mfkiwl/SDR_SOC_doc/sdr_svr/dps.tex

\section{Plošný spoj}
	% blokáč AD9850
	\begin{figure}[H]
    	\centering
    	
    	\caption{DPS LNA}    		
  	\end{figure}
  	
  	\begin{figure}[H]
    	\centering
    	
    	\caption{DPS DDS}    		
  	\end{figure}
  	
  	\begin{figure}[H]
    	\centering
    	
    	\caption{DPS řídící deska}    		
  	\end{figure}
  	
  	\begin{figure}[H]
    	\centering
    	
    	\caption{DPS mixer}    		
  	\end{figure}
  	
  	\begin{figure}[H]
    	\centering
    	
    	\caption{DPS zdroj}    		
  	\end{figure}
  	
  	% blokáč AD9850
	\begin{figure}[H]
    	\centering
    	
    	\caption{Osazovák vrstva mědi}    		
  	\end{figure}
  	
  	% blokáč AD9850
	\begin{figure}[H]
    	\centering
    	
    	\caption{Osazovák horní vrstva}    		
  	\end{figure}
