mfkiwl/SDR_SOC_doc/soc_sdr/prohlaseni.tex

\setcounter{page}{3}

\clearpage
\thispagestyle{empty}

Prohlašuji, že jsem praktickou zkoušku vypracoval samostatně a všechny prameny jsem uvedl v seznamu použité literatury.
\newline\newline
\begin{flushright}
	\begin{minipage}[H]{6cm}
		\begin{center}
			\dotfill\newline
			jméno a příjmení studenta
		\end{center}		
	\end{minipage}
\end{flushright}	

\vspace*{5cm}

Chtěl bych vyslovit poděkování panu Ing. Pavlu Lorenzovi, Ing. Jiřímu Burdovi a Ing. Petru Ďurišovi, za odborné konzultace a poskytnuté informace. Dále bych chtěl poděkovat Ing. Petru Ďurišovi za pomoc s výrobou desek plošných spojů. V neposlední řadě patří velký dík mému tátovi, který mi pomohl s ukotvením antény a výrobou krabičky.
\newline\newline
\begin{flushright}
	\begin{minipage}[H]{6cm}
		\begin{center}
			\dotfill\newline
			jméno a příjmení studenta
		\end{center}		
	\end{minipage}
\end{flushright}

\vspace*{5cm}
	
Prohlašuji, že nemám námitek proti půjčování nebo zveřejňování mé práce nebo její části se souhlasem školy.
\newline\newline
\begin{flushright}
	\begin{minipage}[H]{6cm}
		\begin{center}
			\dotfill\newline
			jméno a příjmení studenta
		\end{center}		
	\end{minipage}
\end{flushright}	

\clearpage
