mfkiwl/SDR_SOC_doc/soc_sdr/title_.tex

\begin{titlepage}
	\setcounter{page}{1}
	\begin{center}

	{\LARGE \bfseries Vyšší odborná škola a Střední průmyslová škola}\\[2mm] 

	{\LARGE \bfseries elektrotechnická Olomouc}\\[2mm]  

	{\LARGE \bfseries Božetěchova 3}\\[65mm]

	% Title 
	\fontsize{20pt}{30pt}{\bfseries PRAKTICKÁ ZKOUŠKA Z ODBORNÝCH PŘEDMĚTŮ\\}
	
	\fontsize{20pt}{30pt}{\bfseries SDR přijímač pro pásmo KV\\}

	\vfill

	% Bottom of the page
	{\LARGE \bfseries 2015 \hfill Jan Vykydal}

	\end{center}
\end{titlepage}
