mfkiwl/SDR_SOC_doc/sdr_svr/seznam.tex

\section{Seznam součástek}

	\begin{table}[H]
		\begin{center}
			\begin{tabular}[H]{!{\vrule width 1pt}c|c|c|c!{\vrule width 1pt}}
			    \specialrule{1pt}{0pt}{0pt} 
			    \textbf{Určovatel}	&	\textbf{Pouzdro}	&	\textbf{Množství}	&	\textbf{Určení}	\\\specialrule{1pt}{0pt}{0pt} 
				C1,C5,C6,C7,C10,C11,C12,C13,C14	&	SMD-0805	&	9	&	100n	\\\hline
				C2,C3,C4	&	11.2x6.3mm\_RM2.5	&	3	&	10u/50v	\\\hline
				C8,C9	&	SMD-0805	&	2	&	150p	\\\hline
				IC1	&	SO-20-L	&	1	&	74F245	\\\hline
				IC2	&	SOT-23-5	&	1	&	74VHC1G132DTT1G	\\\hline
				L1	&	R3-LARGE\_PADS	&	1	&	1u	\\\hline
				Q1	&	OldSowjetaera	&	1	&	KF630D	\\\hline
				R1,R2,R3,R4	&	R\_1206	&	4	&	10k	\\\hline
				R5	&	R\_1206	&	1	&	3k9	\\\hline
				R6,R7,R13	&	R\_1206	&	3	&	50R (2*100R)	\\\hline
				R8	&	R\_1206	&	1	&	560R	\\\hline
				R9	&	R\_1206	&	1	&	1k	\\\hline
				R10	&	R\_1206	&	1	&	4R7	\\\hline
				R11	&	R\_1206	&	1	&	12R	\\\hline
				R12	&	R\_1206	&	1	&	3k3	\\\hline
				TR1	&	Amidon-T44	&	1	&	TRF11	\\\hline
				U1	&	SOT-223	&	1	&	LD1117S33CTR	\\\hline
				P3	&	sma\_90\_r300.124.403	&	1	&	DDS\_OUT	\\\hline
				P1	&	vasch\_strip\_5x2\_90	&	1	&	MLW10	\\\hline
				P2	&	vasch\_strip\_3x2\_90	&	1	&	MLW6	\\\hline
				$-$	&	M3	&	4	&	M3	\\\hline
				IC3	&	SSOP-28 &	1	&	AD9850BRS	\\\hline
				XTAL1	&	SMD7x5	&	1	&	CFPS
				\\\specialrule{1pt}{0pt}{0pt} 

			\end{tabular}

			\caption{Tabulka použitých součástek pro desku DDS, ostatní zde nebyli uvedeny z důvodu nedostatku papíru}
			\label{tab:s1}      
		\end{center}
	\end{table}
