mfkiwl/SDR_SOC_doc/svr_sdr/navod.tex

\clearpage

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

% os b
\begin{figure}[H]
	\centering
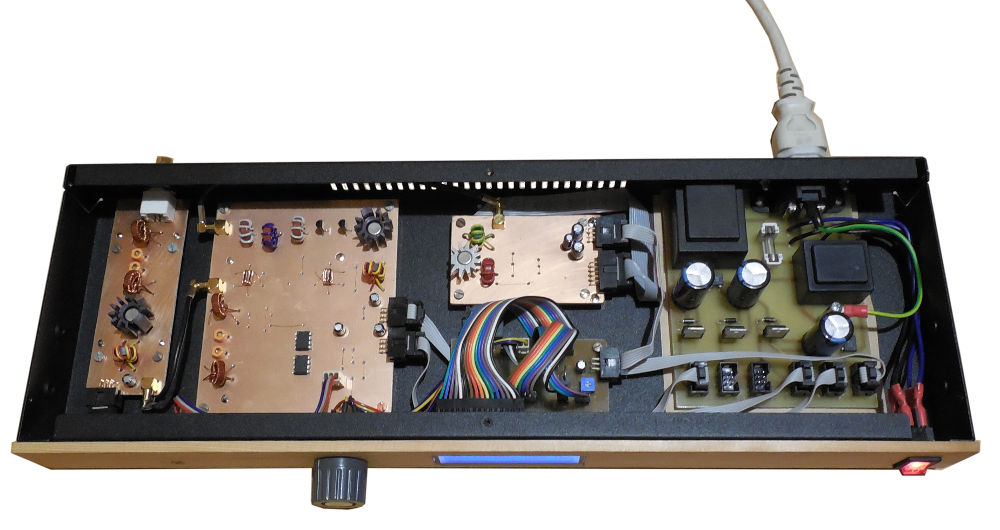
[picture p4: svr_sdr/img/bez_kritu_sm.png]
	
	\caption{Hotové zařízení bez horní části krabice}    		
\end{figure}

% os b
\begin{figure}[H]
	\centering
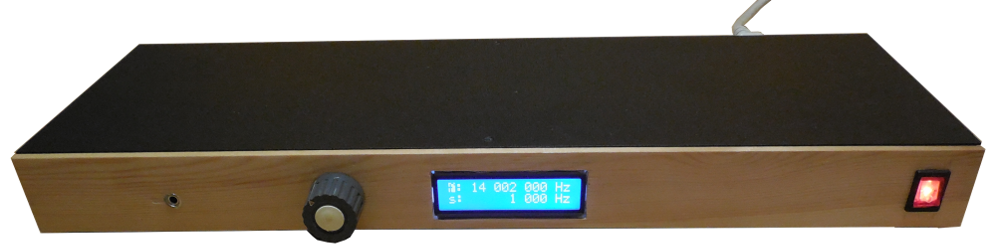
[picture p5: svr_sdr/img/s_kritem_sm.png]
	
	\caption{Hotové zařízení v kompletní krabici rackových rozměrů}    		
\end{figure}

\clearpage
