mfkiwl/SDR_SOC_doc/pres_SDR/bs_sdr_prez.png

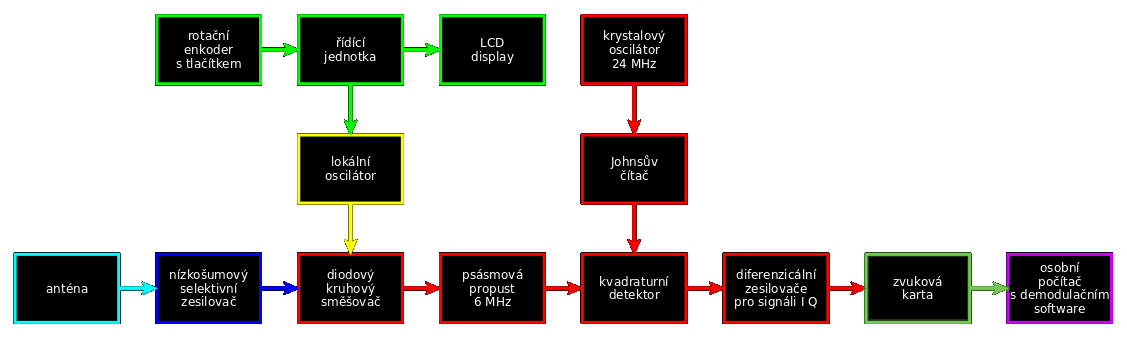
pres_SDR/bs_sdr_prez.png
