mfkiwl/SDR_SOC_doc/pres_SDR/DSCN0772.JPG

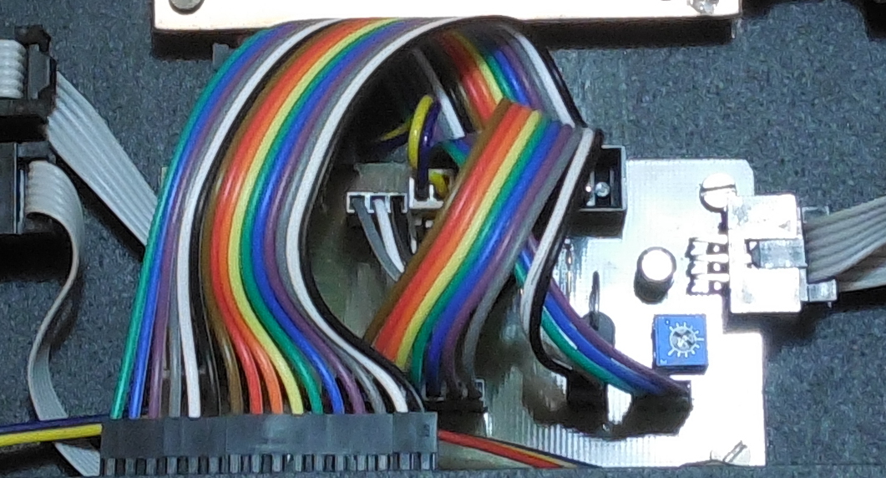
pres_SDR/DSCN0772.JPG
