mfkiwl/SDR_SOC_doc/pres_SDR/sdr_prijem_1.png

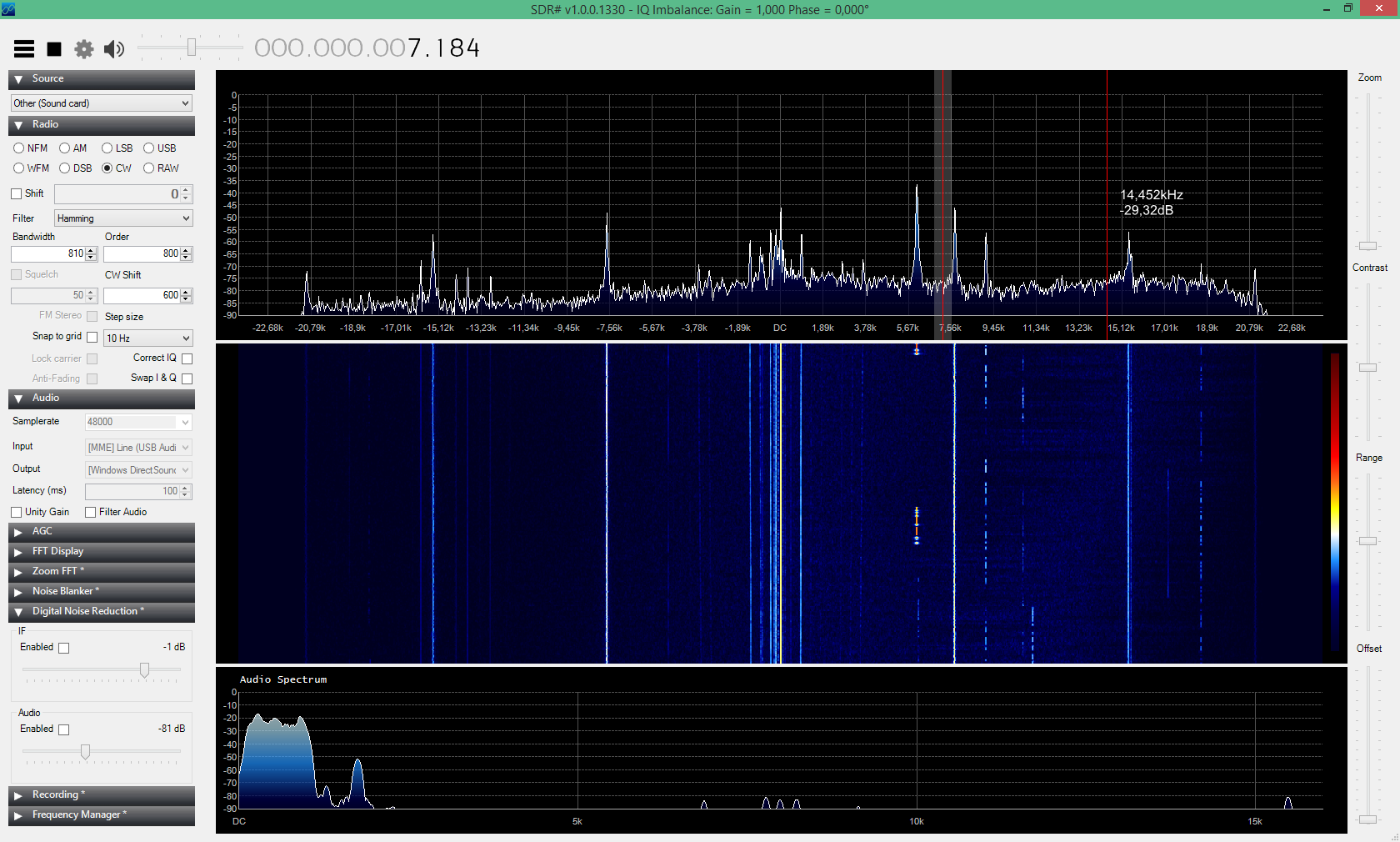
pres_SDR/sdr_prijem_1.png
