mfkiwl/SDR_SOC_doc/sdr/control_board/out/control_board-brd.png

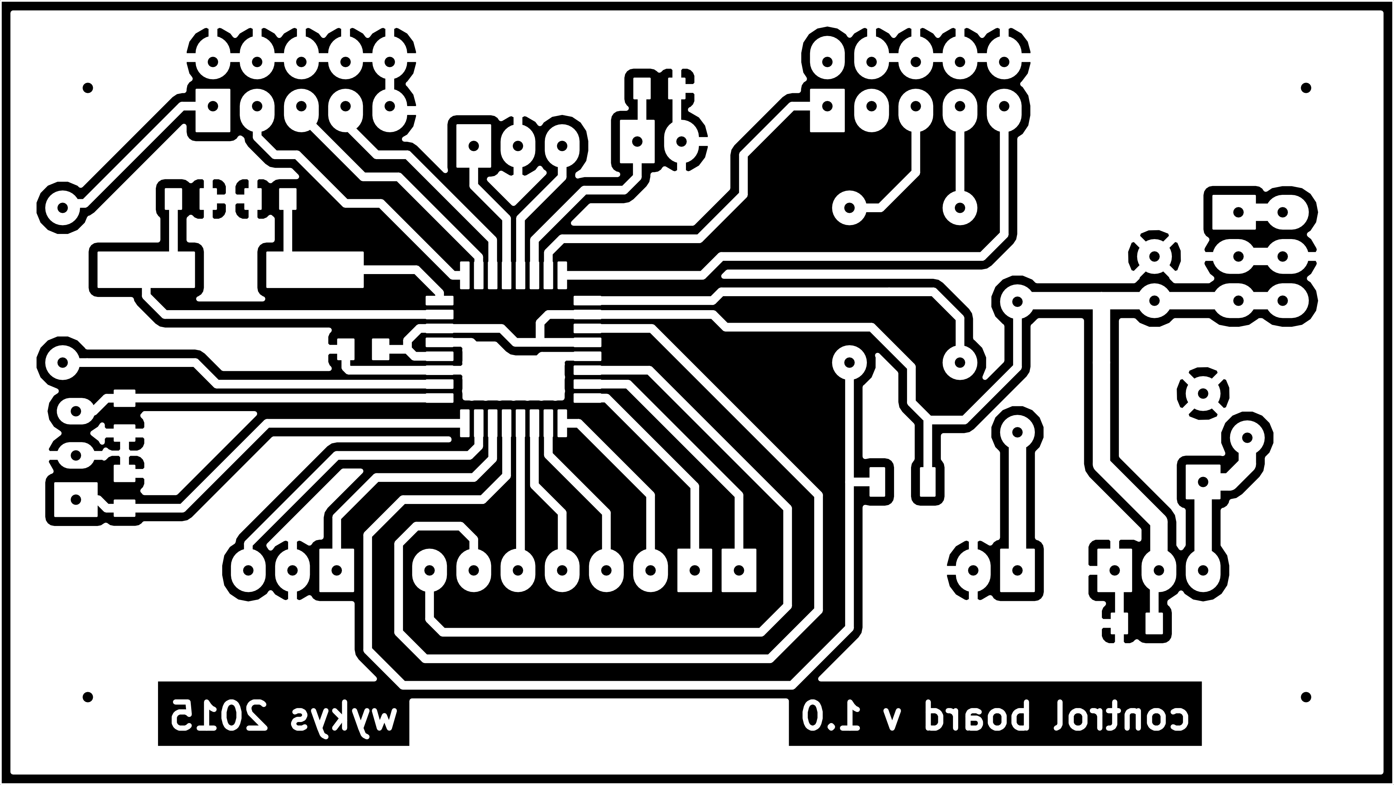
sdr/control_board/out/control_board-brd.png
