mfkiwl/SDR_SOC_doc/sdr/dds/design_v2/out/DDS-brd.png

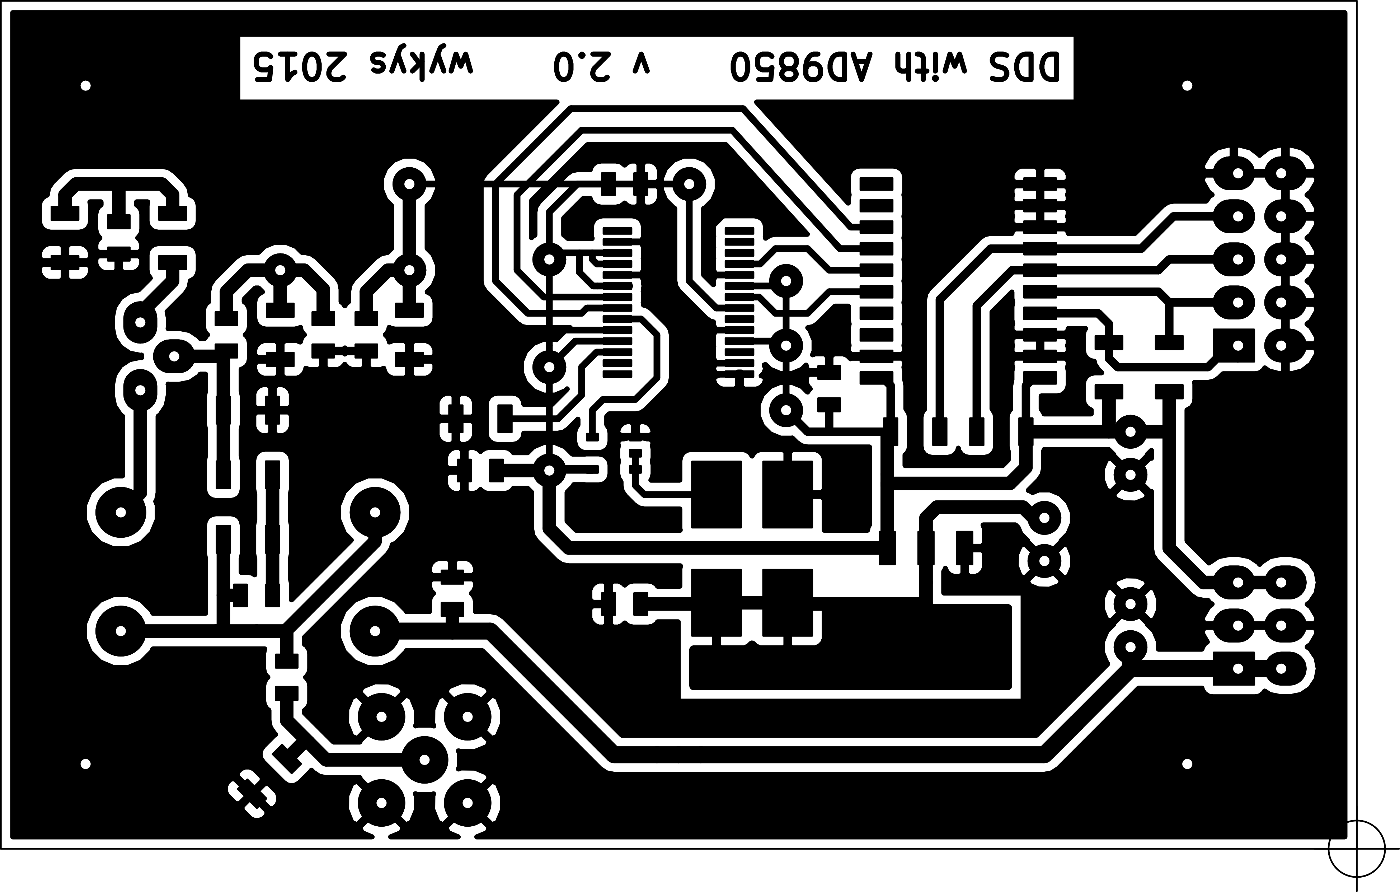
sdr/dds/design_v2/out/DDS-brd.png
