mfkiwl/SDR_SOC_doc/sdr/dds/sim/CLC.png

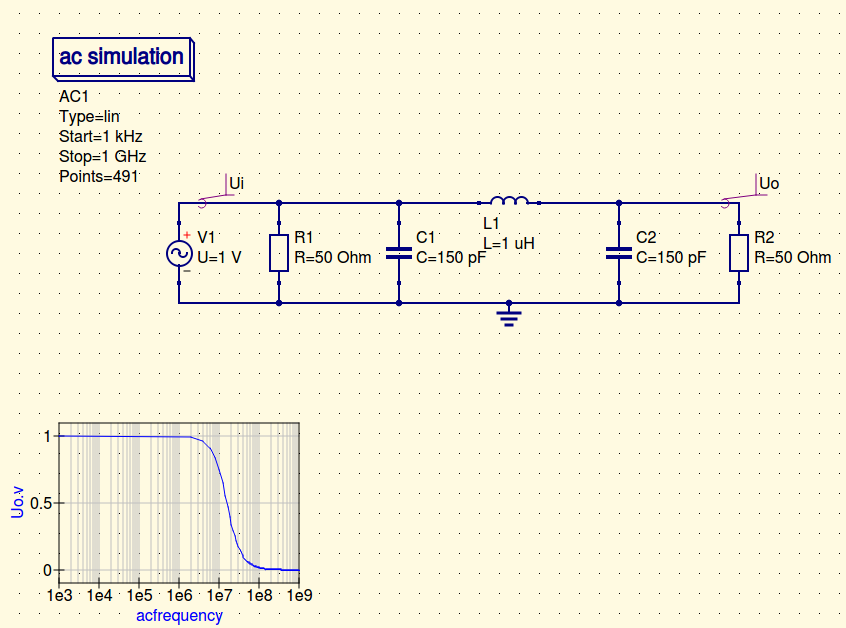
sdr/dds/sim/CLC.png
