mfkiwl/SDR_SOC_doc/sdr/LNA/design_v1/out/LNA-brd.png

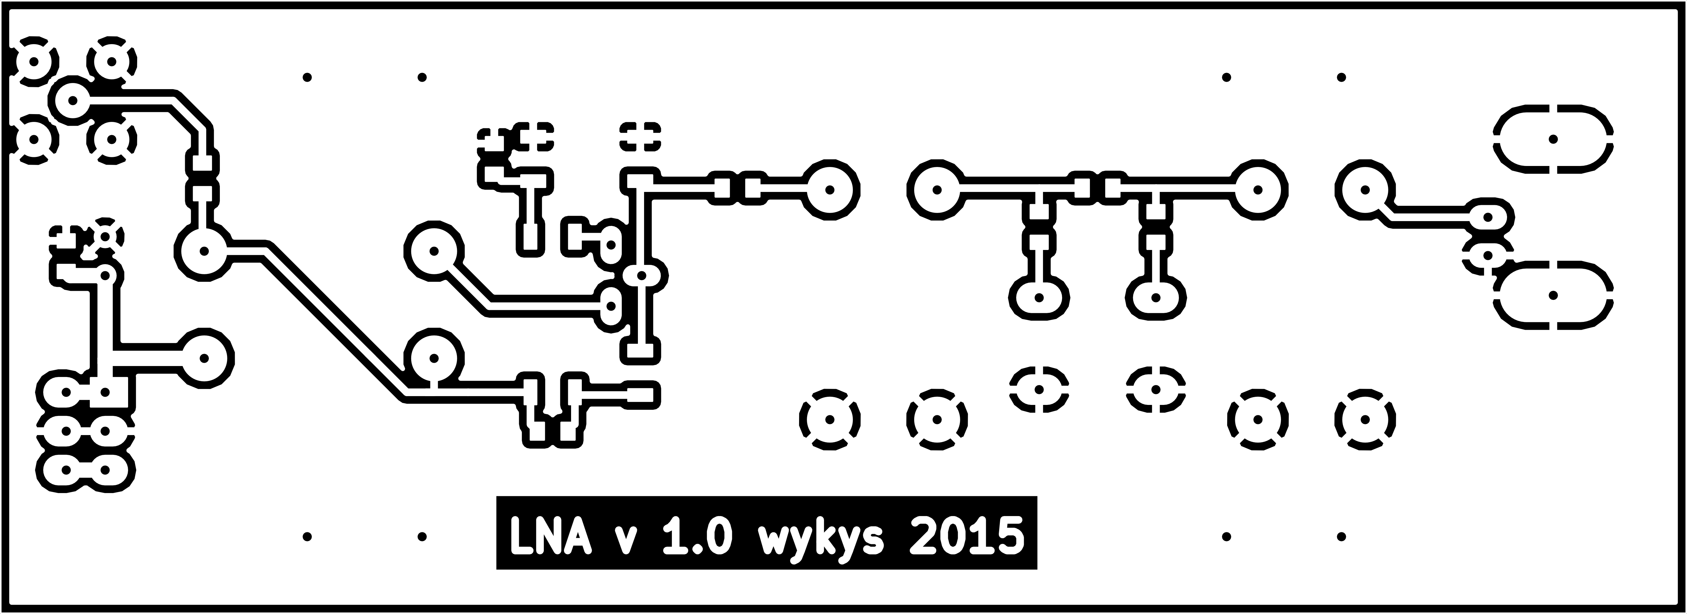
sdr/LNA/design_v1/out/LNA-brd.png
