mfkiwl/SDR_SOC_doc/sdr/MIXER/out/mixer-brd.png

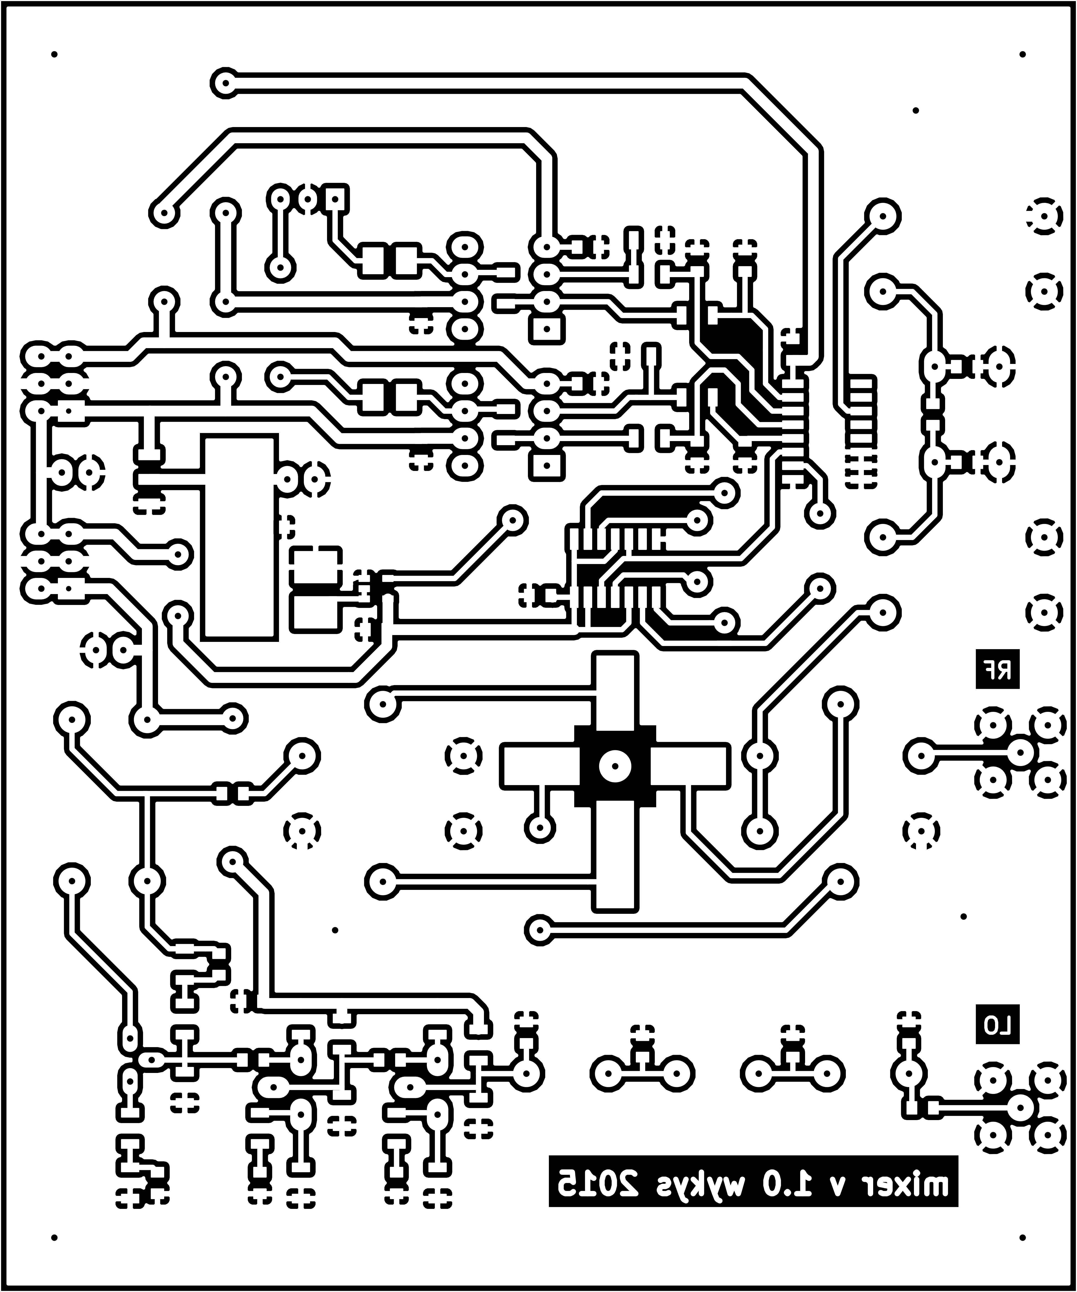
sdr/MIXER/out/mixer-brd.png
