mfkiwl/SDR_SOC_doc/sdr/zdroj/zdroj_v1/out/zdroj-brd.png

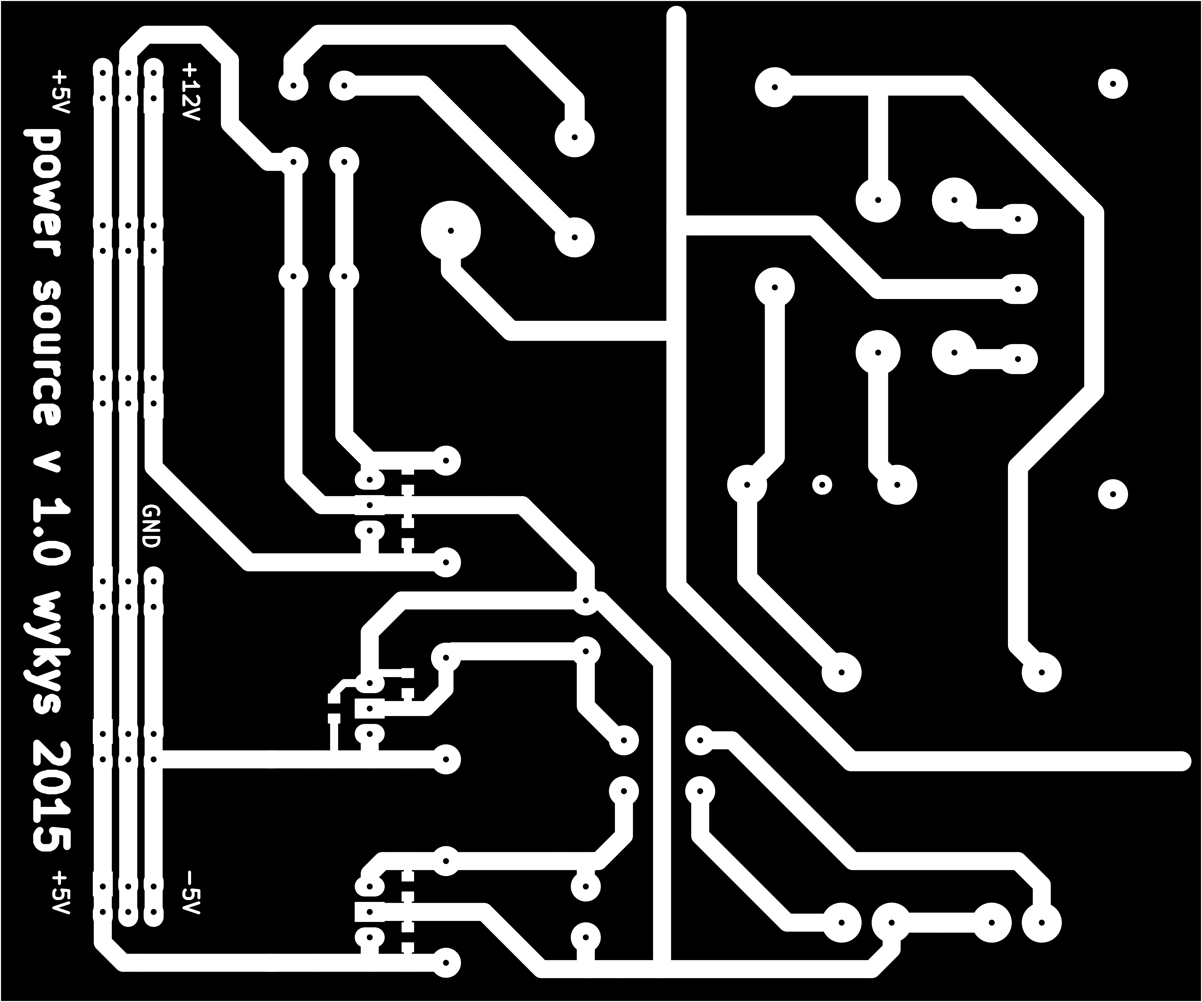
sdr/zdroj/zdroj_v1/out/zdroj-brd.png
