mfkiwl/SDR_SOC_doc/soc_sdr/img/LNA/sel.png

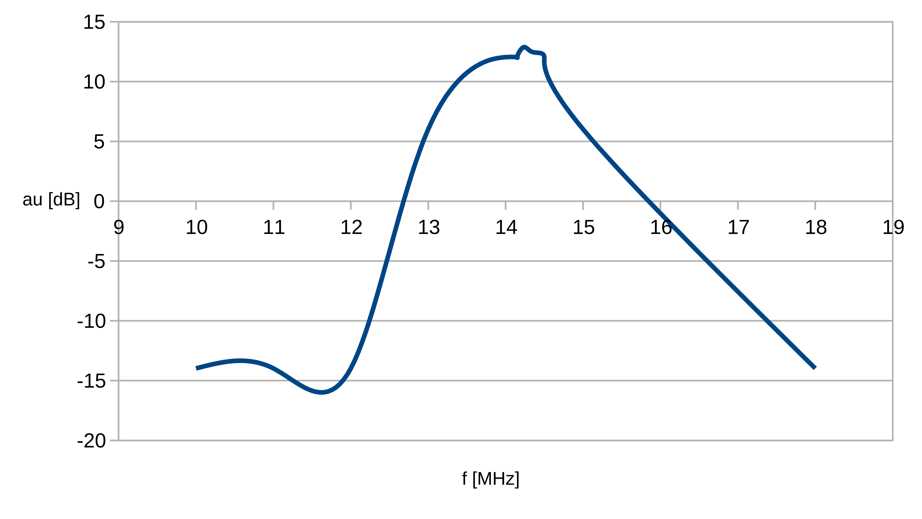
soc_sdr/img/LNA/sel.png
