mfkiwl/SDR_SOC_doc/svr_sdr/img/bs_sdr_prez.png

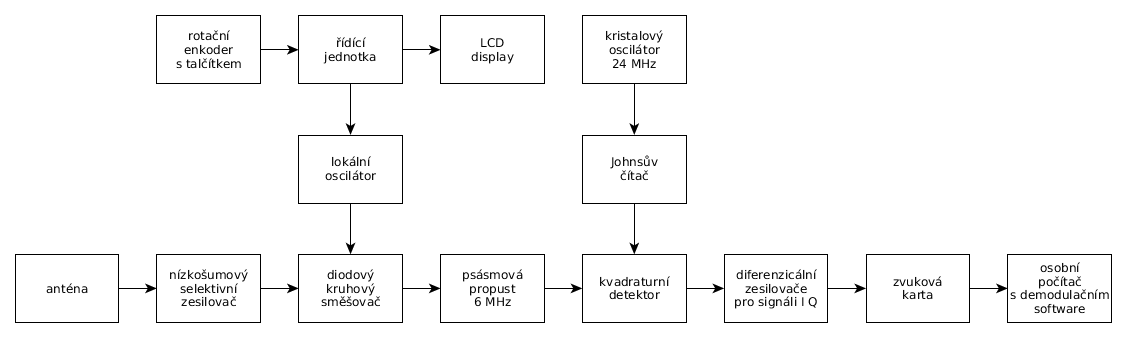
svr_sdr/img/bs_sdr_prez.png
