mfkiwl/SDR_SOC_doc/sdr_svr/SDR.pdf

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

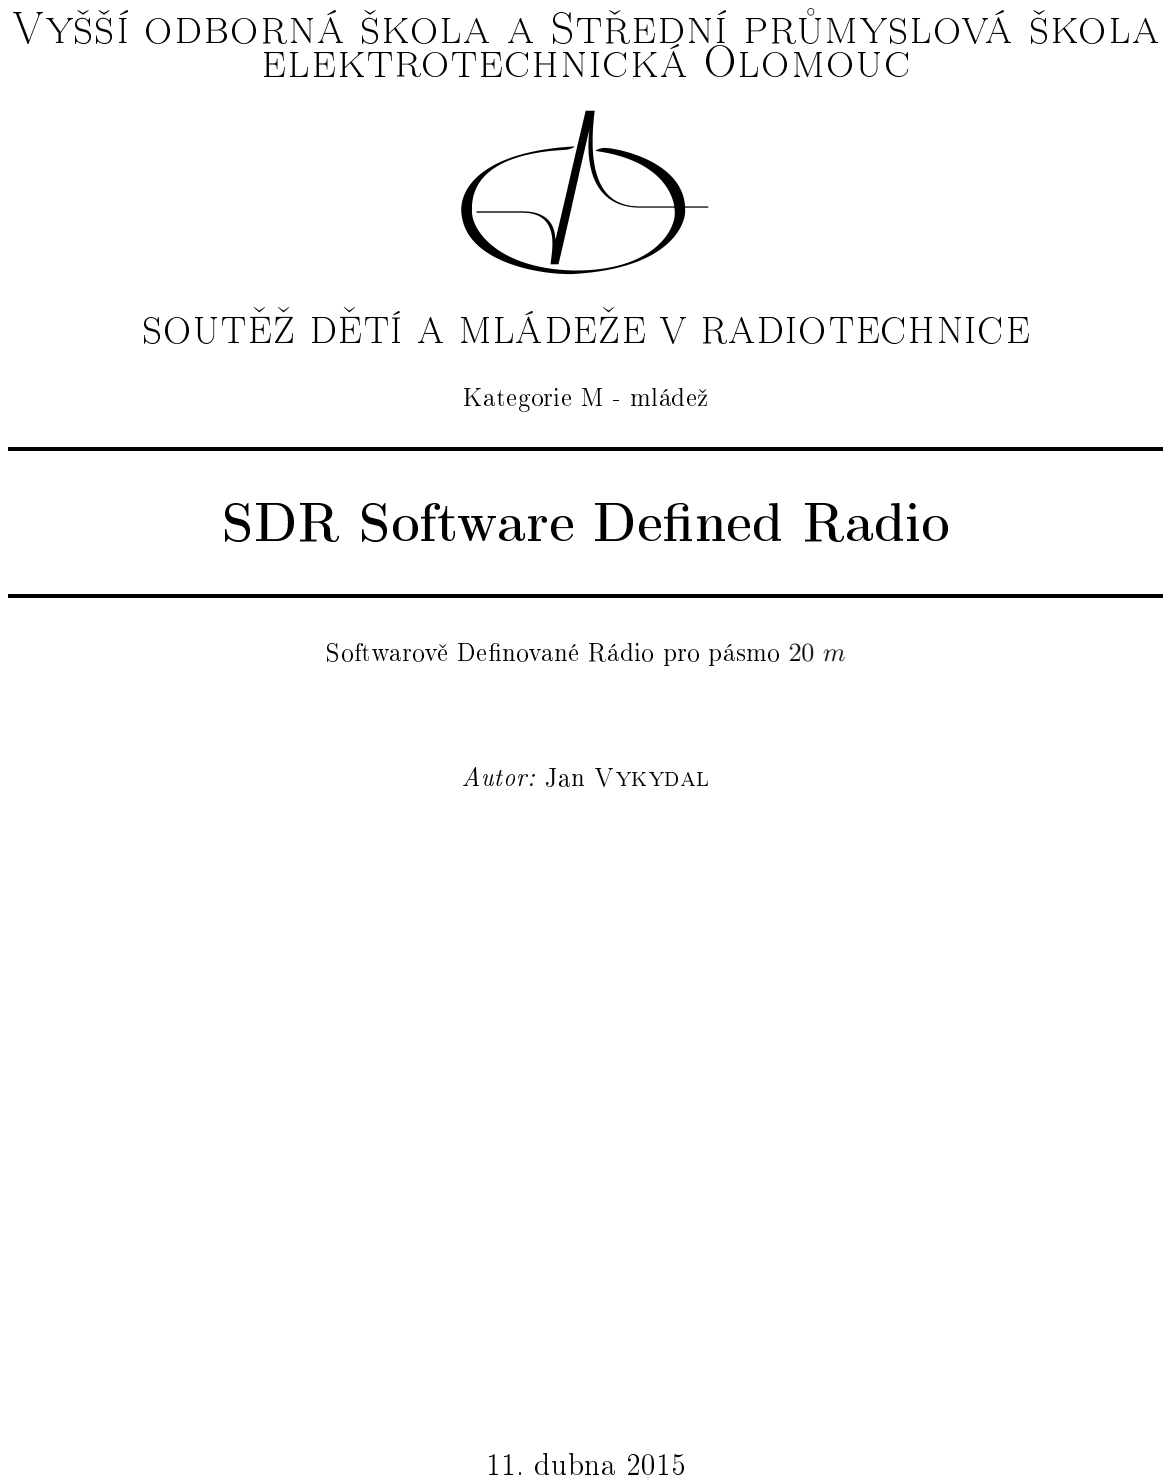
[picture p17: page 1]

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

100n | C10 | GND

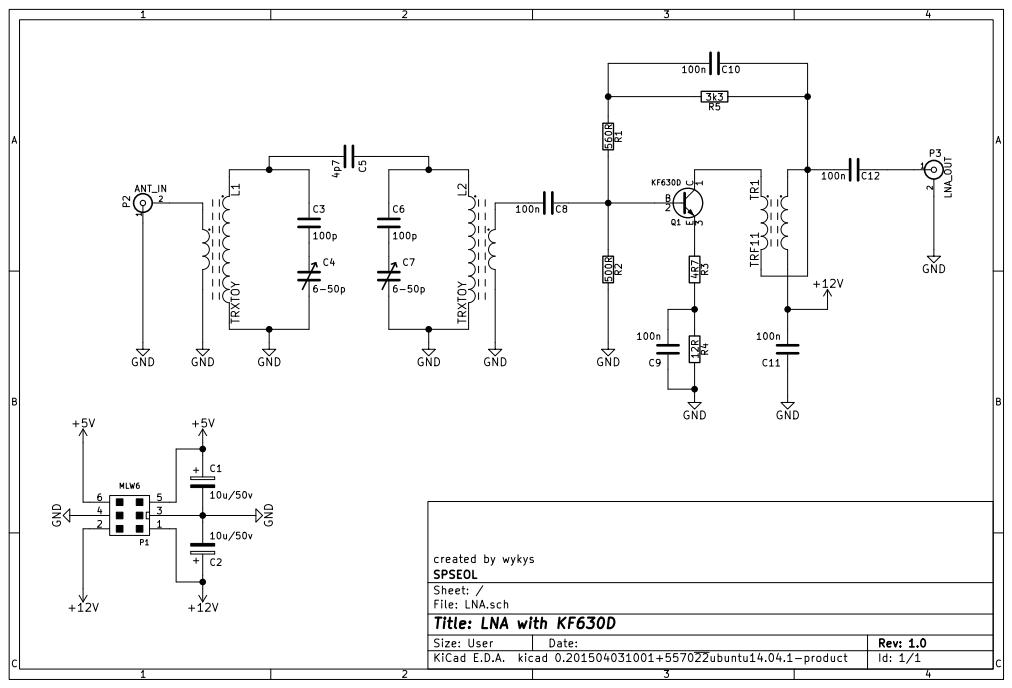
[picture p18: page 4]

created by wykys
File: LNA.sch Sheet: / SPSEOL

Id: 1/1 Title: LNA with KF630D

SDR Software Dened Radio | Jan Vykydal 4A
3 | Schéma zapojení DDS

Schéma je rozd¥leno do t°í blok· v levé horní £ásti se nachází stabilizátor 3V3 pro k°emíkový oscilátor a Kondenzátory pro vyrovnání nárazových odb¥r·. V levé dolní £ásti je digitální £ást DDS, popisováno z leva do prava: konektor pro kongurování DDSky, odd¥lovací buer 74F245, jehoº výstupy jdou do DDSky. Naho°e je jiº zmín¥ný k°emíkový oscilátor a tvarova£ impuls·. V pravé horní £ásti se nachází VF £ást tvo°ená dolní propustí ur£ené k potla£ení vy²²ích harmonických z DAC. a Výkonový zesilova£ tvo°ený tranzistorem KF630D s Ic nastaveným na 20 mA. Ke kolektoru tranzistoru je p°ipojeno trafo, které je vinuto bilárn¥ a slouºí k transformaci impedance na cca 50 Ω.

4/18

# 10u/50v C3

# 10u/50v +5V

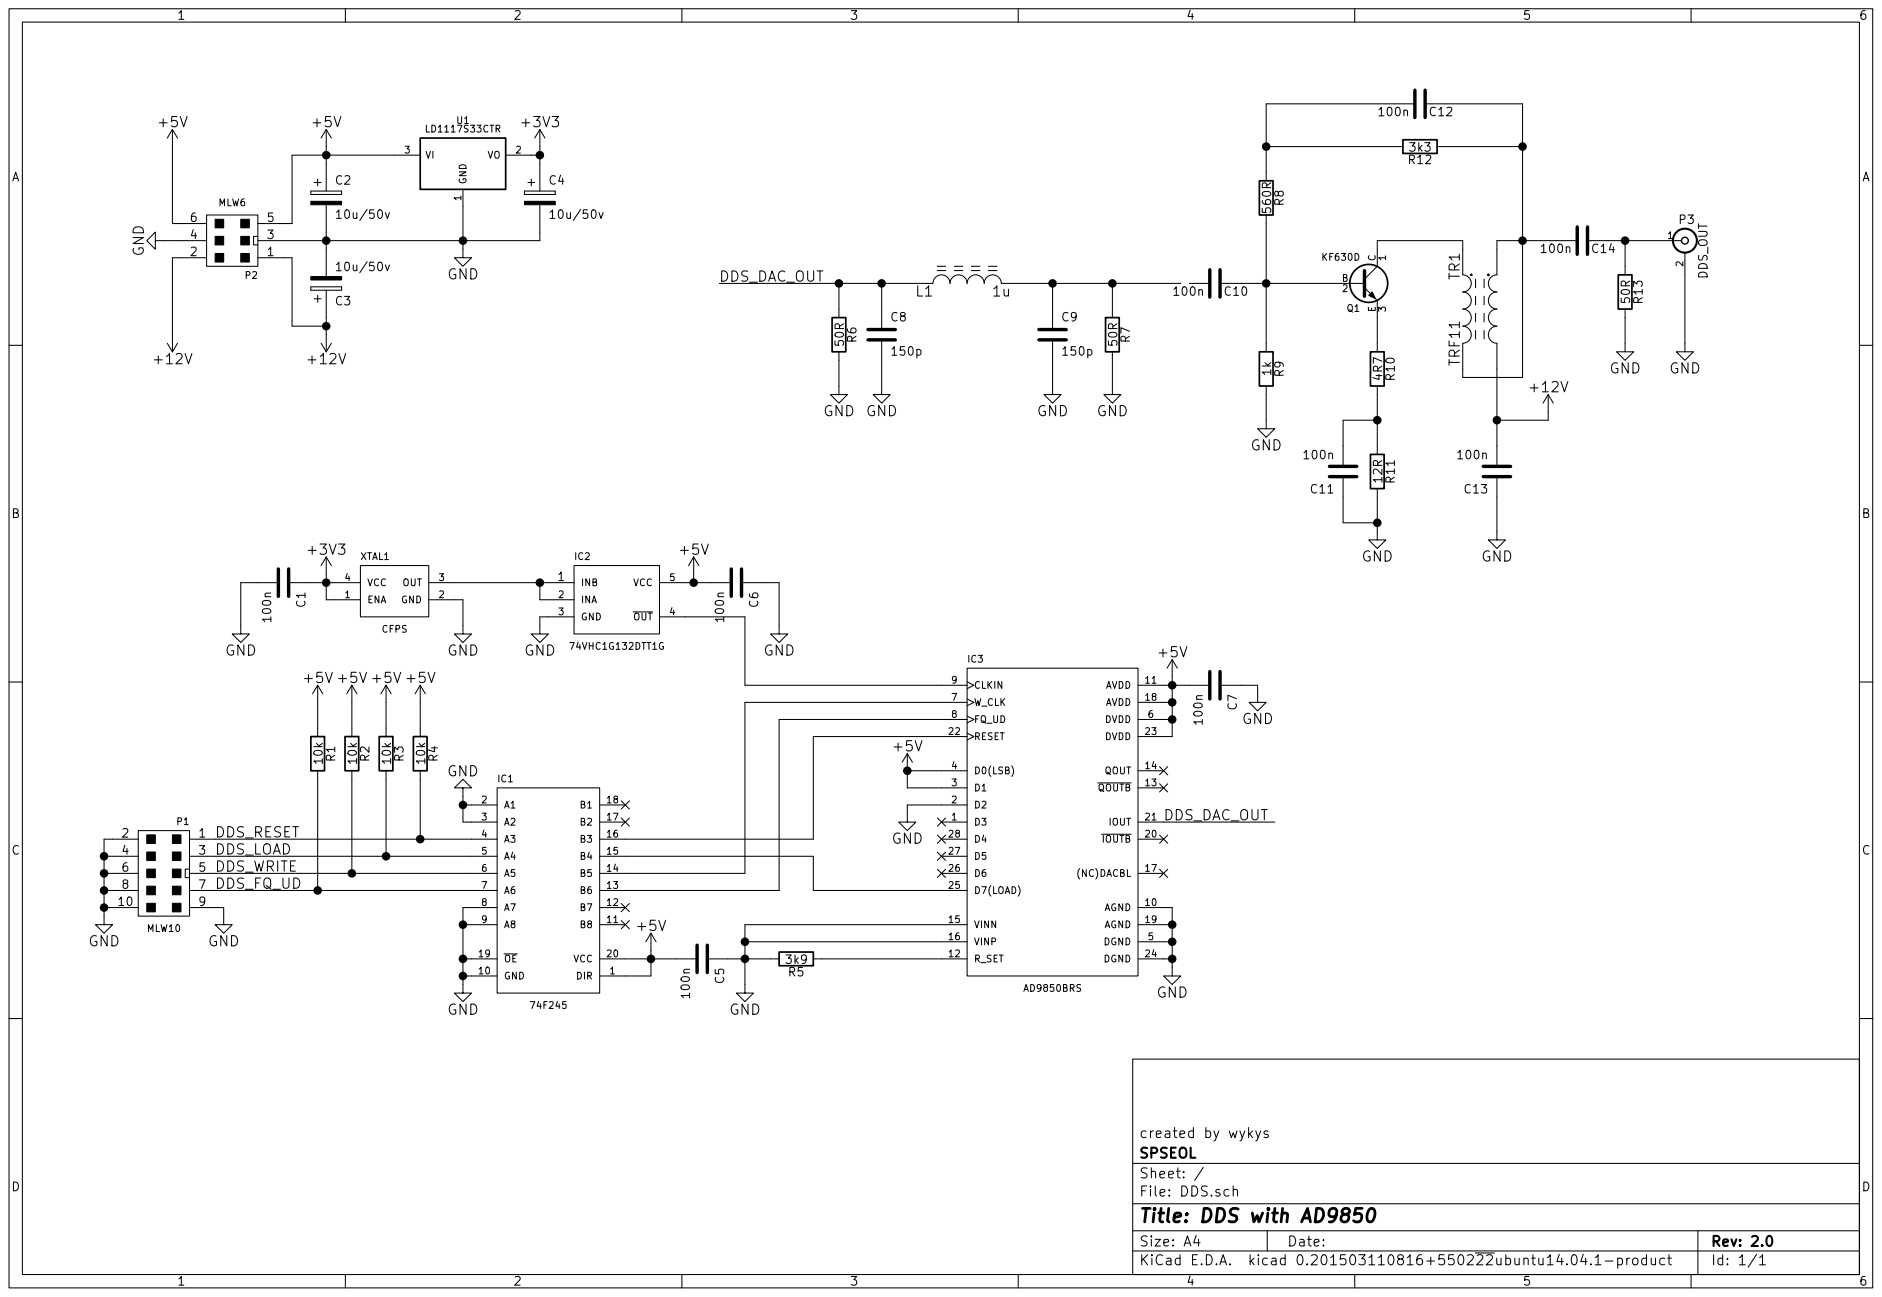
[picture p19: page 6]

+5V ¹⁰k R¹ 10k R² 10k R³ 10k R⁴ +5V +5V +5V +5V

created by wykys
File: DDS.sch Sheet: / SPSEOL

Id: 1/1 Title: DDS with AD9850

SDR Software Dened Radio | Jan Vykydal 4A
4 | Schéma zapojení °ídící deska

ídící deska slouºí k °ízení výstupní frekvence lokálního oscilátoru zaloºeného na DDS. A nastavování po°adované výstuúní frekvence slouºí enkoder. Dále je na desce p°ipraven konektor pro USART, aby bylo moºné °ídit i °ídíví desku s nad°azeného po£íta£e. Dále desky zobraduje p°íjmanou stanici na znakový LCD disply. Zobrazovaná frekvence je absolutní hodnota zordílu frekvence lokálního oscilátoru a mezifrekvence.

6/18

# 10k +5V C6

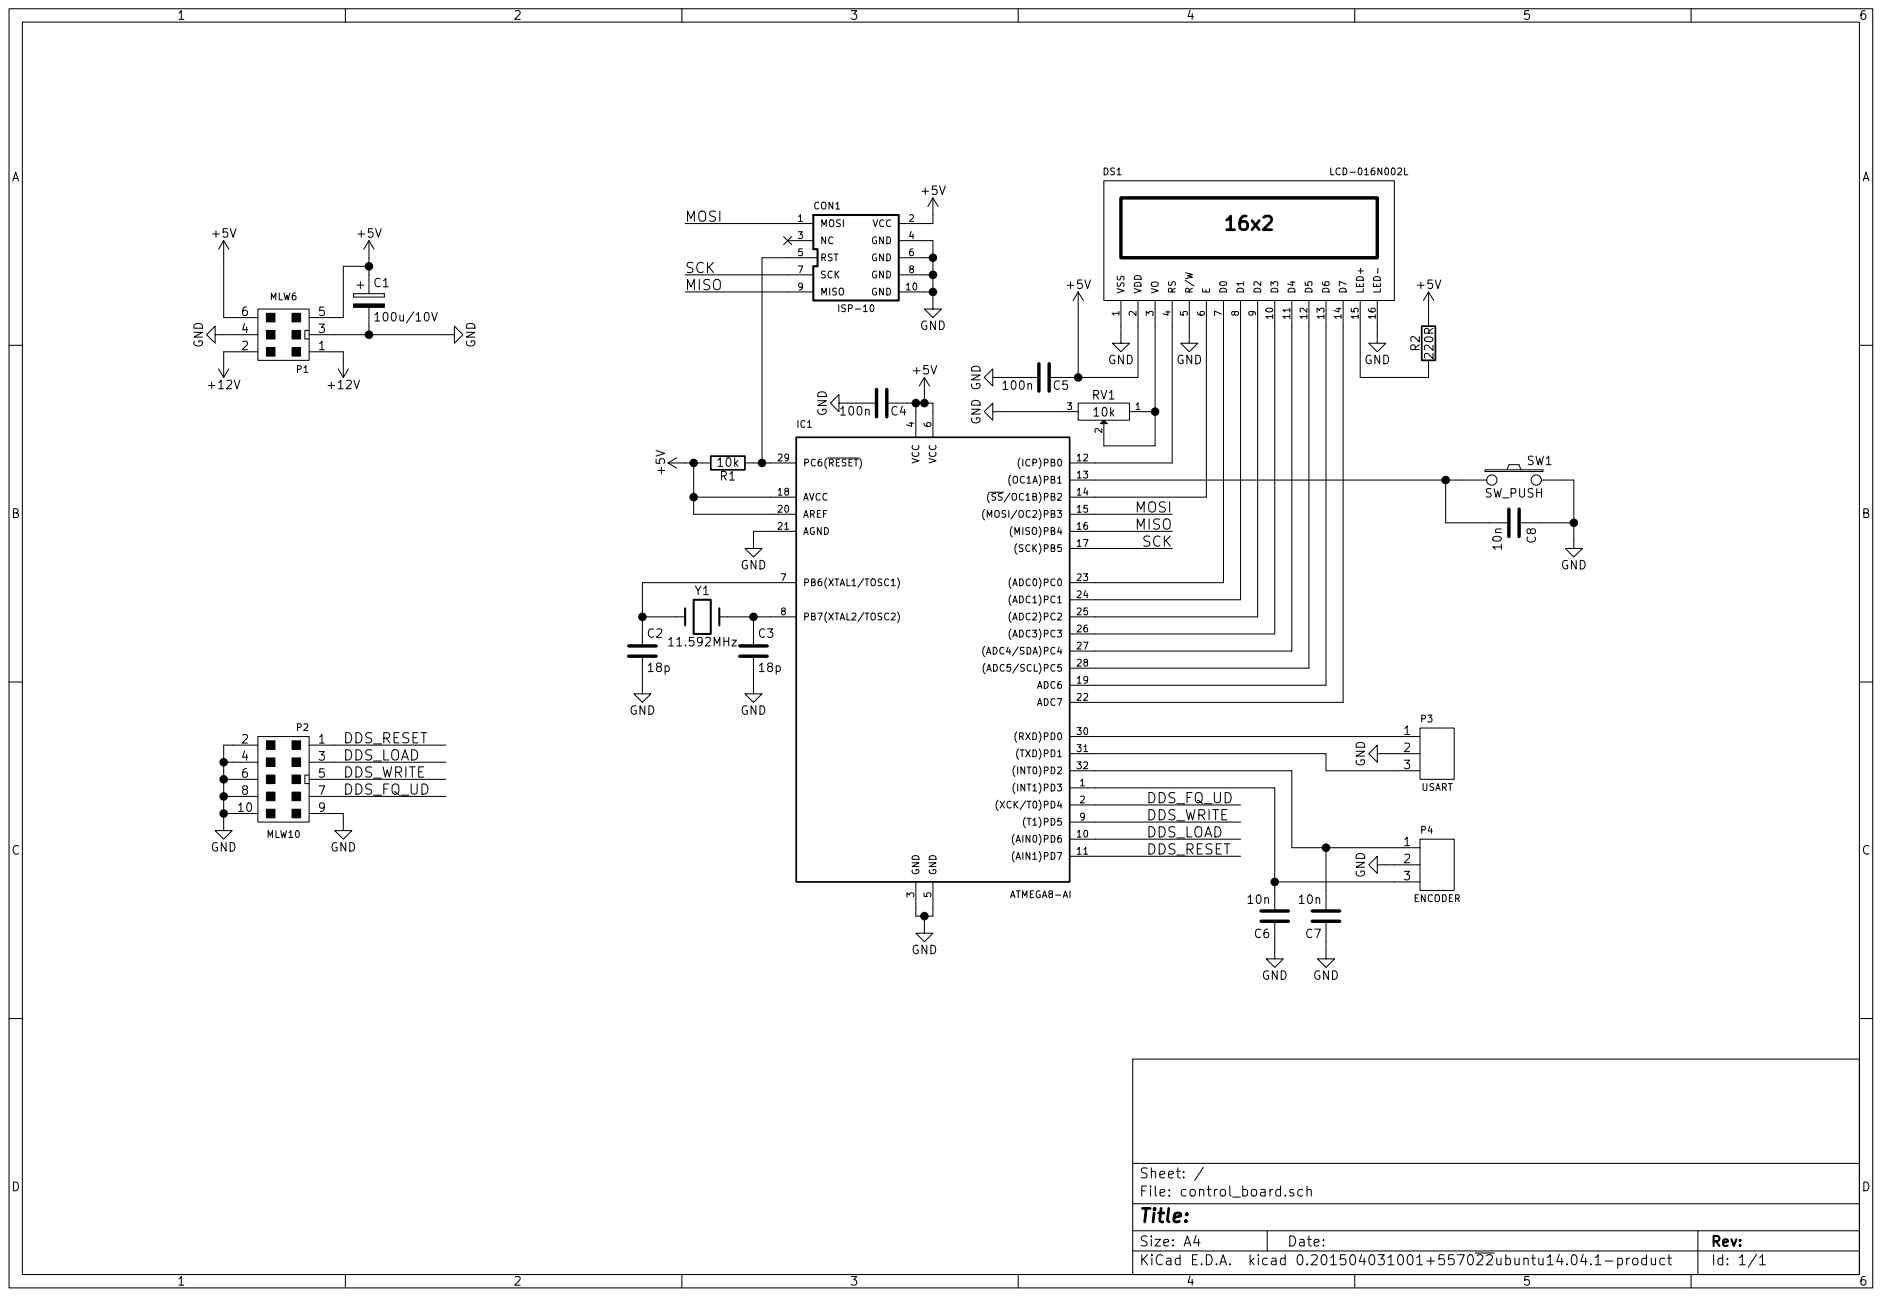
[picture p20: page 8]

SDR Software Dened Radio | Jan Vykydal 4A
5 | Schéma zapojení mixer

Tento obvod slouºí k p°evedení signálu do základního pásma. K tomu pouºívá dvou sm¥²ovac·. Klasic-kého kruhového diodového sm¥£ova°e pro p°evod na mezifrekvenci 6 MHz a tzv. Tayloe kvadraturní detektor, který generuje signály I a Q navzájem posunuté o π
2

8/18

100n C¹⁵ 100n +12V | +12V GND | GND | GND
3k3 4R⁷ R¹³ 12R R¹⁴ | C24

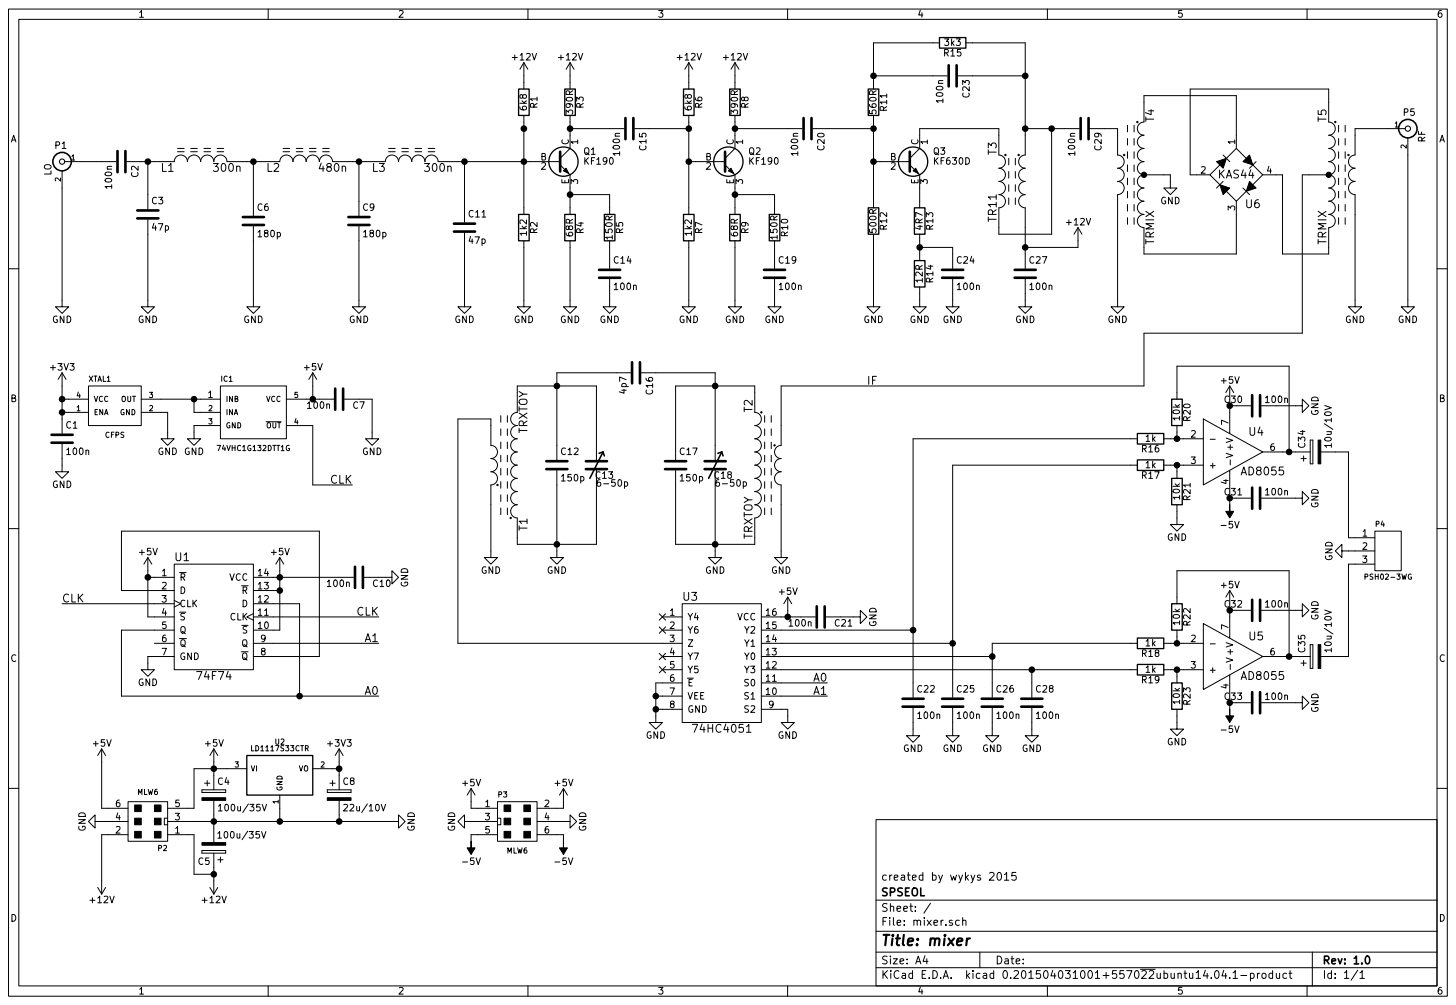
[picture p21: page 10]

created by wykys 2015
Id: 1/1 Title: mixer File: mixer.sch Sheet: / SPSEOL

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

# T1 TRANSFO2 1

# 100n +5V -5V +12V

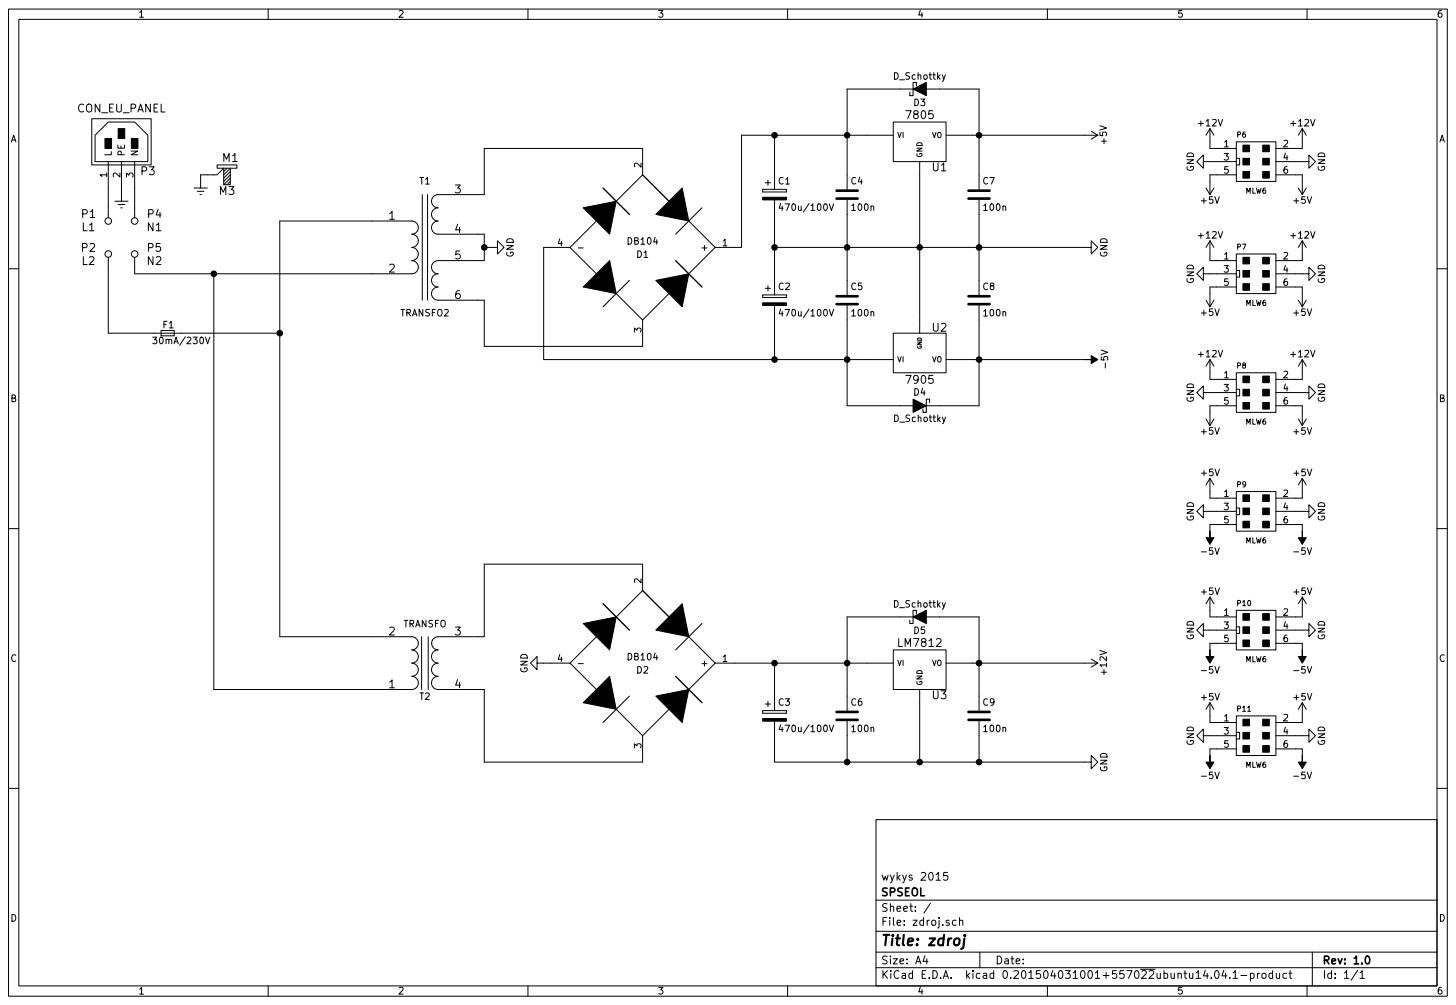
[picture p22: page 12]

File: zdroj.sch Sheet: / SPSEOL wykys 2015

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

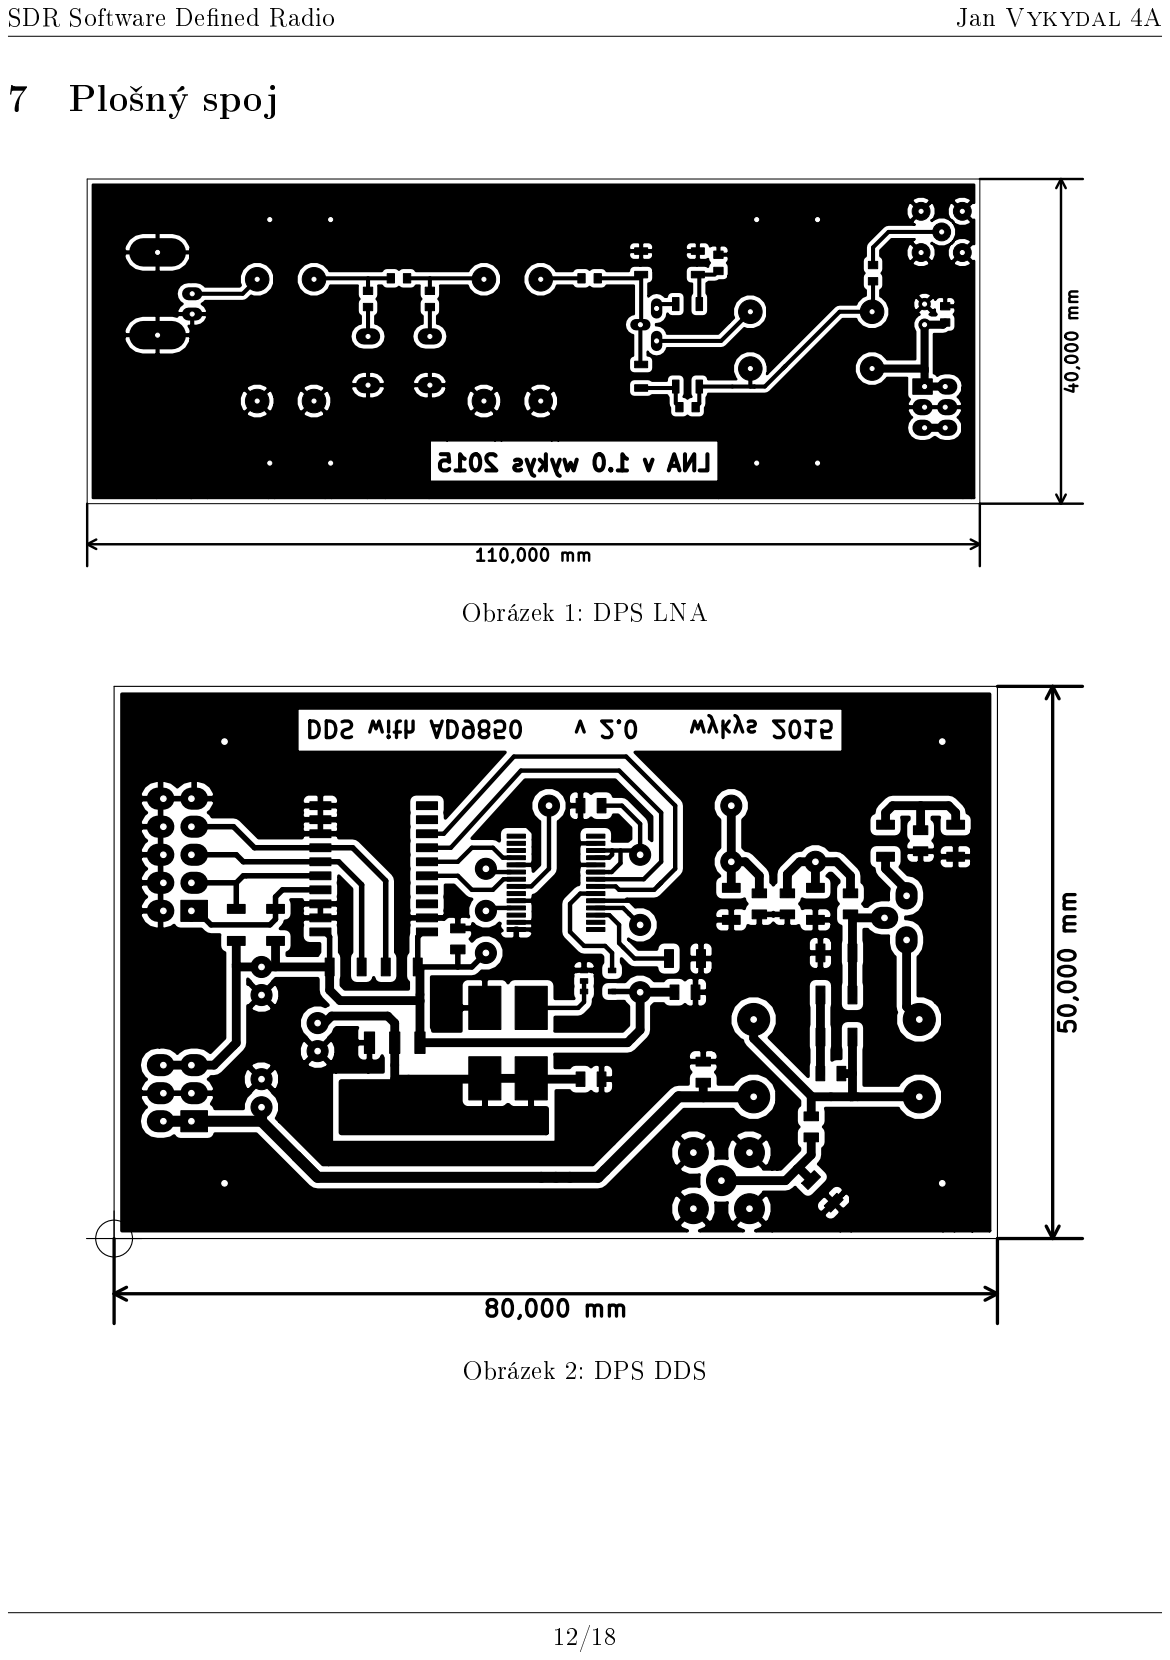
[picture p23: page 13]

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

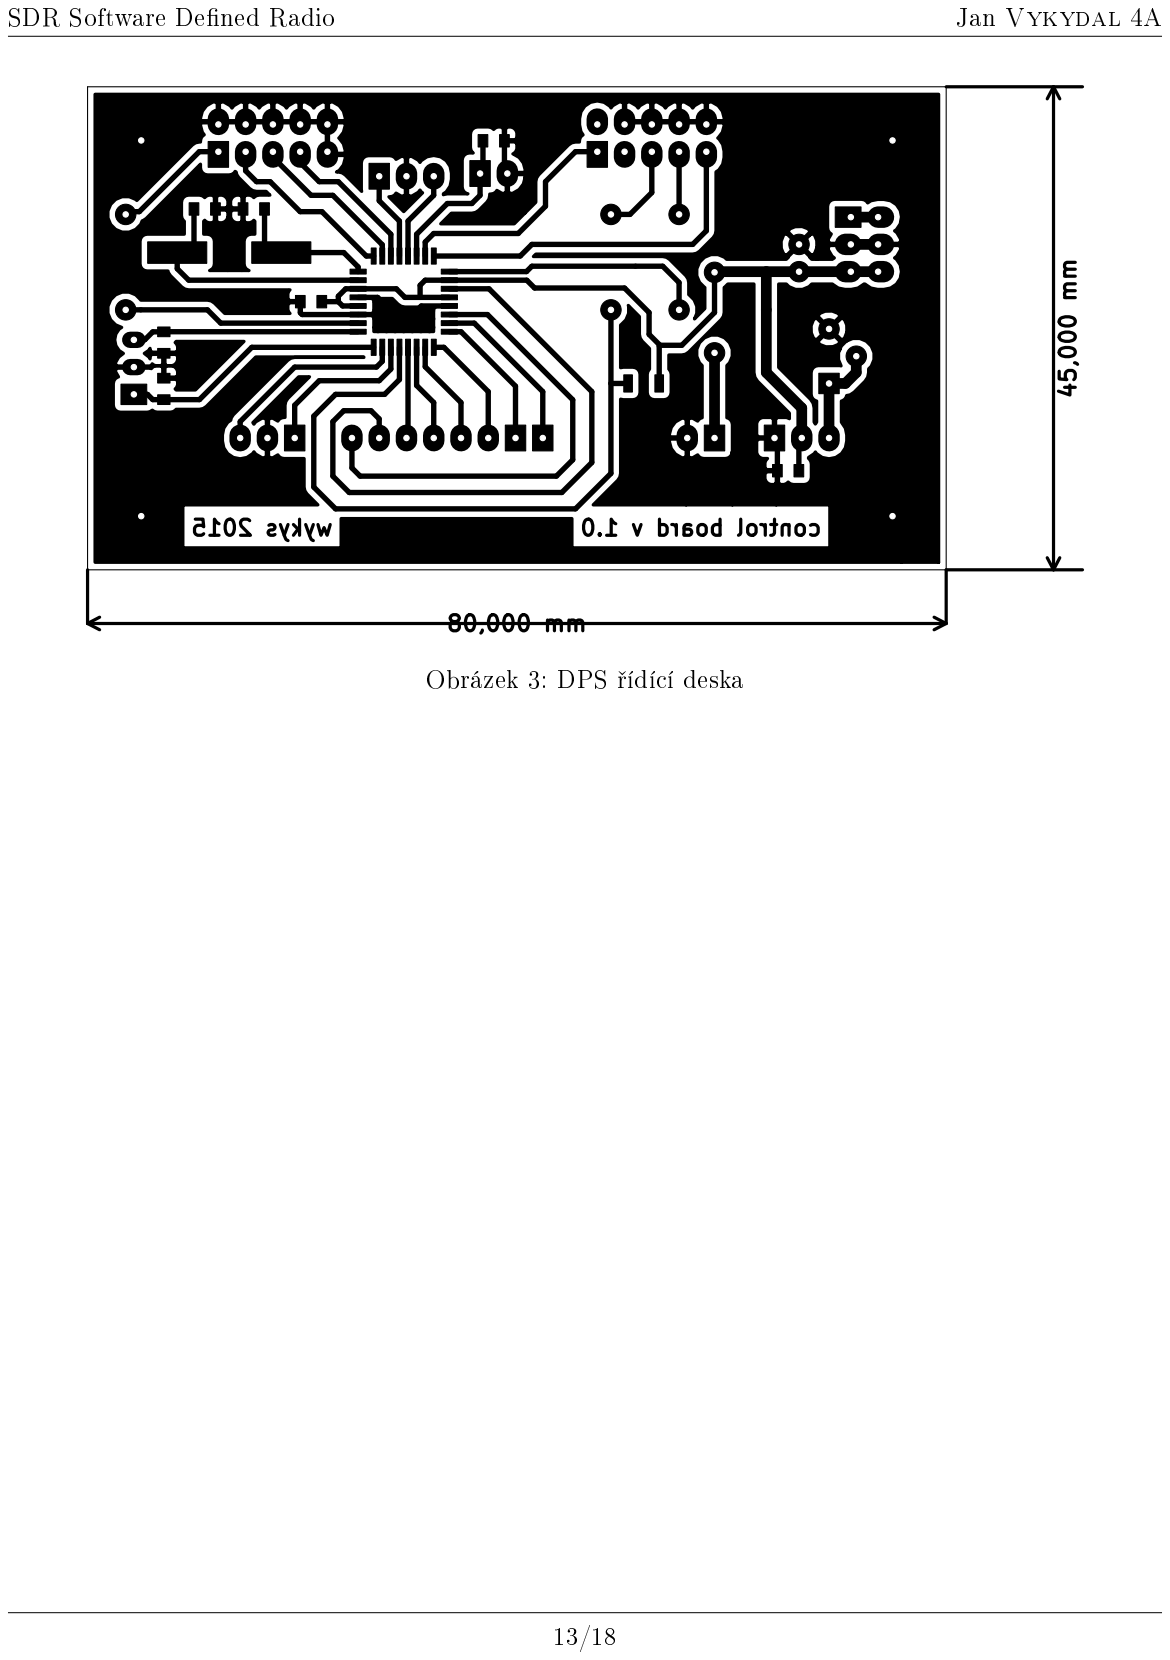
[picture p24: page 14]

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

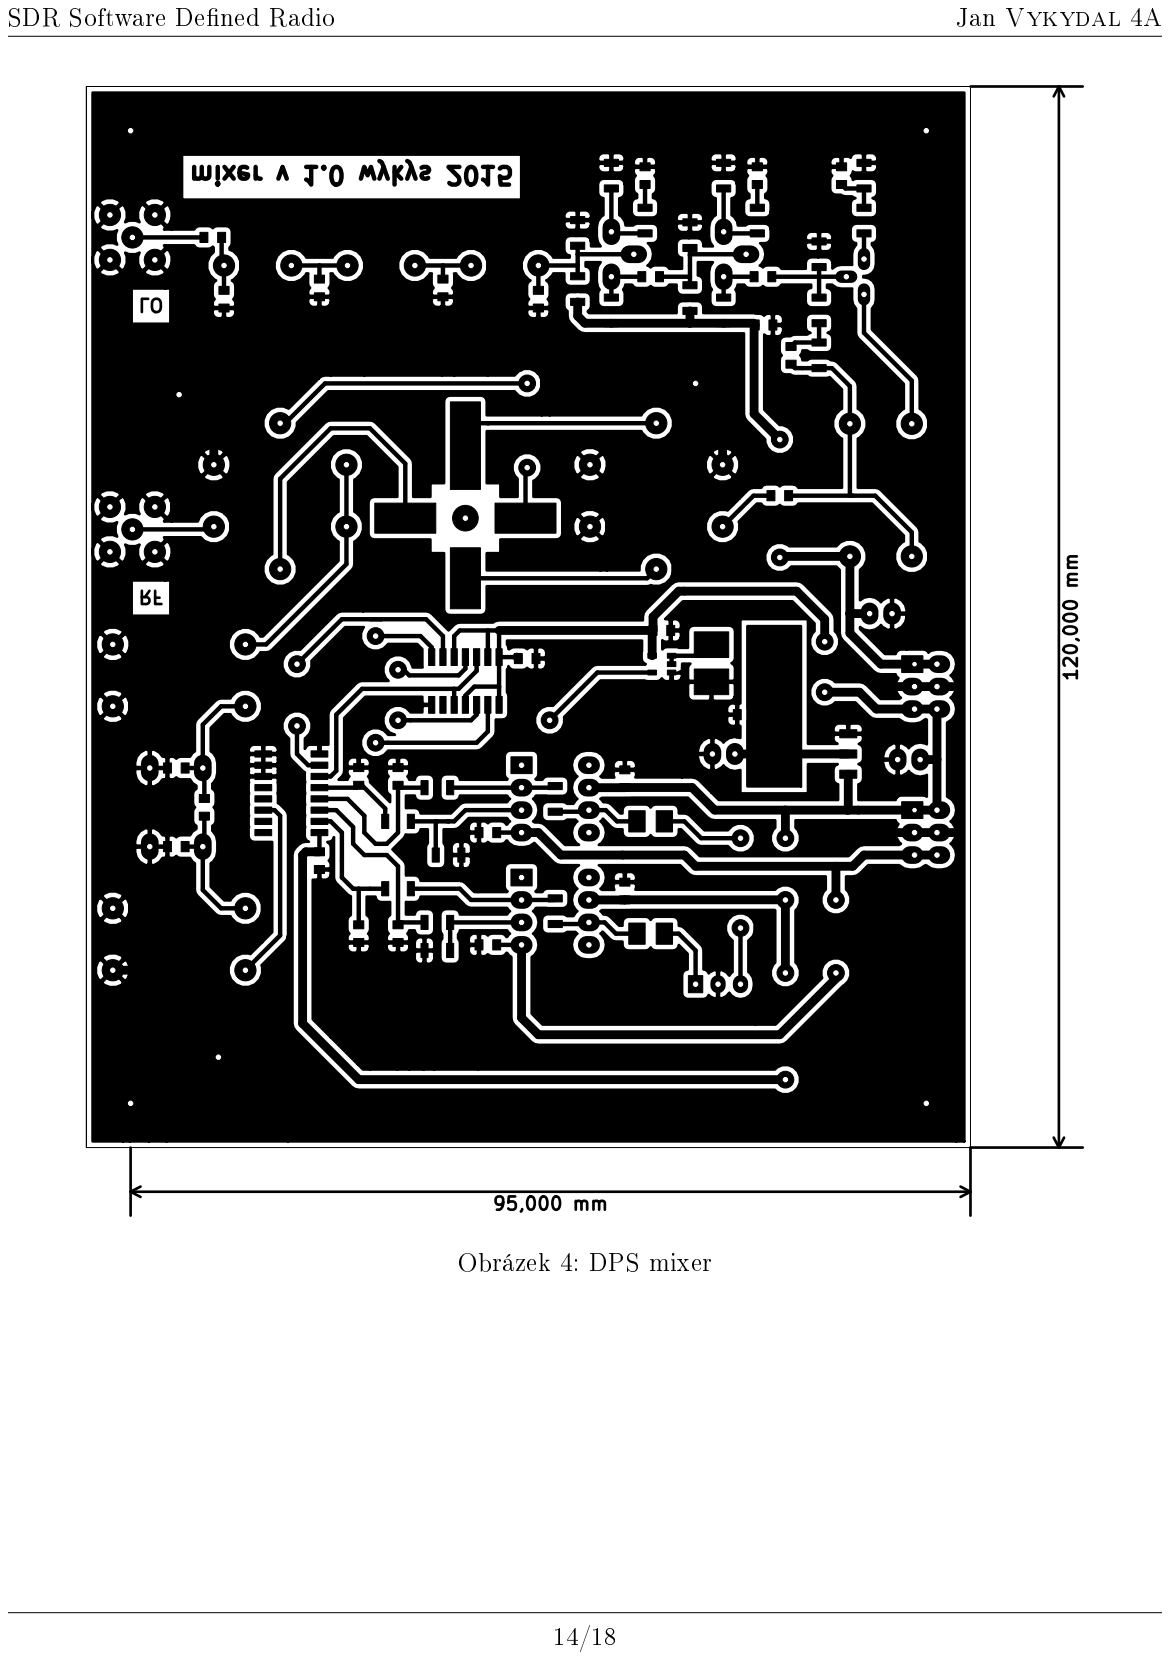
[picture p25: page 15]

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

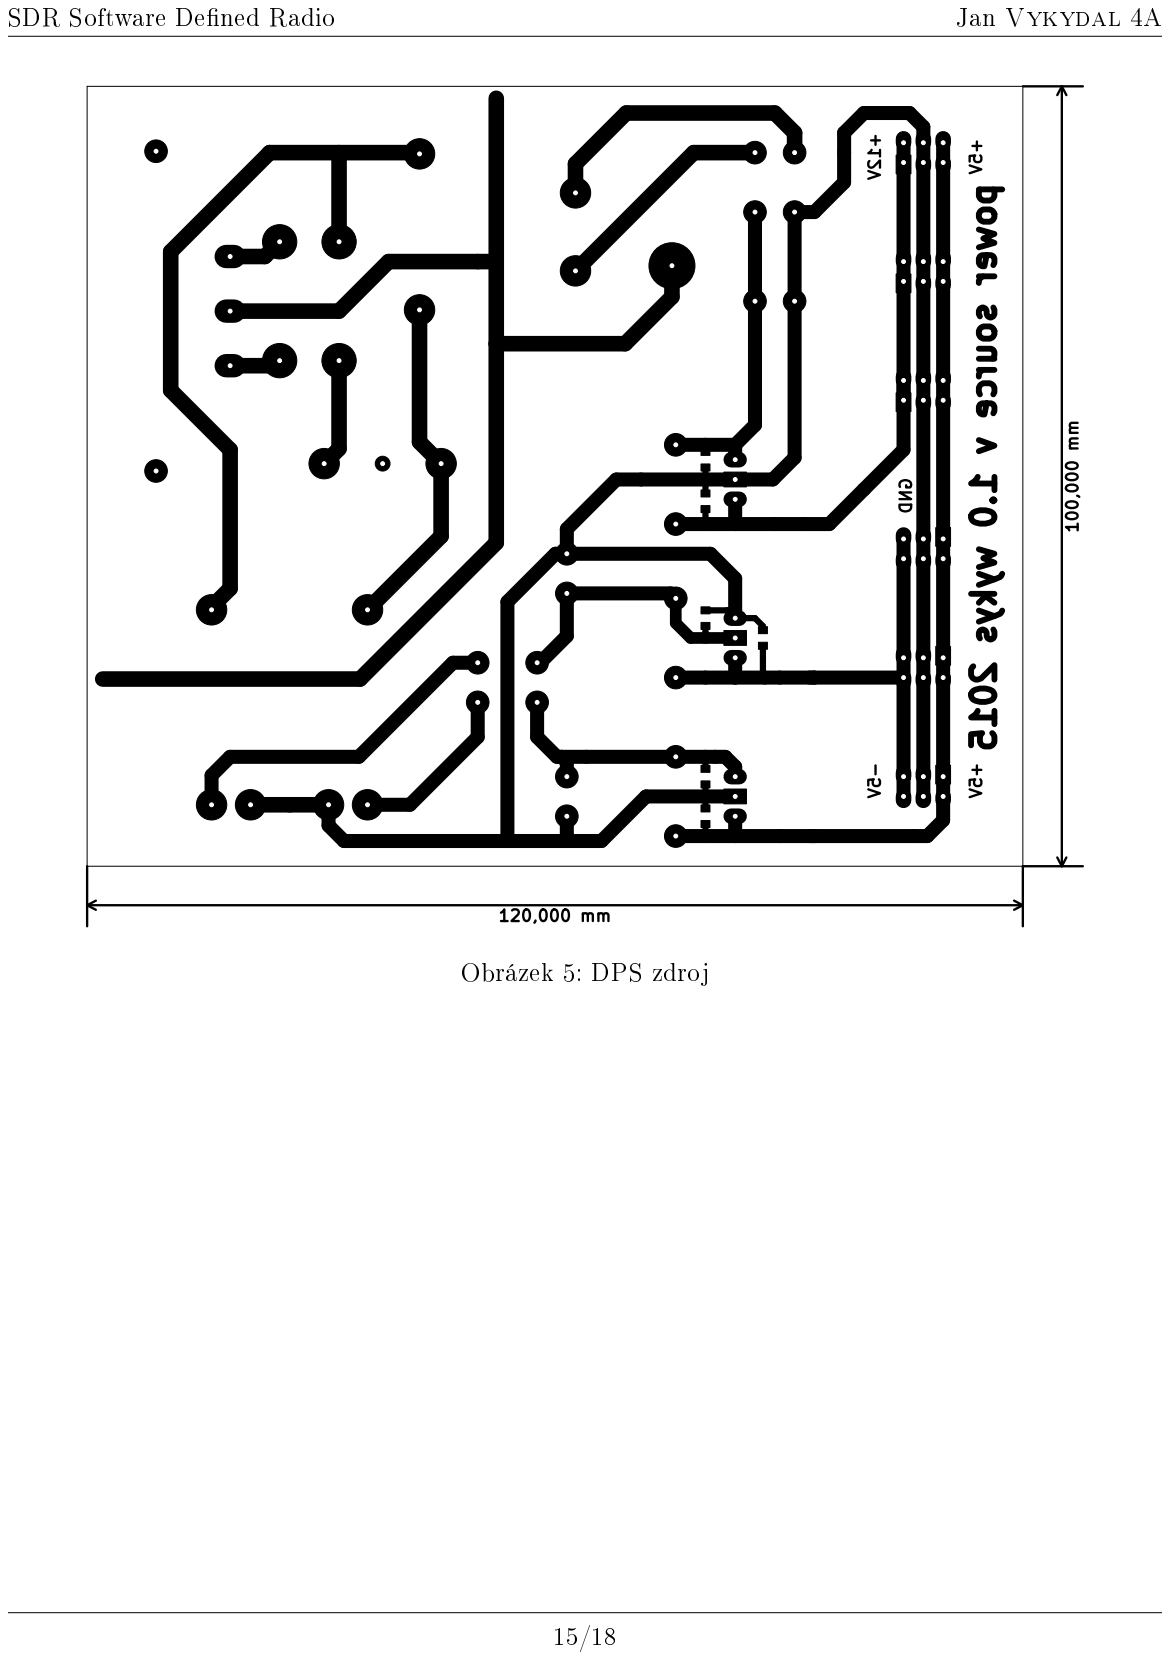
[picture p26: page 16]

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

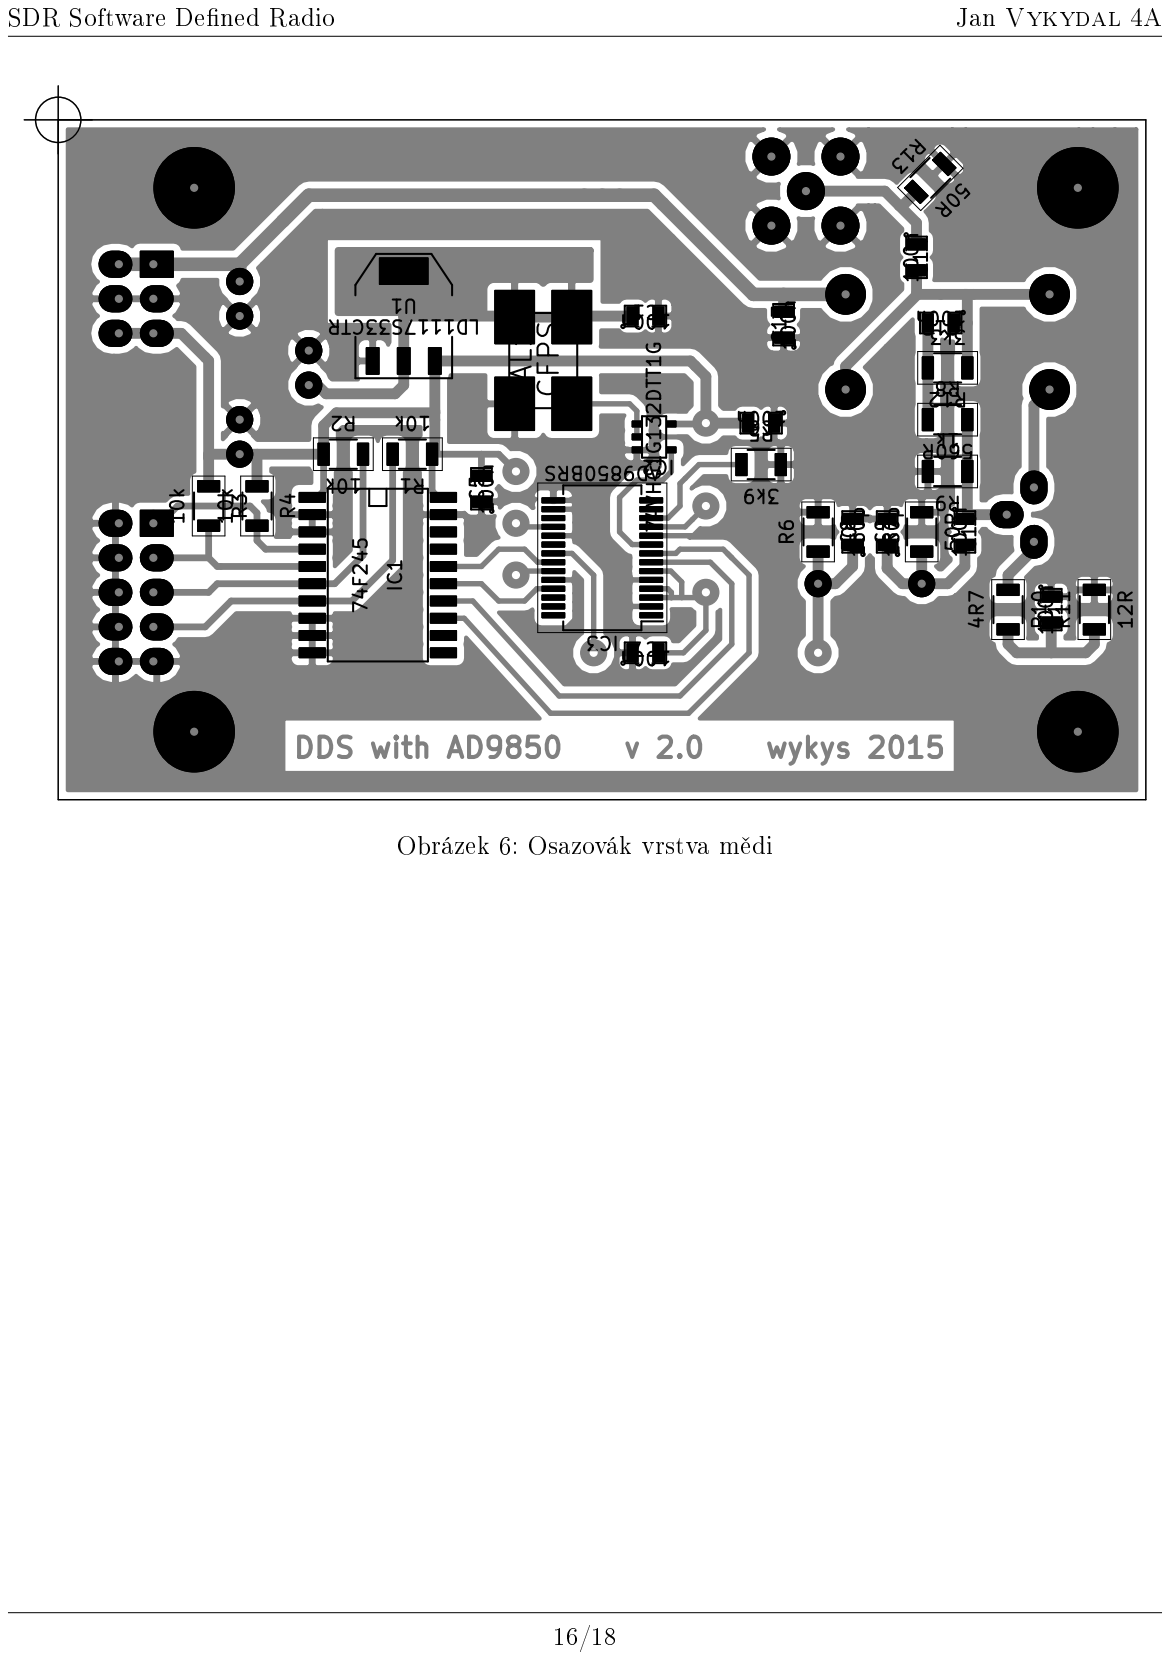
[picture p27: page 17]

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

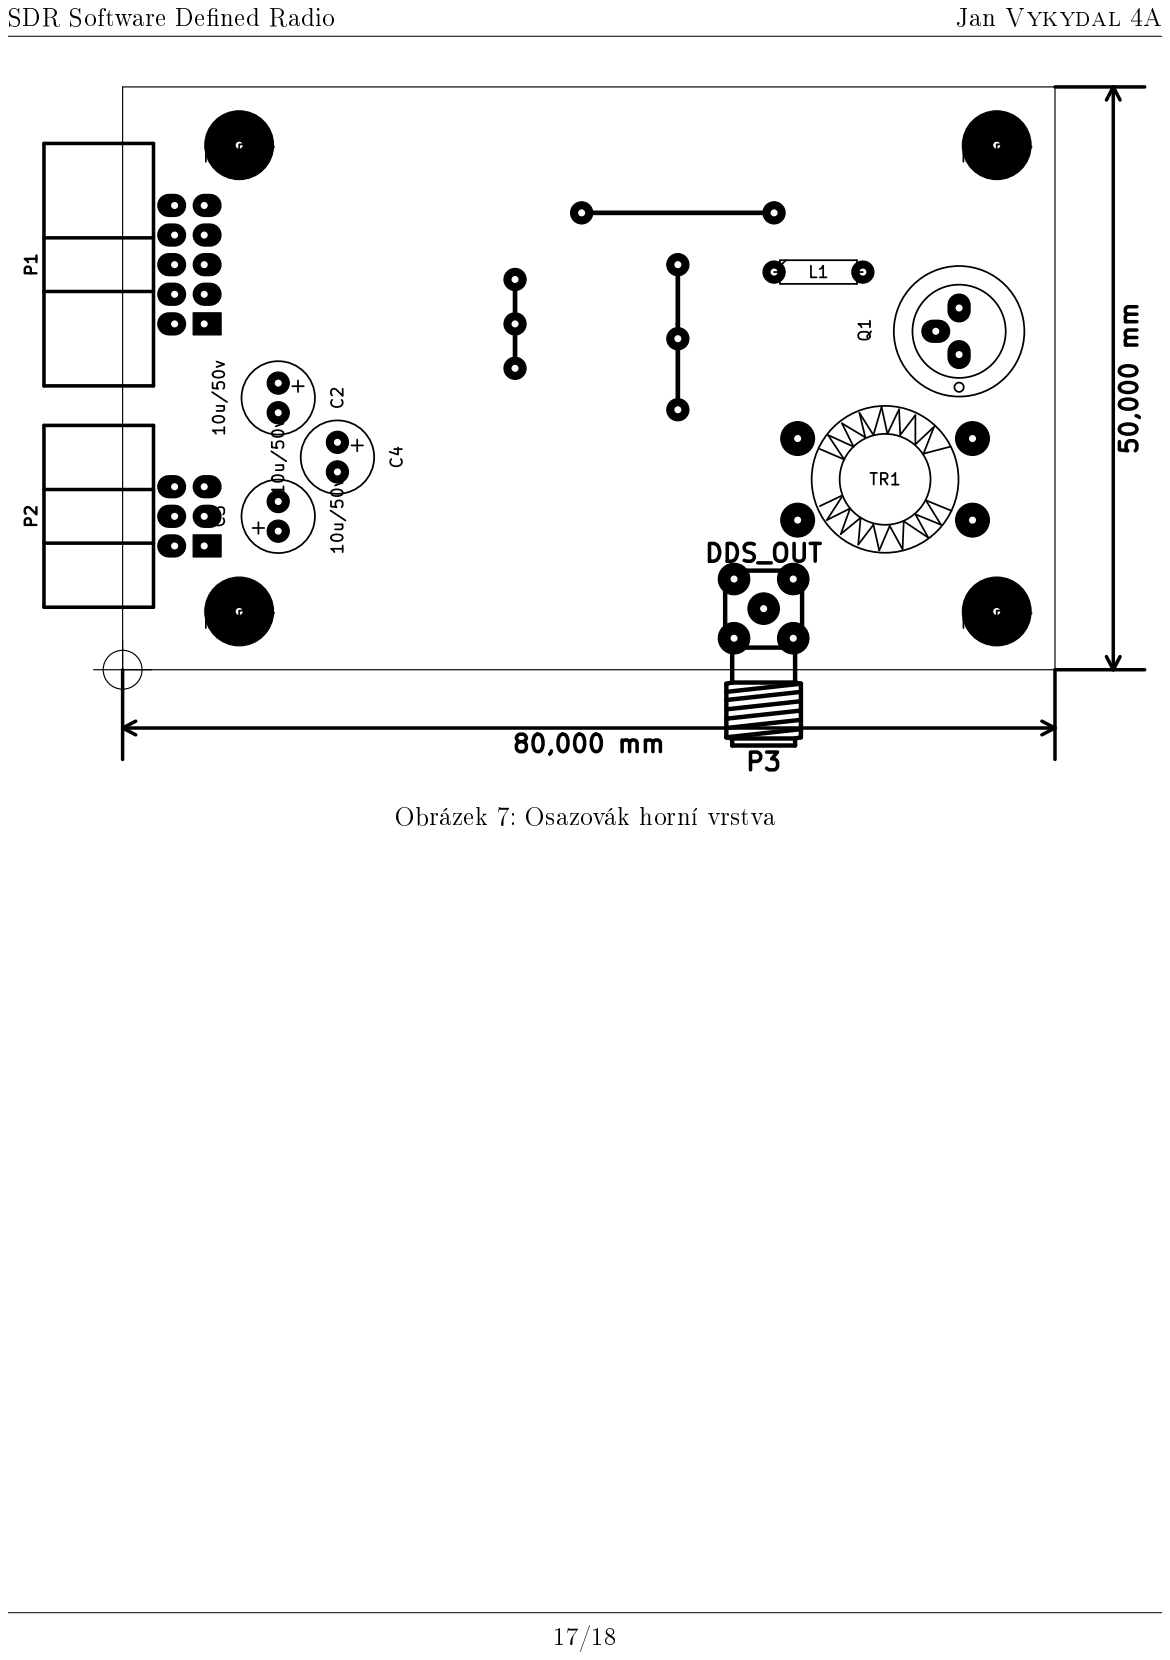
[picture p28: page 18]

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
