mfkiwl/SDR_SOC_doc/sdr/control_board/control_board.pdf

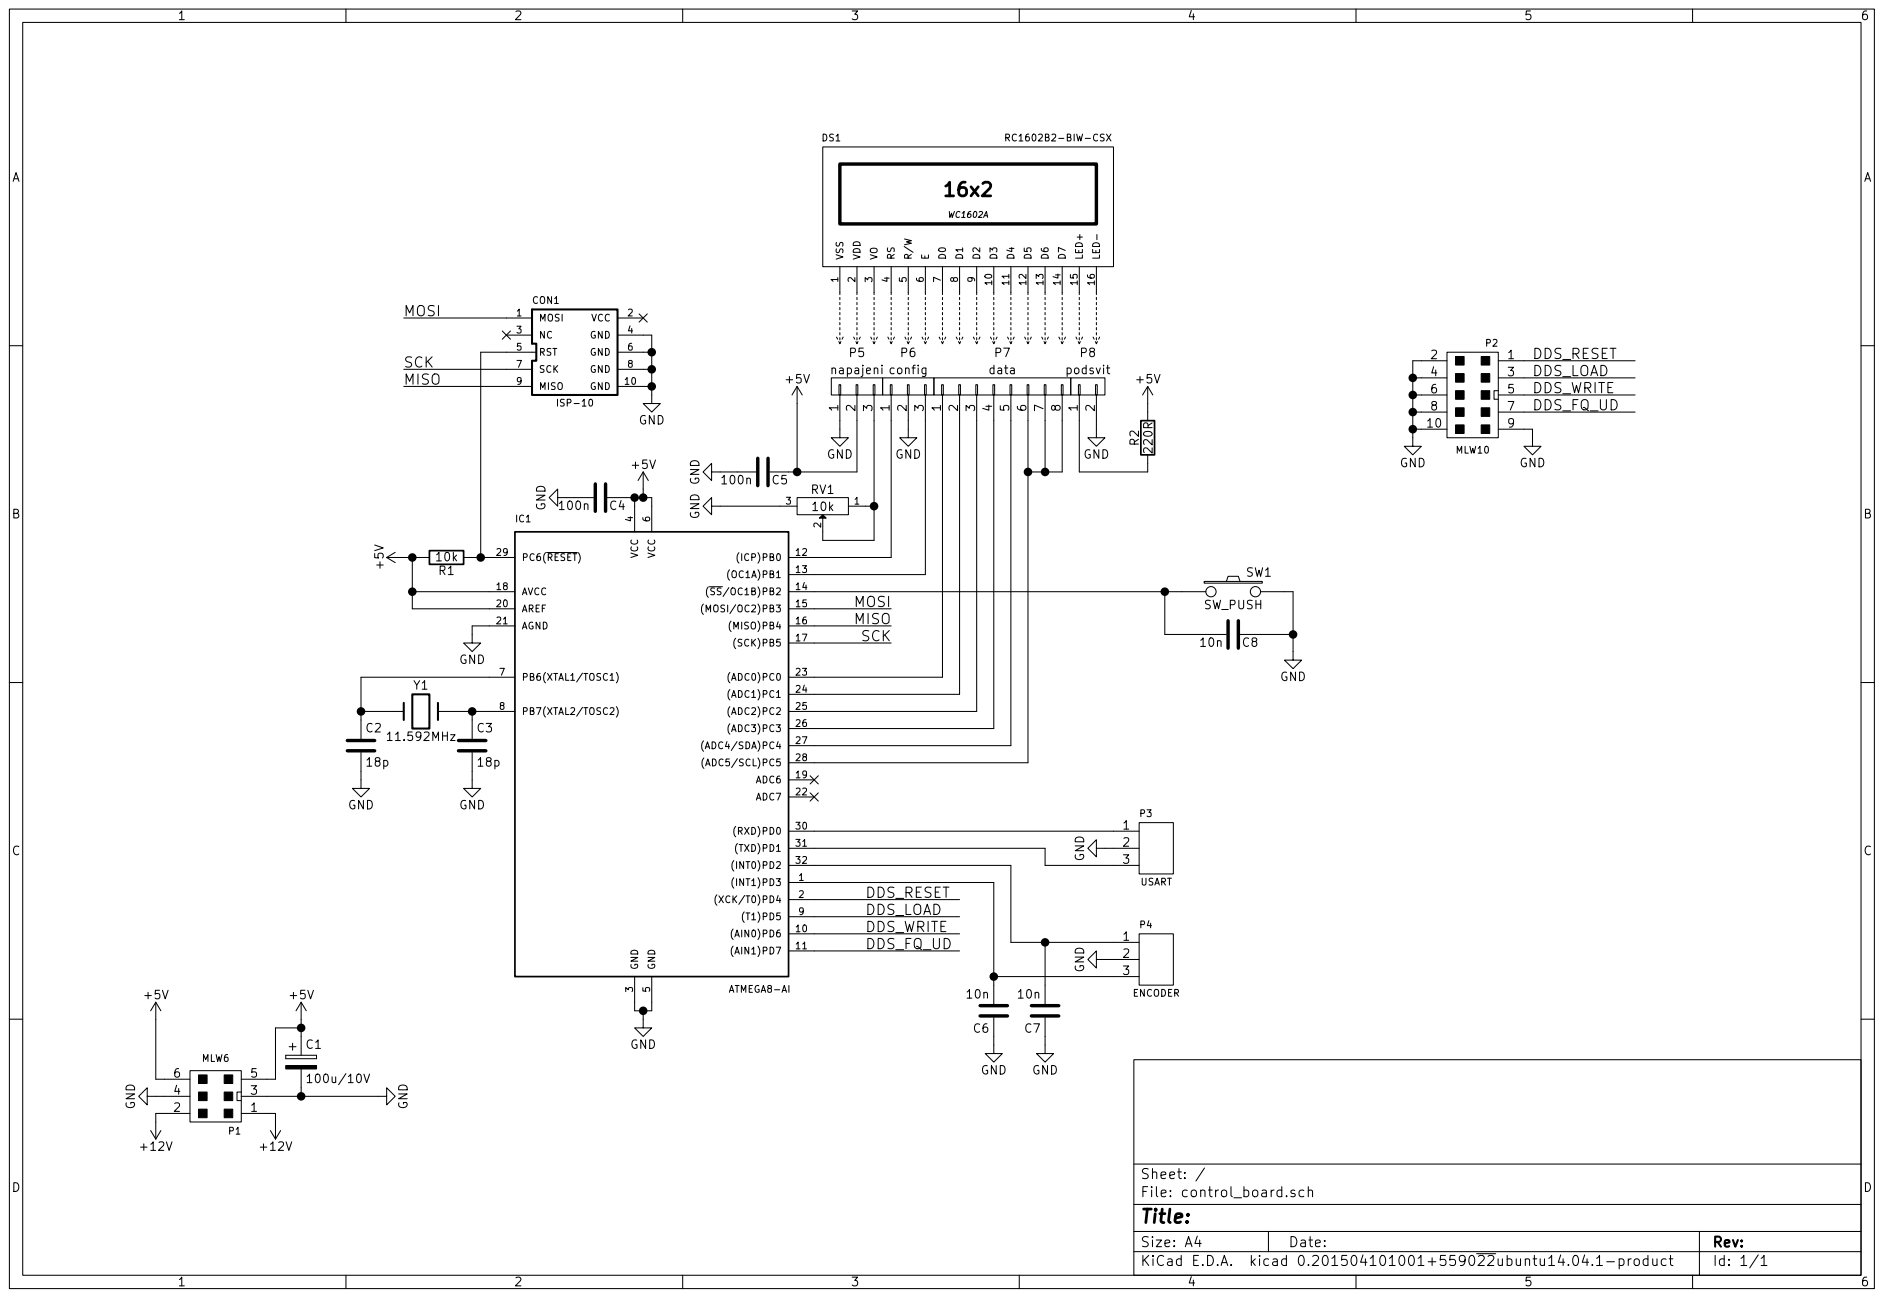
[picture p29: page 1]

9 D3 10 D4 11 D5 12 D6 13 D7 14 LED+ 15 LED- 16 DS1 RC1602B2-BIW-CSX WC1602A
