mfkiwl/SDR_SOC_doc/sdr_svr/img/AD9850_bd.pdf

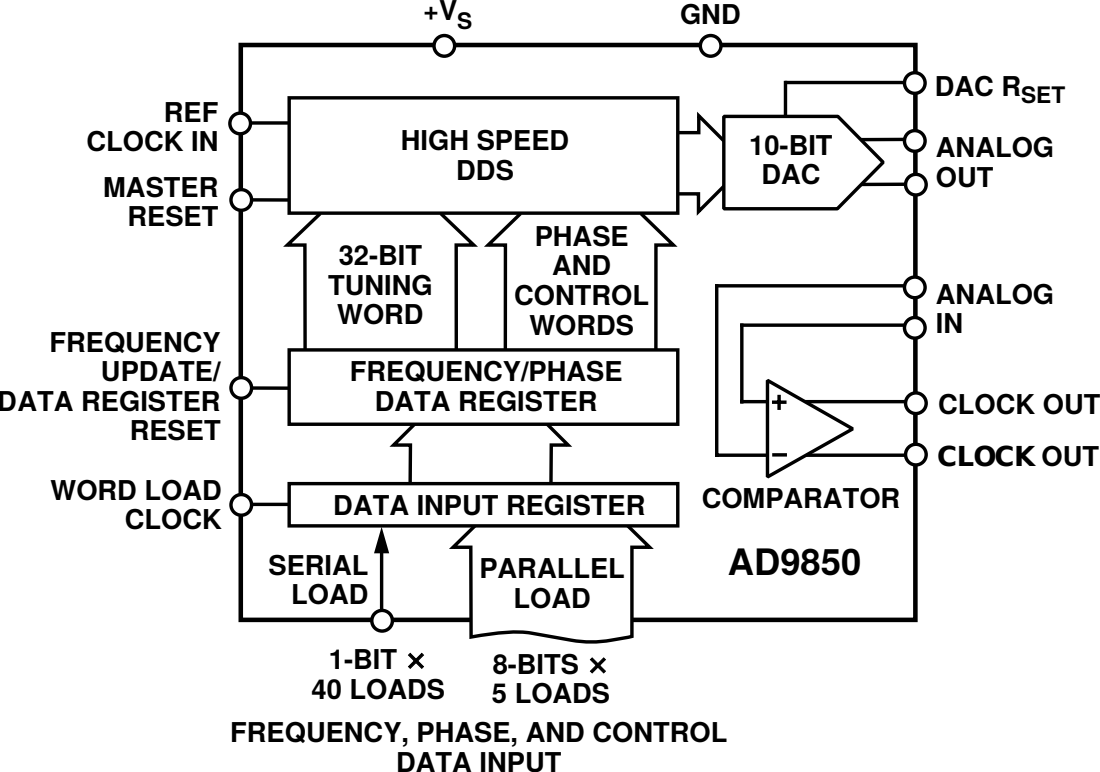
[picture p30: page 1]
CLOCK OUT; ANALOG IN; ANALOG OUT; DAC RSET; GND; COMPARATOR; PHASE AND CONTROL WORDS; 32-BIT TUNING WORD; HIGH SPEED DDS; FREQUENCY/PHASE DATA REGISTER; PARALLEL LOAD; 10-BIT DAC; REF CLOCK IN MASTER RESET; WORD LOAD CLOCK; FREQUENCY UPDATE/ DATA REGISTER RESET; 8-BITS 5 LOADS; DATA INPUT

DATA INPUT REGISTER
SERIAL
LOAD
1-BIT
40 LOADS
FREQUENCY, PHASE, AND CONTROL
