mfkiwl/SDR_SOC_doc/sdr/dds/design_v2/DDS.pdf

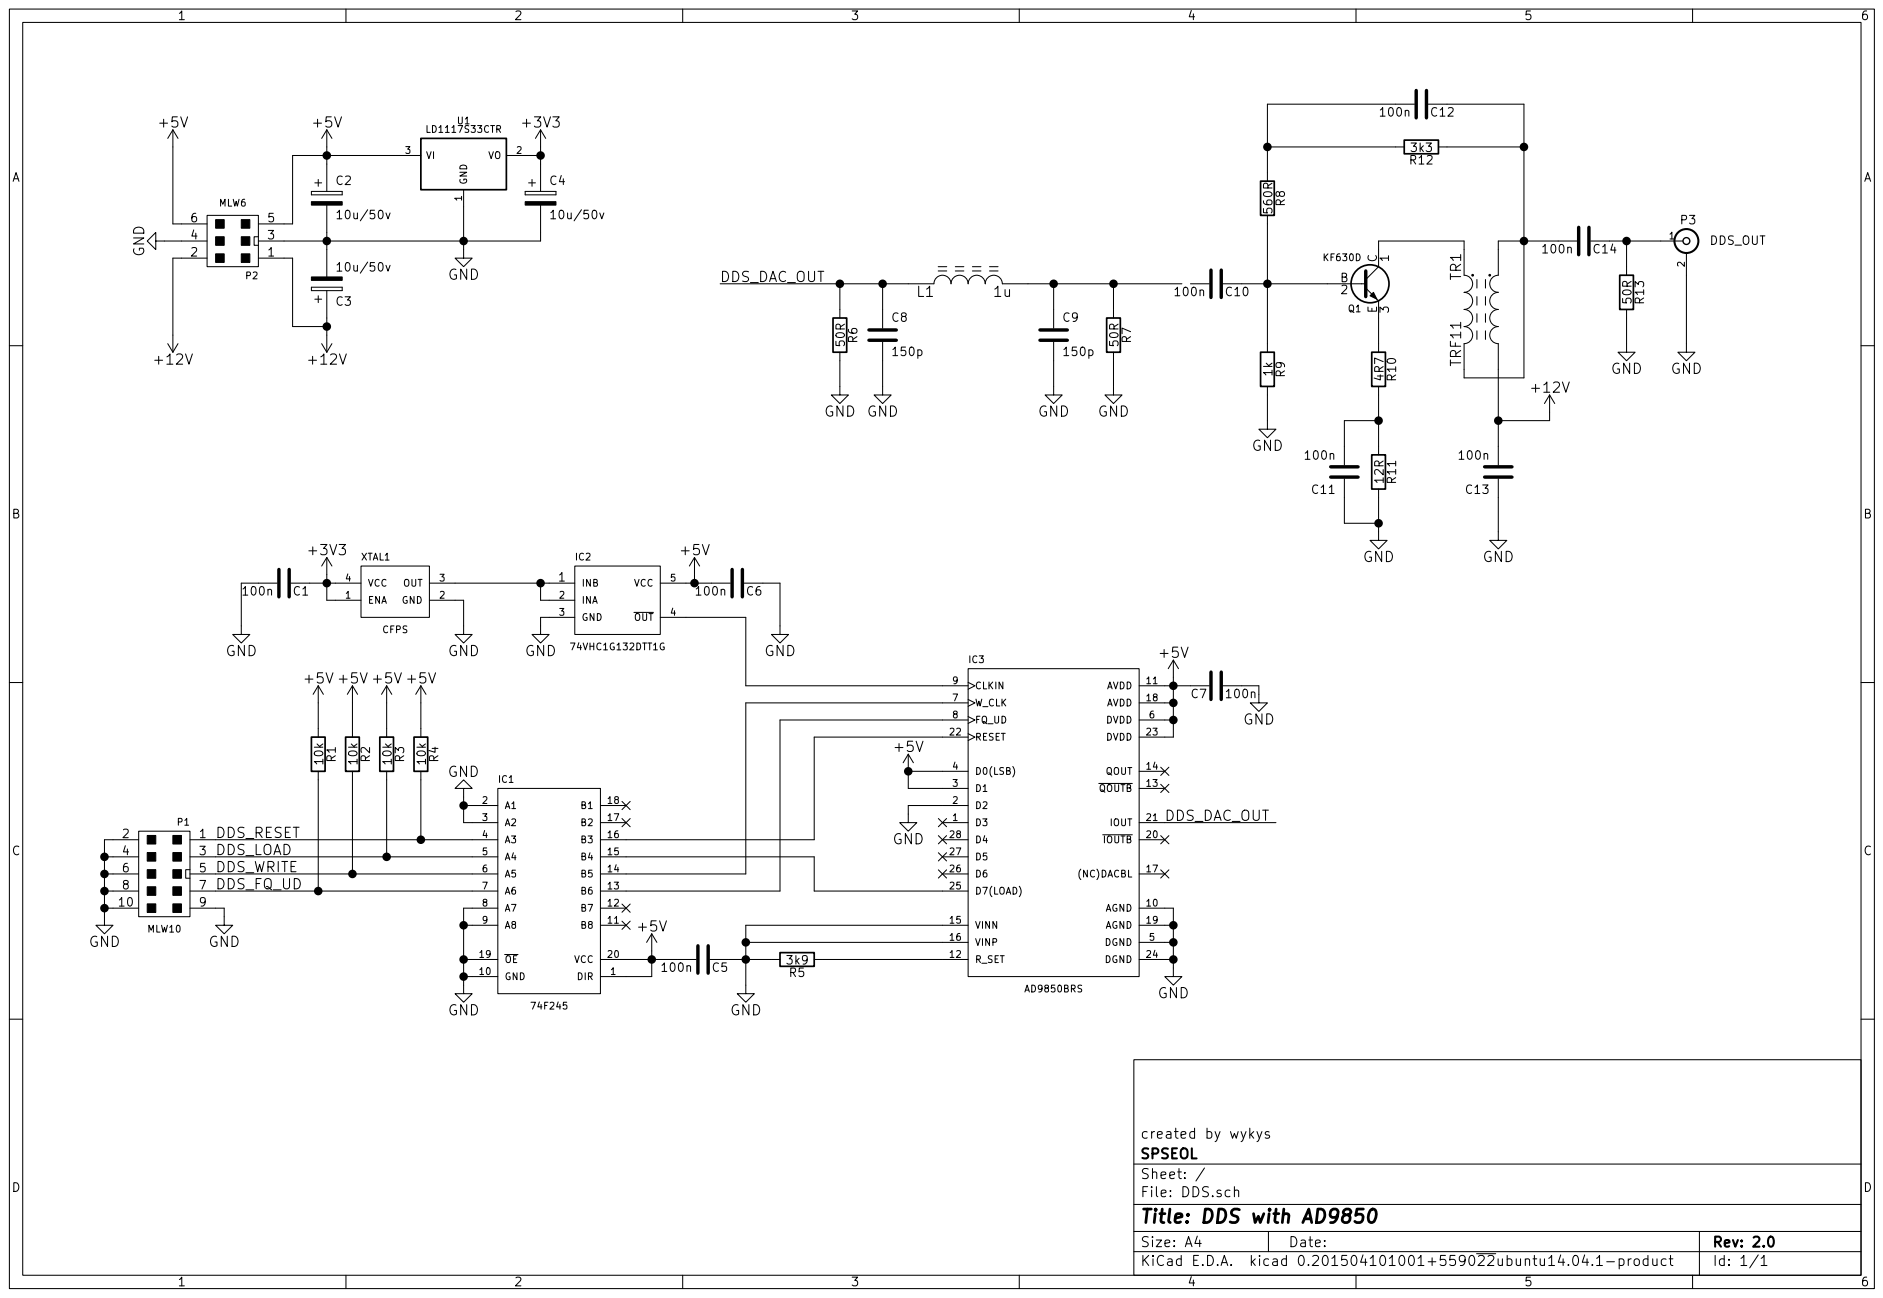
[picture p31: page 1]

created by wykys
File: DDS.sch Sheet: / SPSEOL

Id: 1/1 Title: DDS with AD9850
