mfkiwl/SDR_SOC_doc/sdr/LNA/design_v1/LNA.pdf

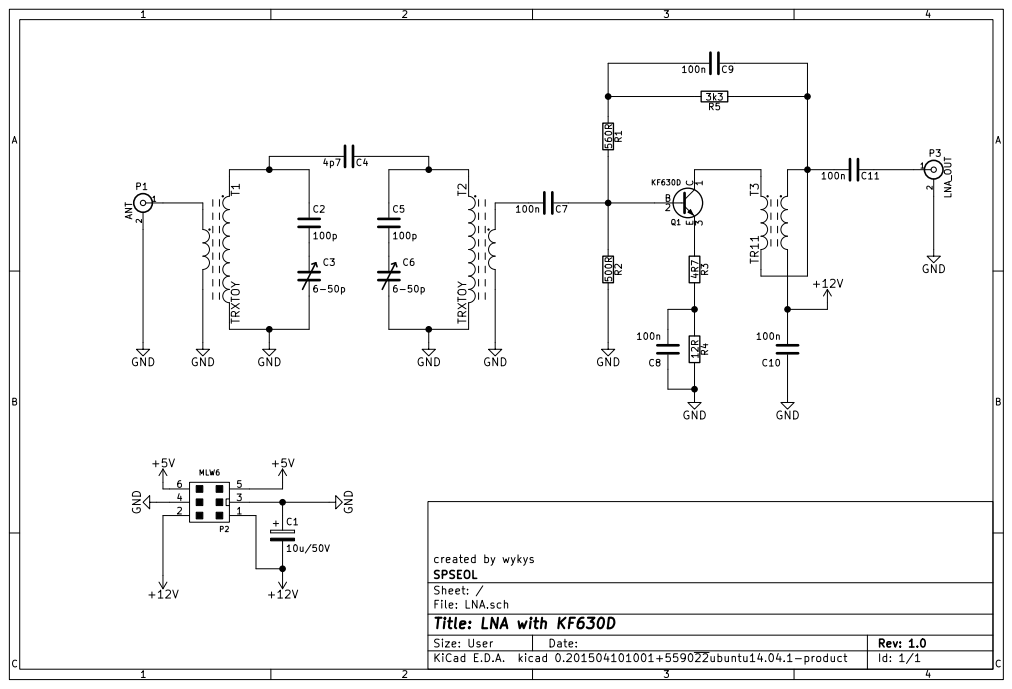
[picture p32: page 1]

created by wykys
File: LNA.sch Sheet: / SPSEOL

Id: 1/1 Title: LNA with KF630D
