mfkiwl/SDR_SOC_doc/sdr/dds/design_v2/out/cu_b.pdf

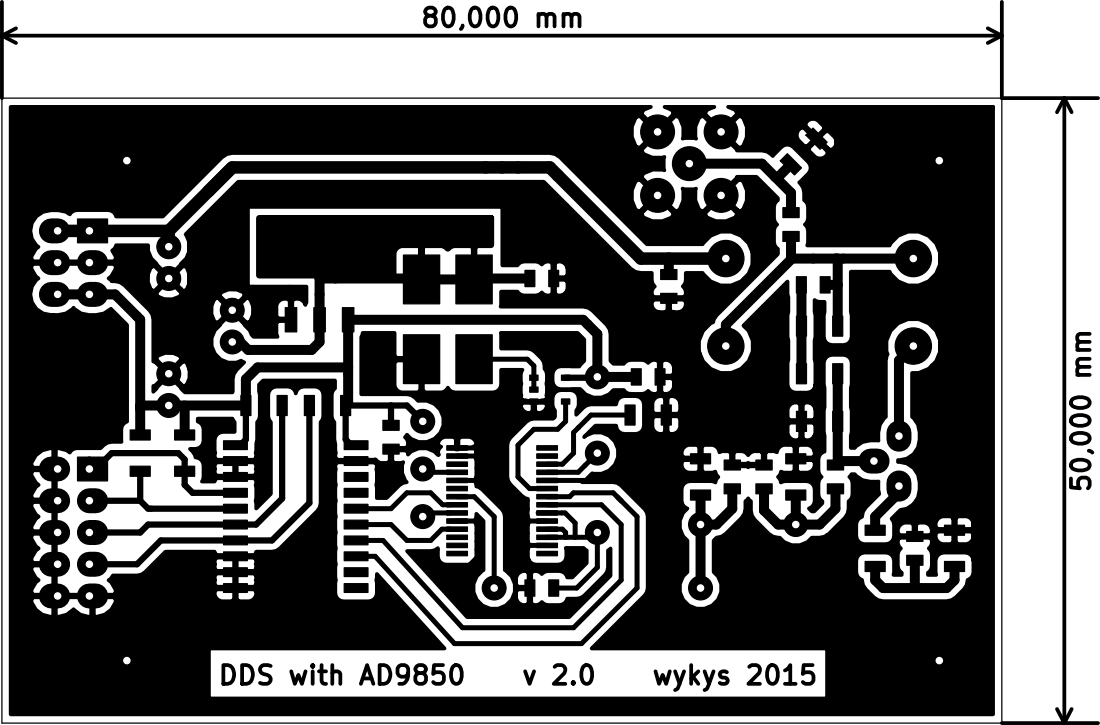
[picture p33: page 1]
