mfkiwl/SDR_SOC_doc/sdr/dds/design_v2/out/os_b.pdf

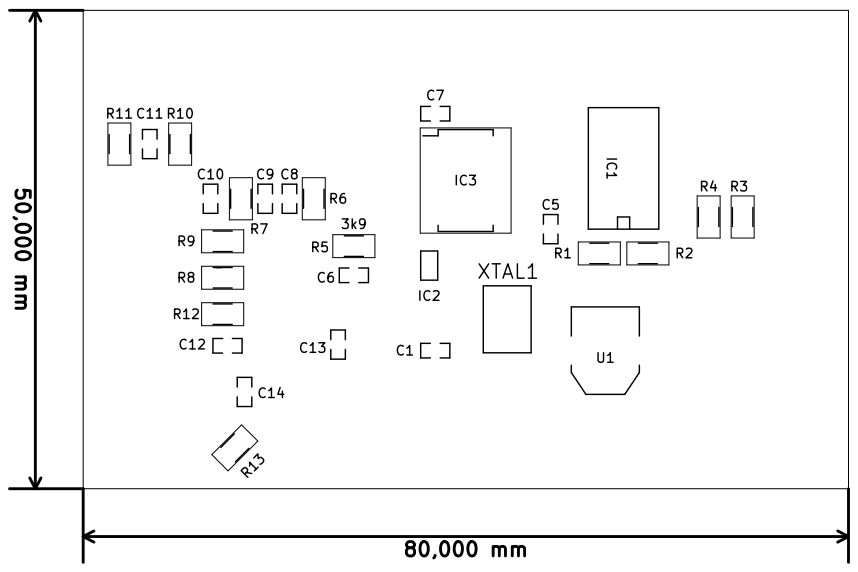
[picture p34: page 1]
