mfkiwl/SDR_SOC_doc/sdr/dds/design_v2/out/os_f.pdf

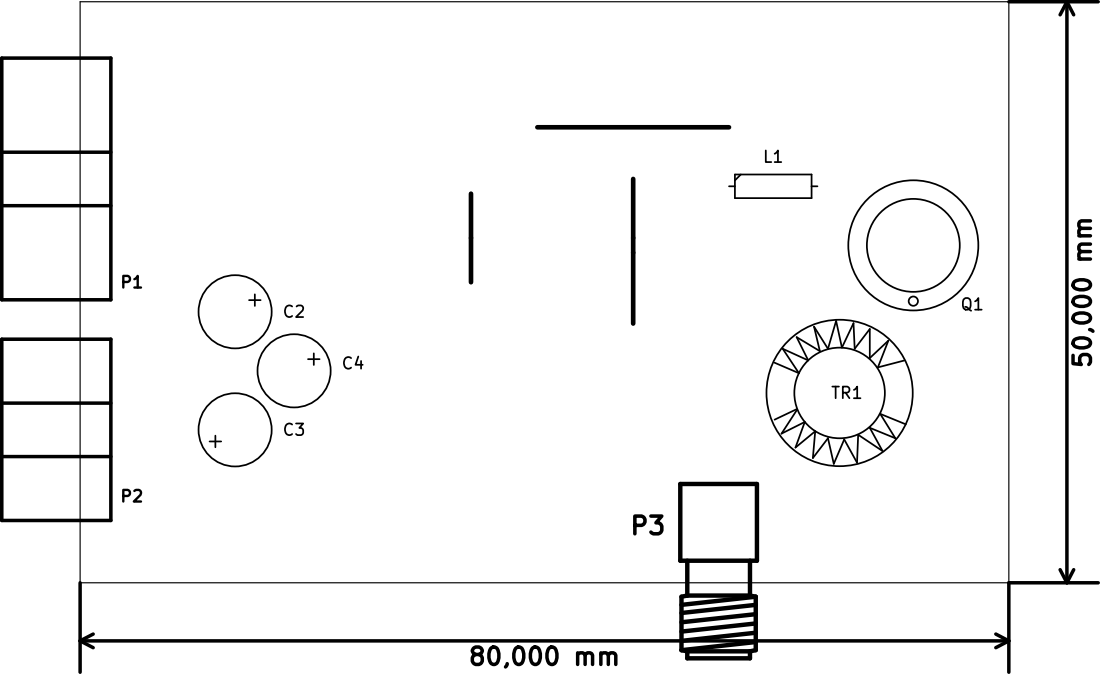
[picture p35: page 1]
