mfkiwl/SDR_SOC_doc/sdr/LNA/design_v1/out/lna_b.pdf

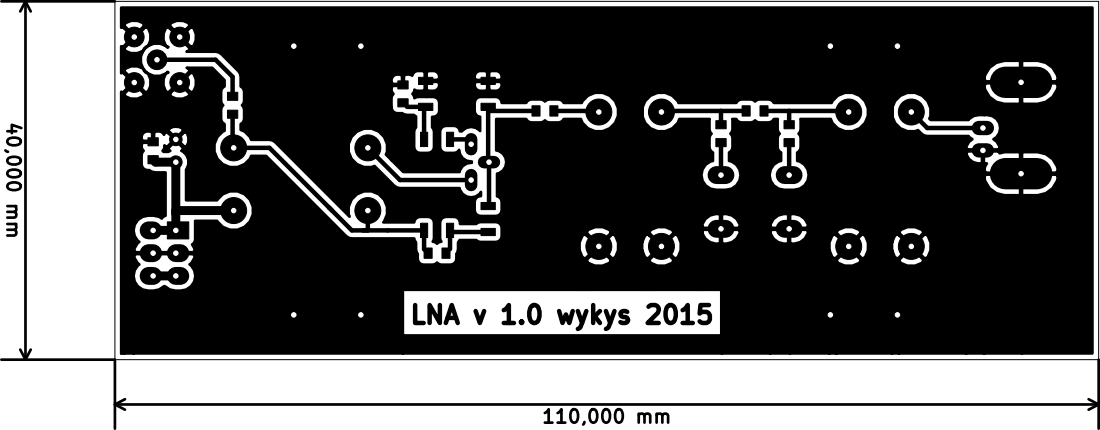
[picture p36: page 1]
