mfkiwl/SDR_SOC_doc/sdr/LNA/design_v1/out/lna_ob.pdf

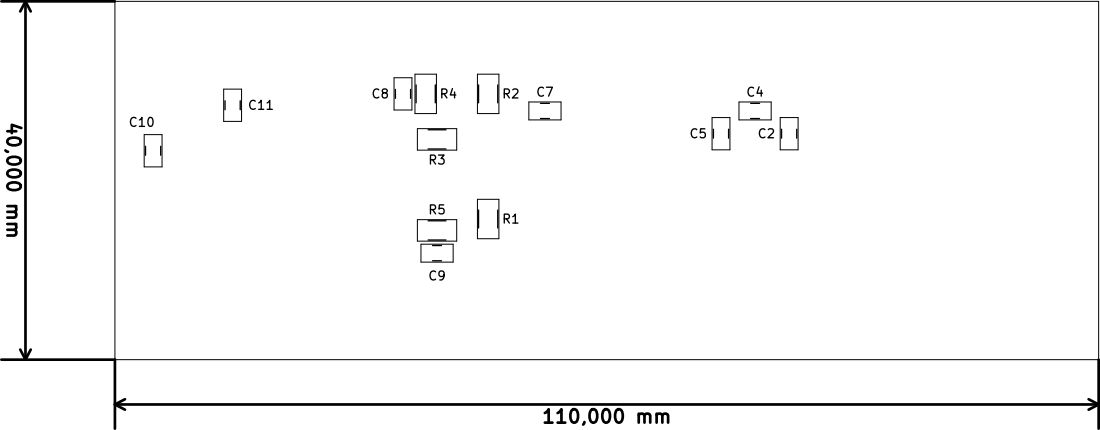
[picture p37: page 1]
