mfkiwl/SDR_SOC_doc/sdr/LNA/design_v1/out/lna_of.pdf

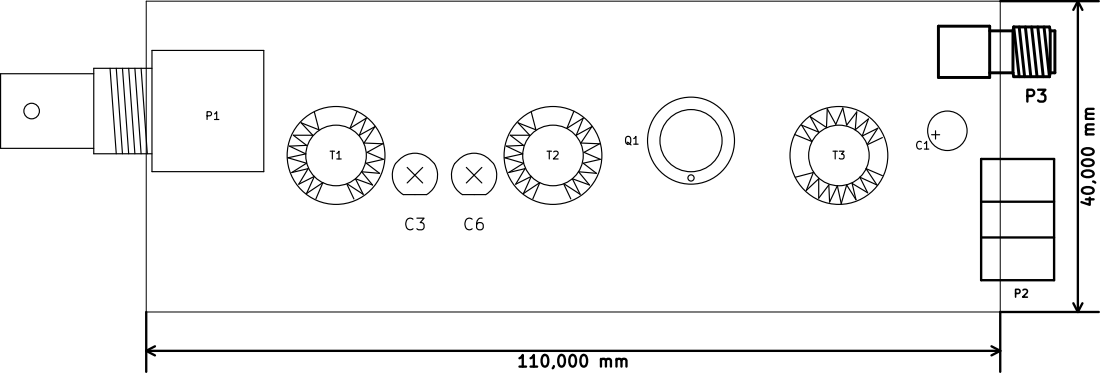
[picture p38: page 1]
