mfkiwl/SDR_SOC_doc/soc_sdr/SDR.pdf

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

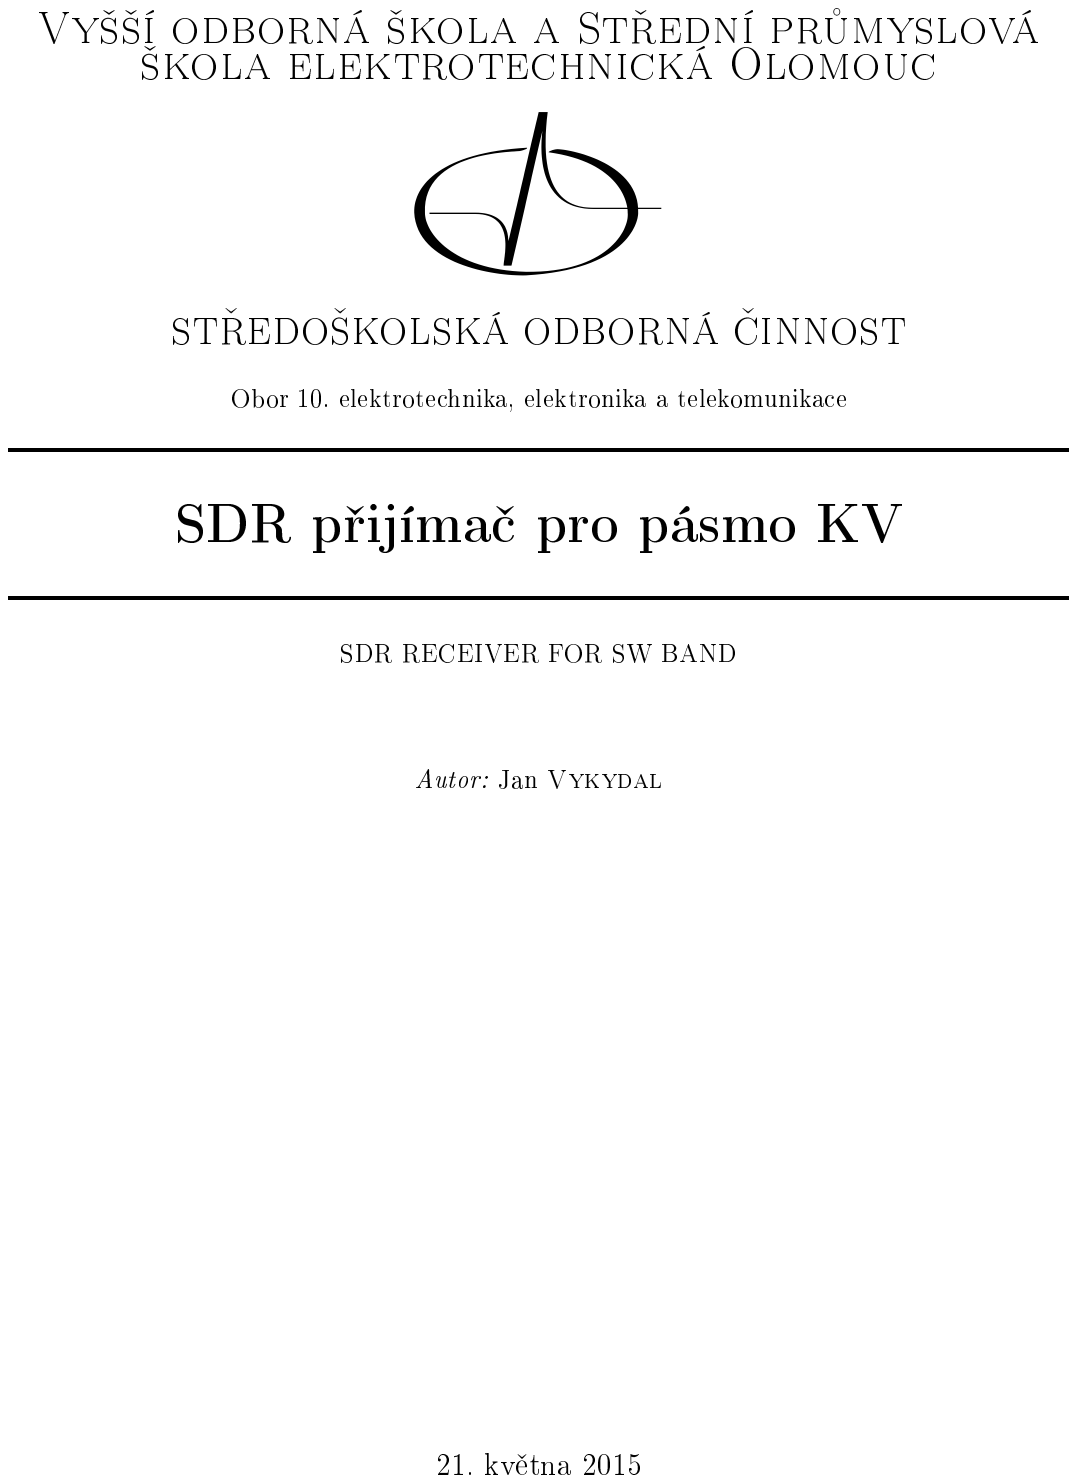
[picture p39: page 1]

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

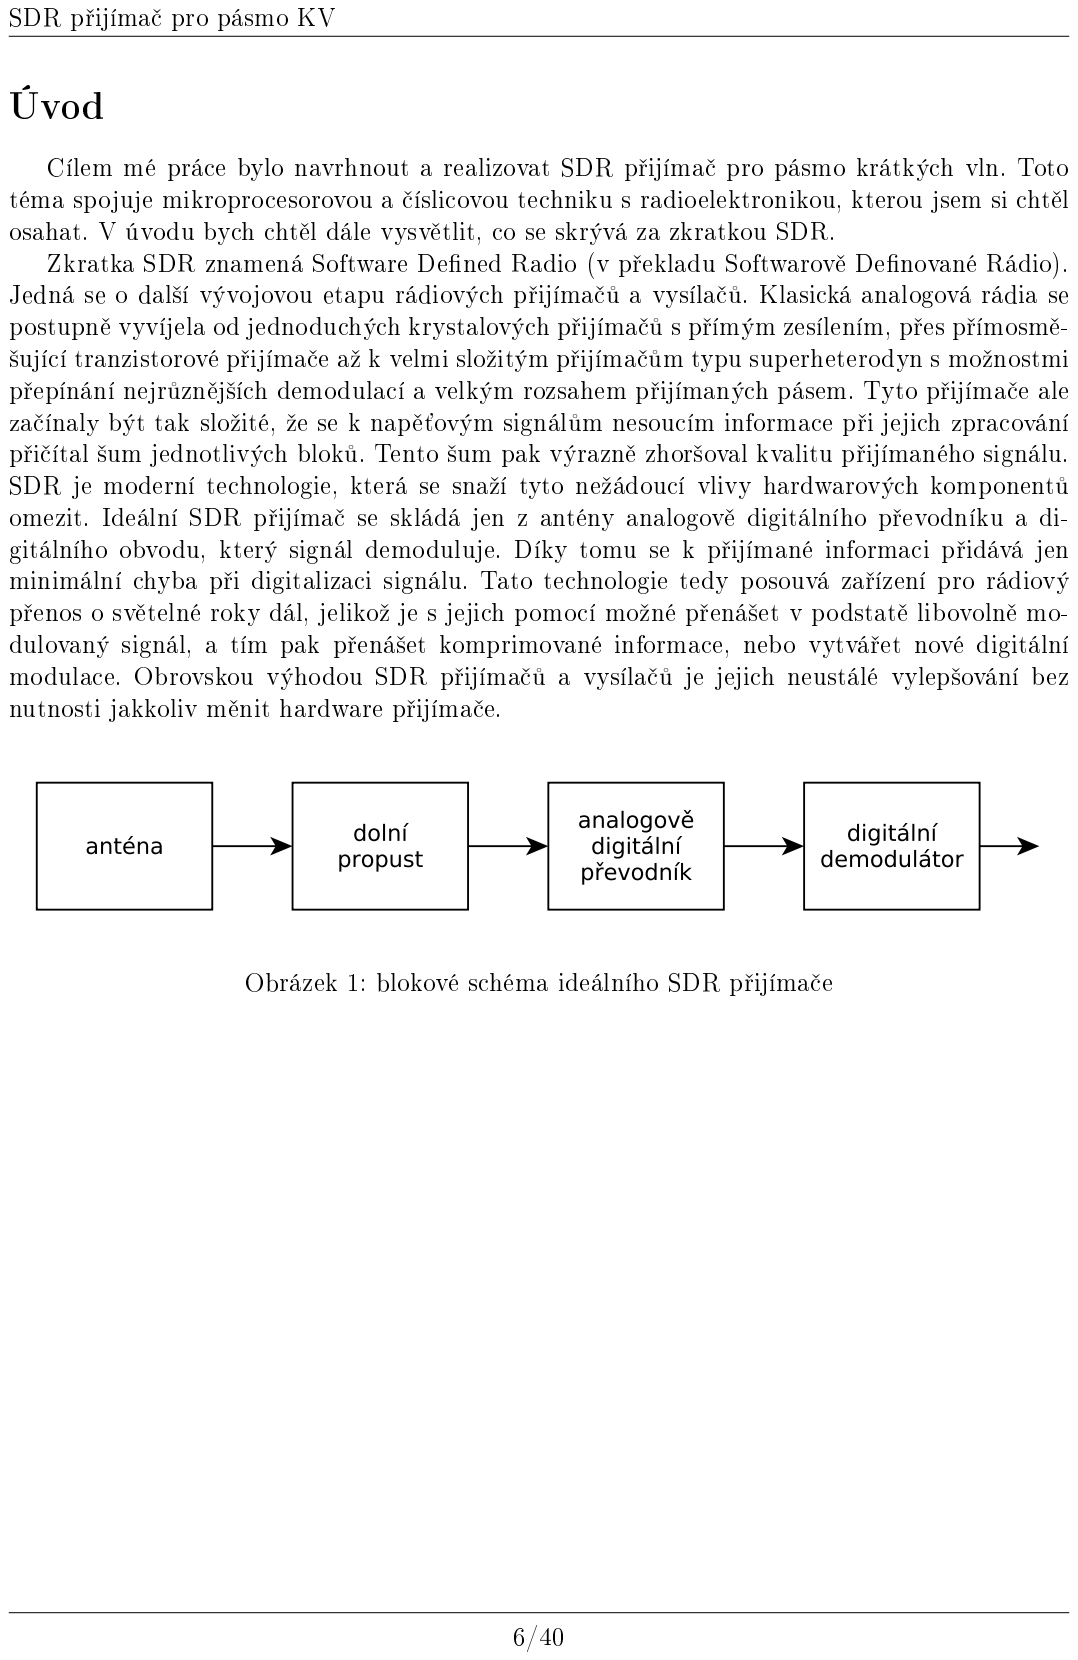
[picture p40: page 6]

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

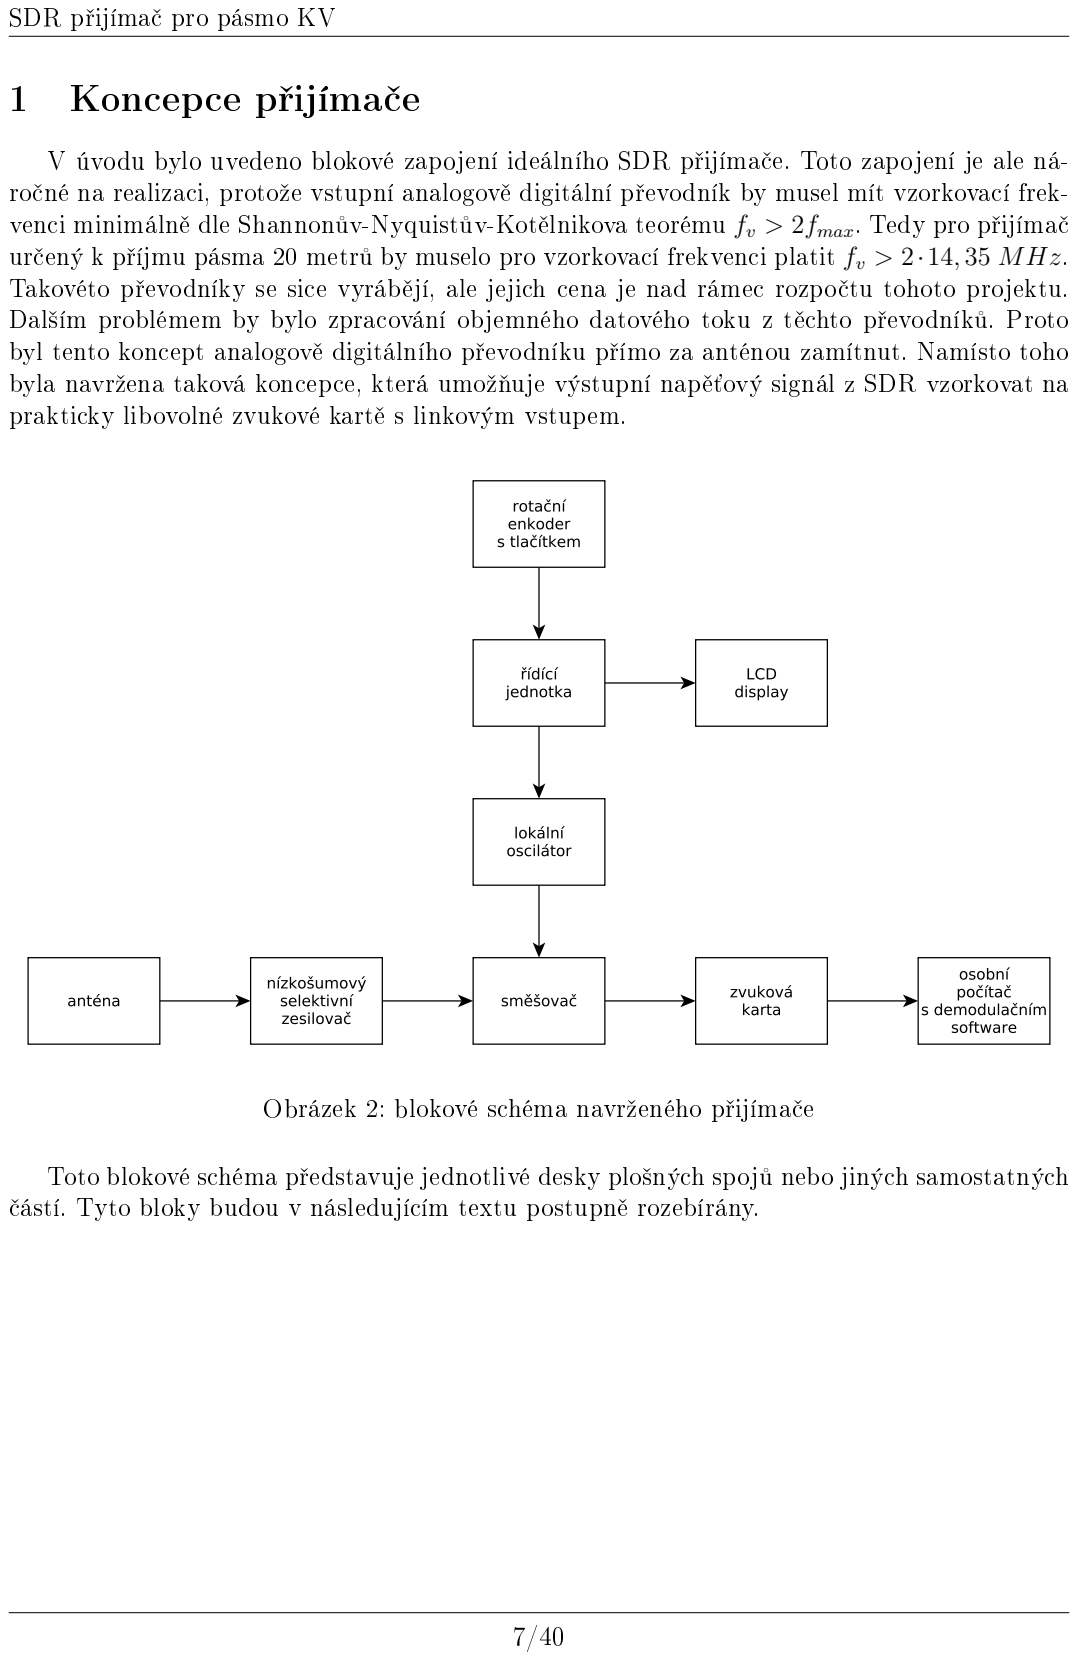
[picture p41: page 7]

SDR p°ijíma£ pro pásmo KV

2 | Nízko²umový selektivní zesilova£
| Tento obvod má za úkol zesílit vstupní signál a sou£asn¥ odstranit neºádoucí signál mimo
p°ijímané pásmo. Vstupní signál z antény je p°ivád¥n konektorem P1, dále pokra£uje k transformátoru T1. Ten slouºí jako impedan£ní p°izp·sobení, kdy upravuje impedanci ze vstupních 50 Ω sm¥rem nahoru aº na n¥kolik set ohm·. Impedance závisí na kmito£tu vstupního signálu. Sekundární vinutí transformátoru T1 tvo°í s kondenzátorem C2 a kapacitním trimrem C3 paralelní rezonan£ní obvod nalad¥ný na frekvenci 14 MHz. Tento rezonan£ní obvod je spojen kapacitní vazbou, kterou tvo°í kondenzátor C4 s dal²ím paralelním rezonan£ním obvodem. Ten je tvo°en kondenzátorem C5, kapacitním trimrem C6 a primárním vinutím transformátoru T2. Tento rezonan£ní obvod je nalad¥ný na frekvenci 14, 35 MHz. Dal²í funkce transformátoru T2 je transformace impedance zpátky na 50 Ω. Transformátory T1 a T2 jsou navinuty na toroidním jádru Amidon T44-2. Upravený signál pokra£uje dále p°es vazební kondenzátor do tranzistorového zesilova£e. Jedná se o zesilova£ pracující ve t°íd¥ A a je postavený s tranzistorem KF630D. Teplotní stabilizaci zaji²´uje záporná proudová zp¥tná vazba tvo°ená rezistory R3 a R4. Nap¥tí báze je stabilizováno zápornou nap¥´ovou zp¥tnou vazbou tvo°enou rezistory R1, R2 a R5. Výstupní proud z tranzistoru te£e do bilárn¥ navinutého transformátoru T3. T3 tvo°í sedm závit· izolovanou dvoulinkou drátu pr·m¥ru 0, 8 mm na toroidní jádro z materiálu N2. Tento transformátor p°izp·sobuje výstupní impedanci na 50 Ω. P°ed výstupním konektorem je je²t¥ za°azen kondenzátor C11, který slouºí k odd¥lení stejnosm¥rné sloºky. Celý obvod se tedy chová

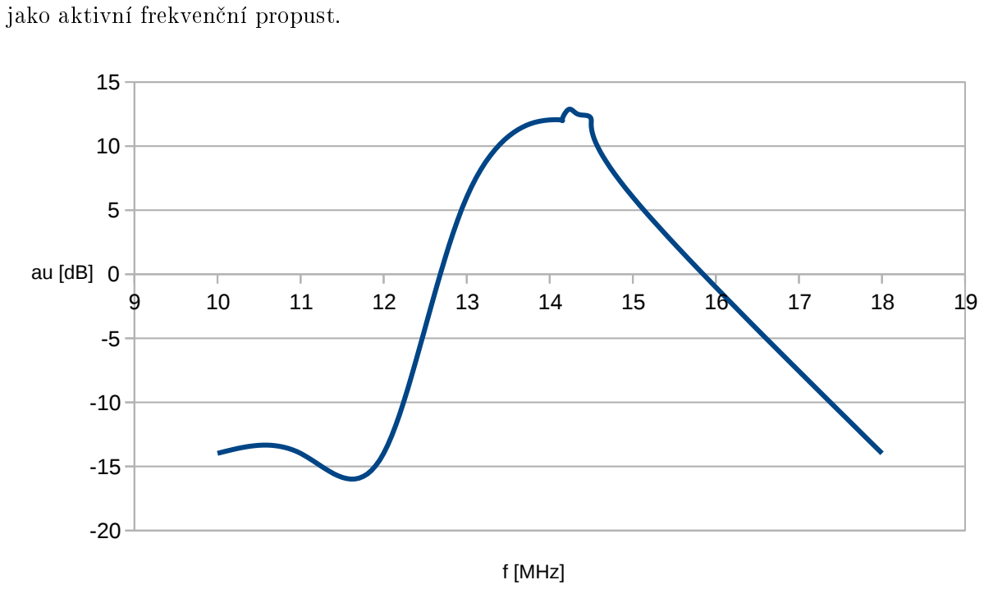
[picture p42: figure]
jako aktivní frekven£ní propust.; f [MHz]

au [dB] | Obrázek 3: Graf selektivnosti aktivní pásmové propusti

8/40

100n | C9 | GND

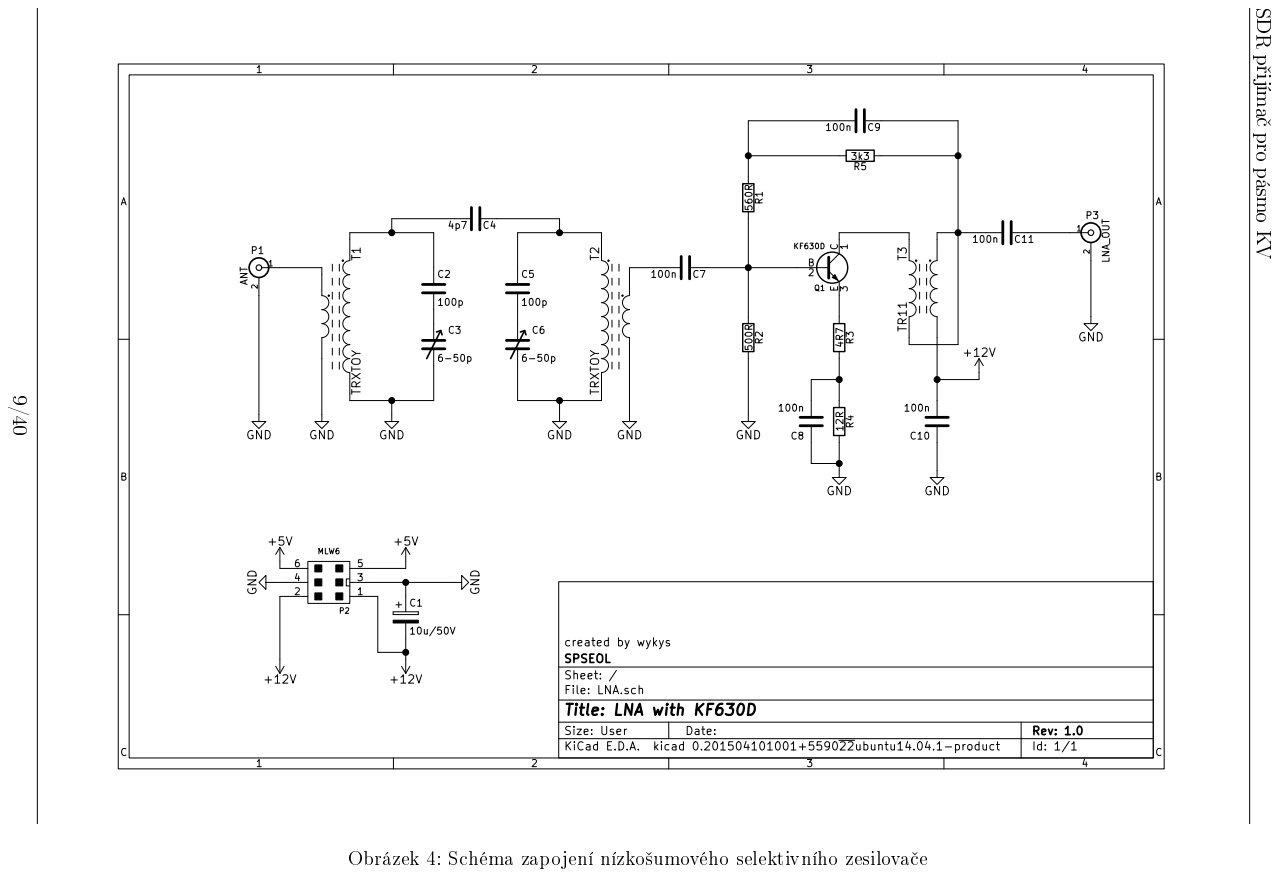
[picture p43: page 9]

SDR p°ijíma£ pro pásmo KV

10u/50V Obrázek 4: Schéma zapojení nízko²umového selektivního zesilova£e

created by wykys
File: LNA.sch Sheet: / SPSEOL

Id: 1/1 Title: LNA with KF630D

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

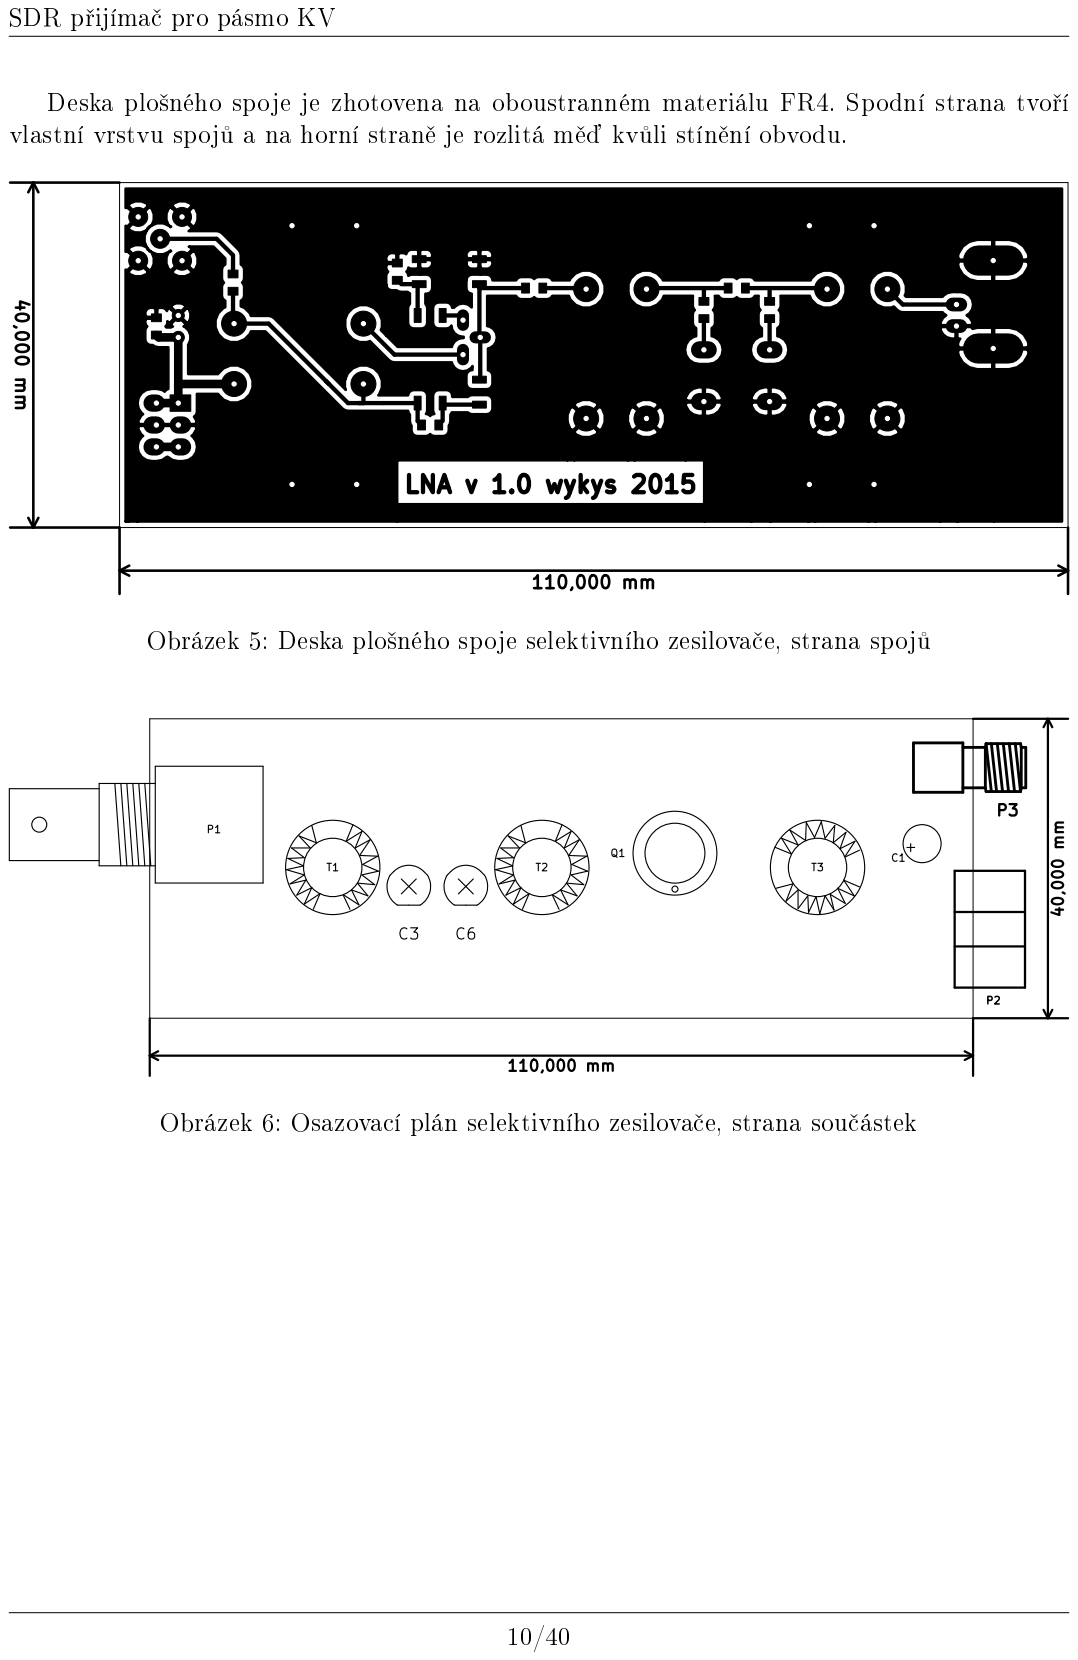
[picture p44: page 10]

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

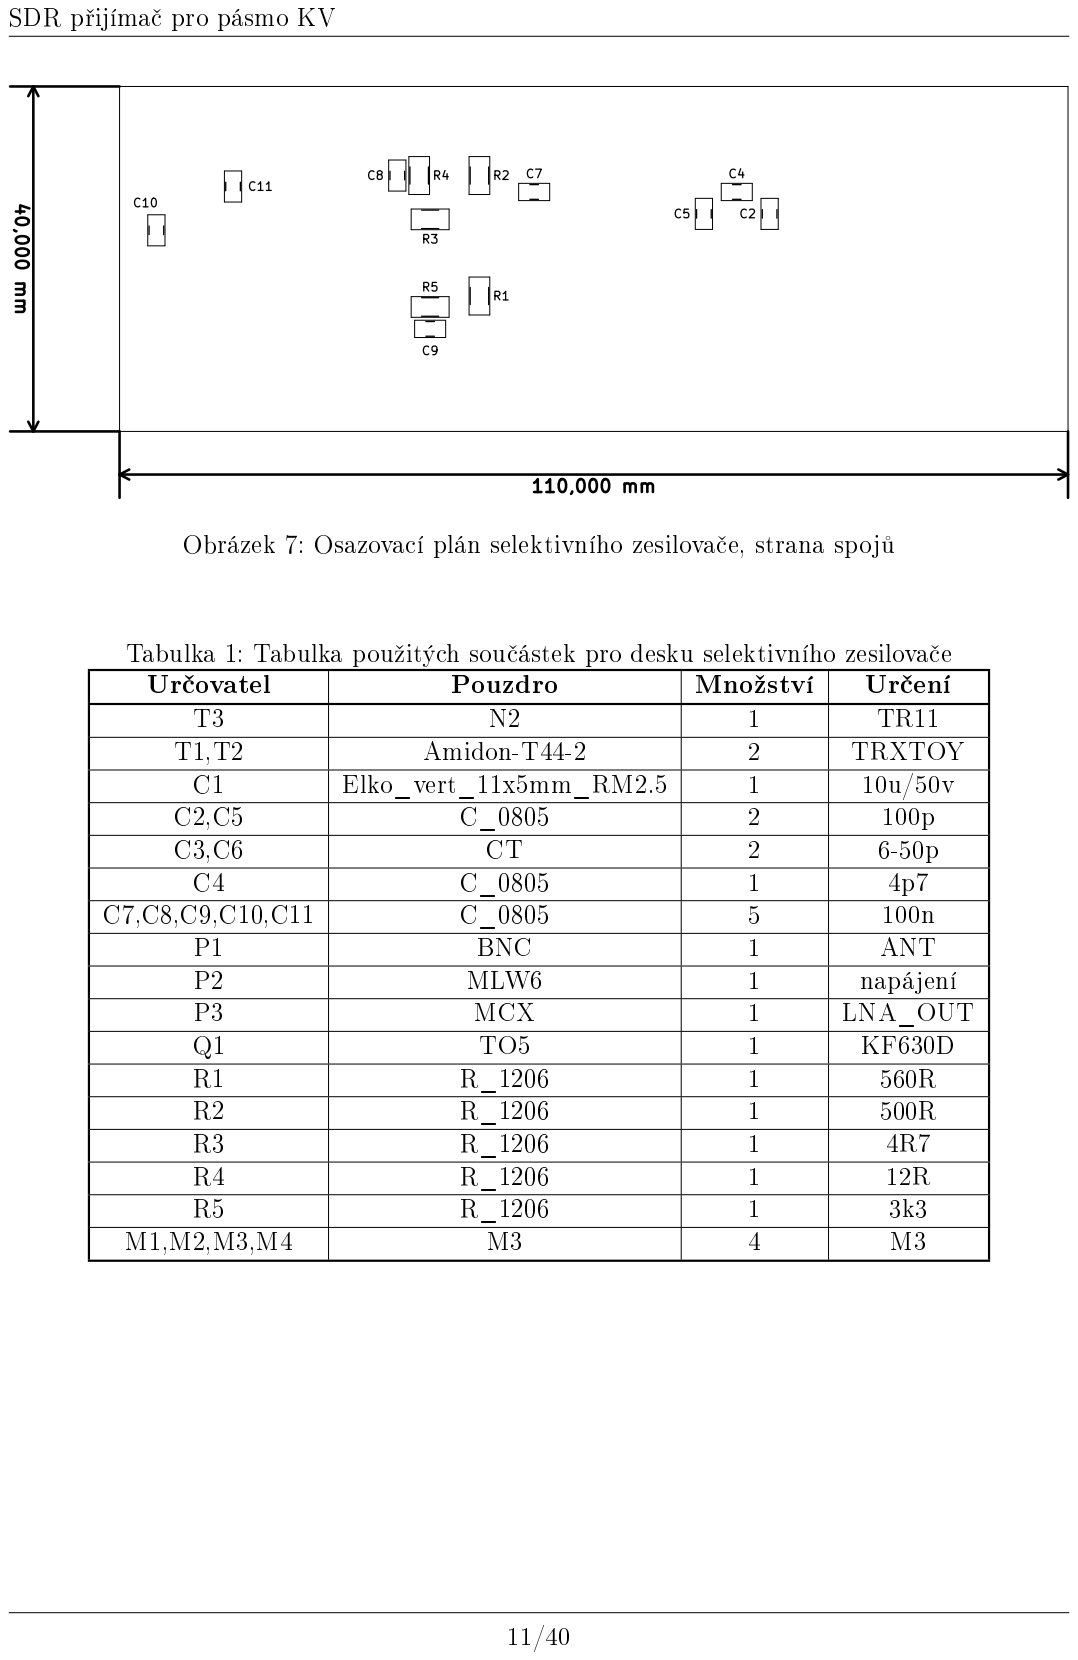
[picture p45: page 11]

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

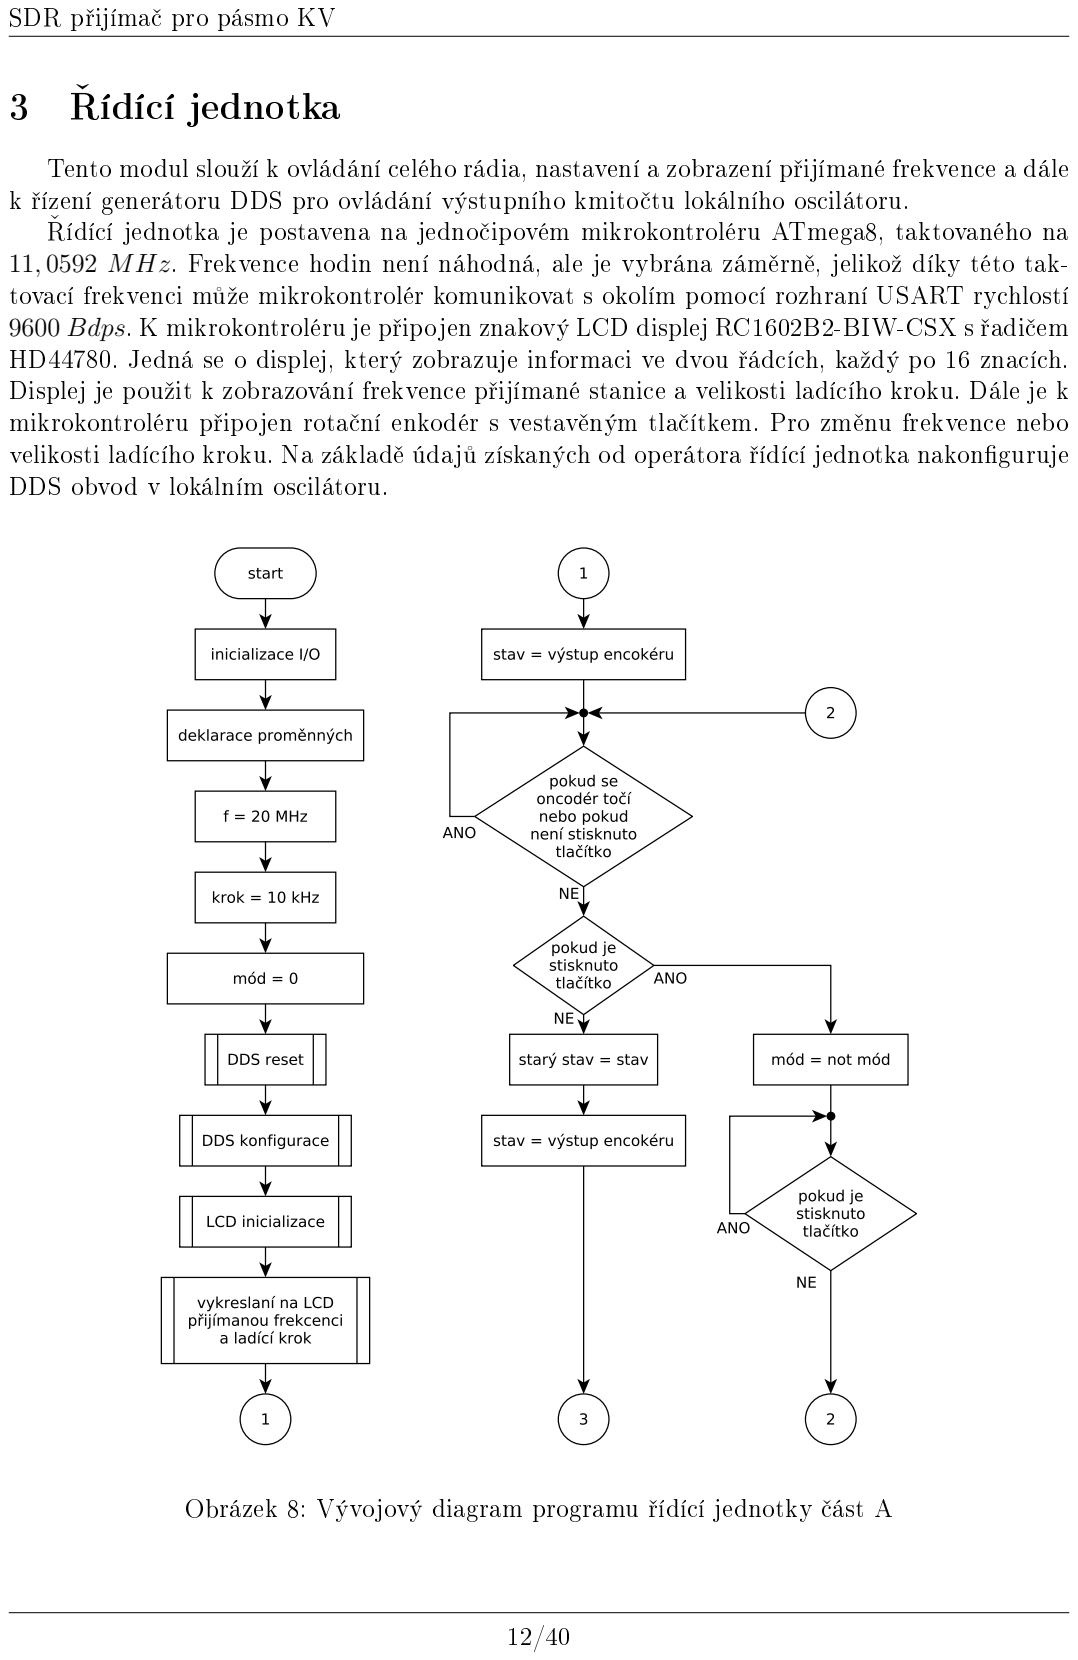
[picture p46: page 12]

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

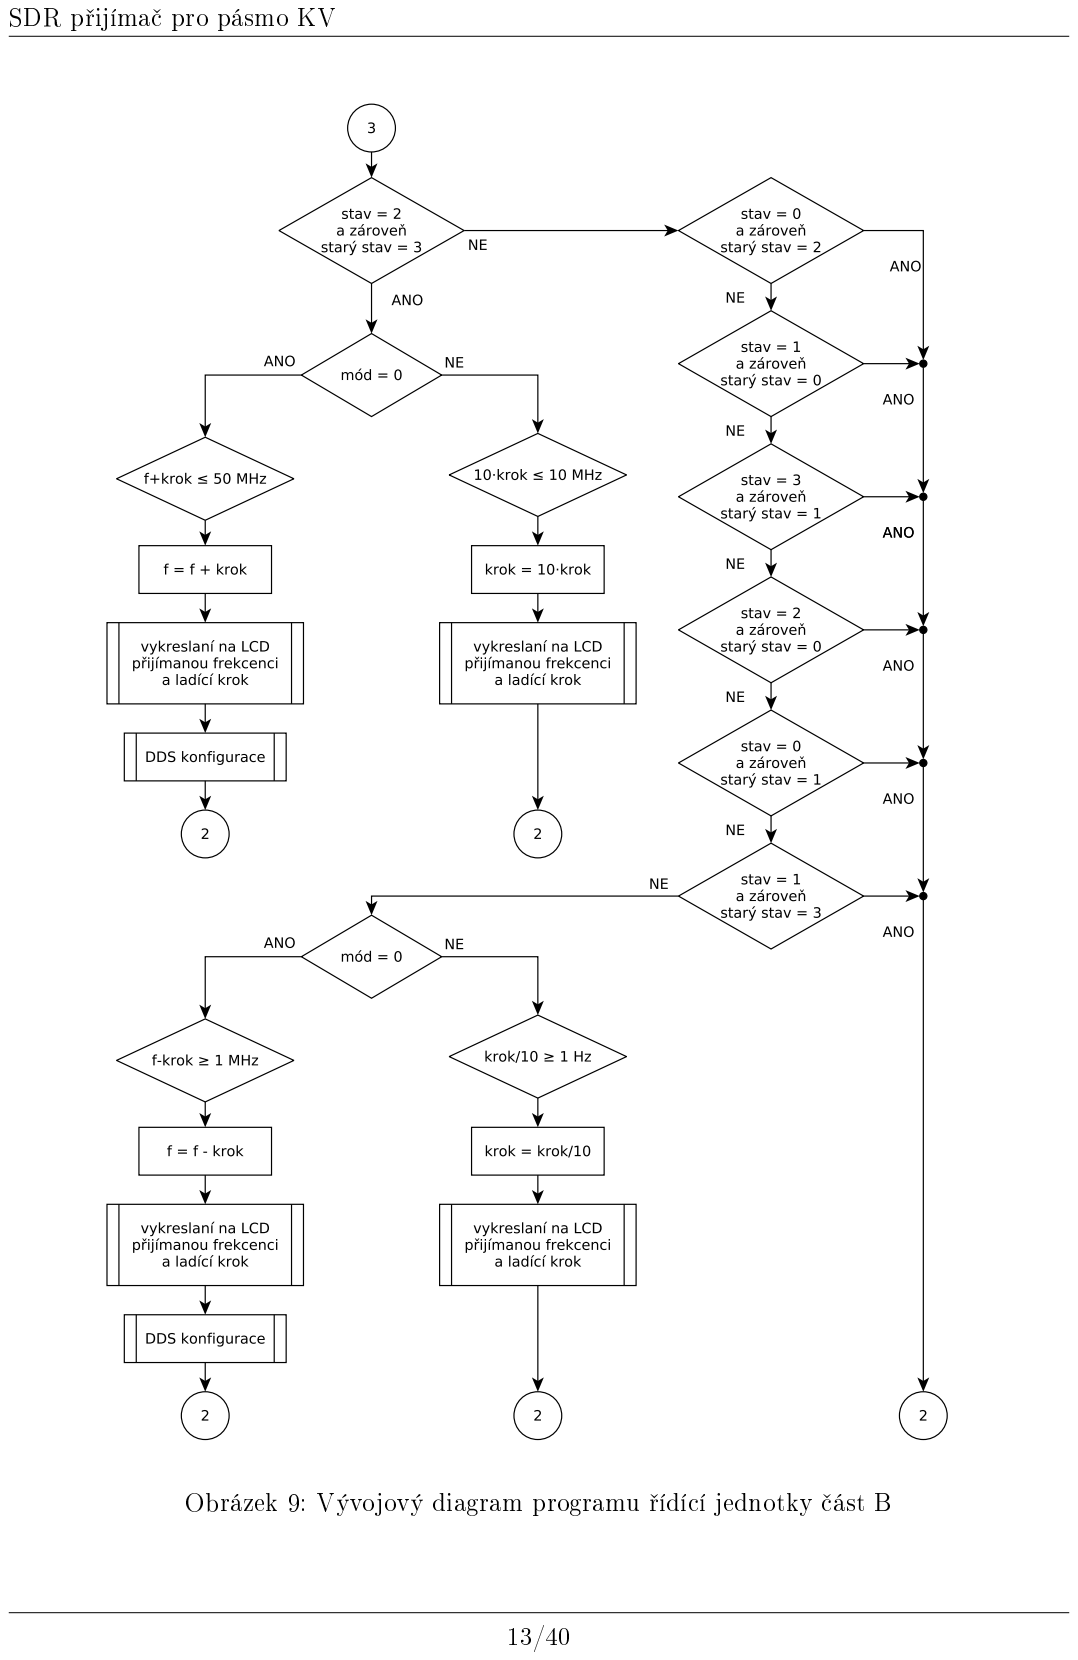
[picture p47: page 13]

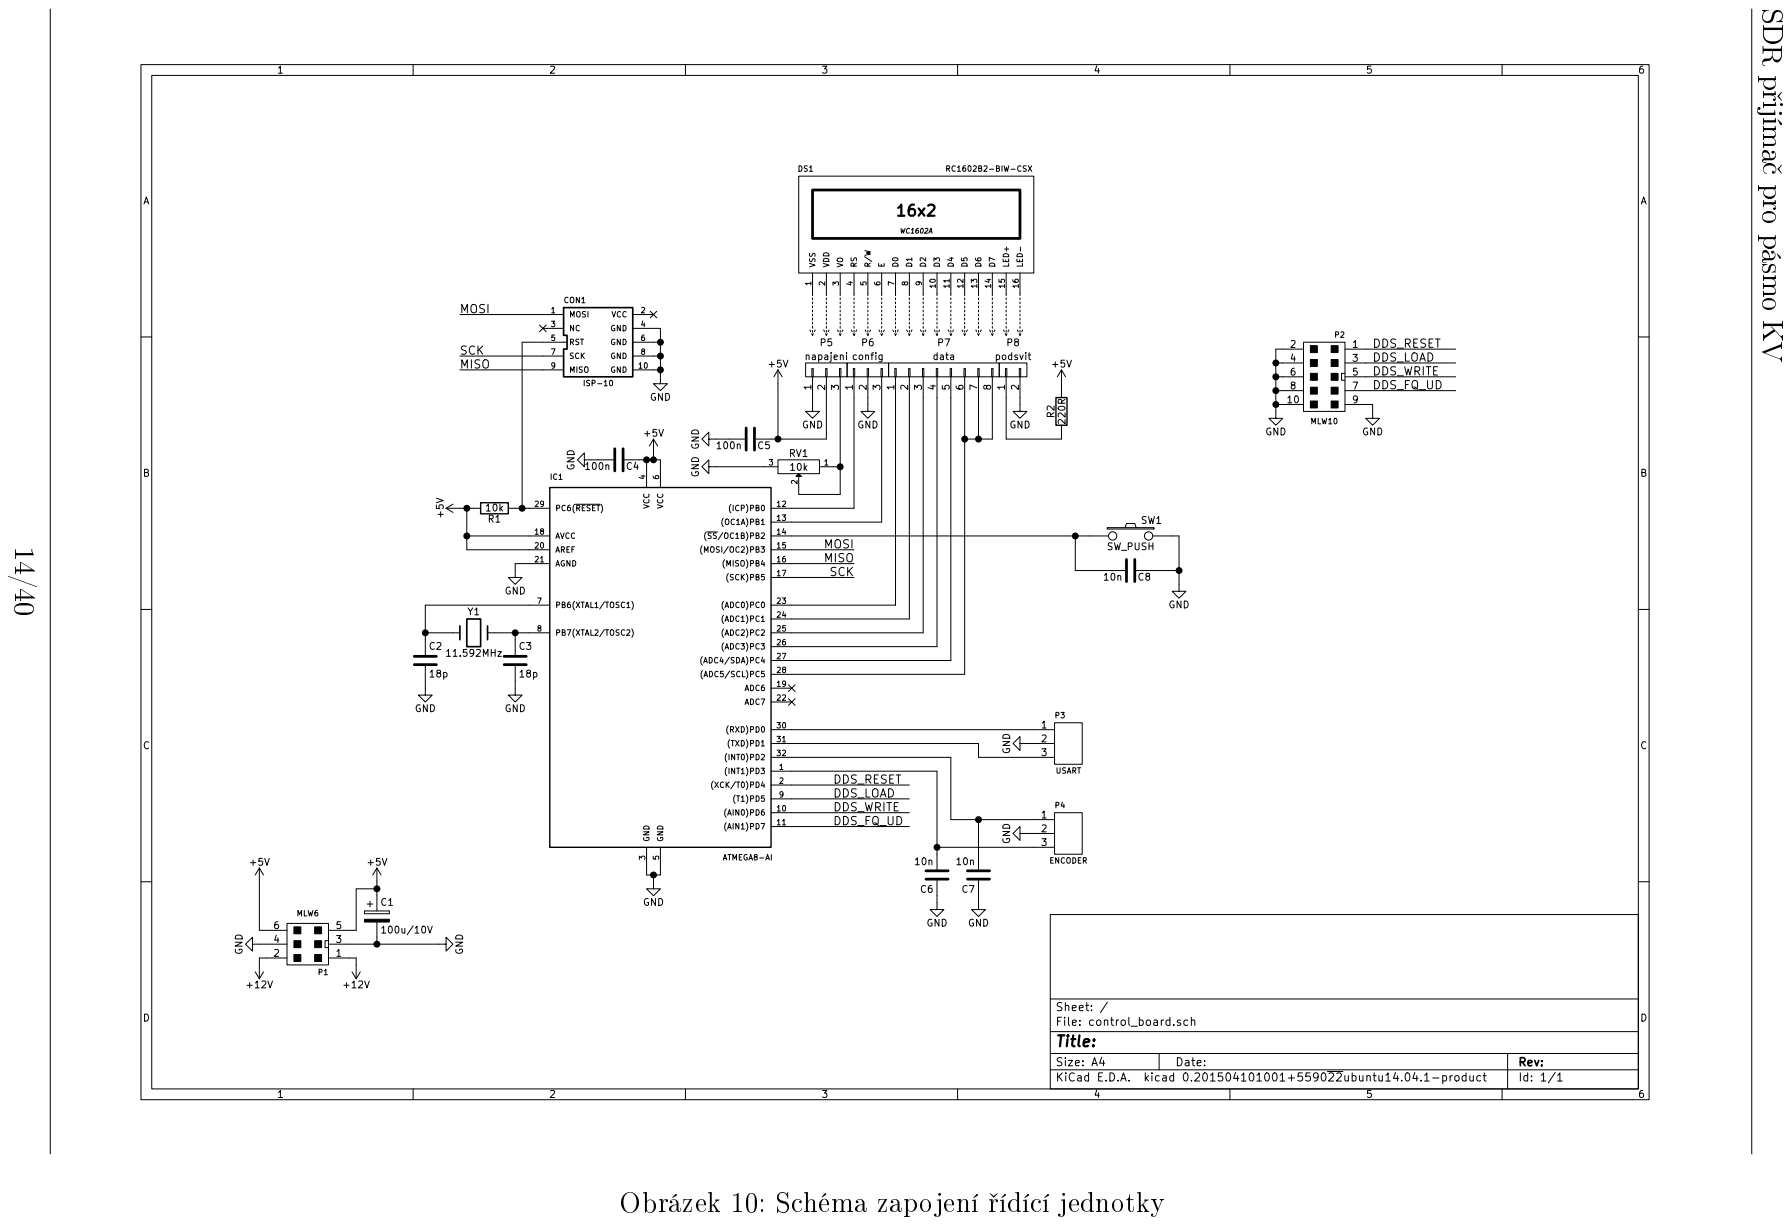
[picture p48: page 14]

SDR p°ijíma£ pro pásmo KV 1 2 3 4 5 6 1 2 3 4 5 6 ABCD ABCD Date: KiCad E.D.A. kicad 0.201504101001+559022ubuntu14.04.1-product Size: A4 Rev:

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

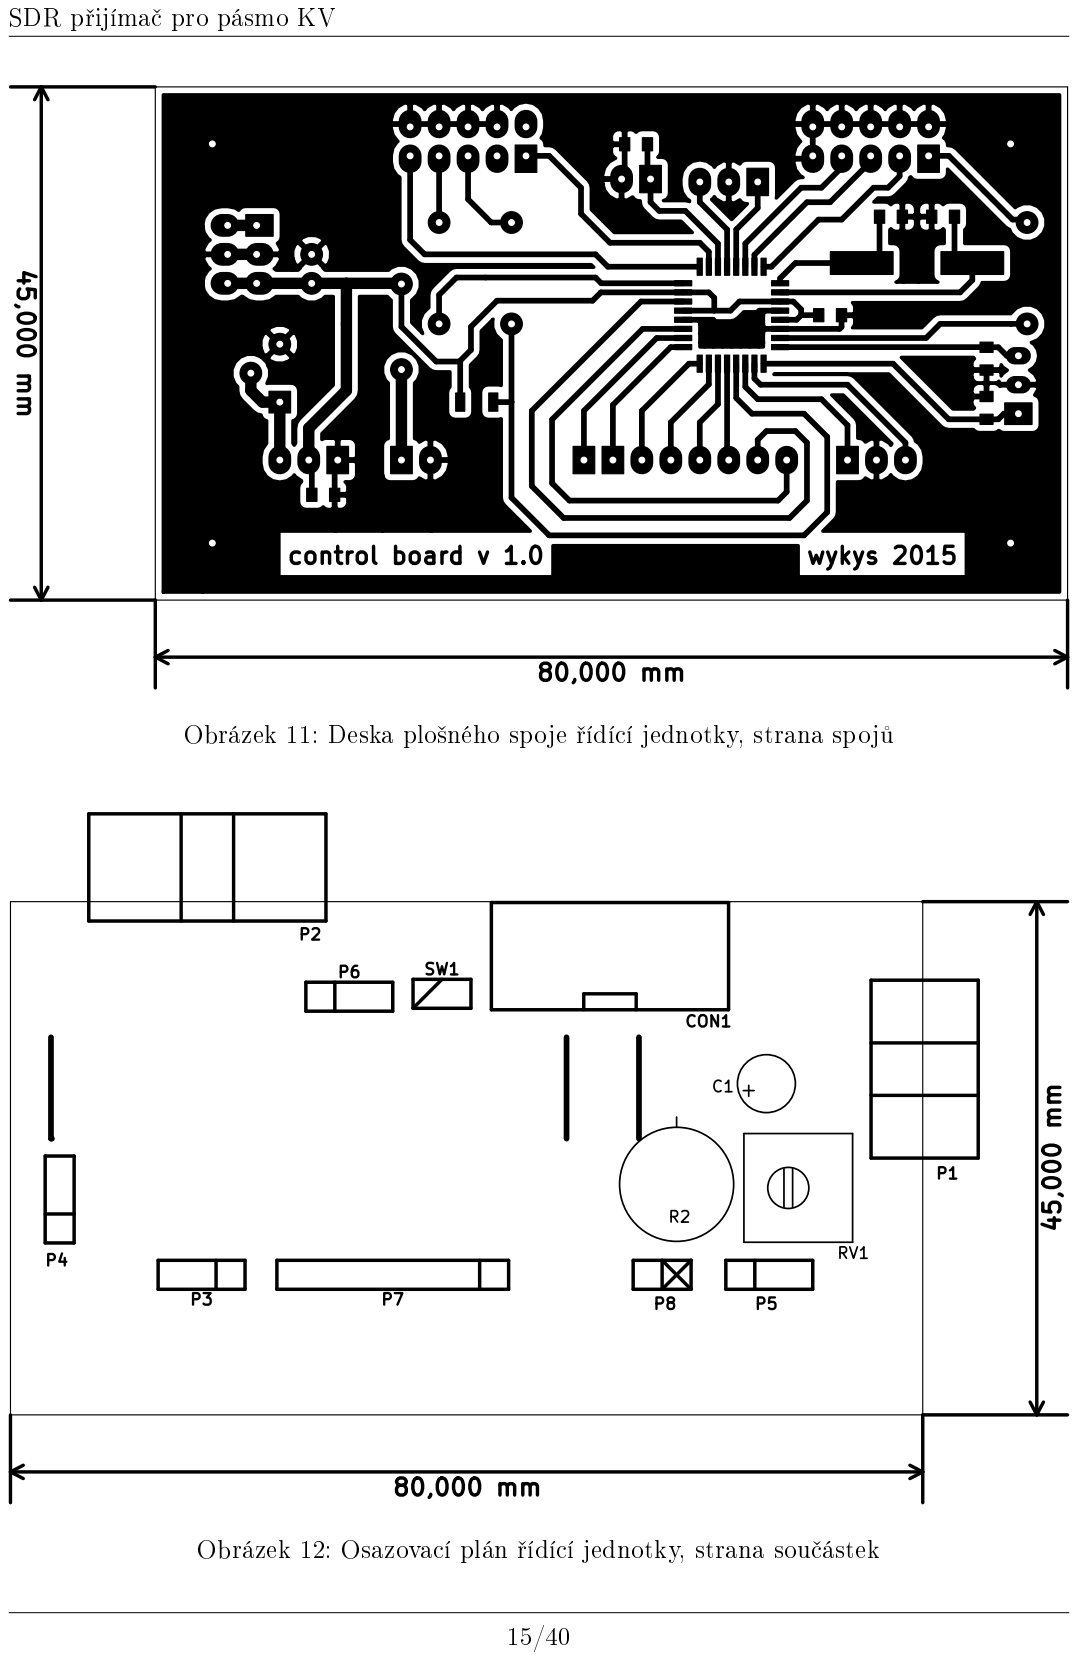
[picture p49: page 15]

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

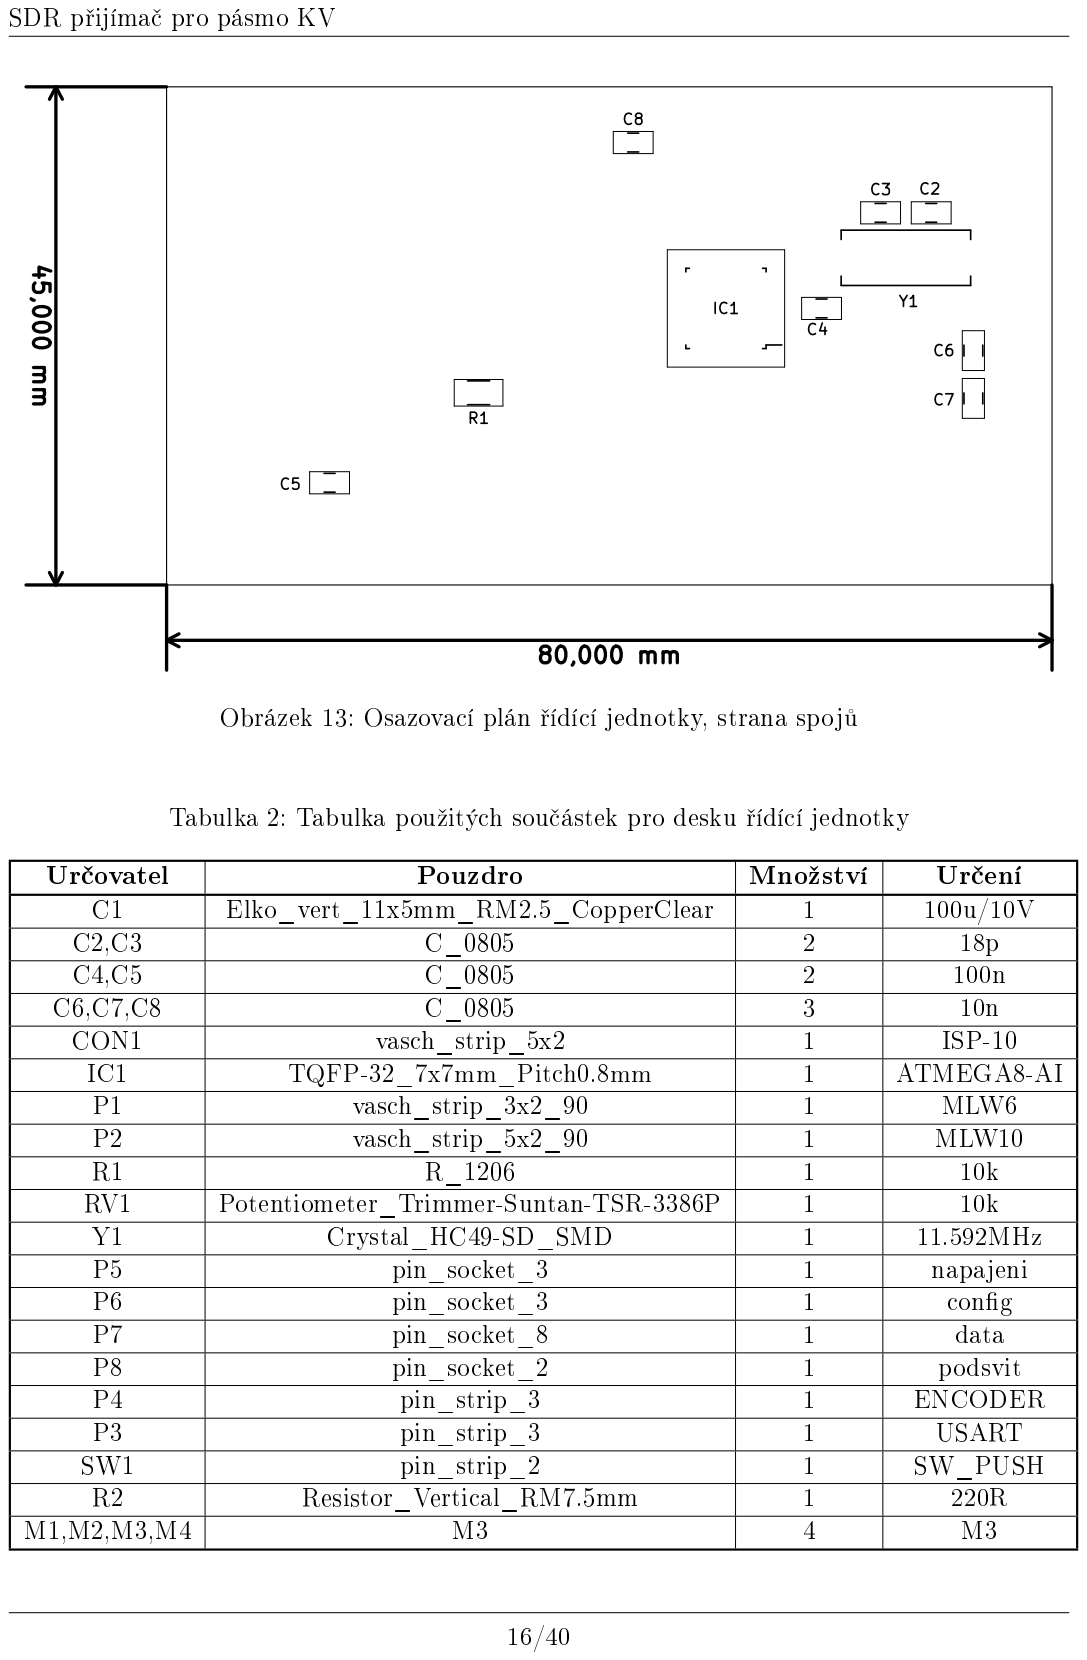
[picture p50: page 16]

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

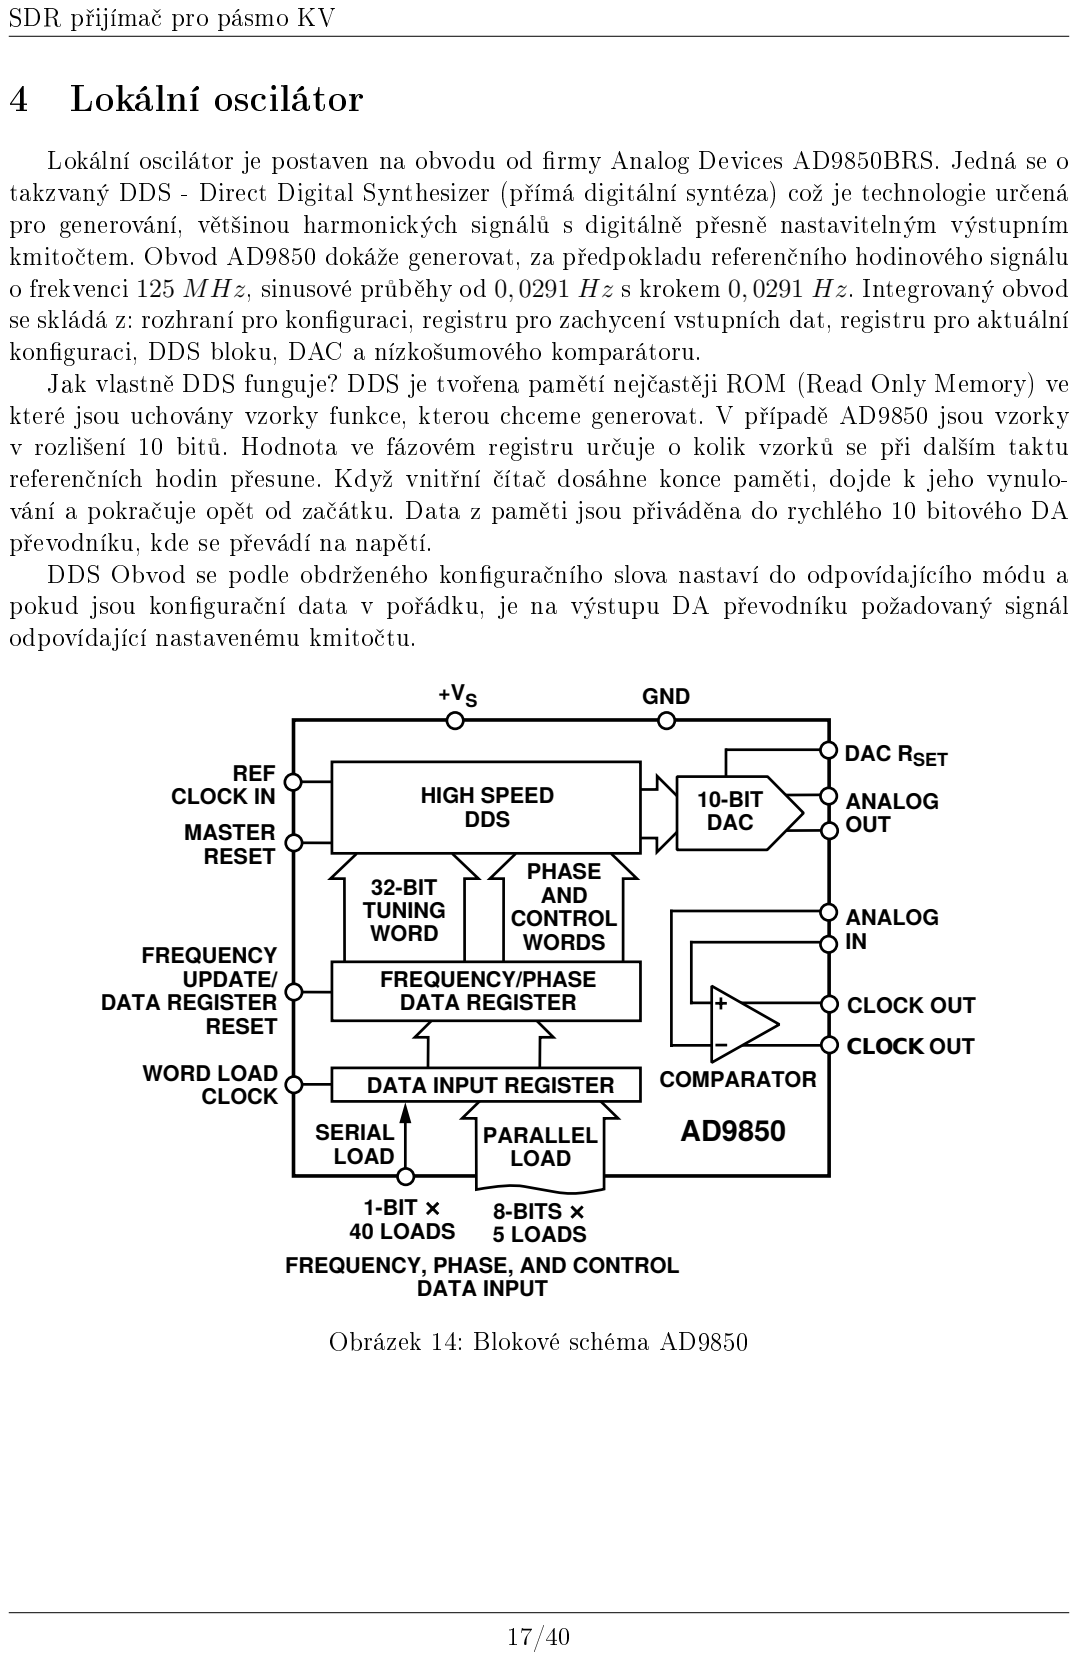
[picture p51: page 17]

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

SDR p°ijíma£ pro pásmo KV

4.1.3 Kongurace pomocí sériového rozhraní

Sériová kongurace na rozdíl od paralelní vyuºívá pro p°enos dat jen jeden datový signál a to sedmý bit D7 komunika£ní sb¥rnice ozna£ovaný jako LOAD a dále pouºívá signály CLK, FQ_UD a RESET. Aby bylo moºné komunikovat po sériové sb¥rnici je nutné p°ipojit datové signály komunika£ní sb¥rnice D0 a D1 na logickou úrove¬ H a signál D2 na logickou úrove¬
L. Sériová komunikace tedy probíhá po jednotlivých bitech. Na za£átku je op¥t nutné AD9850 restartovat, p°ivedením logické úrovn¥ H na signál RESET po dobu alespo¬ p¥ti period hodinového signálu. Dále je t°eba inicializovat sériovou komunikaci. Inicializace probíhá p°ivedením pulsu na signál CLK o minimální ²í°ce 3, 5 ns po£káním alespo¬ 3, 5 ns a p°ivedením pulsu minimální ²í°ky 7 ns na FQ_UD. Po této inicializaci následuje p°enos kongura£ního slova. Zápis kongura£ního slova probíhá následovn¥. Na signál LOAD nastavujeme jednotlivé kongura£ní bity (od LSb do MSb). Kdyº je na signálu LOAD stabilní hodnota aktuáln¥ p°ená²eného bitu, tak vy²leme puls na CLK ²iroký alespo¬ 3, 5 ns. P°i náb¥ºné hran¥ se zapí²e bit do registru pro zachycení kongura£ního slova. Poté £ekáme minimáln¥ 3, 5 ns, b¥hem tohoto intervalu se inkrementuje ukazatel do registru pro zachycení kongura£ního slova o jedni£ku. Tento postup opakujeme celkem £ty°icet krát. V záchytném registru je zapsáno celé kongura£ní slovo. Nyní se p°ivedením zapisovacího impulzu o minimální ²í°ce 7 ns na vstup FQ_UD, provede zápis do °ídícího registru DDS.

### 4.2 Popis funkce bloku

Jak jiº bylo zmín¥no vý²e, pro správnou funkci generátoru DDS, je pot°eba pouºít stabilní zdroj hodinového signálu. Z tohoto d·vodu je pouºit stabilní krystalový oscilátor CFPS-73-100M který dodává kmito£et 100 MHz. Signál generovaný krystalovým oscilátorem je v²ak sinusového pr·b¥hu a pro pot°eby zdroje hodinového signálu pro DDS je ho pot°eba upravit. Tato úprava spo£ívá v p°ed°azeném tvarova£i, který je tvo°en rychlým hradlem NAND se Schmittovým vstupním obvodem a je zapojeno jako invertor. Jako vhodný typ hradla se ukázal obvod 74VHC1G132DTTG, coº je jedno hradlo NAND se Schmittovým vstupem v pouzd°e SOT 23-5. Pro zabezpe£ení ochrany obvodu DDS, je na vstup datových signál· p°ed°azen rychlý odd¥lova£ sb¥rnice 74F245. Analogový vystup je p°iveden k dolní propusti tvo°enou L1, C8 a C9. Tento ltr slouºí k potla£ení vy²²ích harmonických kmito£t·, které vznikají jako vedlej²í produkt digitální syntézy. Sou£asn¥ také upravuje impedanci pro koncový zesilovací stupe¬ realizovaný s tranzistorem KF630D. Jeho obvodové °e²ení je shodné se zesilovacím stupn¥m ve vstupním p°edzesilovacím selektivním zesilova£i. Transformátor TR1 je proveden na toroidním jád°e z hmoty N2, jako bilární vinutí se sedmi závity.

19/40

## 10u/50v C3

# 10u/50v +5V

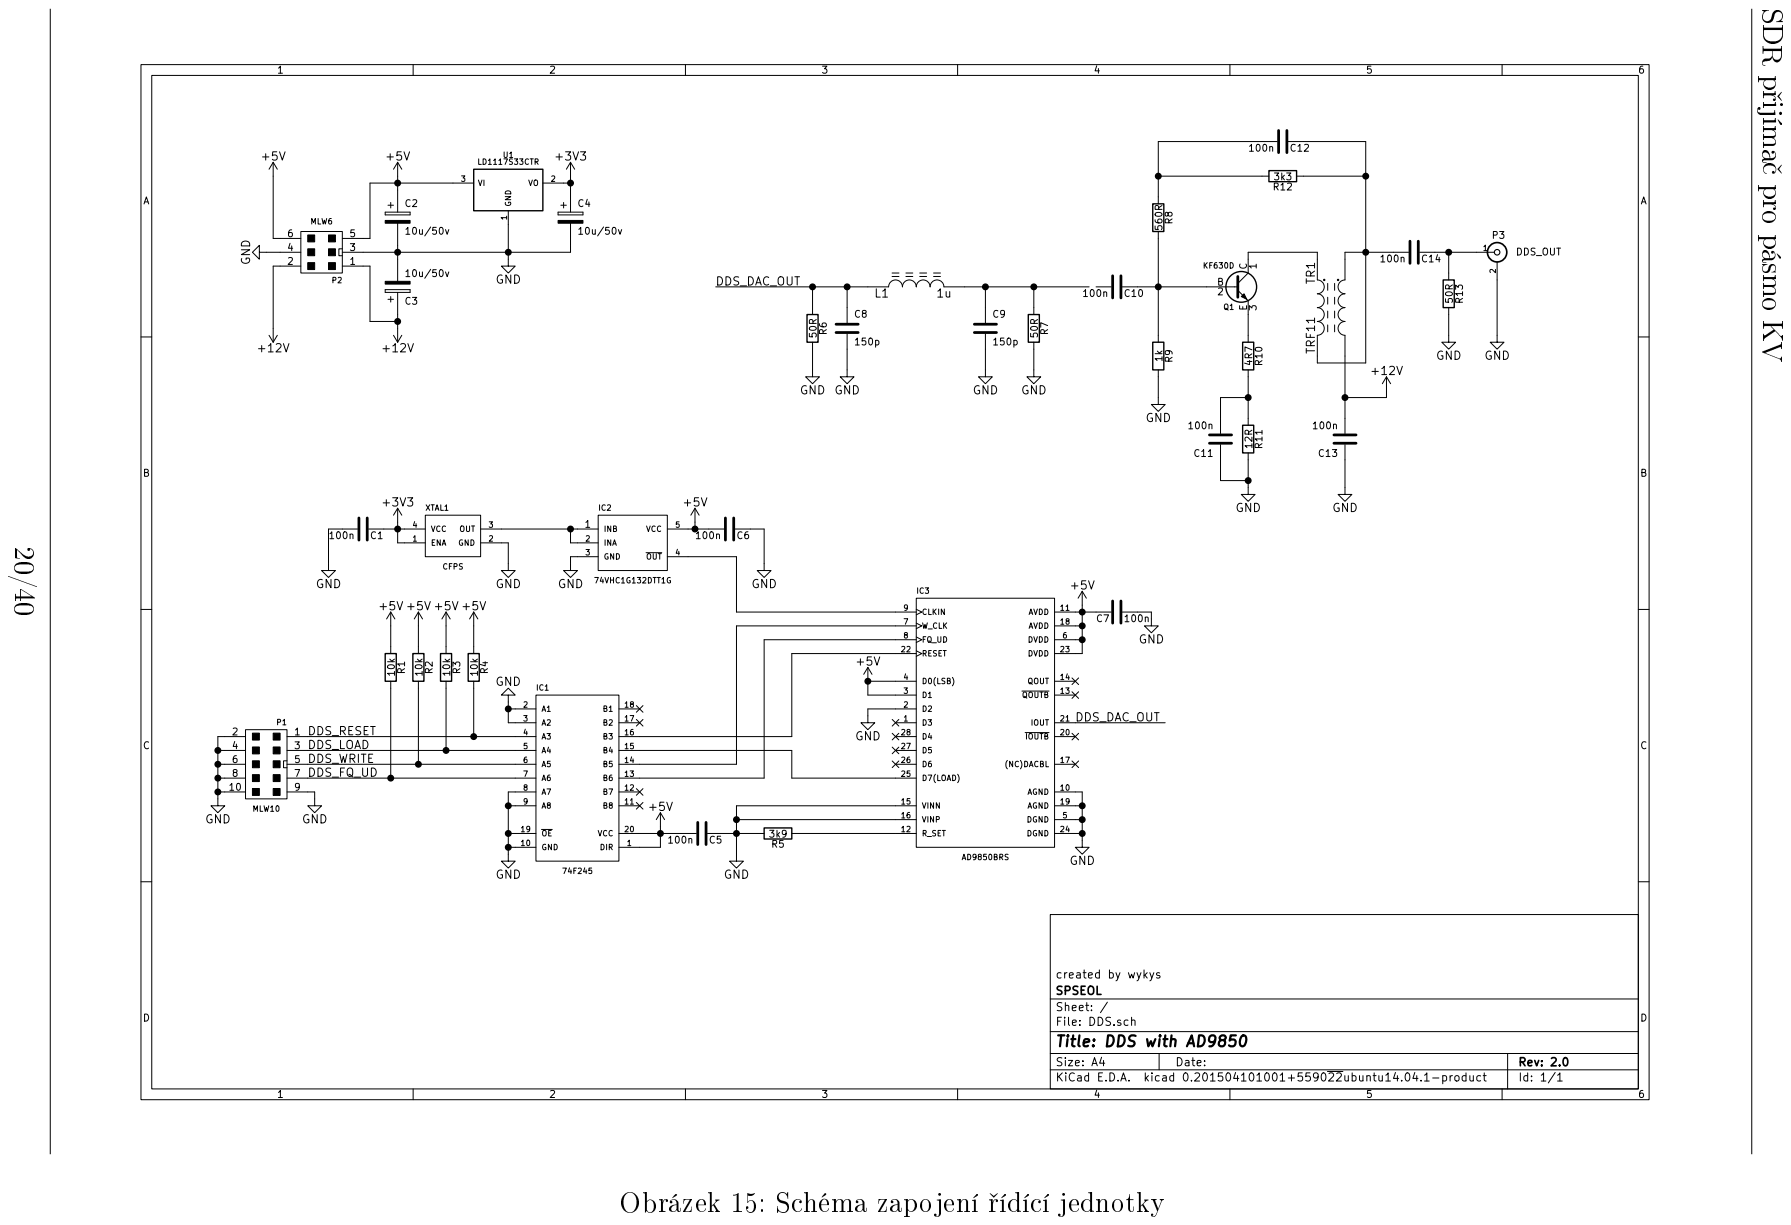
[picture p52: page 20]

SDR p°ijíma£ pro pásmo KV 1 2 3 4 5 6 1 2 3 4 5 6 ABCD ABCD Date: KiCad E.D.A. kicad 0.201504101001+559022ubuntu14.04.1-product Size: A4 Rev: 2.0

+5V ¹⁰k R¹ 10k R² 10k R³ 10k R⁴ +5V +5V +5V +5V

+5V Obrázek 15: Schéma zapojení °ídící jednotky

created by wykys
File: DDS.sch Sheet: / SPSEOL

Id: 1/1 Title: DDS with AD9850

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

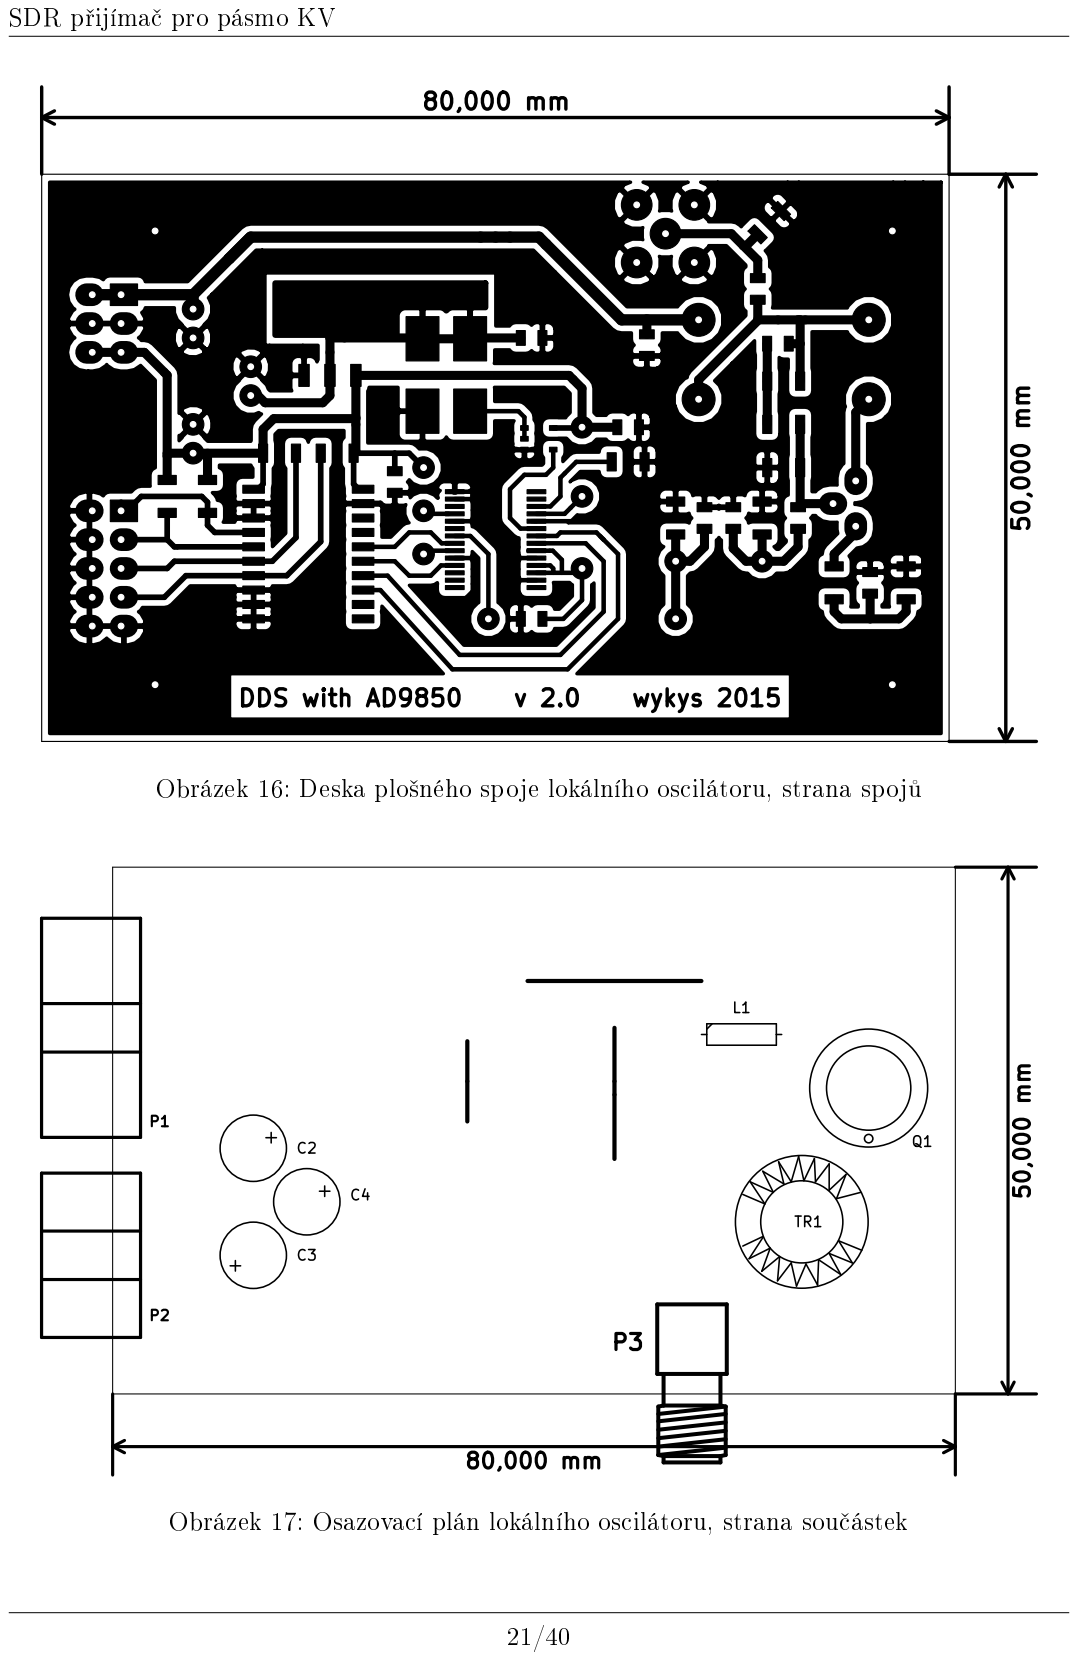
[picture p53: page 21]

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

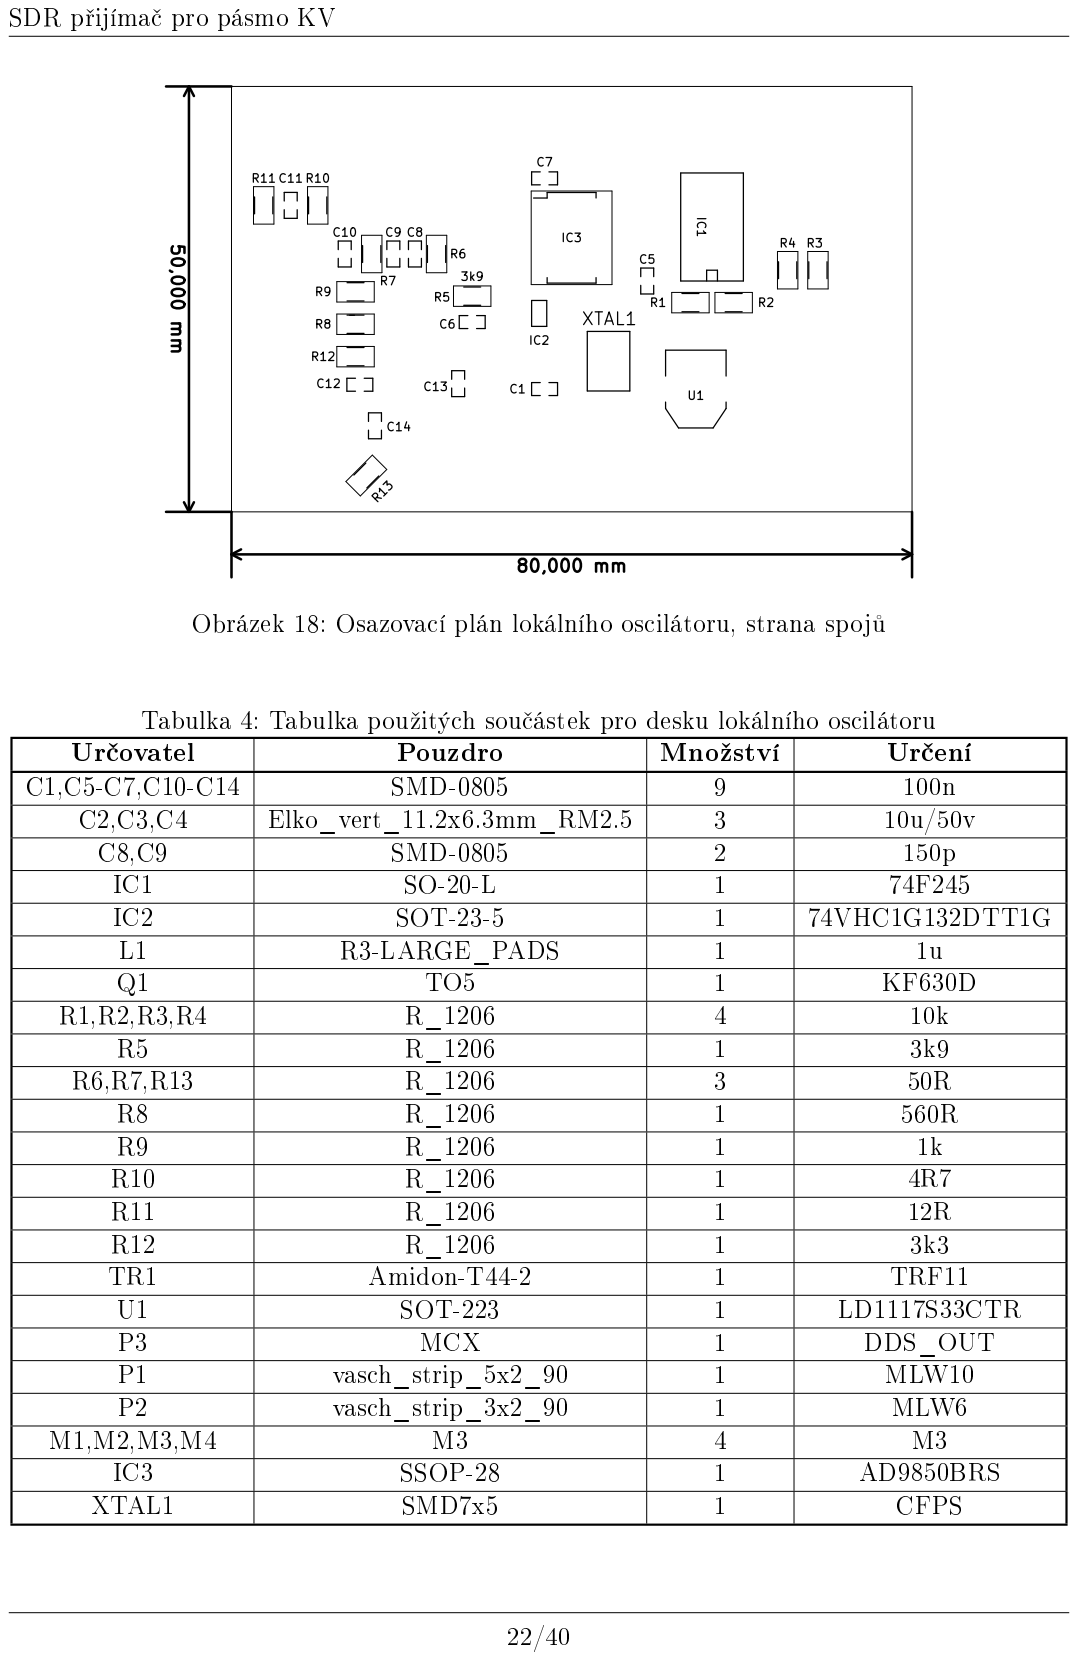
[picture p54: page 22]

SDR p°ijíma£ pro pásmo KV

## 5 Sm¥²ovací blok

Tento obvod má za úkol frekven£n¥ posunout p°ijímaný nap¥´ový signál do základního nízkofrekven£ního (audio) pásma, tak aby jej bylo moºné zpracovávat pomocí zvukové karty. Výstupem s tohoto modulu jsou dva signály I a Q navzájem posunuty o π
2

. Signály I a Q jsou
p°ivád¥ny na linkový vstup zvukové karty.

### 5.1 Popis funkce bloku

Do obvodu vstupují dva nap¥´ové signály, jeden s lokálního oscilátoru a druhý ze selektivního zesilova£e. Signál ze selektivního zesilova£e jde p°es rekonstruk£ní ltr s mezní frekvencí 35 MHz, který odstra¬uje vysokofrekven£ní ²um a vy²²í harmonické frekvence, které nepotla£il první rekonstruk£ní ltr po digitální syntéze.

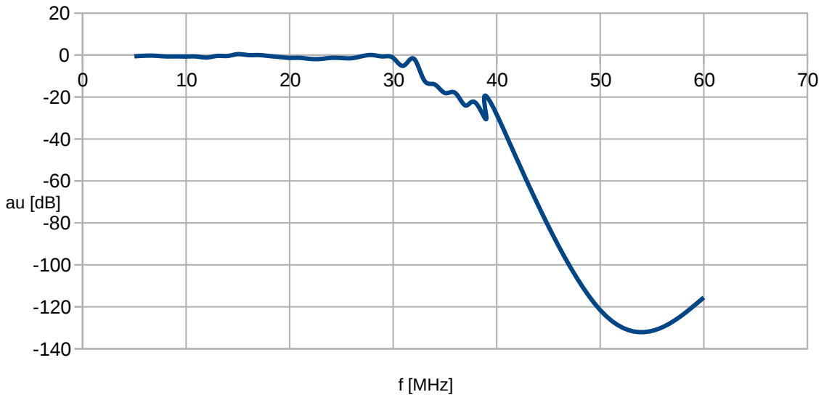
[picture p55: figure]
f [MHz]

Obrázek 19: Graf nap¥´ového p°enosu rekonstruk£ního ltru

Signál je p°iveden do diodového kruhového sm¥²ova£e, ten ale pot°ebuje, aby vstupní signál m¥l úrove¬ nejmén¥ 7 dBm. Proto je zesílen v t°ístup¬ovém zesilova£i, tvo°eném kaskádov¥ °azenými zesilova£i, pracujícími ve t°íd¥ A. Nejprve se signál zesiluje nap¥´ov¥ v prvních dvou stupních postavených s tranzistory KF190, poté je signál výkonov¥ zesílen v zesilova£i zaloºeném op¥t na tranzistoru KF630D. Tento zesilova£ je op¥t obdobný, jako vstupní zesilova£ popsaný ve druhé kapitole, s tím rozdílem, ºe transformátor je tentokrát navinutý na toroidním jádru s materiálu N5. Po zesílení je signál p°iveden do jiº zmín¥ného diodového kruhového sm¥-²ova£e, zaloºeném na rychlých Schottkyho diodách KAS44 a transformátorech T4 a T5. KAS44 je diodový sm¥²ova£. Uvnit° KAS44 se nacházejí £ty°i vyváºené diody. Po smí²ení je signál p°iveden na paralelní pásmovou propust, skládající se ze dvou rezonan£ních obvod·. První rezonan£ní obvod se skládá z kondenzátor· C17, C18 a T2 a je nalad¥n na 5, 7 MHz. Druhý

23/40

SDR p°ijíma£ pro pásmo KV

rezonan£ní obvod se skládá z kondenzátor· C12, C13 a transformátoru T1. Tento obvod rezonuje na kmito£tu 6, 0 MHz. Paralelní obvody spojuje dohromady vazební kondenzátor C16. Za touto pásmovou propustí je tedy mezifrekven£ní signál o kmito£tu 5, 7 − 6, 0 MHz. Tento mezifrekven£ní signál je dále zpracováván. K°emíkový oscilátor XTAL1 rezonuje na frekvenci 24, 0 MHz a vytvá°í sinusové nap¥tí. Sinusové nap¥tí z k°emíkového oscilátoru je op¥t vytvarováno tvarova£em impulz· tvo°eným integrovaným obvodem IC1. Poté upravený hodinový signál pokra£uje do integrovaného obvodu U1. U1 je obvod 74F74, který má v sob¥ integrované dva klopné obvody typu D. U1 je zapojen jako 2b Johns·v £íta£, to znamená, ºe na výstupu generuje dva signály navzájem posunuté o π
2

. B¥hem £ty° takt· oscilátoru se na výstupu Johnsova £íta£e prost°ídají v²echny moºné stavy. Výstup Johnsova £íta£e je pouºit jako adresový vstup pro obvod U3. U3 je digitáln¥ °ízený p°epína£ zaloºený na technologii MOS-FET. U3 postupn¥ p°epíná své 4 polohy. Na vstupu p°epína£e je p°iveden mezifrekven£ní signál. Na spína£e obvodu U3 jsou p°ipojeny kondenzátory C22, C25, C26 a C28. Slouºí zde jako analogová pam¥´. Kaºdý kondenzátor je jednou za periodu mezifrekvence sepnut a nabíjen. P°epínání poloh spína£· a následné nabíjení kondenzátor· jsou posunuty v £ase o π
2

. Tím, ºe jsou kondenzátory spínány dochází ke sm¥²ování. Jedná se o podobnou my²lenku jako p°i spínání diody, s tím rozdílem, ºe kondenzátor je nabíjen a pak se po zbytek £asu vybíjí. Na kondenzátorech jsou tedy £ty°i nap¥´ové pr·b¥hy posunuté o π
2

v nízko frekven£ním pásmu. Proto se tomuto zapojení °íká kvadraturní detektor. (Podle svého objevitele n¥kdy téº nazývaný Tayloe detector). Vzhledem k tomu ºe na výstupu jsou signály posunuty o π
2

, tak je zjevné, ºe dva z nich nesou redundantní informaci. Tedy na kondenzátoru C22 je nap¥´ový pr·b¥h posunut o π
2

π. Na
kondenzátoru C25 je ten samý pr·b¥h ale posunutý o 3π
2

. Tedy v podstat¥ invertovaný pr·b¥h co je na kondenzátoru C22. Proto jsou tato dv¥ nap¥tí p°ivedeny do diferenciálního zesilova£e postaveném na opera£ním zesilova£i U4. U4 je ²pi£kový opera£ní zesilova£ AD8055 s nízkým zkreslením a ²umem, pracující aº do frekvence 300 MHz. Díky tomu, ºe jsme se£etli redundantní signál se signálem který jsme pot°ebovali, tak jsme dostali na výstupu zesílený signál. Obdobn¥ se zpracují zbylé dva signály po kvadraturním sm¥²ování z kondenzátor· C26 a C28. Na t¥chto kondenzátorech jsou nap¥´ové pr·b¥hy posunuty o 0π a π. Za diferenciálními zesilova£i jdou tantalové kondenzátory C34 a C35, které slouºí k odd¥lení stejnosm¥rné sloºky od st°ídavých nap¥´ových signál· a sniºují oset p°i následné digitalizaci signálu ve zvukové kart¥. Za kondenzátory C34 a C35 jsou tedy jiº signály I a Q, které slouºí k softwarové demodulaci.

24/40

# 3k3 4R⁷ R¹³ 12R R¹⁴ C24

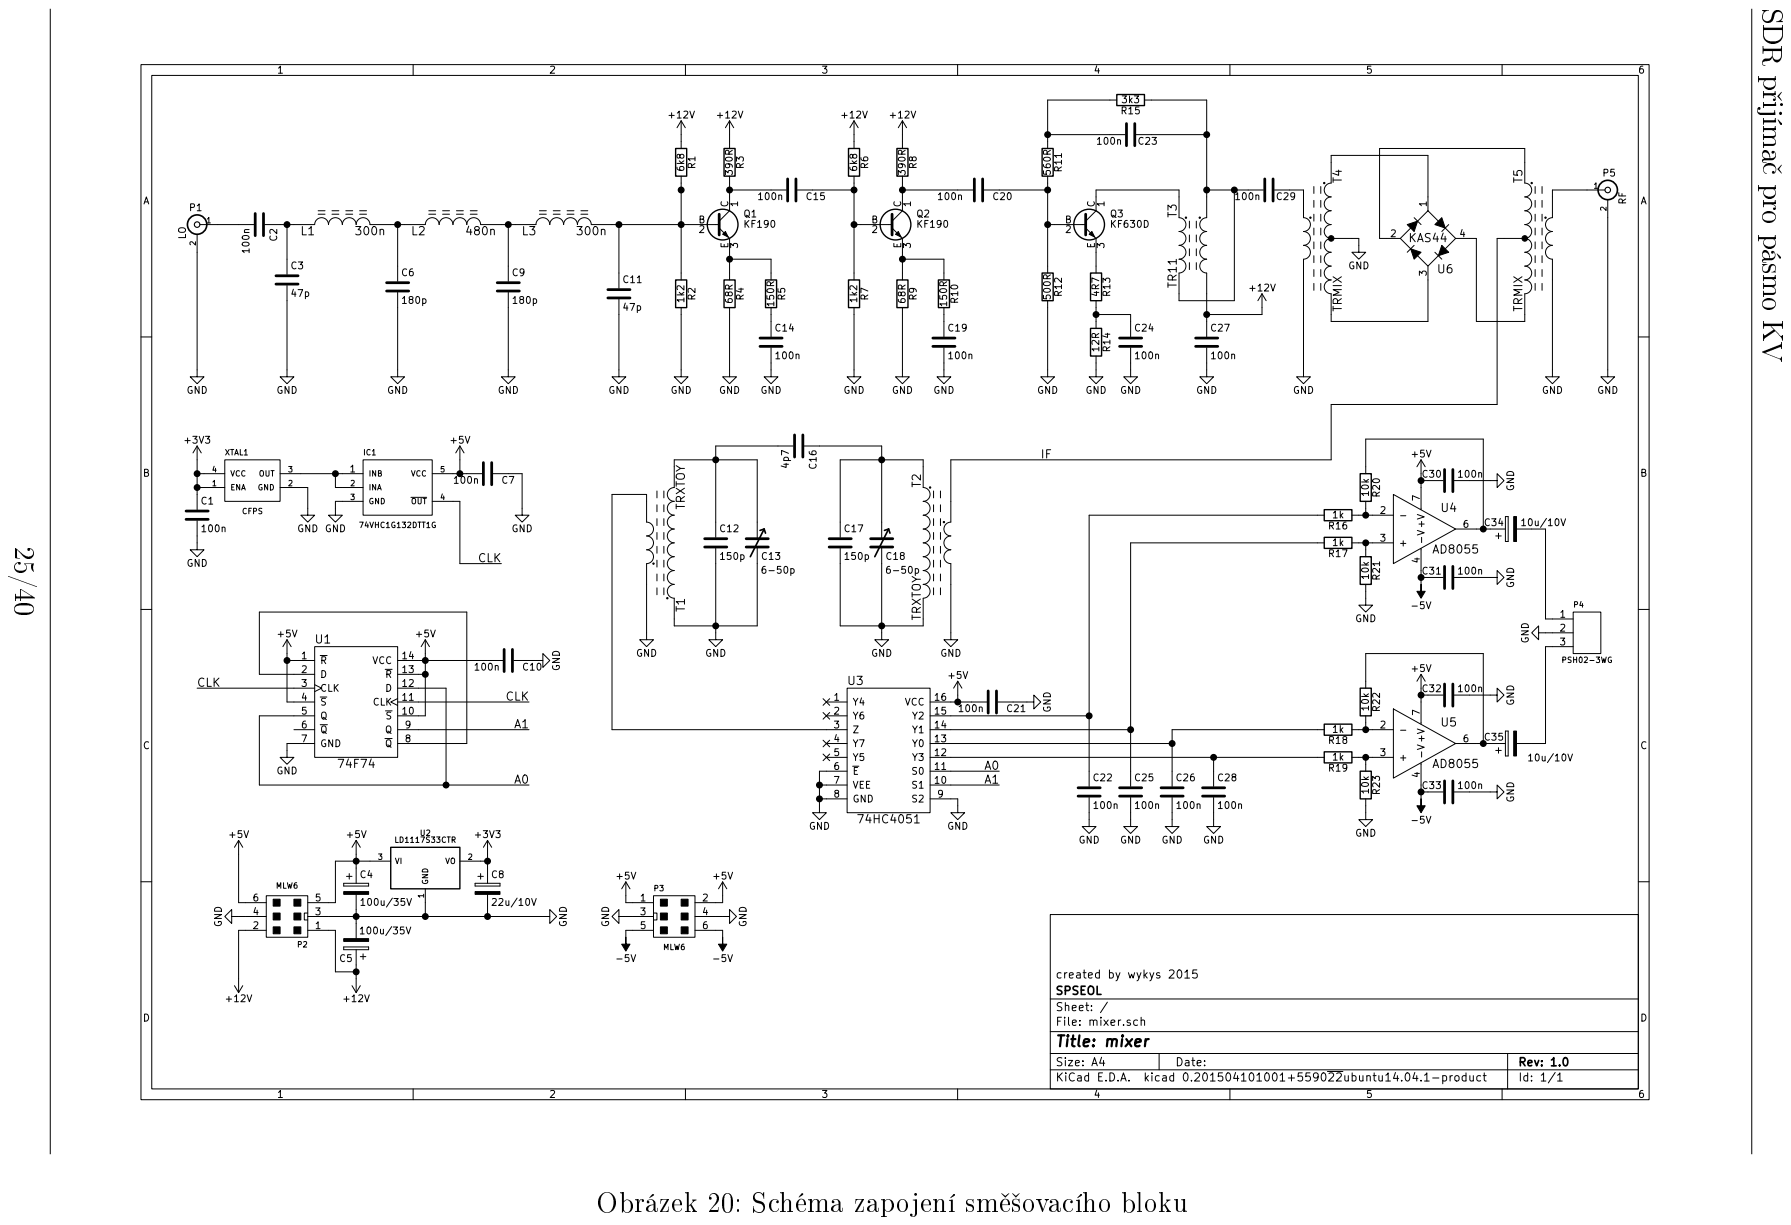
[picture p56: page 25]

SDR p°ijíma£ pro pásmo KV 1 2 3 4 5 6 1 2 3 4 5 6 ABCD ABCD Date: KiCad E.D.A. kicad 0.201504101001+559022ubuntu14.04.1-product Size: A4 Rev: 1.0

Id: 1/1 Title: mixer File: mixer.sch Sheet: / SPSEOL

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

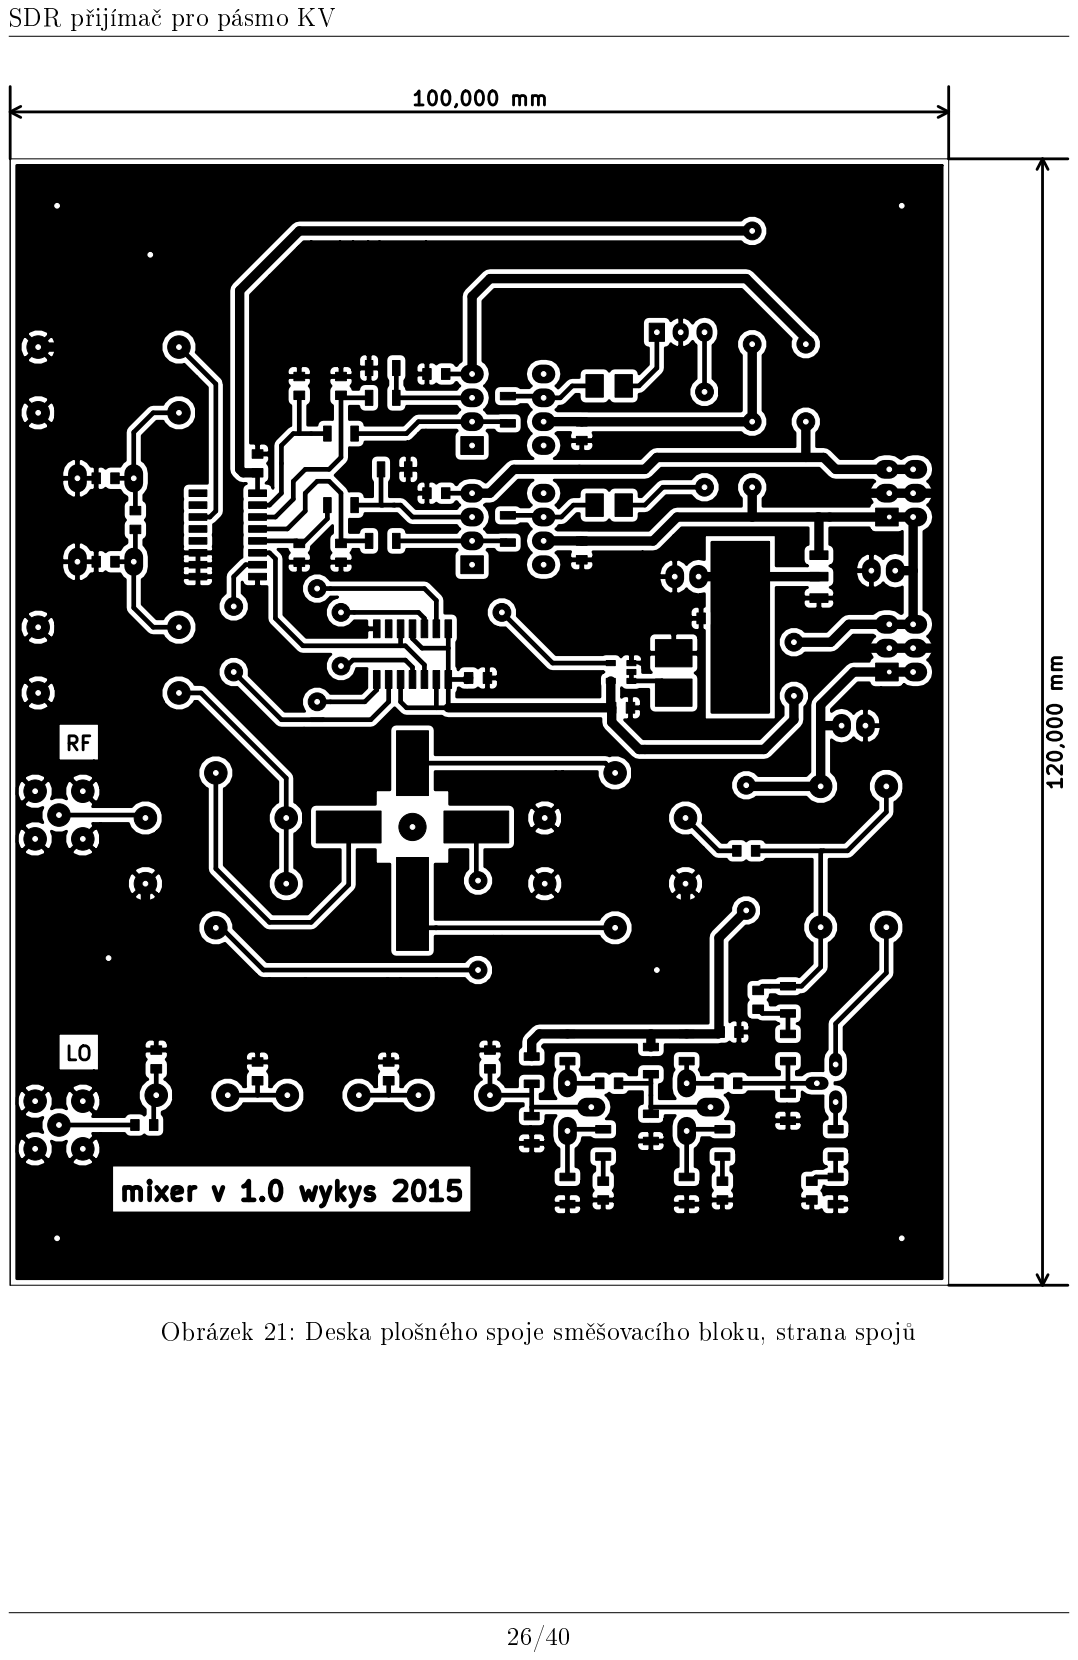
[picture p57: page 26]

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

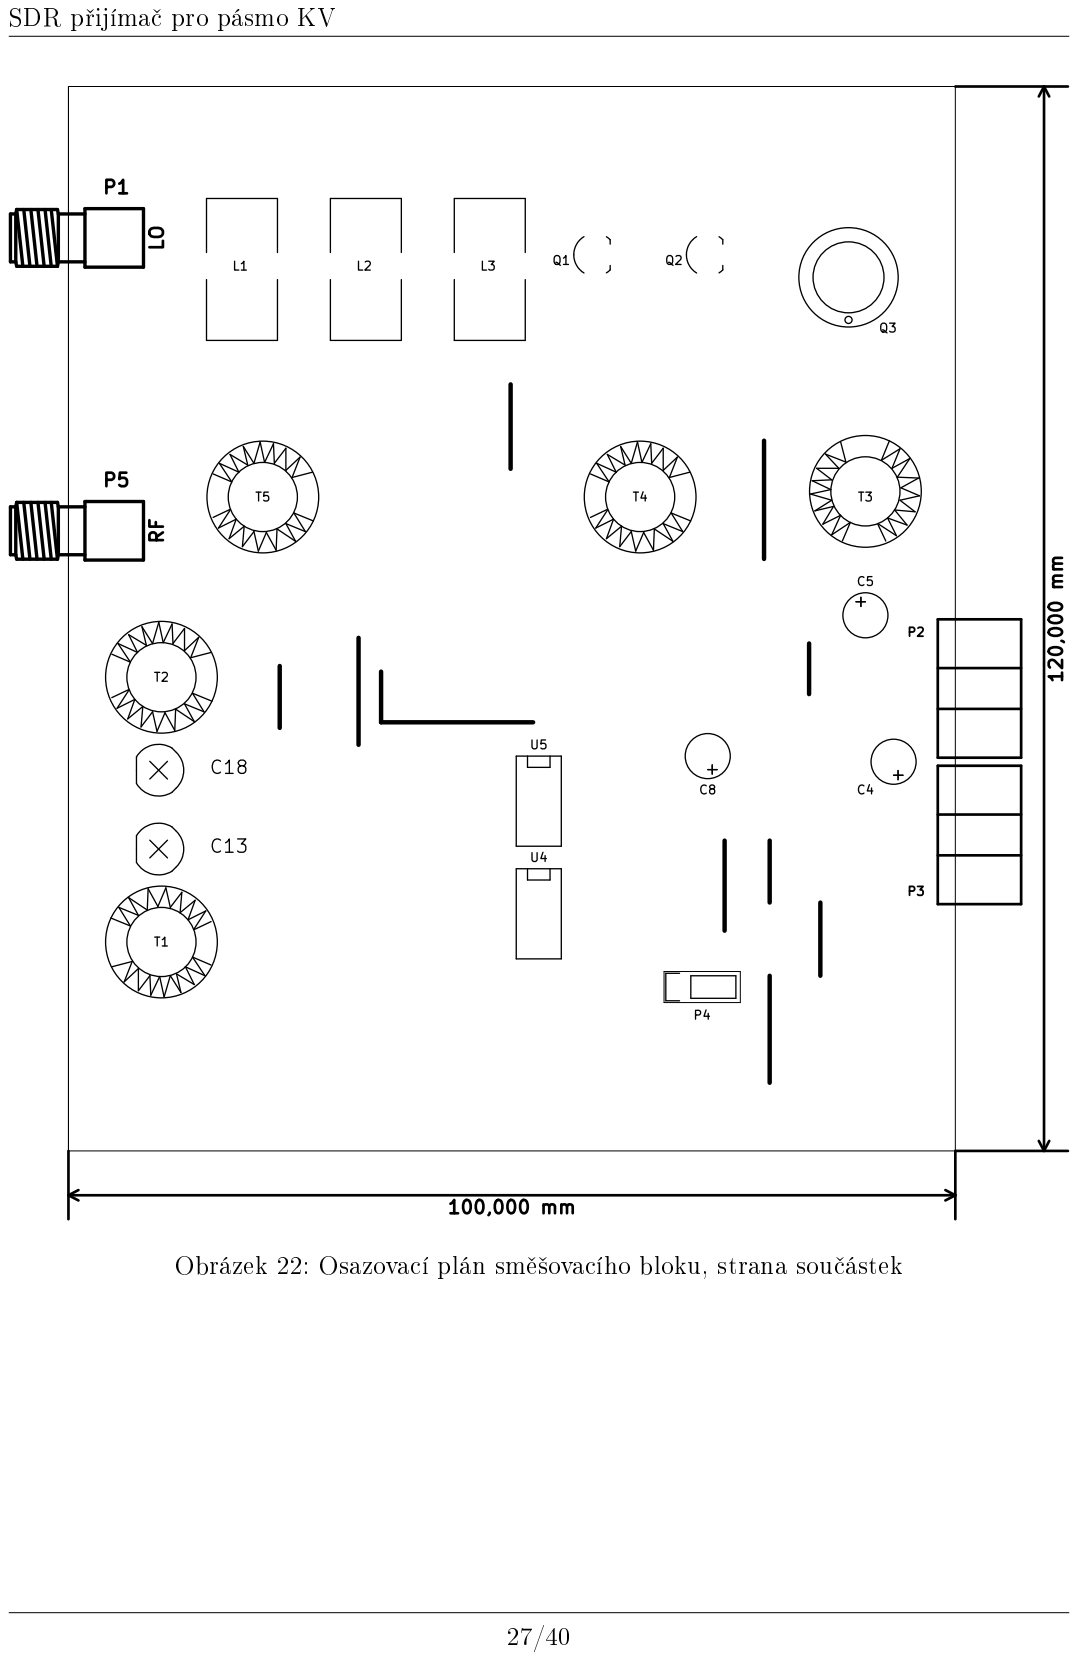
[picture p58: page 27]

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

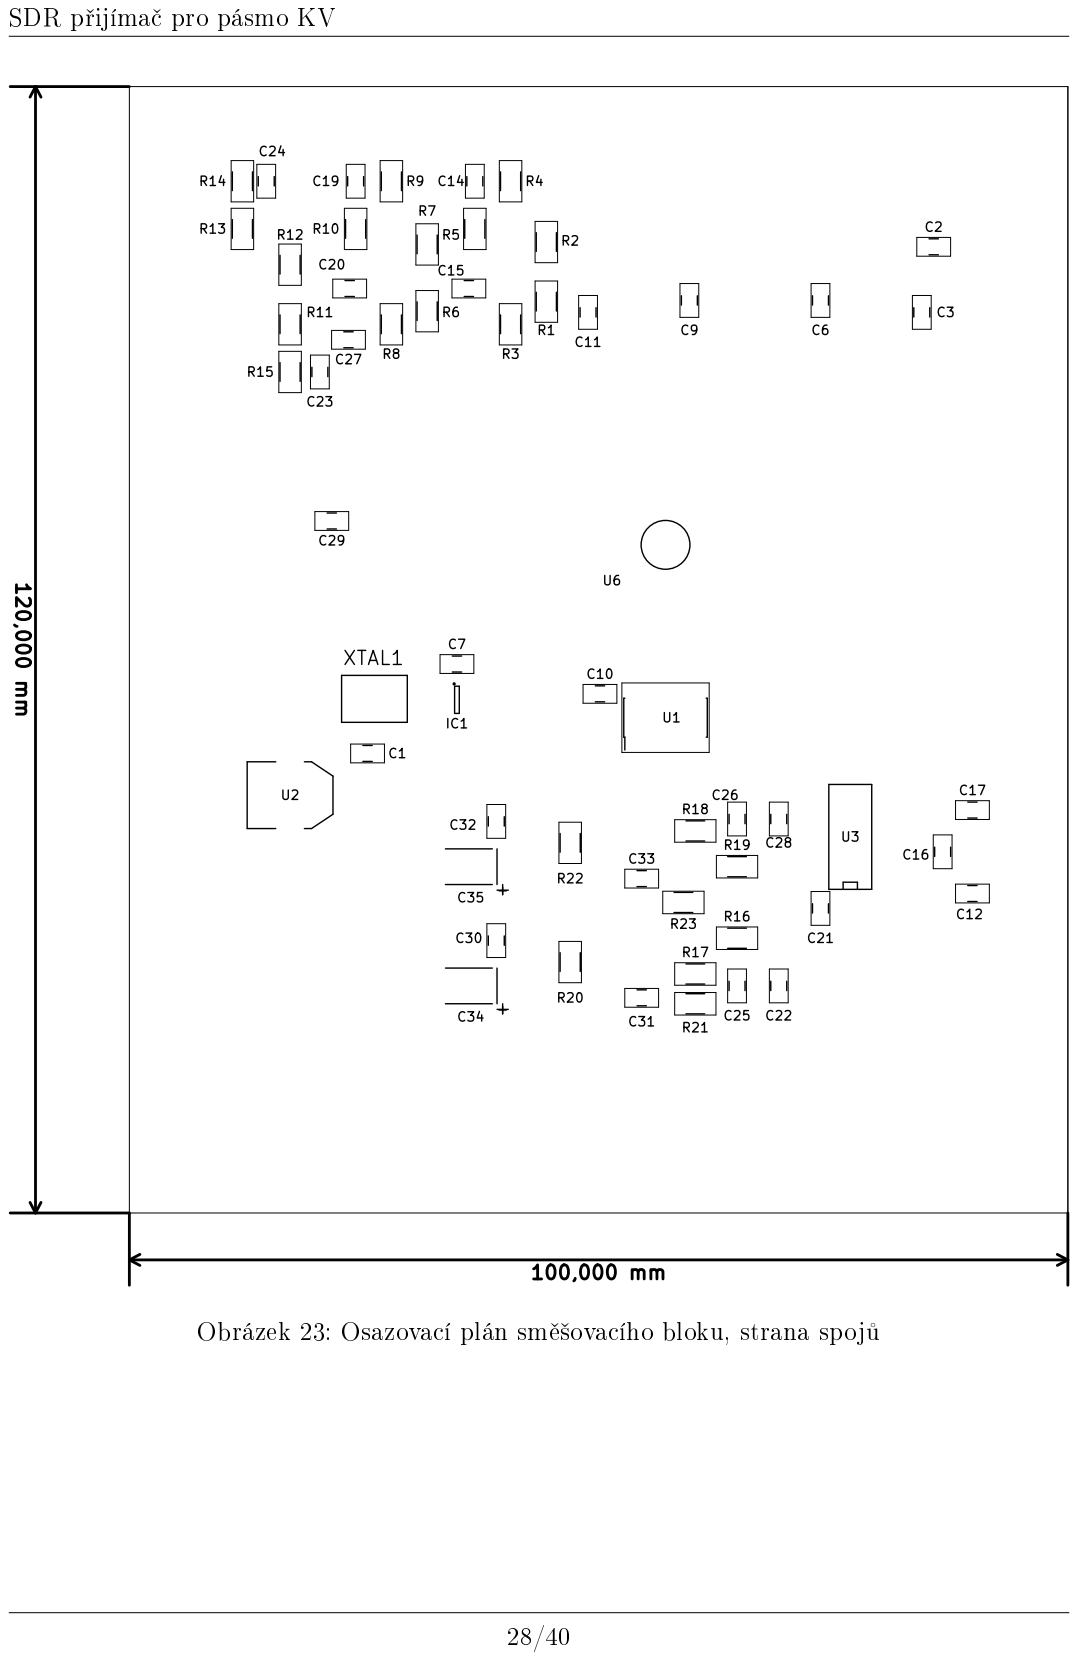
[picture p59: page 28]

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

100n | +5V -5V +12V
-5V | -5V GND | GND 1 | 2 3 | 4 5 | 6

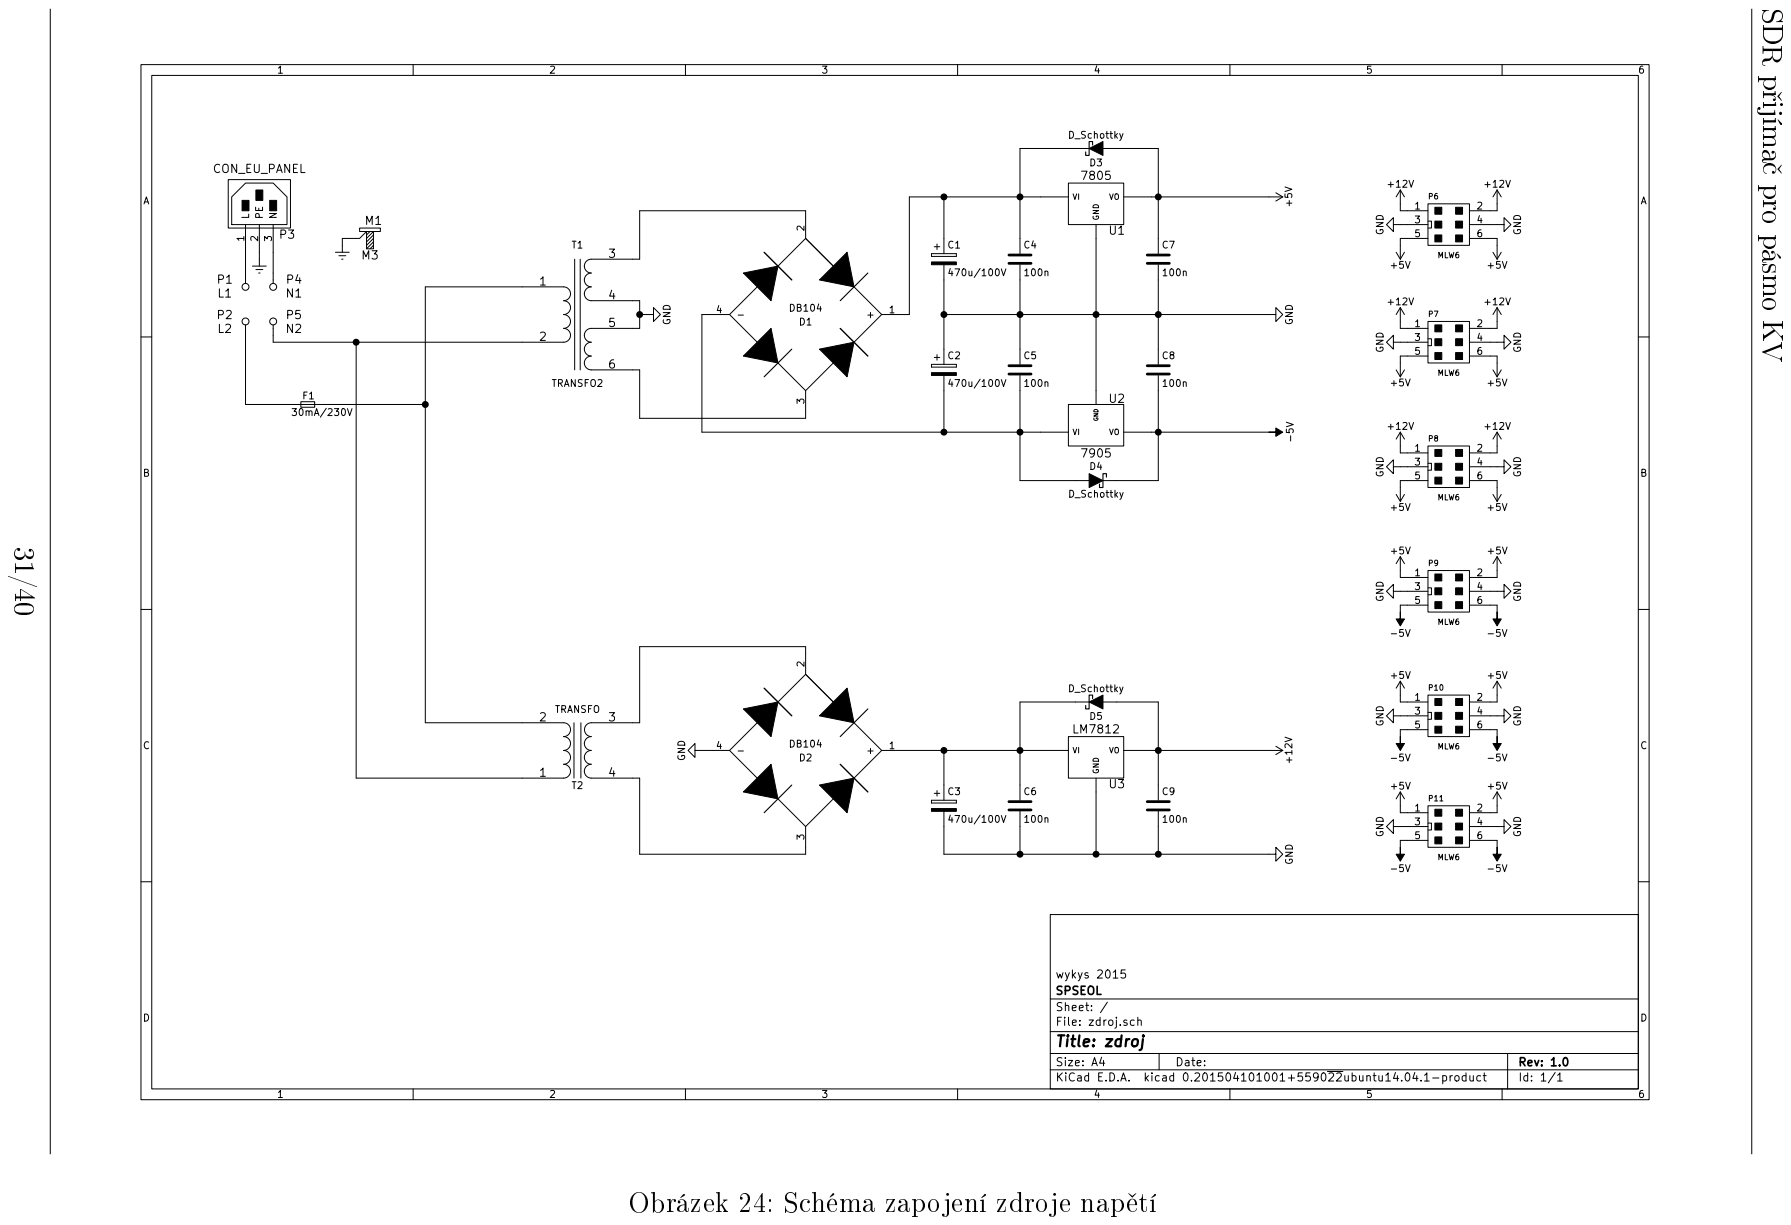
[picture p60: page 31]
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

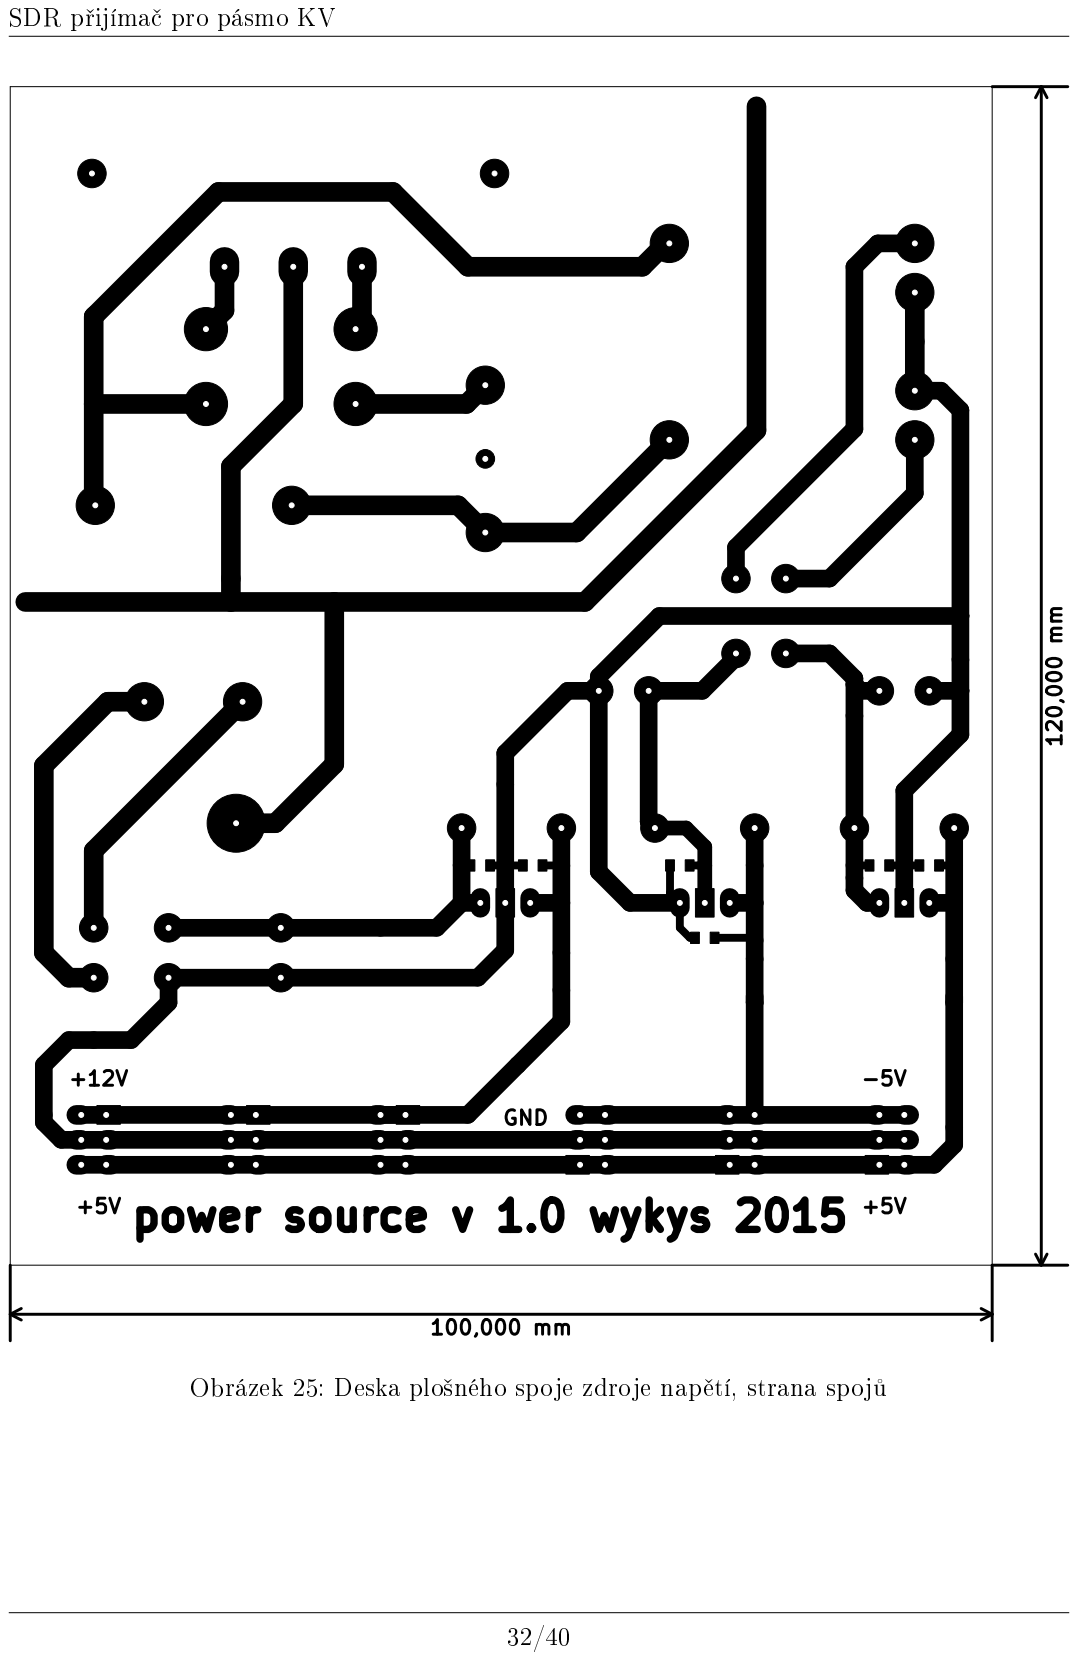
[picture p61: page 32]

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

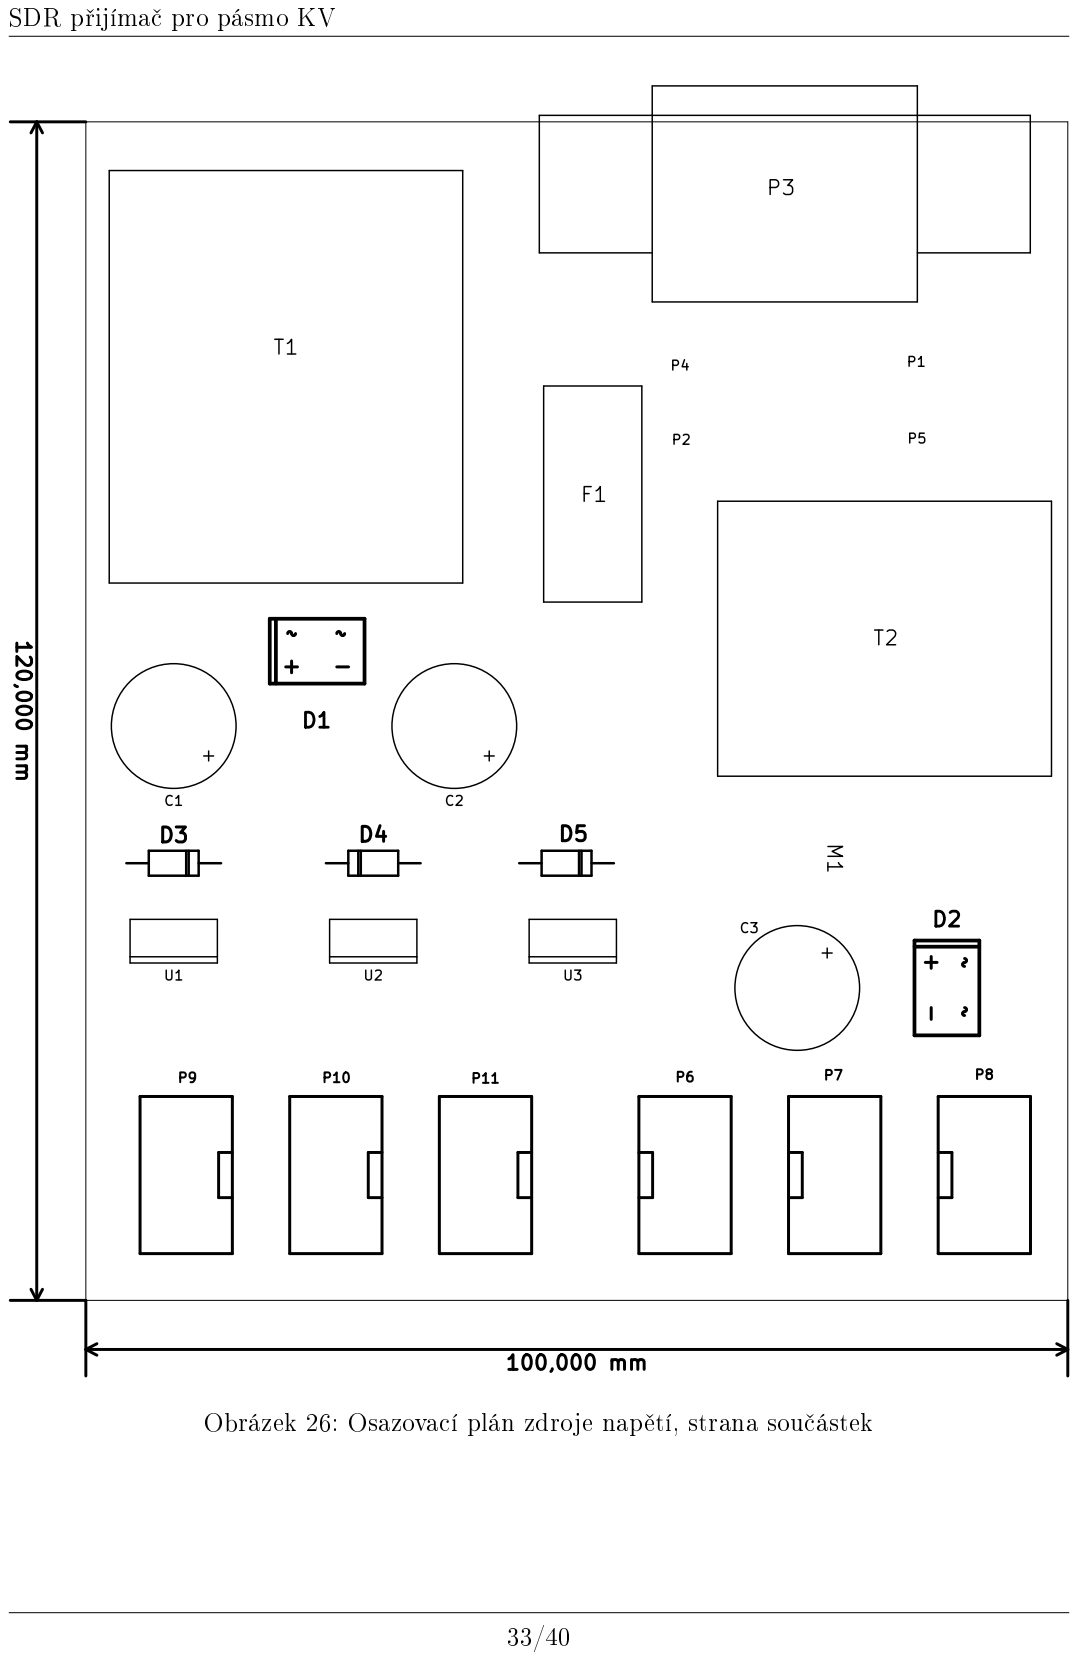
[picture p62: page 33]

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

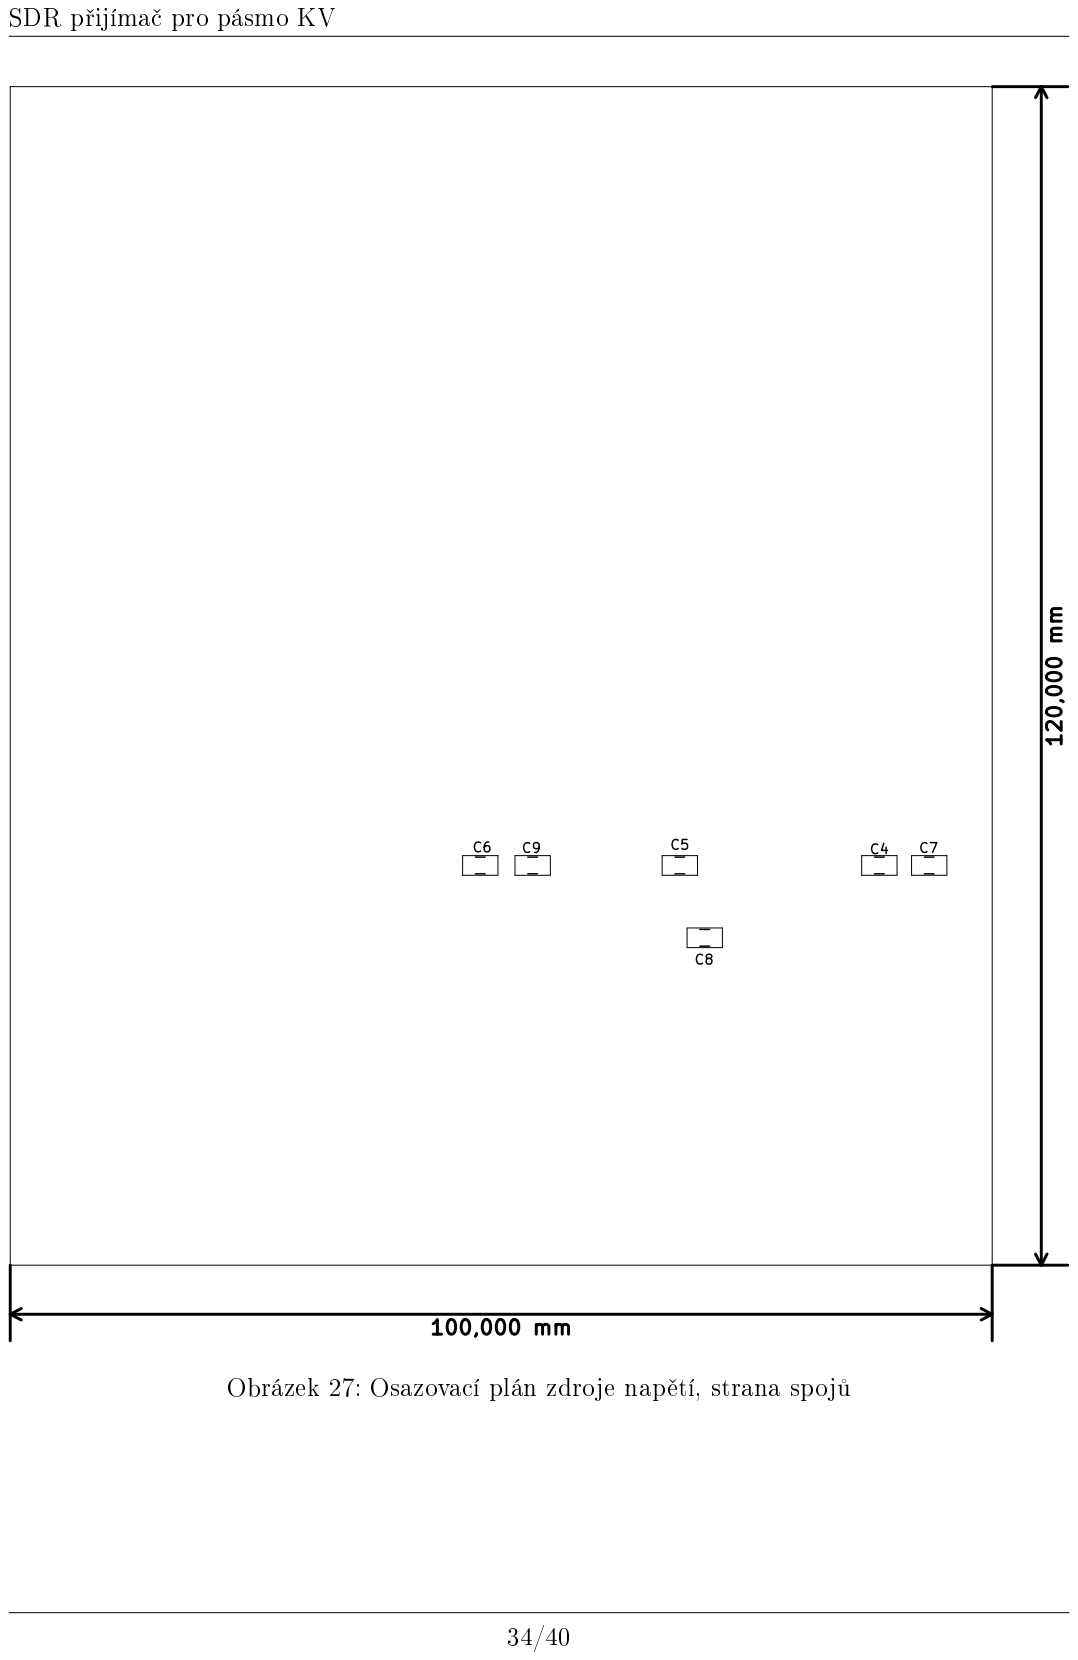
[picture p63: page 34]

SDR p°ijíma£ pro pásmo KV

## 7 Softwarové zpracování

Signály p°evedené do nízkofrekven£ního pásma jsou navzorkovány zvukovou kartou a následn¥ v reálném £ase zpracovávané programem.

### 7.1 Základní princip zpracování

Program nejprve p°evede p°ijímaný signál pomocí diskrétní furierovy transformace do frekven£ní oblasti. V tomto okamºiku se generují i data pro zobrazování waterfall. Kdyº jsou data p°evedena do frekven£ní oblasti, tak si vybereme poºadované pásmo poºadované frekvence. Poté projde signál konvolu£ním ltrem, který provede vybranou demodulaci. Nakonec se p°ijímaný signál p°evede zpátky do £asové oblasti pomocí diskrétní inverzní furierovy transformace. V posledním kroku signál projde ltry pro zbavení stejnosm¥rné sloºky, která vzniká p°i vzorkování, signál projde je²t¥ dolní propustí a je moºné jej dostat ze zvukové karty ven pomocí linkového výstupu.


Obrázek 28: Ukázka p°íjmu telegrae na kmito£tu 14.01 MHz

### 7.2 Sharp SDR

Ke zpracovávání signálu jsem si vybral program Sharp SDR. Tento program umoº¬uje zpracování signál· I a Q ze zvukové karty. Jeho velkou p°edností je snadné ovládání. M·ºeme si zde m¥nit ²í°ku p°ijímaného pásma, dokáºe demodulavat jak AM modulace, tak také modulace FM. Demodulování CW je samoz°ejmostí. Dále je moºné nastavovat potla£ení ²umu ve výstupním i vstupním signálu.

35/40

SDR p°ijíma£ pro pásmo KV

8 | Návod k obsluze za°ízení
| Ovládání za°ízení je velice intuitivní. Za°ízení sta£í p°ipojit kabelem, které má na obou
koncích konektor stereo Jack 3,5 samec do SDR p°ijíma£e na £elní panel a druhý konec do linkového vstupu zvukové karty. ím bude mít zvuková karta vy²²í vzorkovací frekvenci, tím v¥t²í pásmo budeme moci sledovat na osobním po£íta£i s obsluºným softwarem. Po p°ipojení kabelu sta£í k za°ízení zezadu p°ipojit napájecí kabel, jedná se o klasickou euro ²¬·ru. Poté jiº jen sta£í na £elním panelu stisknout vypína£ a na osobním po£íta£i spustit obsluºný software Sharp SDR. Ovládání Software je velmi jednoduché. Vlevo na postranním panelu se nastavují parametry zpracování signálu jako: zp·sob demodulace, ²í°ka pásma, potla£ení stejnosm¥rné sloºky, potla£ení ²umu atd. SDR p°ijíma£ se ovládá je²t¥ jednodu²eji. Otá£ením rota£ního enkodéru m¥níme výstupní frekvenci. Pokud stiskneme enkodér, p°epneme se do módu, ve kterém otá£ením enkodéru m¥níme ladící krok. Op¥tovným stiskem enkodéru se dostaneme zpátky do módu lad¥ní p°ijímané frekvence.


Obrázek 29: Hotové za°ízení bez horní £ásti krabice

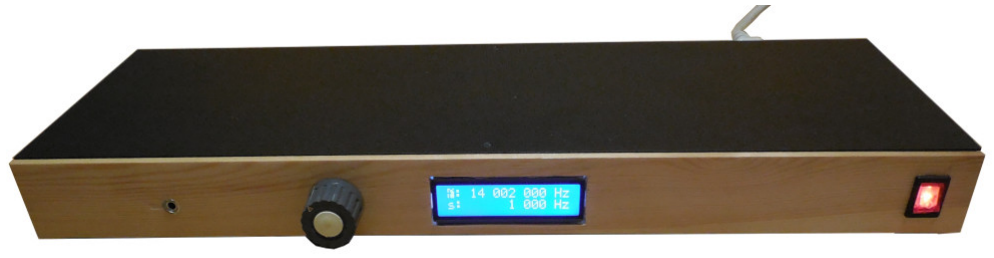
[picture p64: figure]

Obrázek 30: Hotové za°ízení v kompletní krabici rackových rozm¥r·

36/40

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

SDR p°ijíma£ pro pásmo KV

## Seznam pouºité literatury a studijních materiál·

[1] Karel OK2ZI: irokopásmový vf zesilova£ [online] [cit. 11-4-2015] Dostupné z: http://ok2zi.blogspot.cz/2010/11/pasmova-propust-predzesilovac-pro-160m.html (http://ok2zi.blogspot.cz/2010/11/pasmova-propust-predzesilovac-pro-160m.html)
[2] Doc. OK1UNL: Úvod do SDR [online] [cit. 13-4-2015]
Dostupné z: http://www.ok1cjb.cz/index.php
[3] Analog Devices: Podpora pro vývojá°e DDS generátor·[online] [cit. 13-4-2015] Dostupné z: http://www.analog.com/designtools/en/simdds/dtDDSMain.aspx
[4] Vlastimil Slinták: FFT na AVR [online] [cit. 13-4-2015]
Dostupné z: http://elektronika.kvalitne.cz/\ATMEL/necoteorie/transformation/AVRFFT/AVRFFT.html (http://elektronika.kvalitne.cz/\ATMEL/necoteorie/transformation/AVRFFT/AVRFFT.html)
[5] Mikael Q Kuisma: Zpracování I a Q signál· [online]
[cit. 13-4-2015]
Dostupné z: http://whiteboard.ping.se/SDR/IQ
[6] Jarda OK1HDU: Úvod do radioelektroniky [online]
[cit. 13-4-2015]
Dostupné z: http://599.cz/search.php?\rsvelikost=sab&rstext=all-phpRS-all&rstema=13&stromhlmenu=13 (http://599.cz/search.php?\rsvelikost=sab&rstext=all-phpRS-all&rstema=13&stromhlmenu=13)
[7] OK2IP: web zabývající se problematikou SDR [online]
[cit. 13-4-2015]
Dostupné z: http://sdr.ipip.cz/
[8] komunitní projekt: knihovny ur£ené ke zpracování signálu [online] [cit. 13-4-2015]
Dostupné z: http://gnuradio.org/redmine/projects/gnuradio/wiki
[9] komunitní projekt: software pro zpracování signálu [online]
[cit. 13-4-2015]
Dostupné z: http://sdrsharp.com/

38/40

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
