mfkiwl/SDR_SOC_doc/sdr/MIXER/mixer.pdf

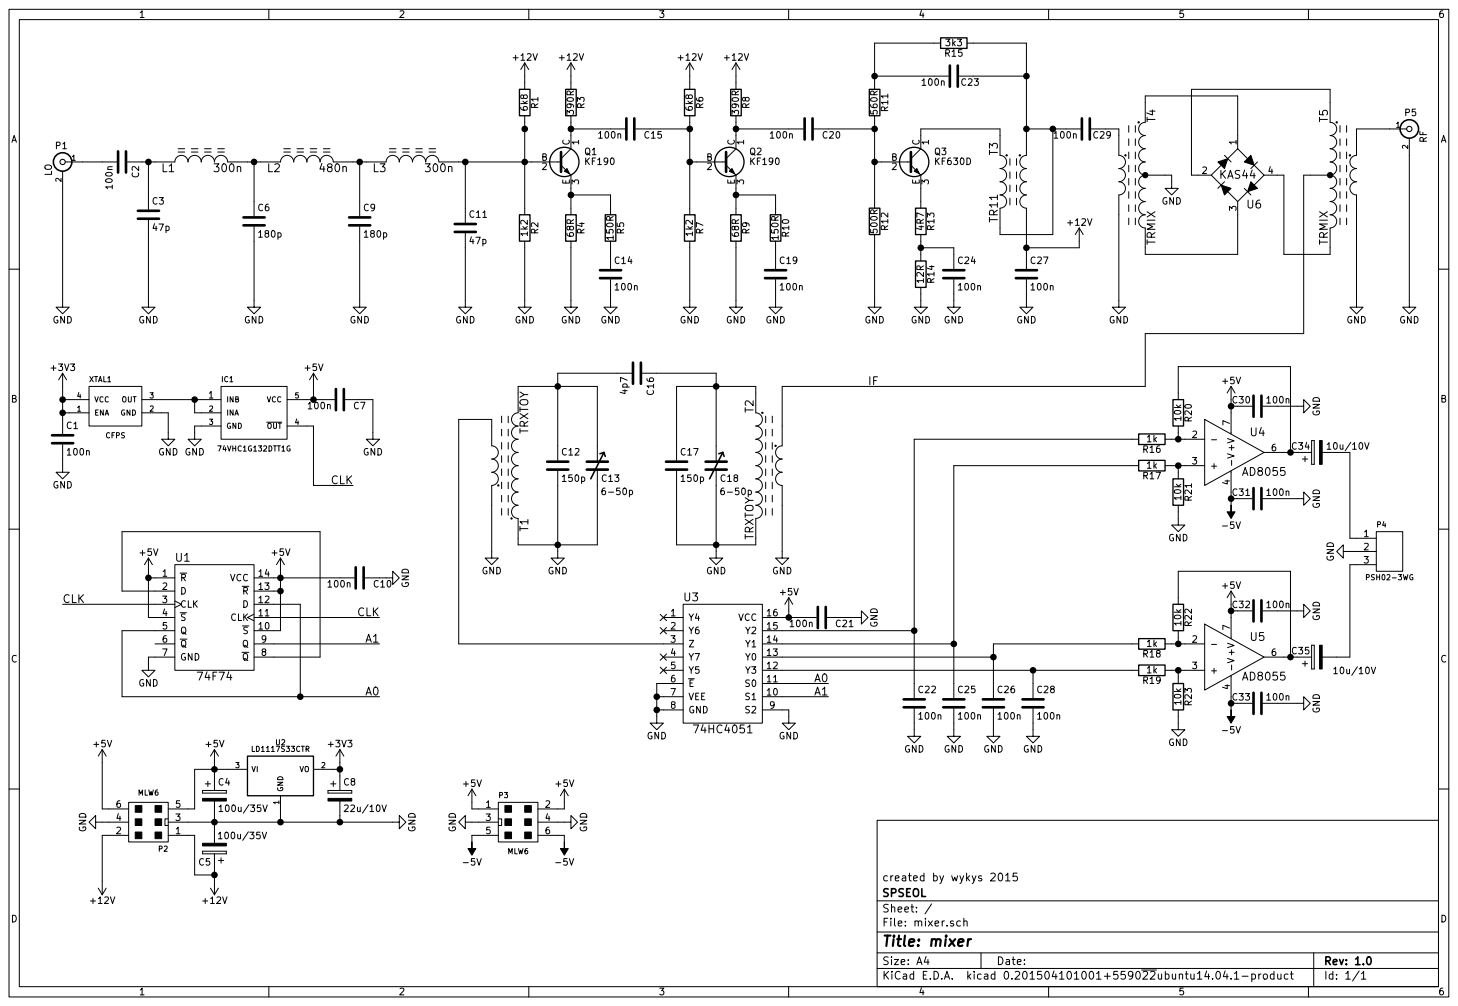
[picture p90: page 1]

created by wykys 2015
Id: 1/1 Title: mixer File: mixer.sch Sheet: / SPSEOL
