mfkiwl/SDR_SOC_doc/sdr_svr/img/b.pdf

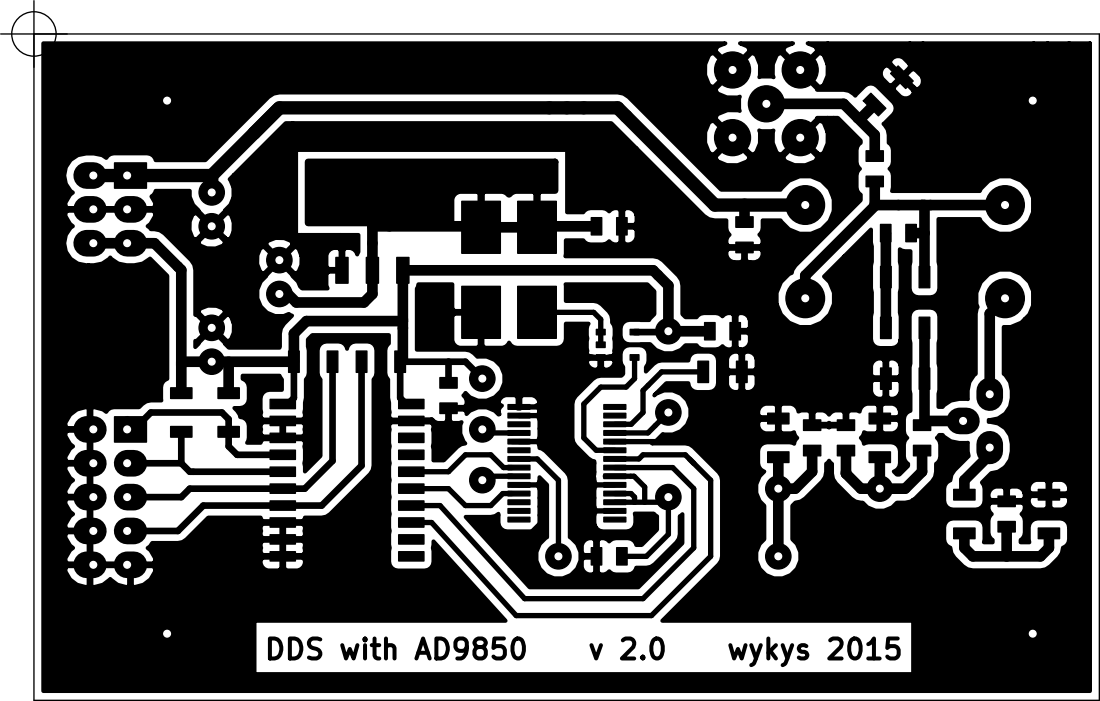
[picture p91: page 1]
