mfkiwl/SDR_SOC_doc/sdr_svr/img/control_board-brd.pdf

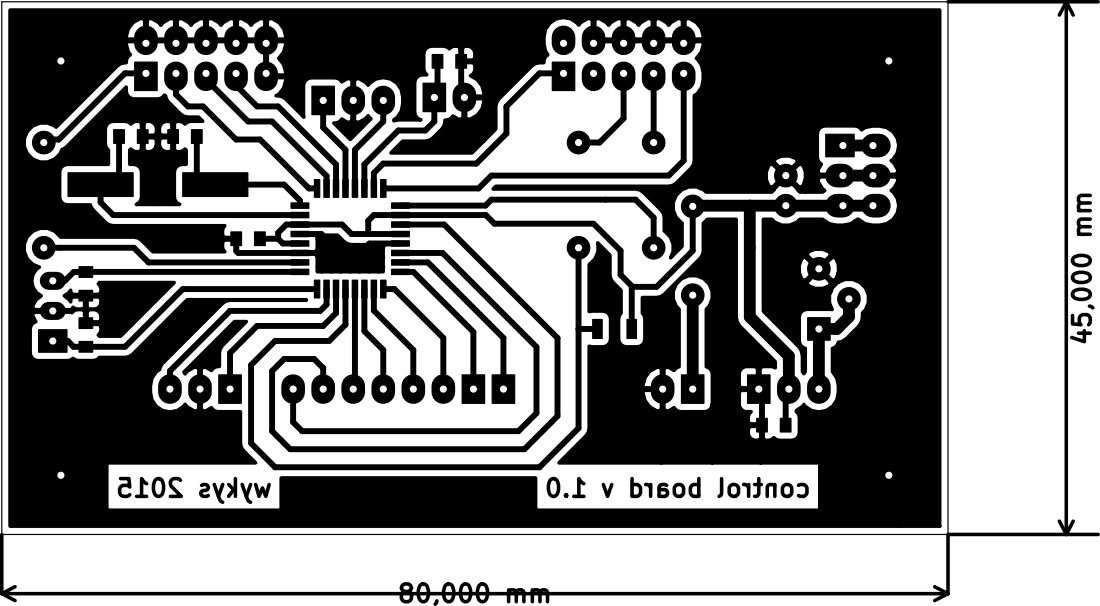
[picture p92: page 1]
