mfkiwl/SDR_SOC_doc/sdr_svr/img/control_board.pdf

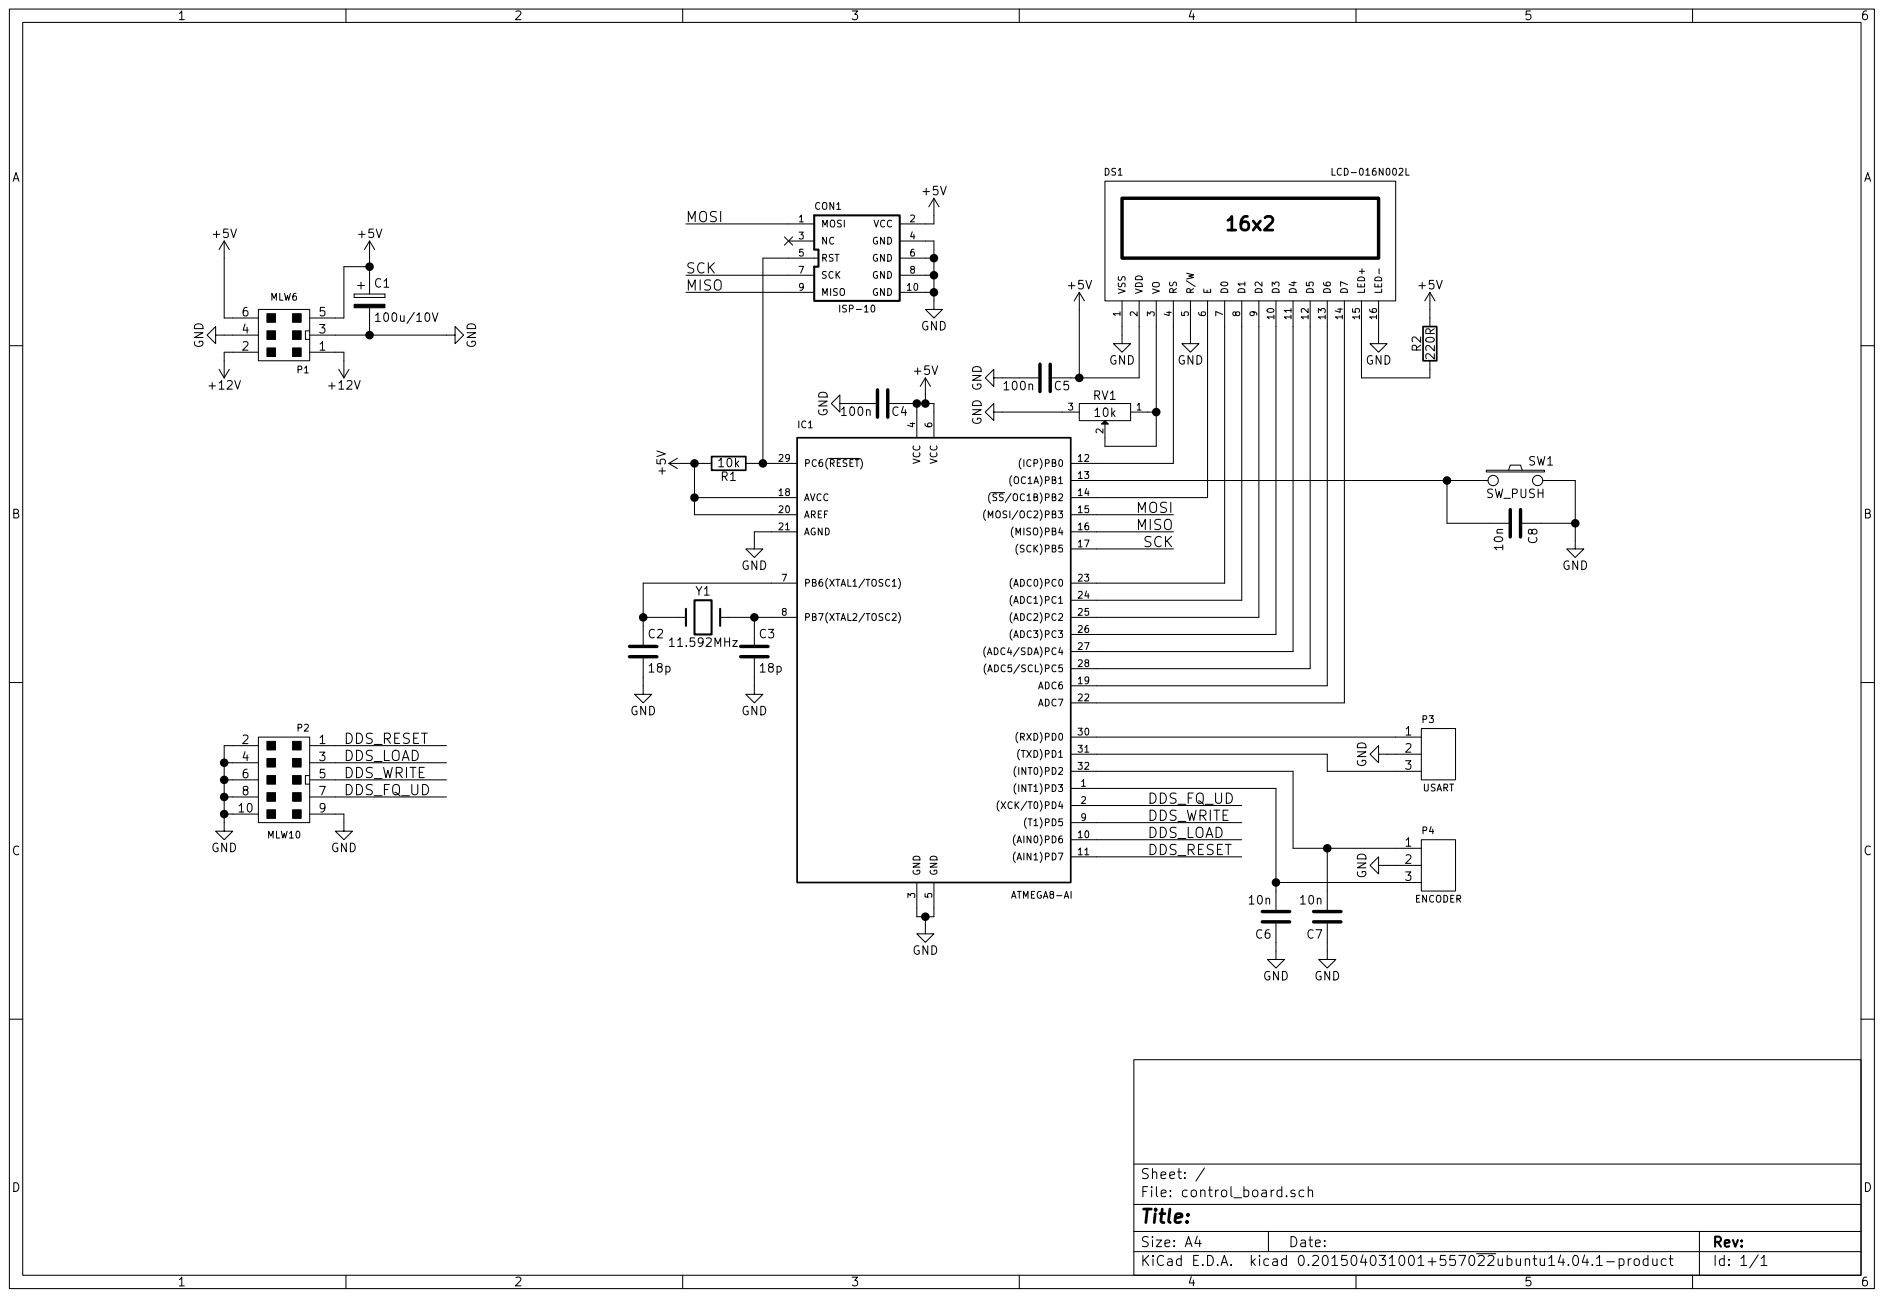
[picture p93: page 1]
