mfkiwl/SDR_SOC_doc/sdr_svr/img/DDS-brd.pdf

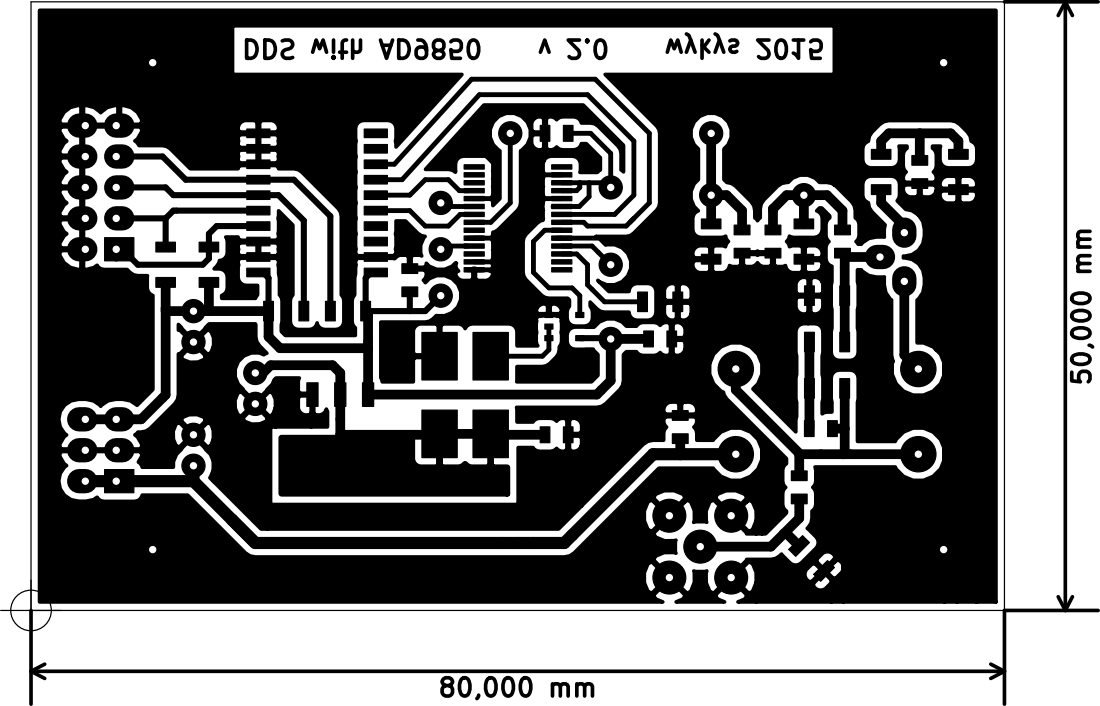
[picture p94: page 1]
