mfkiwl/SDR_SOC_doc/sdr_svr/img/DDS.pdf

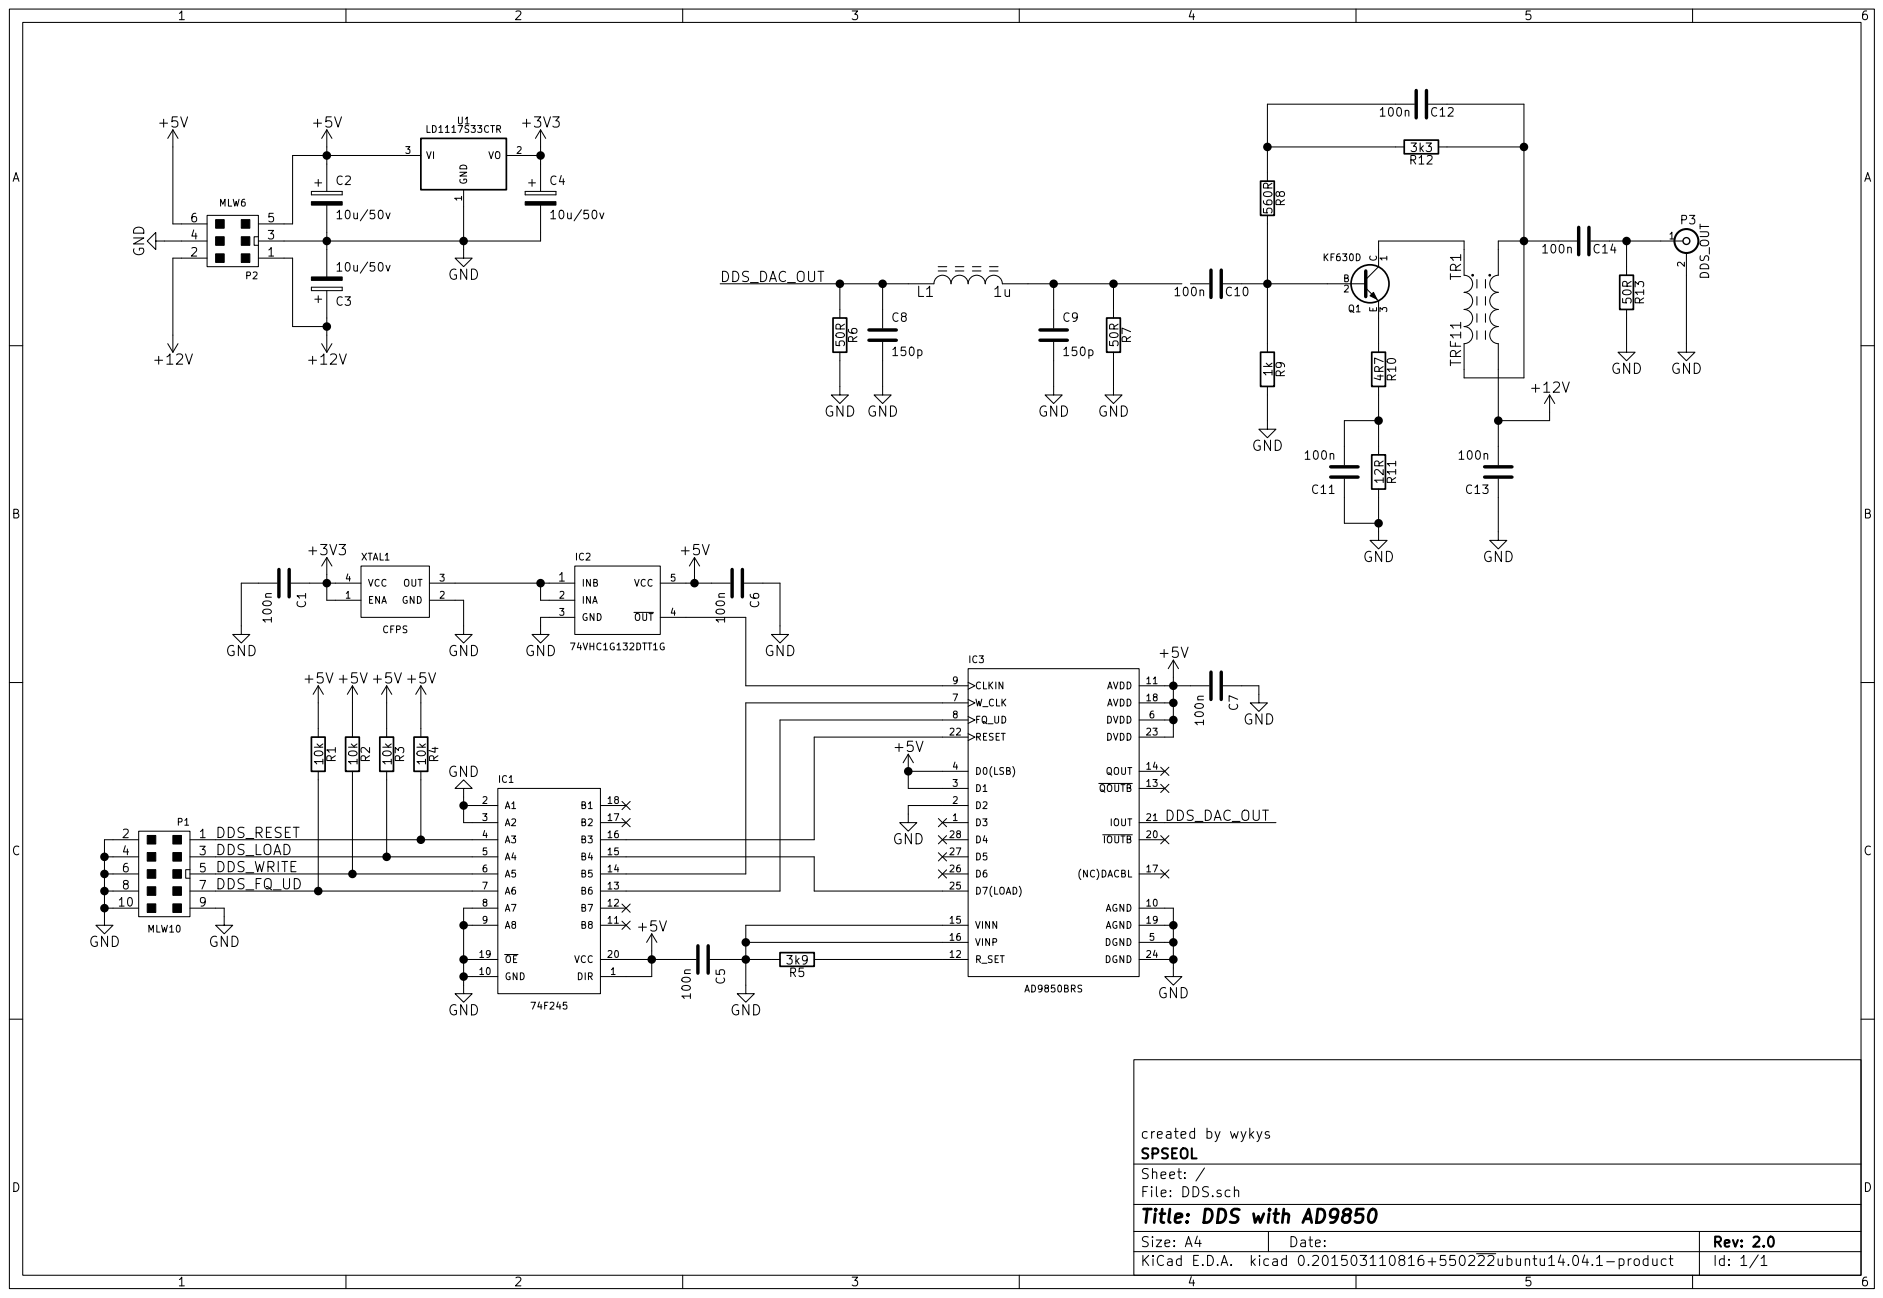
[picture p95: page 1]

created by wykys
File: DDS.sch Sheet: / SPSEOL

Id: 1/1 Title: DDS with AD9850
