mfkiwl/SDR_SOC_doc/sdr_svr/img/LNA-brd.pdf

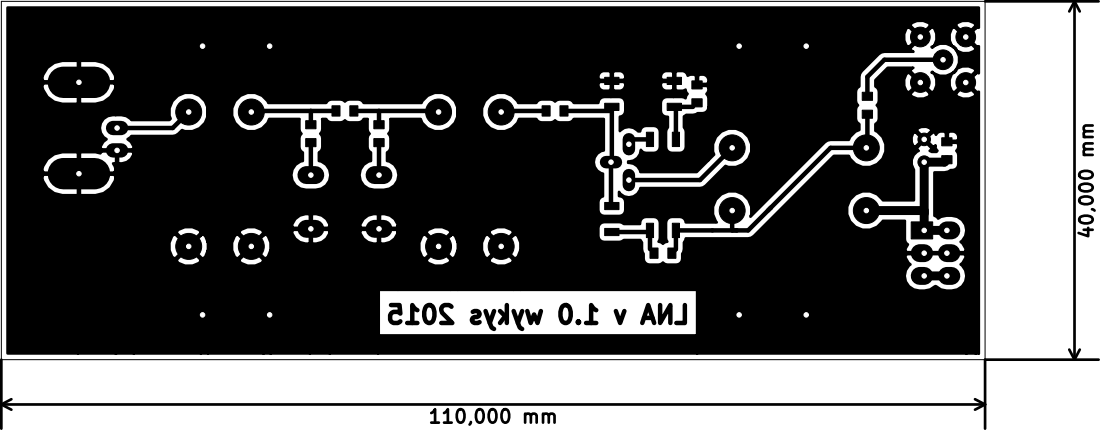
[picture p96: page 1]
