mfkiwl/SDR_SOC_doc/sdr_svr/img/LNA.pdf

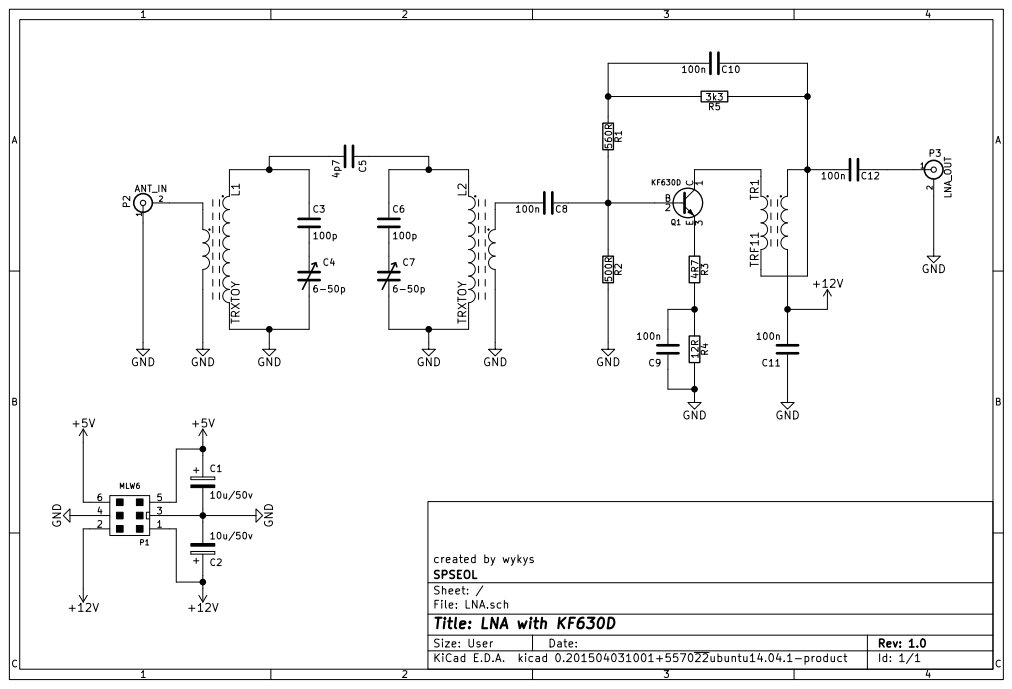
[picture p97: page 1]

created by wykys
File: LNA.sch Sheet: / SPSEOL

Id: 1/1 Title: LNA with KF630D
