mfkiwl/SDR_SOC_doc/sdr_svr/img/mixer-brd.pdf

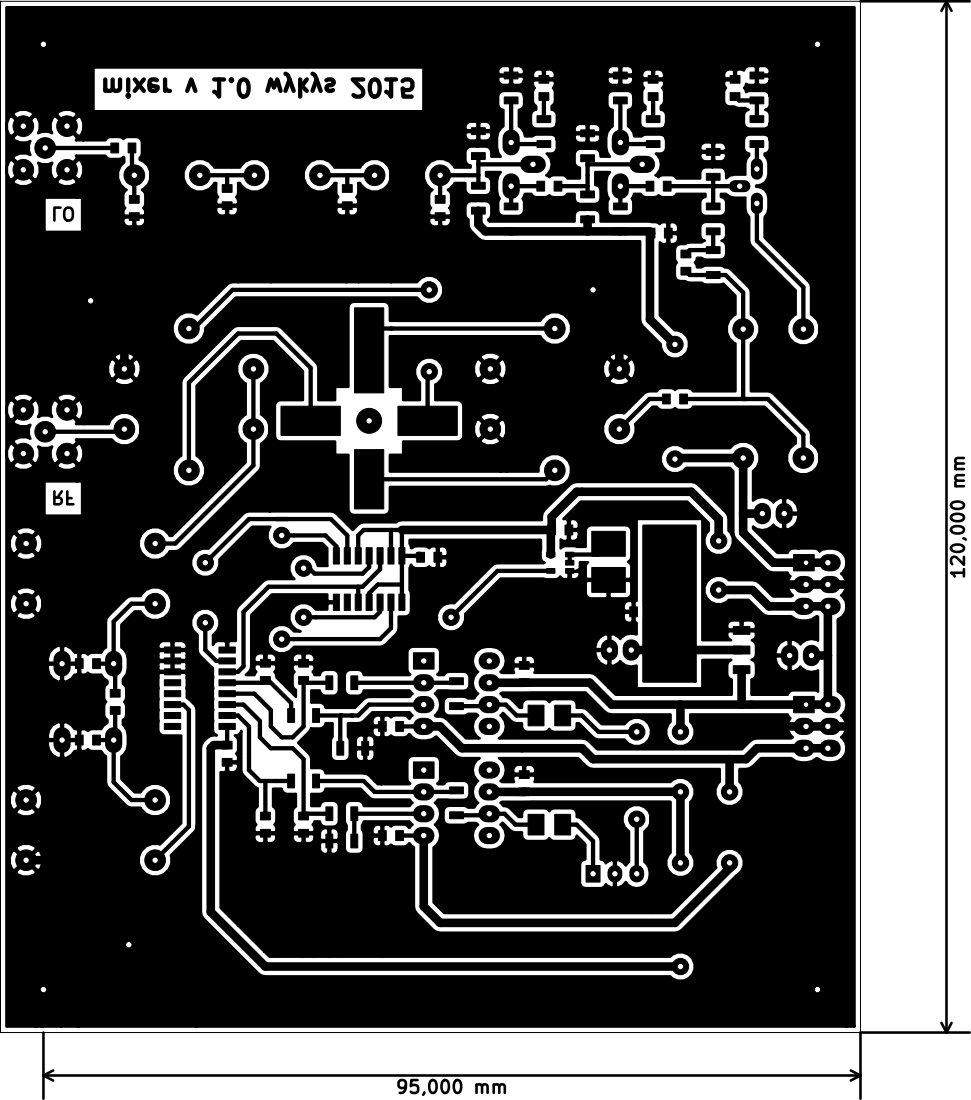
[picture p98: page 1]
