mfkiwl/SDR_SOC_doc/sdr_svr/img/mixer.pdf

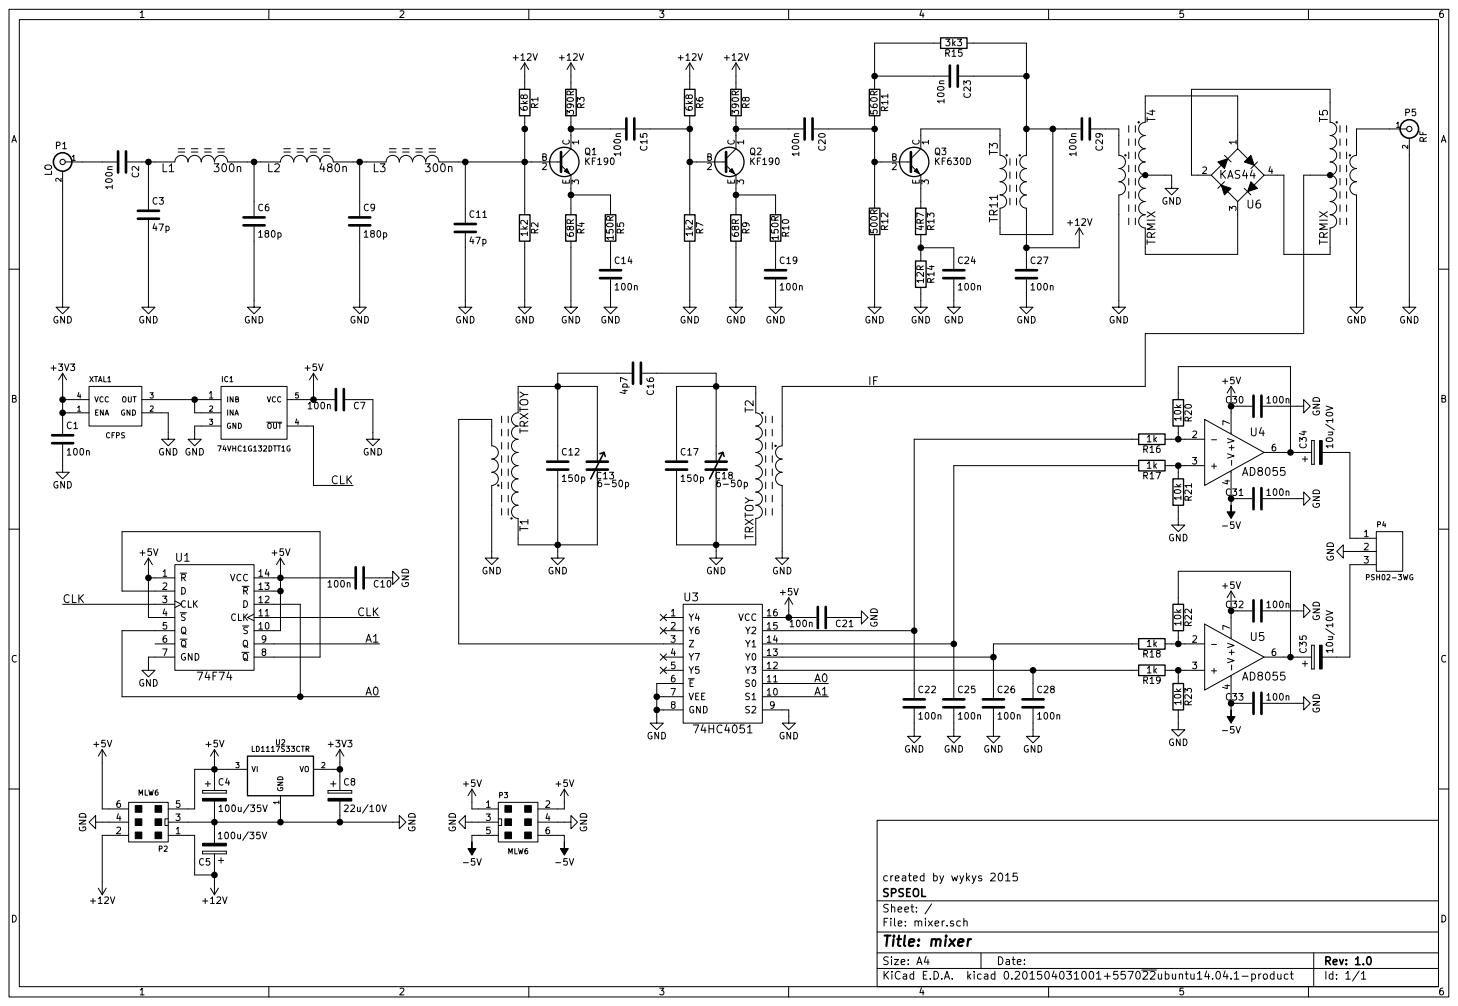
[picture p99: page 1]

created by wykys 2015
Id: 1/1 Title: mixer File: mixer.sch Sheet: / SPSEOL
