mfkiwl/SDR_SOC_doc/sdr_svr/img/ob.pdf

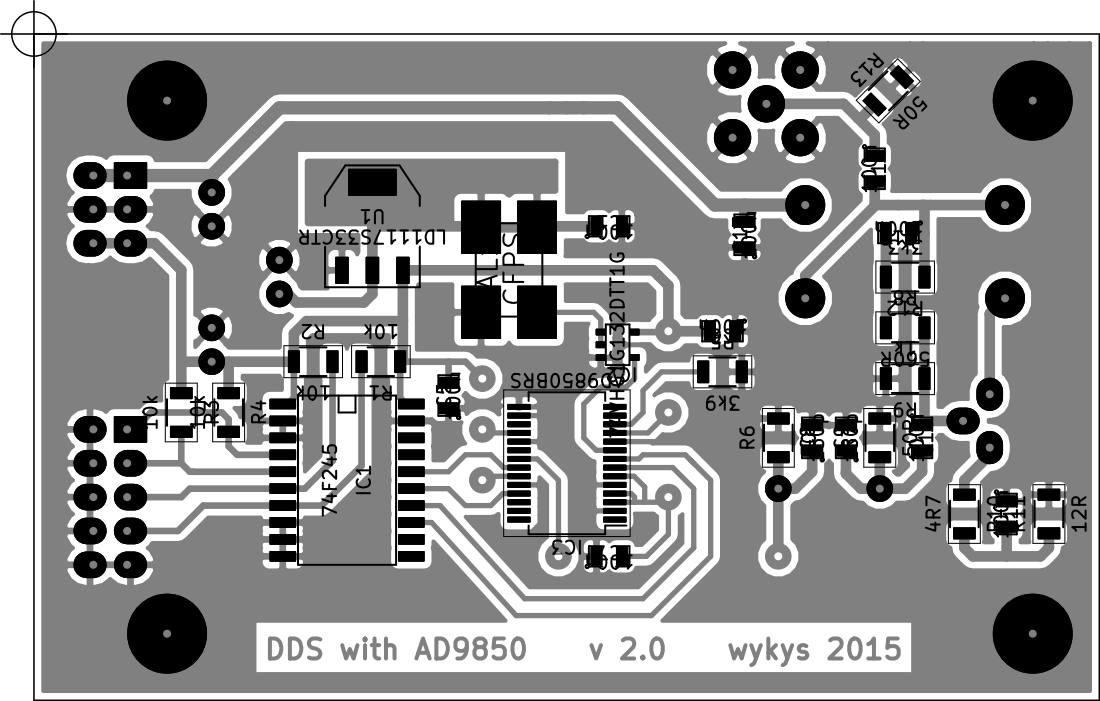
[picture p100: page 1]
