mfkiwl/SDR_SOC_doc/sdr_svr/img/ot.pdf

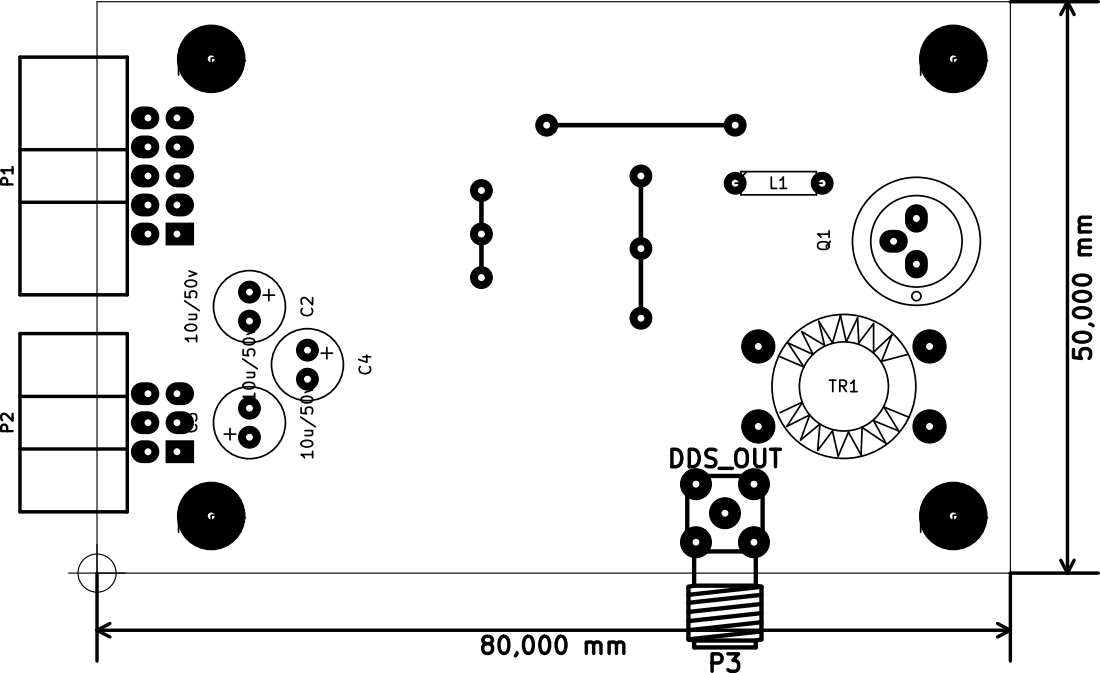
[picture p101: page 1]
