mfkiwl/SDR_SOC_doc/sdr_svr/img/zdroj-brd.pdf

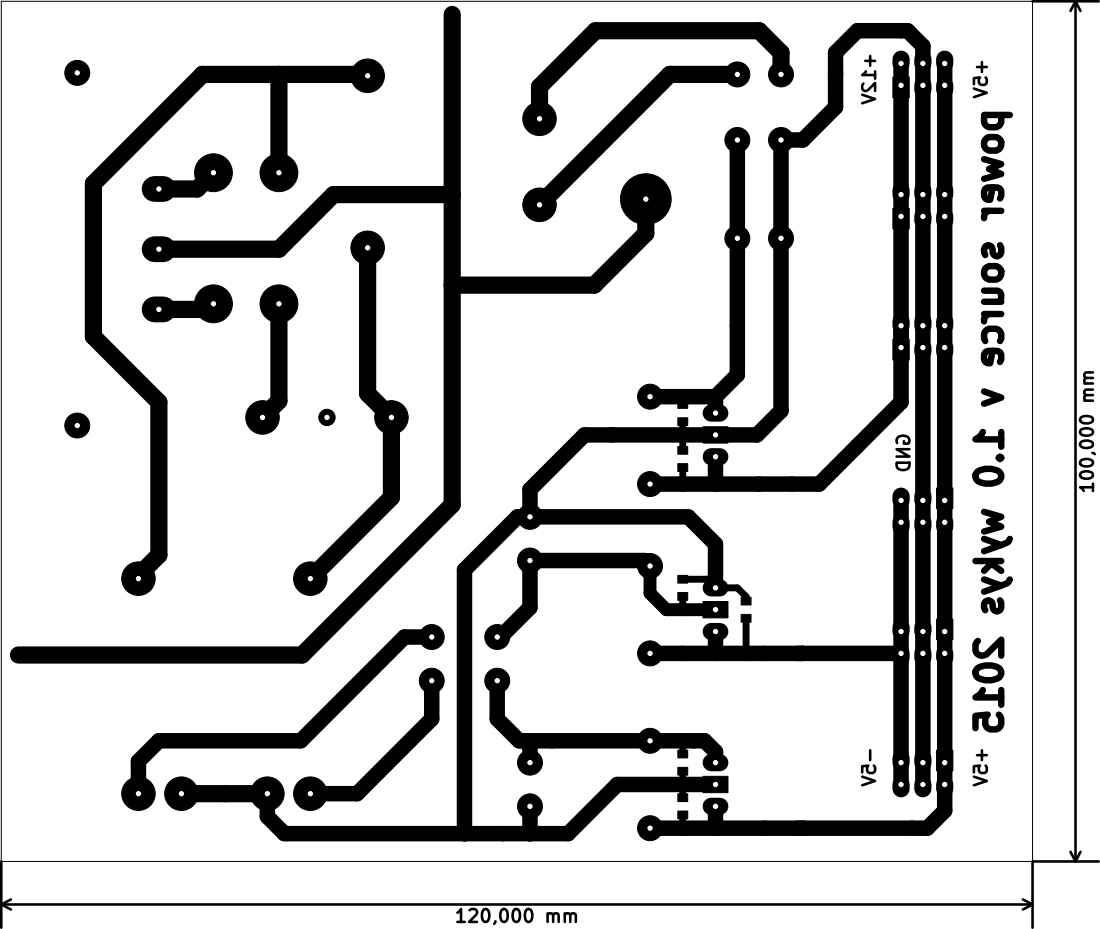
[picture p102: page 1]
