mfkiwl/SDR_SOC_doc/sdr_svr/img/zdroj.pdf

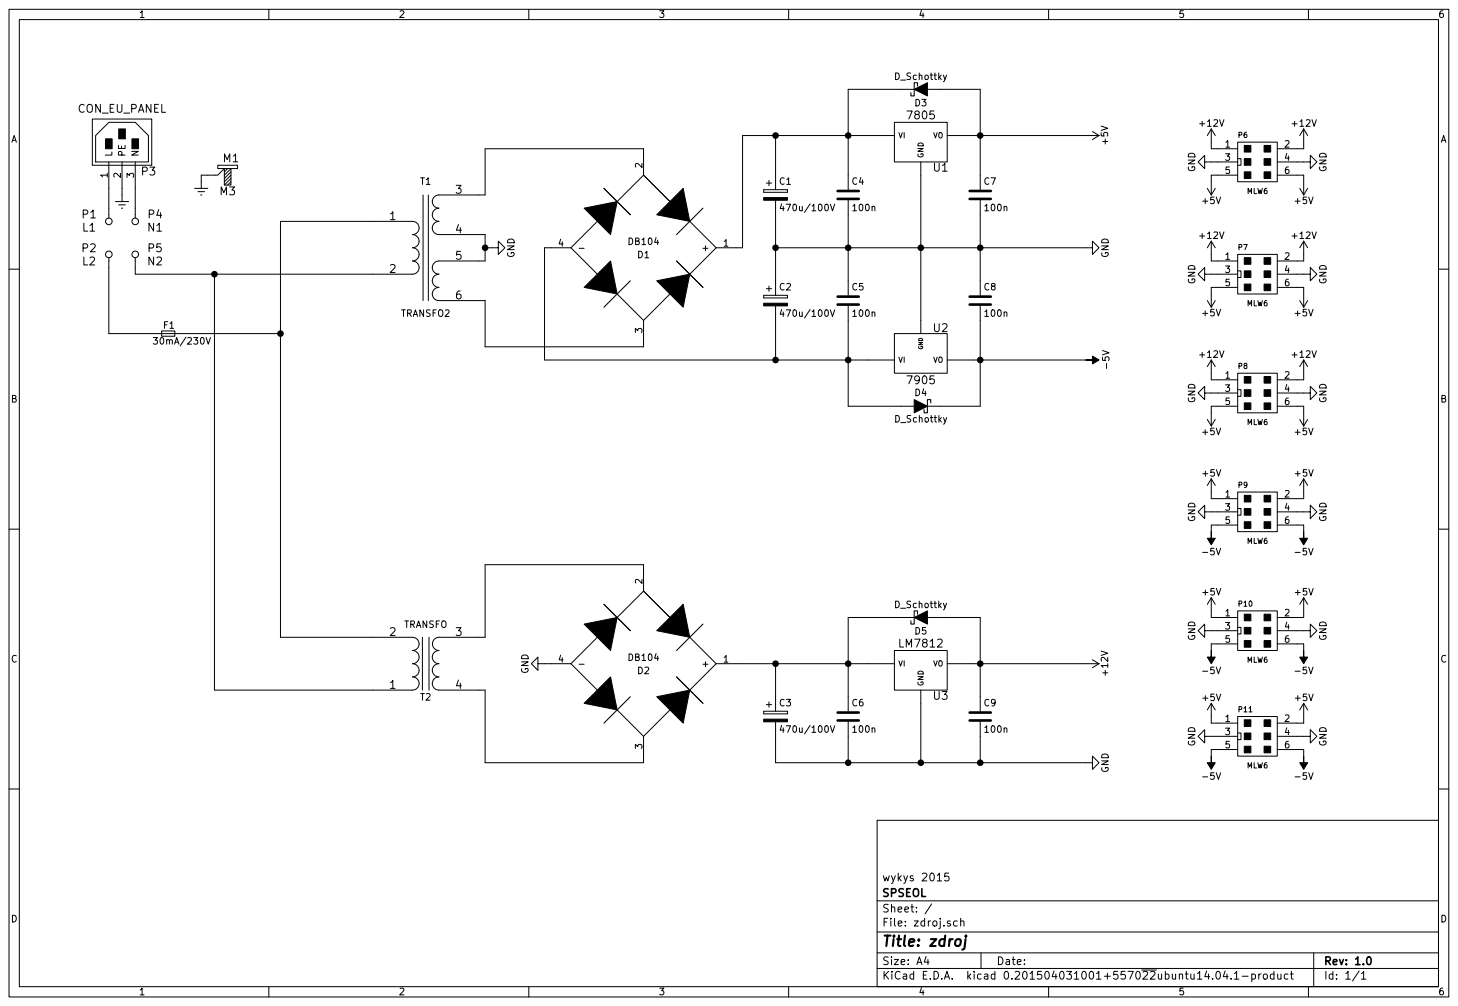
[picture p103: page 1]
