mfkiwl/SDR_SOC_doc/soc_sdr/img/bs_sdr.pdf

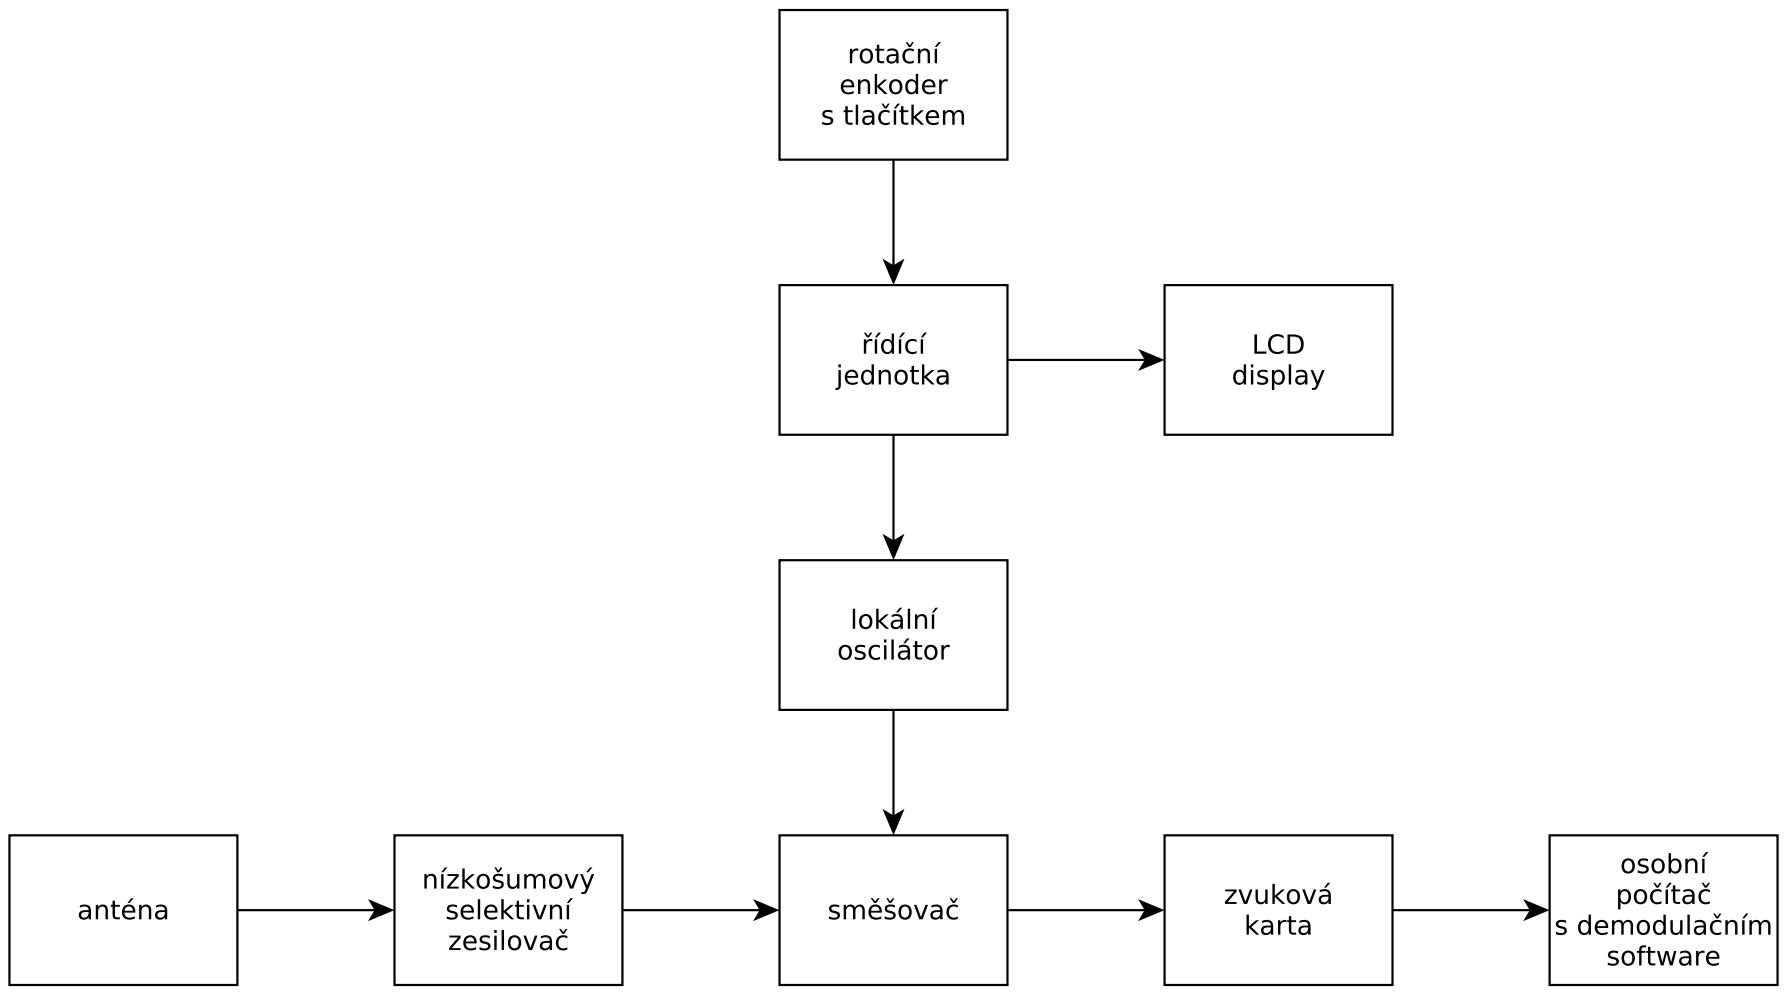
[picture p104: page 1]
