mfkiwl/SDR_SOC_doc/soc_sdr/img/bs_sdr_prez.pdf

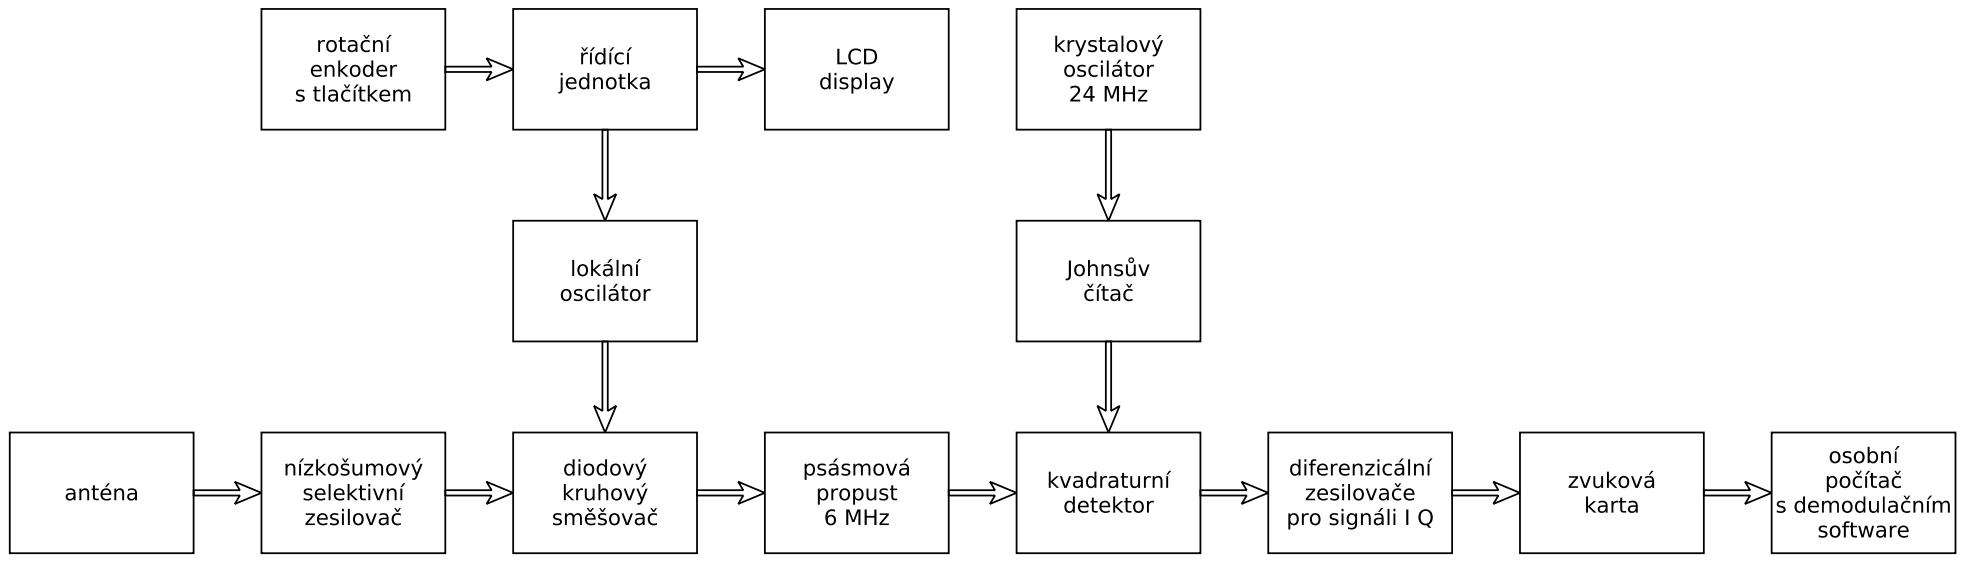
[picture p105: page 1]
