mfkiwl/SDR_SOC_doc/soc_sdr/img/vyvojak.pdf

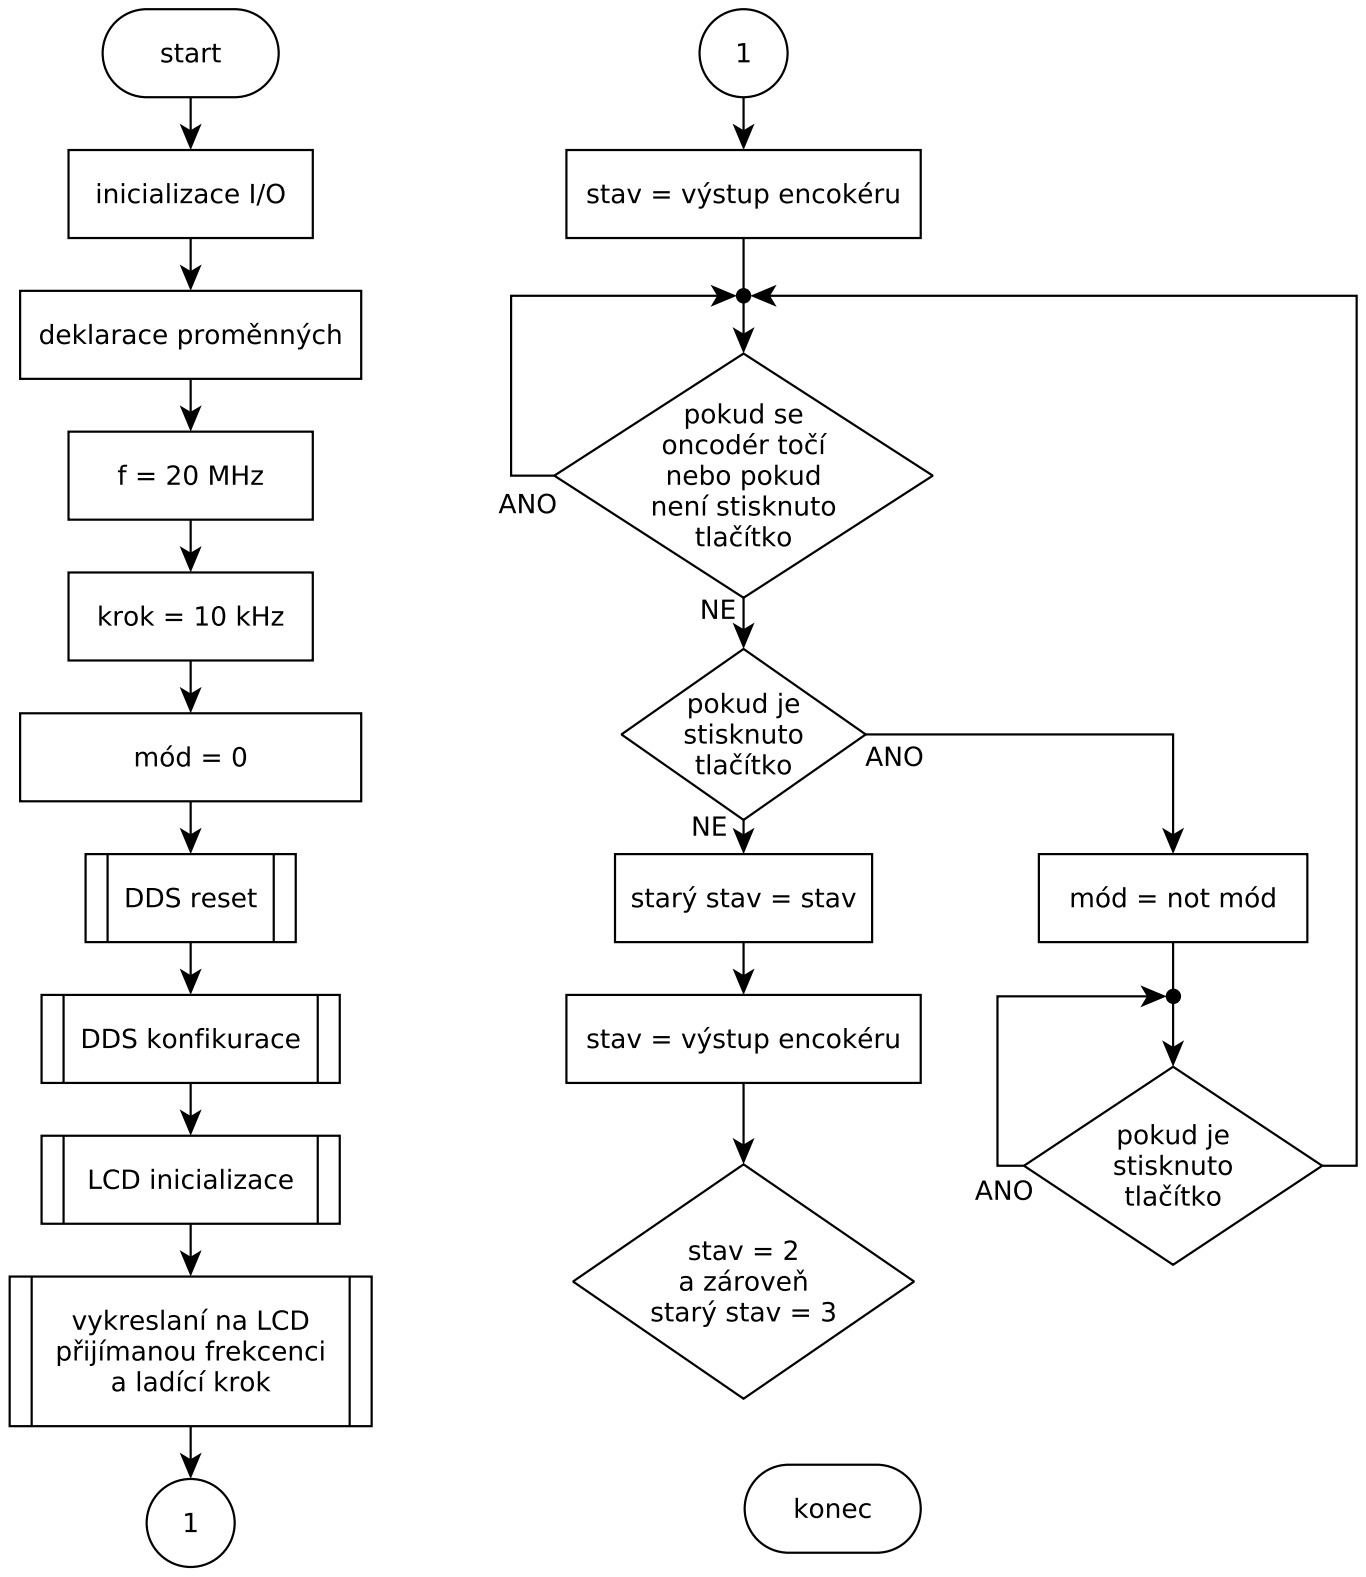
[picture p106: page 1]
