mfkiwl/SDR_SOC_doc/soc_sdr/img/vyvojak_a.pdf

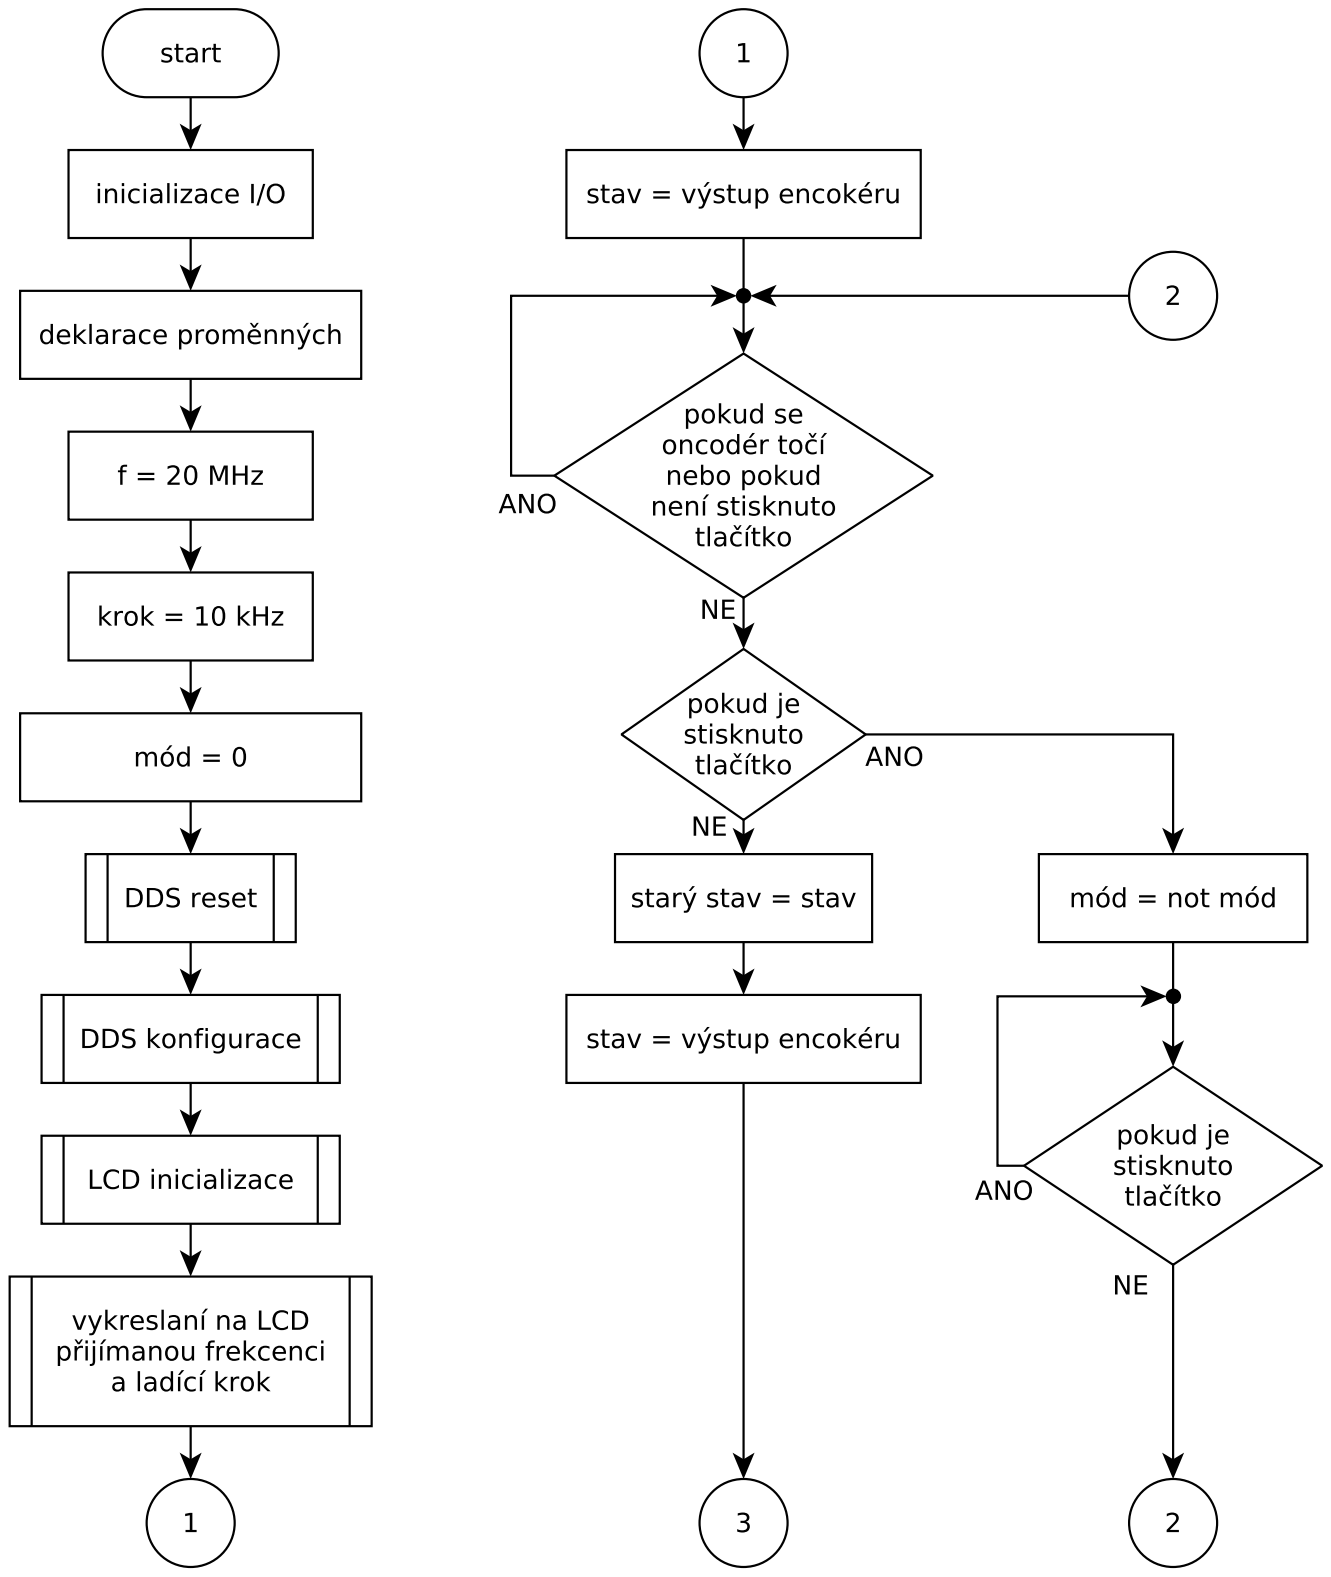
[picture p107: page 1]
