mfkiwl/SDR_SOC_doc/soc_sdr/img/vyvojak_b.pdf

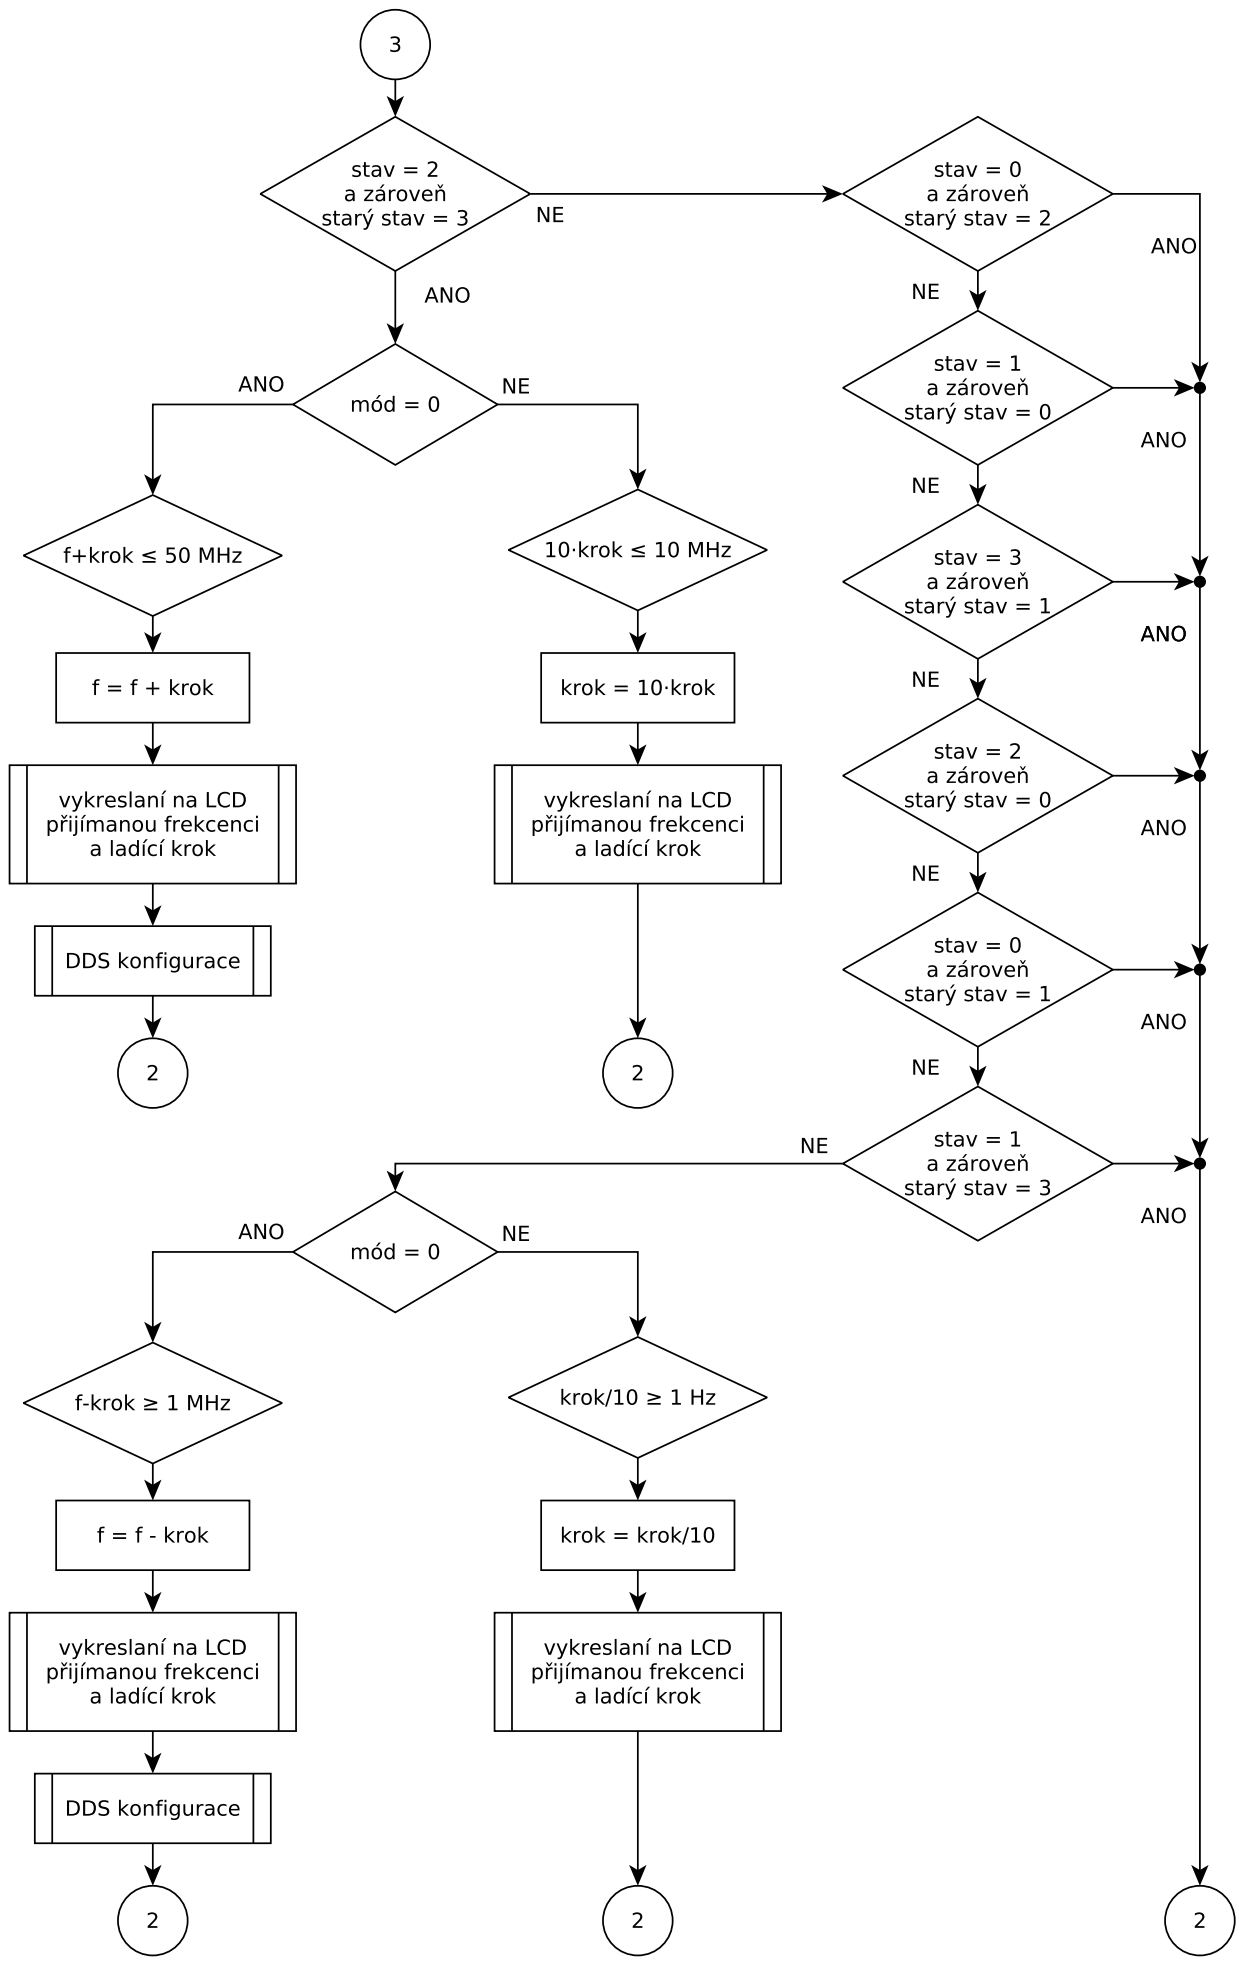
[picture p108: page 1]
