mfkiwl/SDR_SOC_doc/svr_sdr/img/bs_sdr_prez.pdf

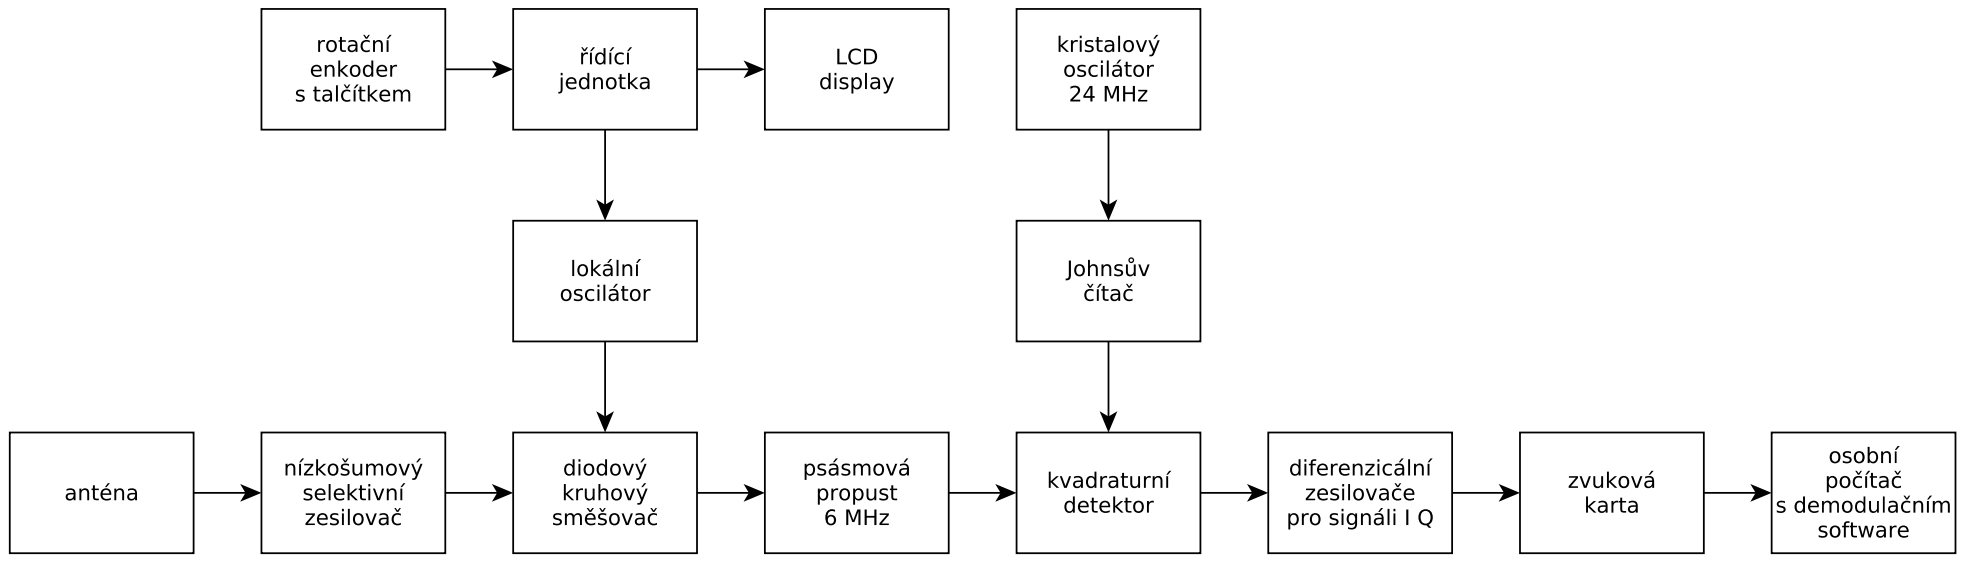
[picture p109: page 1]
