mfkiwl/SDR_SOC_doc/sdr/control_board/out/cu_b.pdf

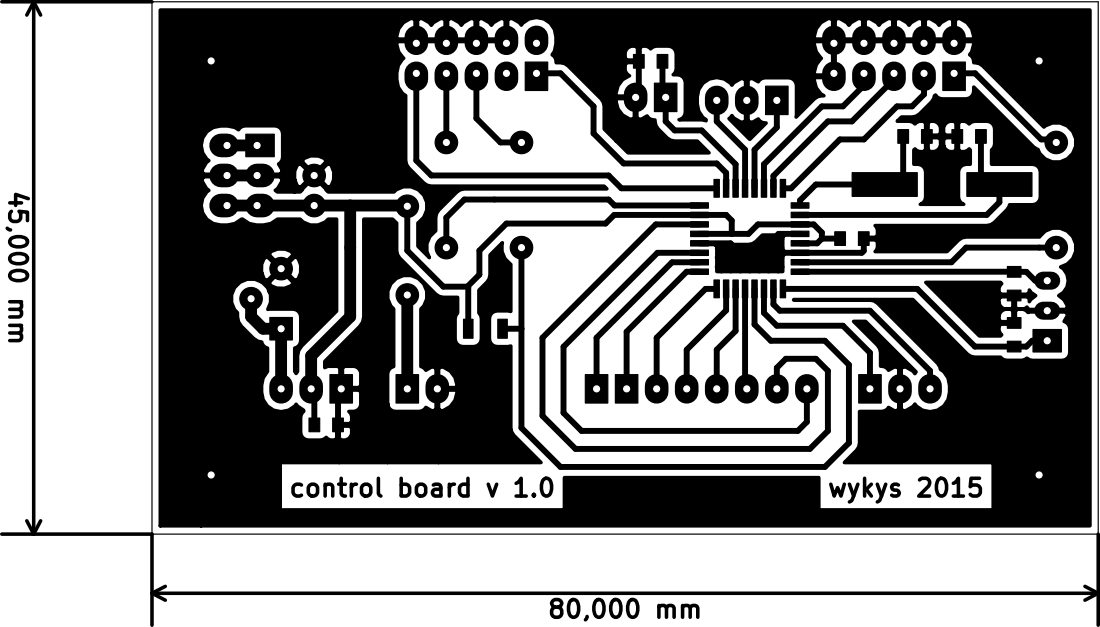
[picture p110: page 1]
