mfkiwl/SDR_SOC_doc/sdr/control_board/out/os_b.pdf

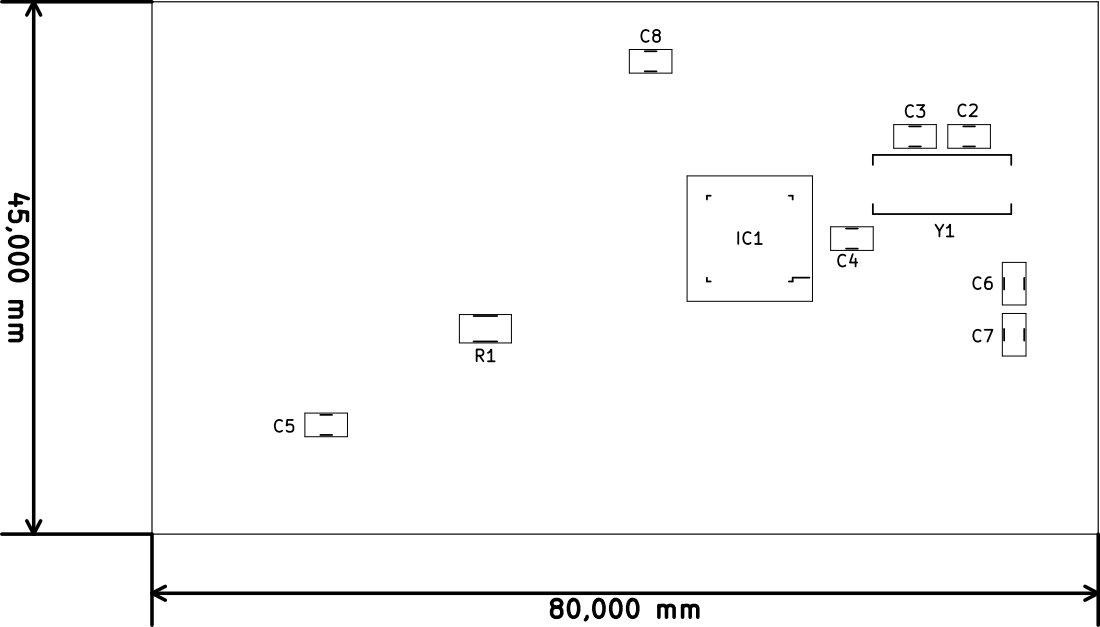
[picture p111: page 1]
