mfkiwl/SDR_SOC_doc/sdr/control_board/out/os_f.pdf

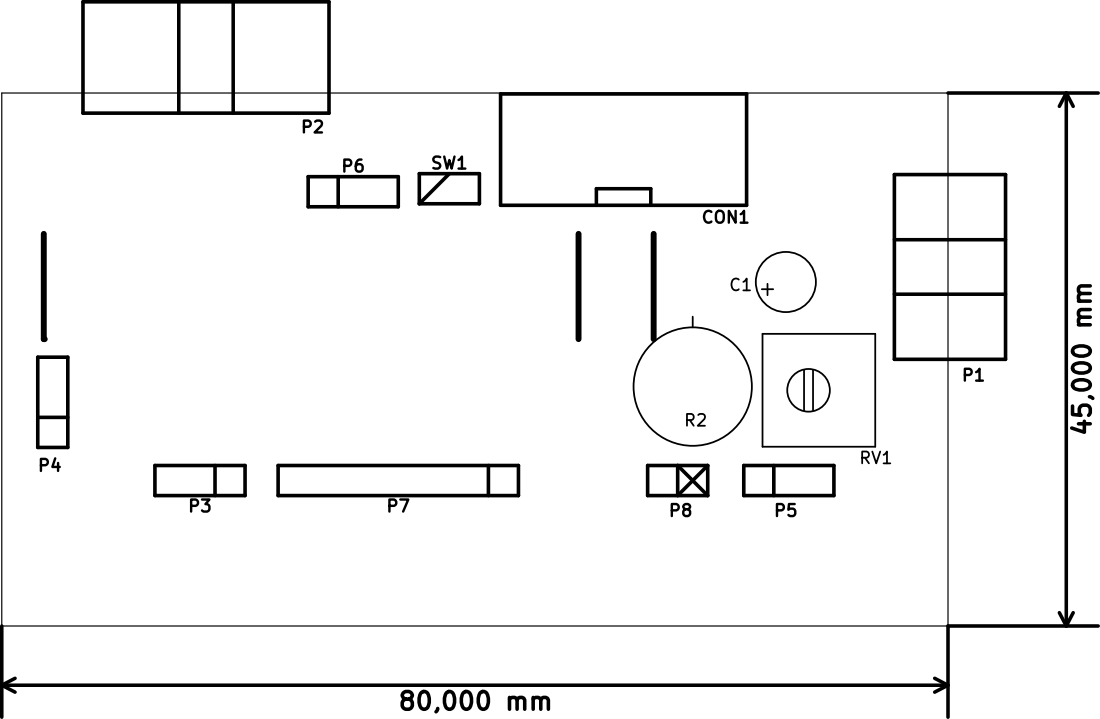
[picture p112: page 1]
