mfkiwl/SDR_SOC_doc/sdr/MIXER/out/cu_b.pdf

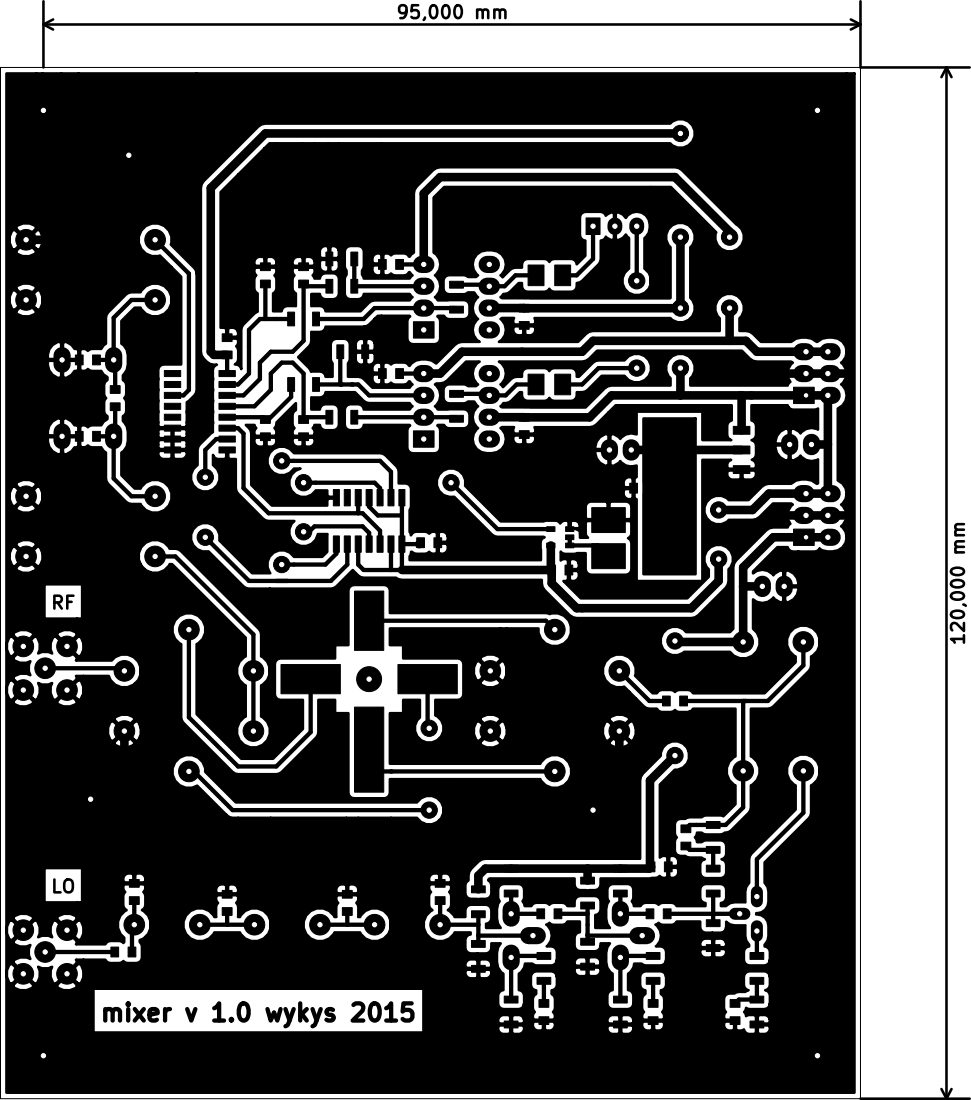
[picture p113: page 1]
