mfkiwl/SDR_SOC_doc/sdr/MIXER/out/os_b.pdf

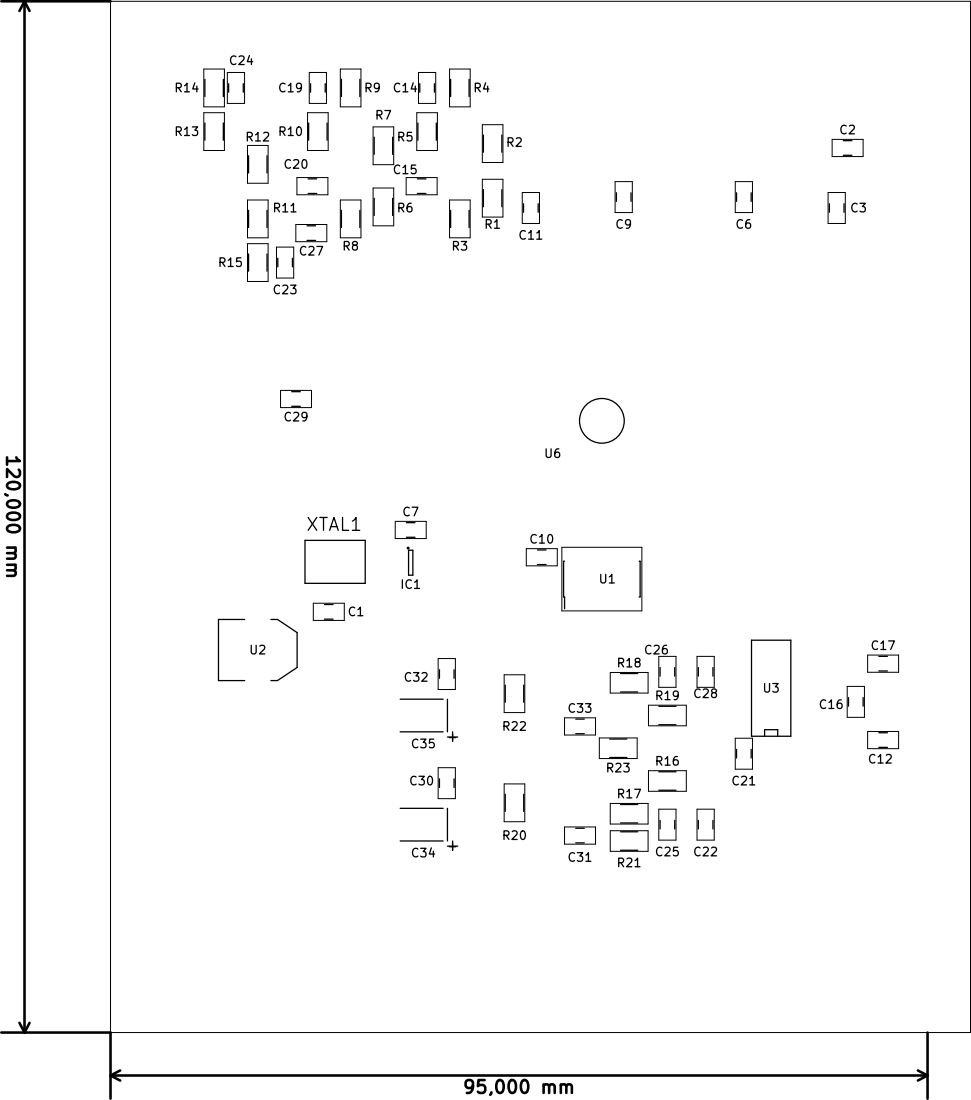
[picture p114: page 1]
