mfkiwl/SDR_SOC_doc/sdr/MIXER/out/os_f.pdf

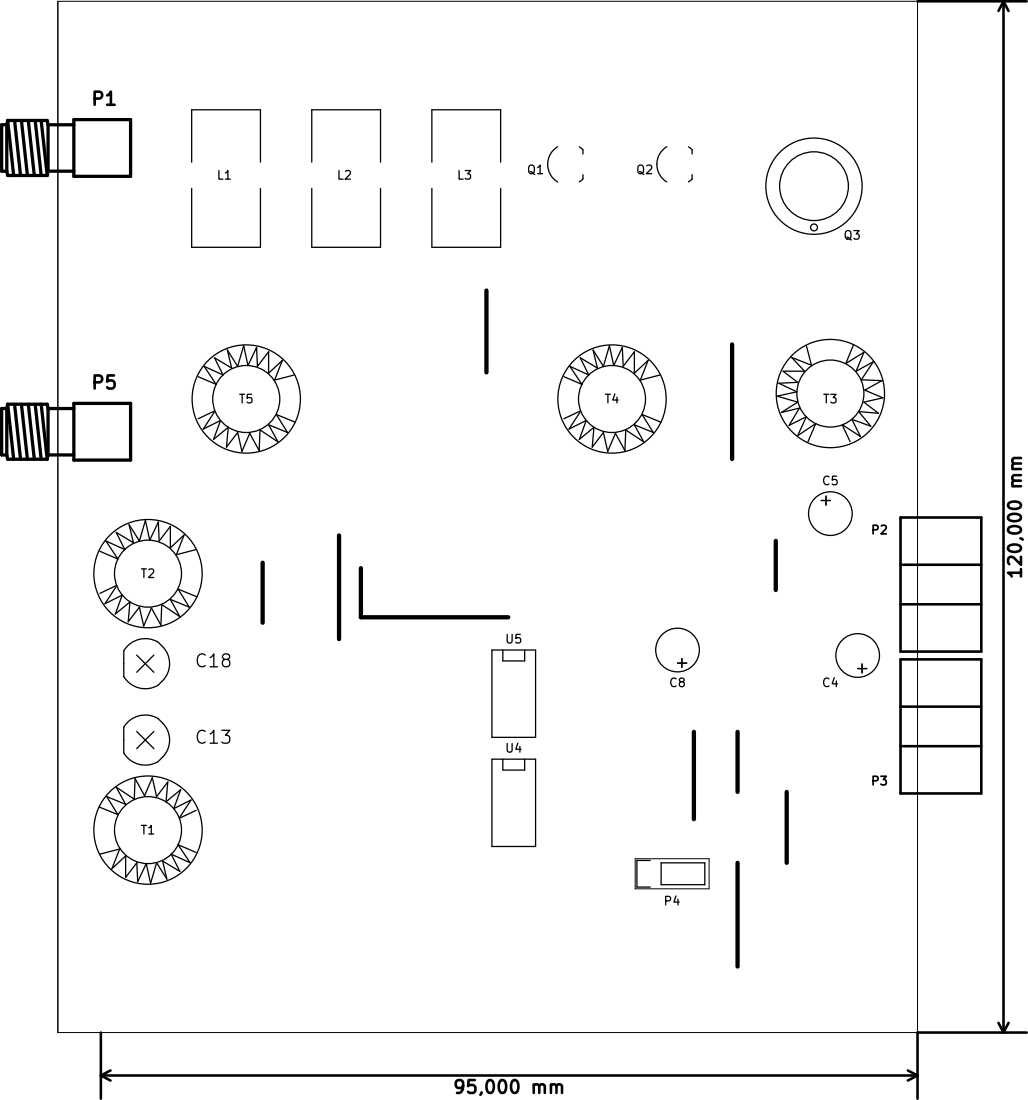
[picture p115: page 1]
