mfkiwl/SDR_SOC_doc/sdr/zdroj/zdroj_v1/zdroj.pdf

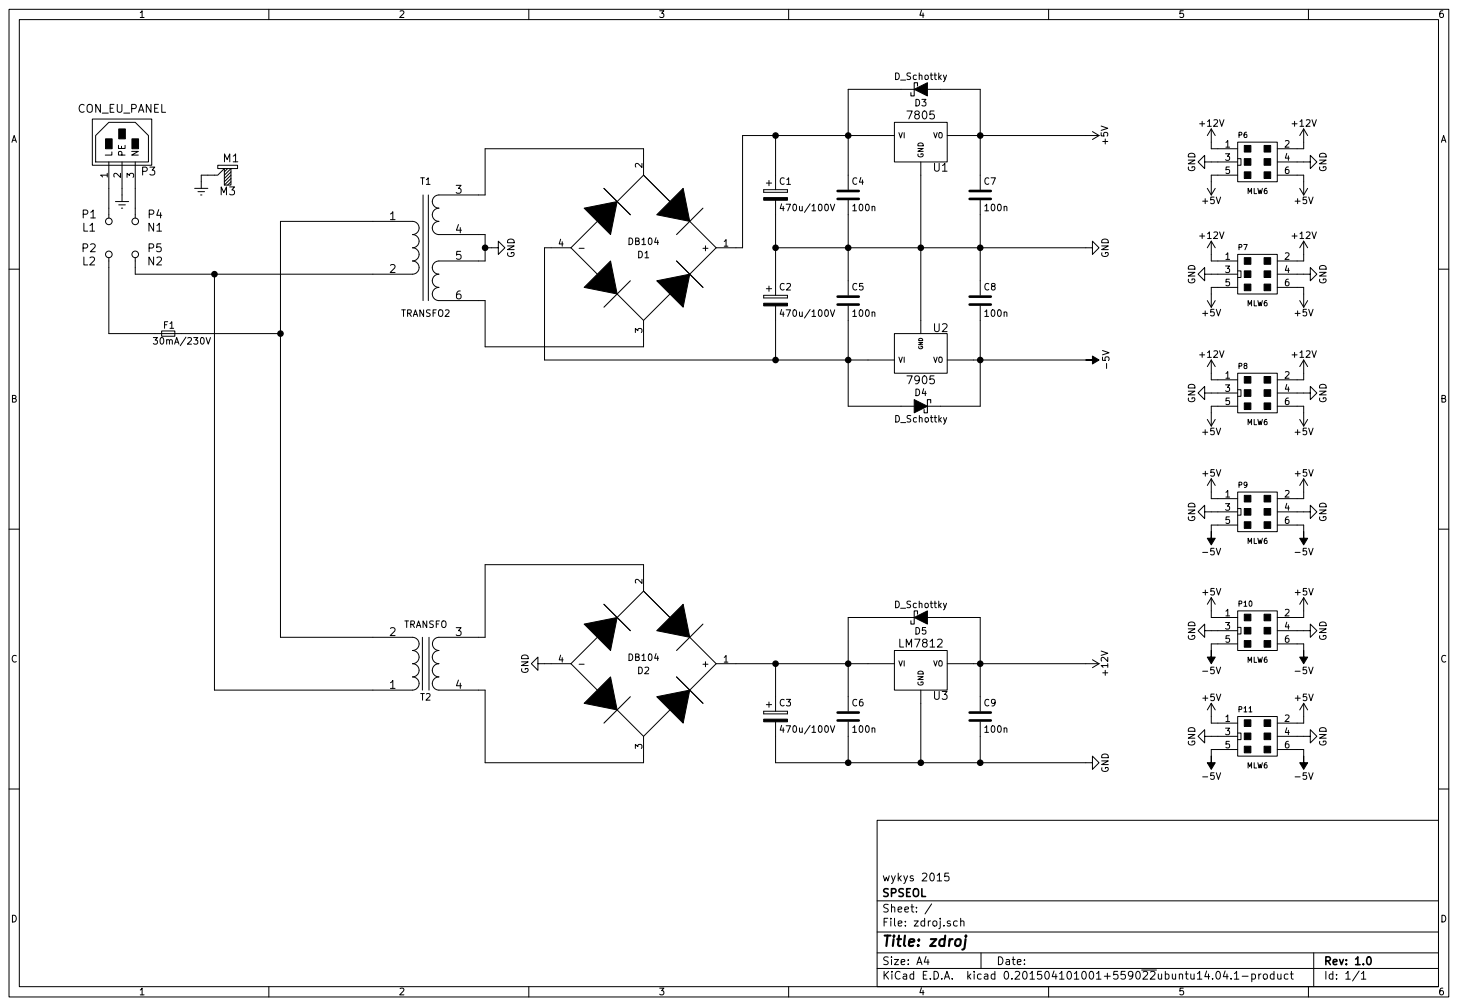
[picture p116: page 1]
