mfkiwl/SDR_SOC_doc/sdr_svr/img/logo/logo.pdf

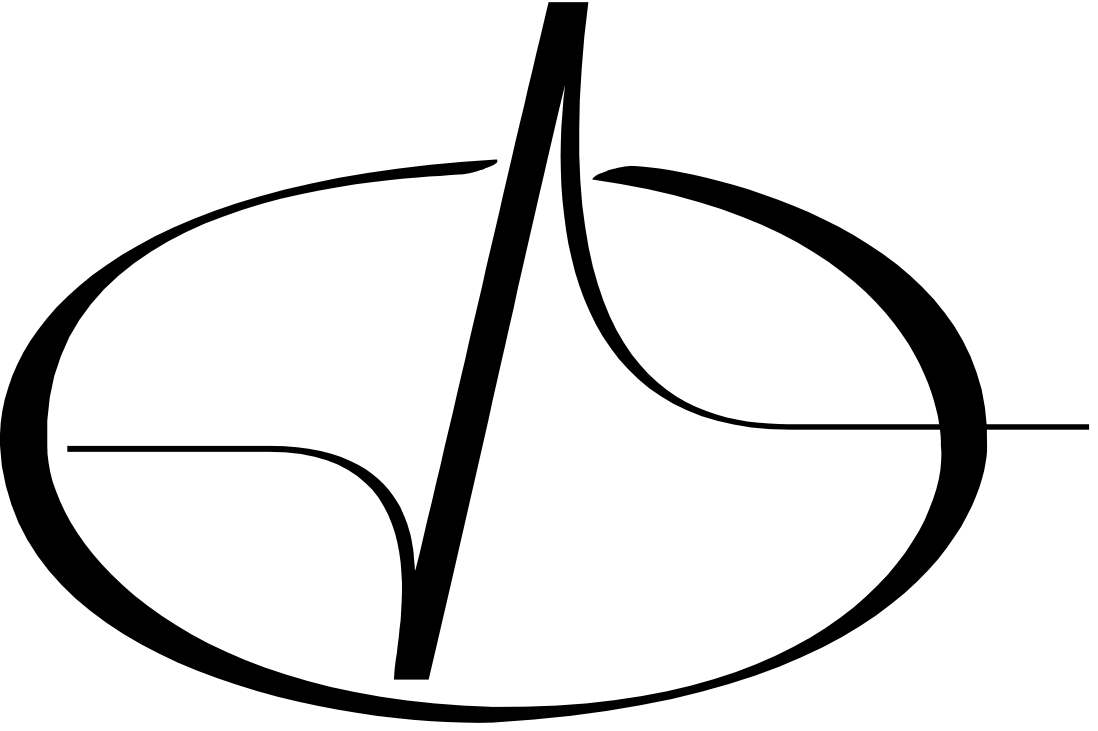
[picture p117: page 1]
