mfkiwl/SDR_SOC_doc/soc_sdr/img/LNA/sel.pdf

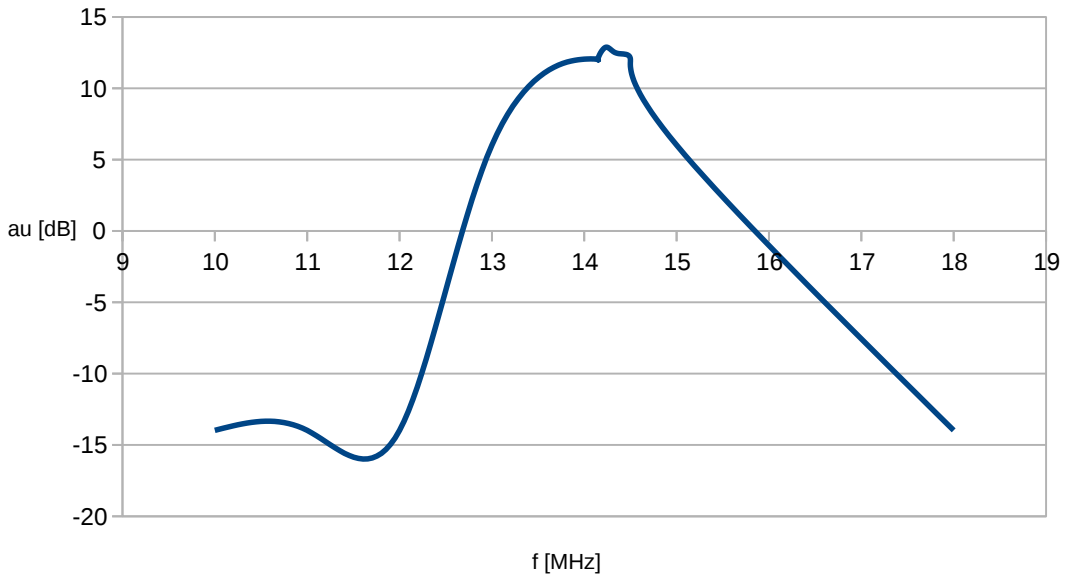
[picture p118: page 1]
f [MHz]
