mfkiwl/SDR_SOC_doc/soc_sdr/img/lo/os_b.pdf

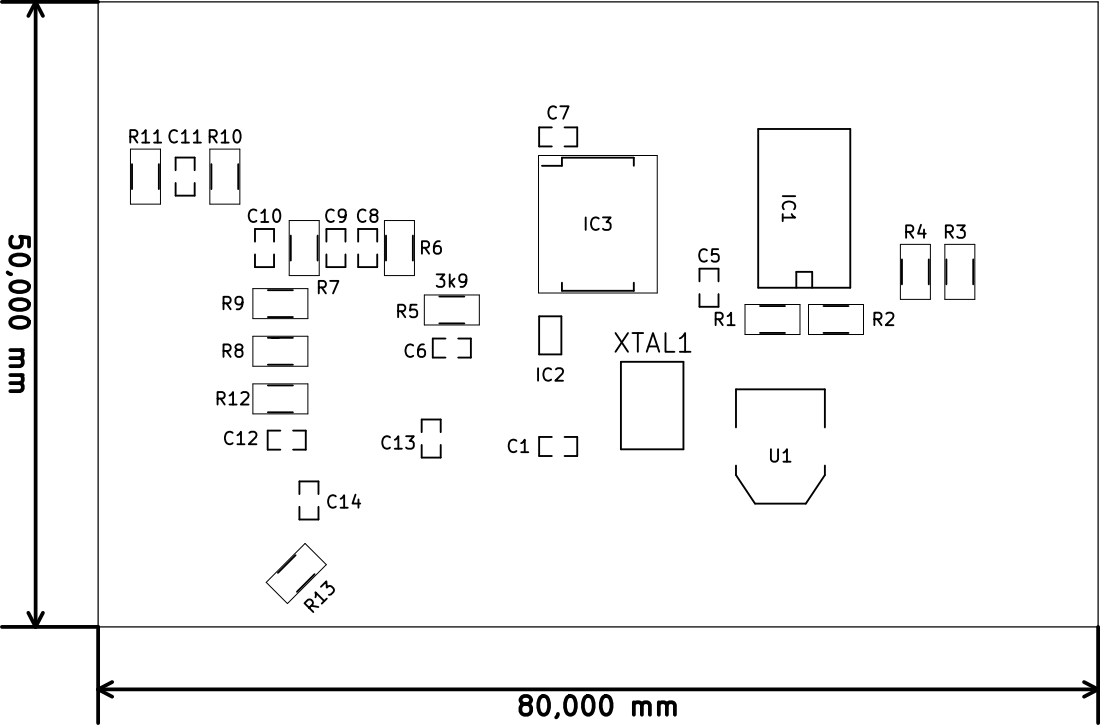
[picture p119: page 1]
