mfkiwl/SDR_SOC_doc/soc_sdr/img/mix/cu_b.pdf

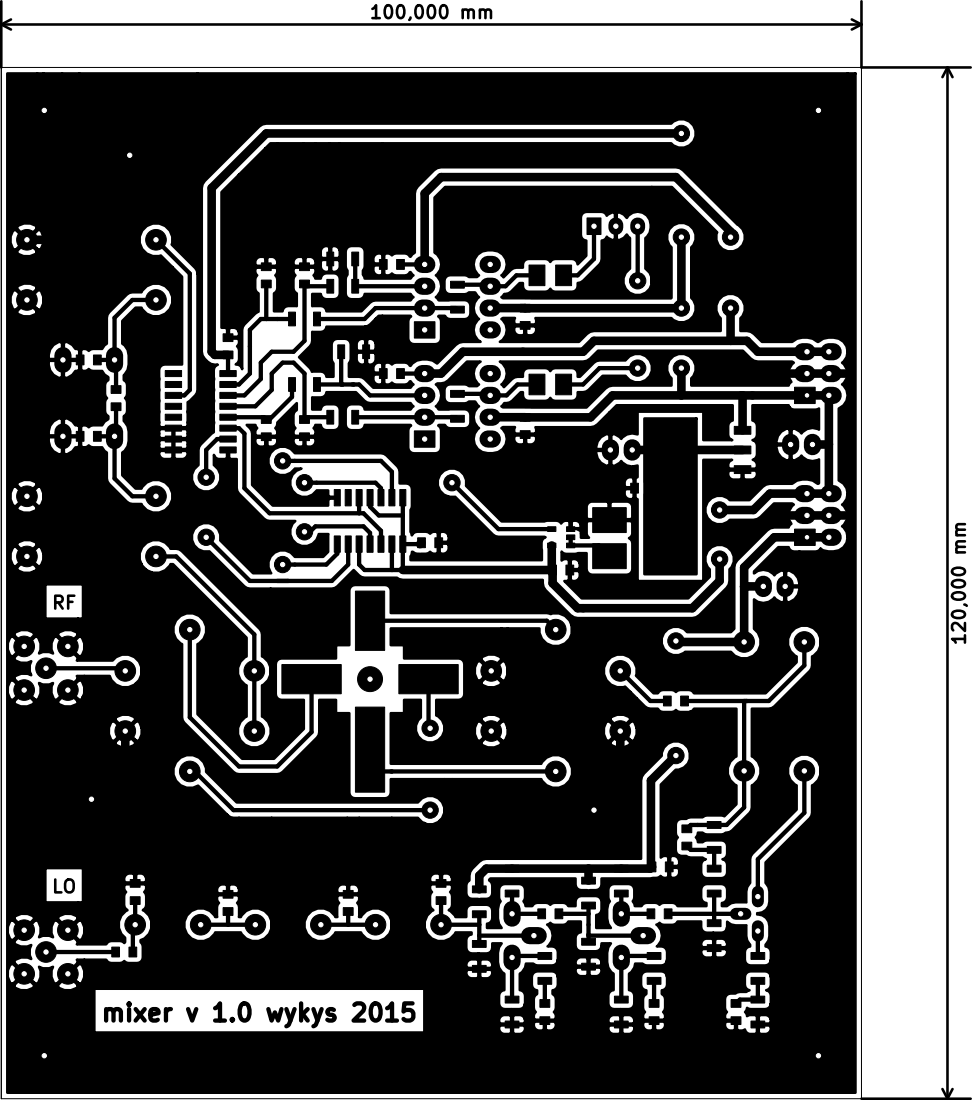
[picture p120: page 1]
