mfkiwl/SDR_SOC_doc/soc_sdr/img/mix/filtr.pdf

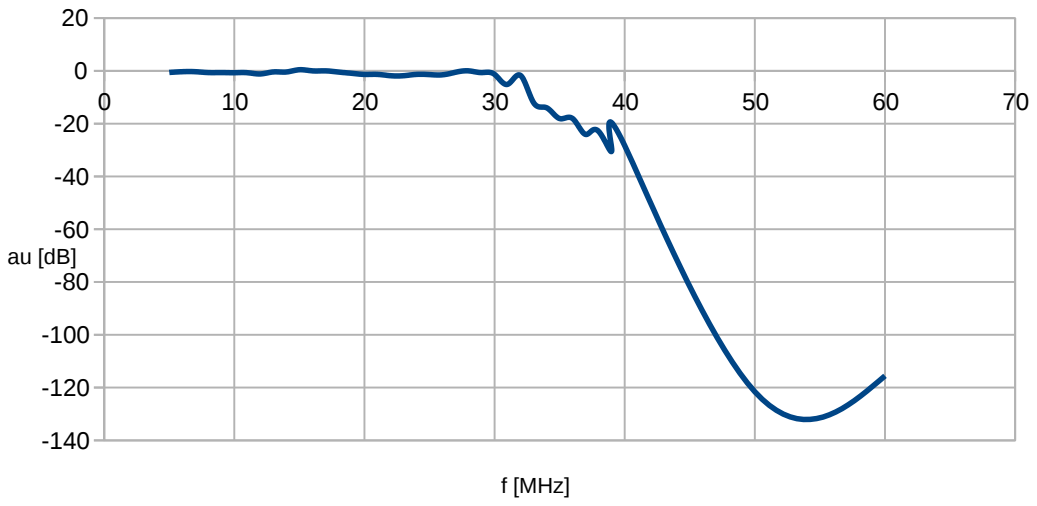
[picture p121: page 1]
f [MHz]
