mfkiwl/SDR_SOC_doc/soc_sdr/img/mix/os_b.pdf

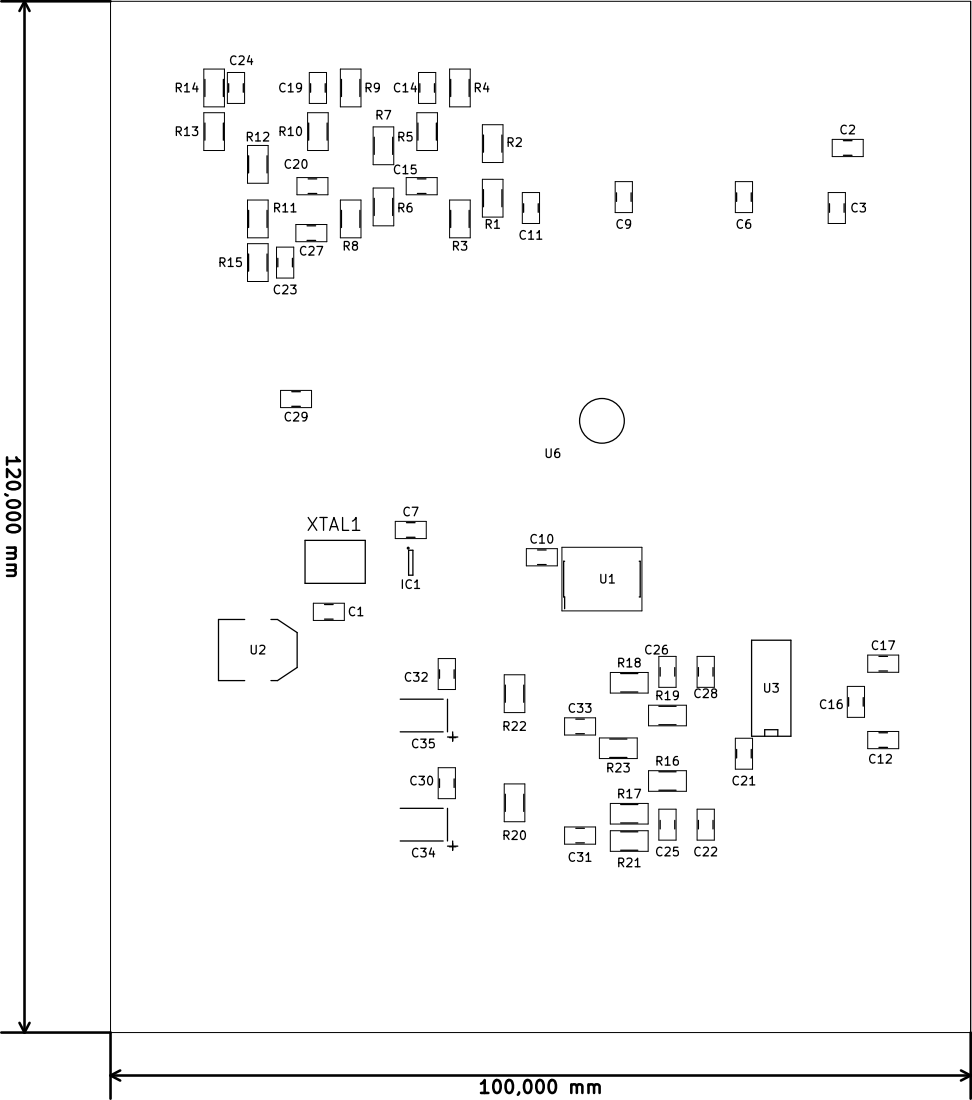
[picture p122: page 1]
