mfkiwl/SDR_SOC_doc/soc_sdr/img/mix/os_f.pdf

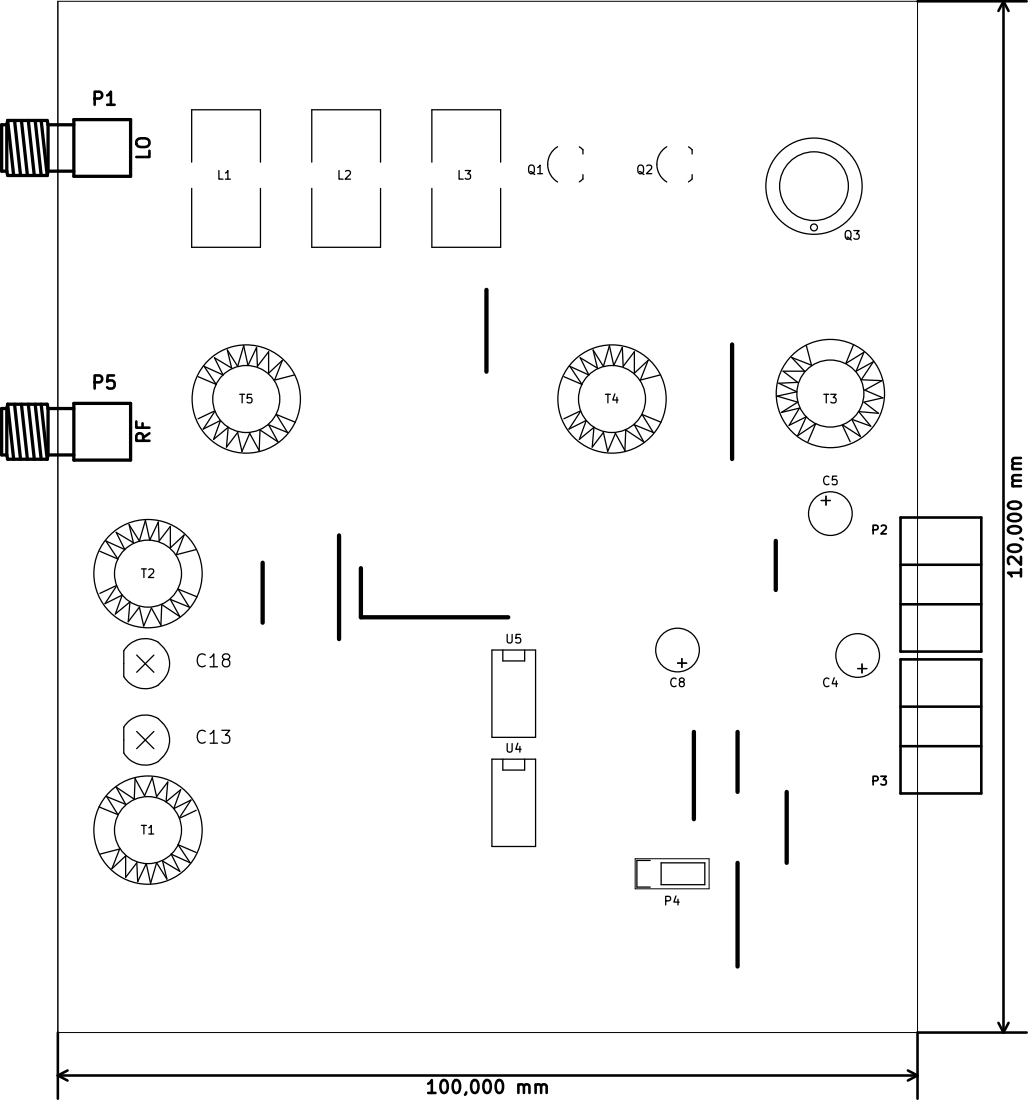
[picture p123: page 1]
