mfkiwl/SDR_SOC_doc/soc_sdr/img/zdroj/cu_b.pdf

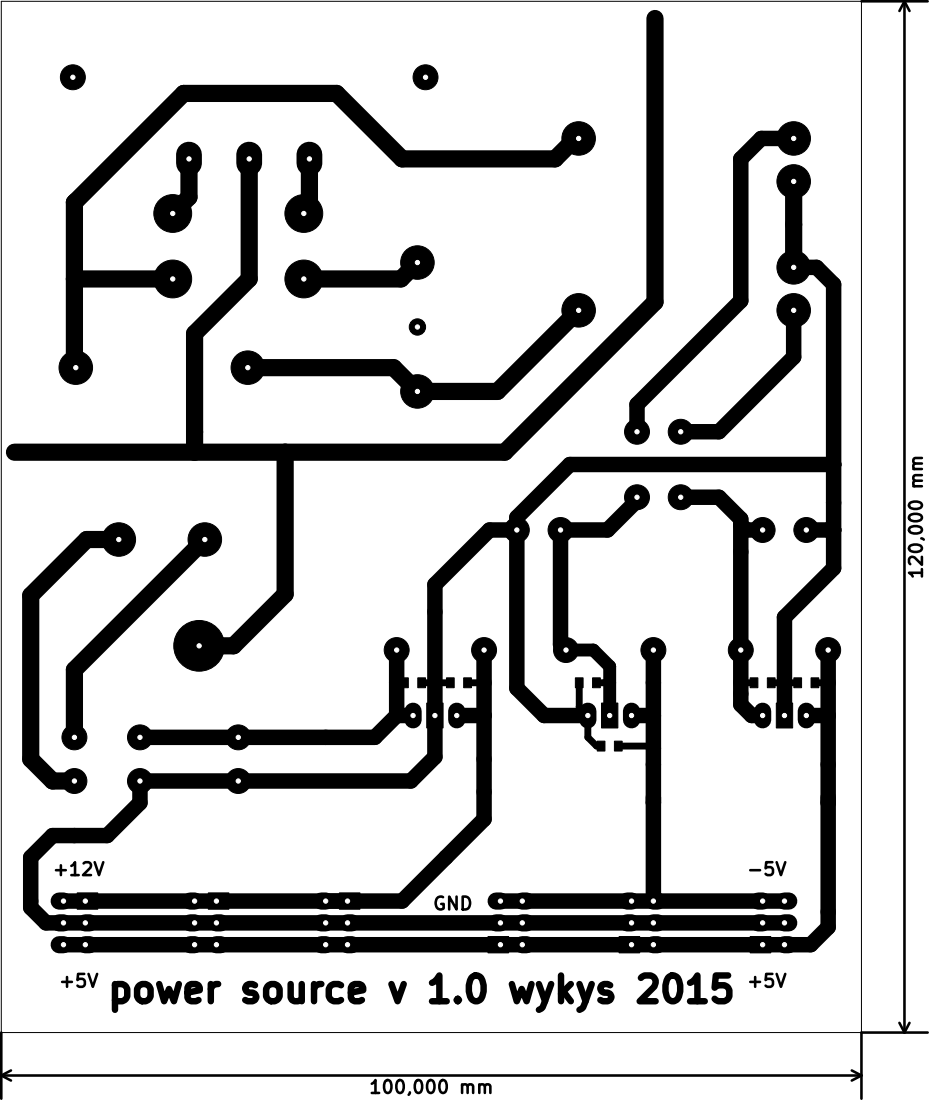
[picture p124: page 1]
