mfkiwl/SDR_SOC_doc/soc_sdr/img/zdroj/os_b.pdf

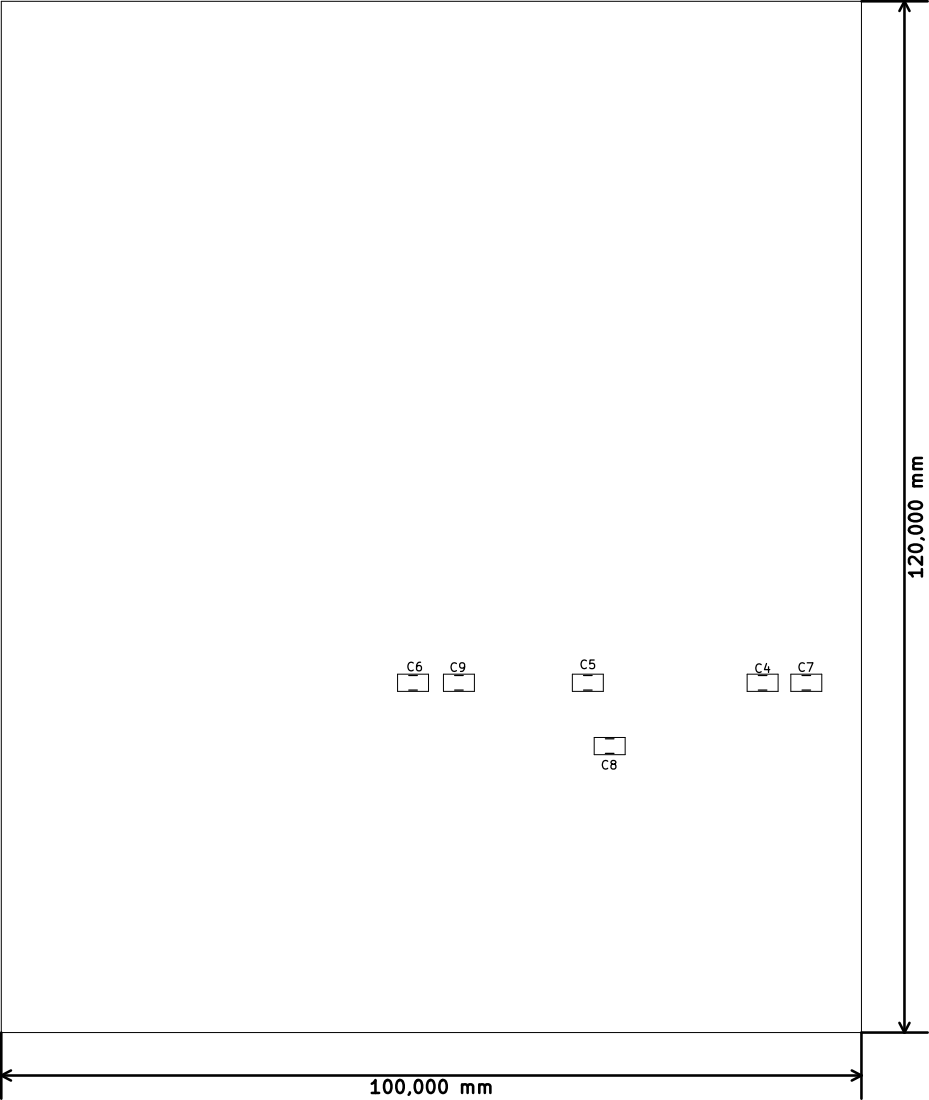
[picture p125: page 1]
