mfkiwl/SDR_SOC_doc/soc_sdr/img/zdroj/os_f.pdf

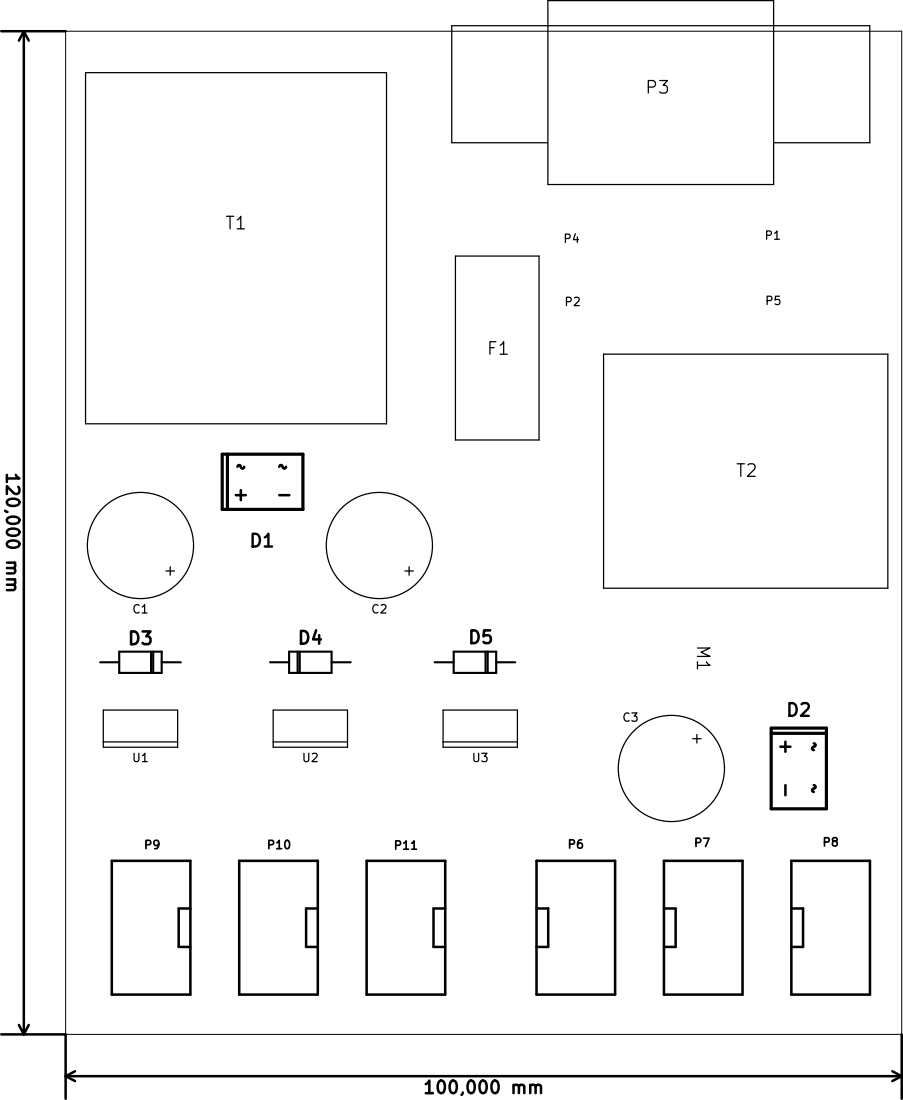
[picture p126: page 1]
