mfkiwl/SDR_SOC_doc/sdr/dds/design_v2/DDS.kicad_pcb

## KiCad design sdr/dds/design_v2/DDS.kicad_pcb (2016-03-18)

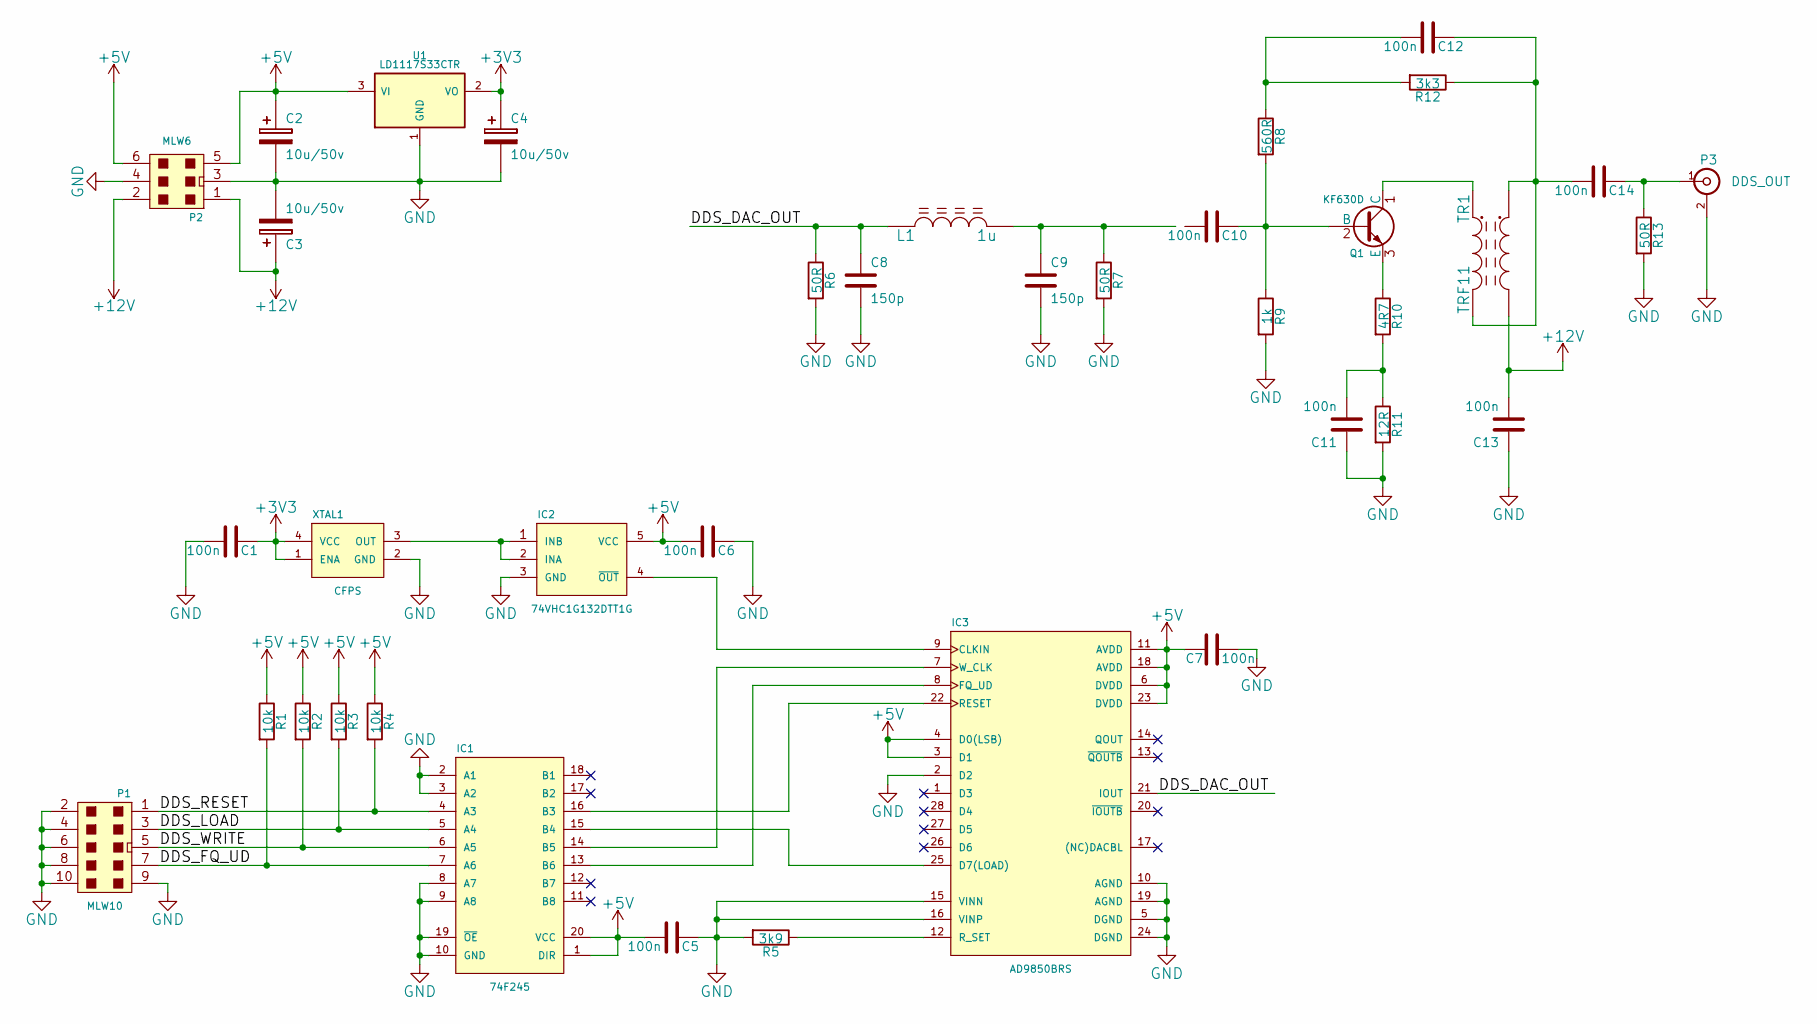
[picture p127: schematic DDS.sch, DDS with AD9850]

Parts:
C1, C5, C6, C7, C10, C11, C12, C13, C14: 100n; SMD-0805
C2, C3, C4: 10u/50v; Elko_vert_11.2x6.3mm_RM2.5
C8, C9: 150p; SMD-0805
IC1: 74F245; SO-20-L
IC2: 74VHC1G132DTT1G; SOT-23-5
IC3: AD9850BRS; SSOP-28_5.3x10.2mm_Pitch0.65mm
L1: 1u; R3-LARGE_PADS
P1: MLW10; vasch_strip_5x2_90
P2: MLW6; vasch_strip_3x2_90
P3: DDS_OUT; sma_90_r300.124.403
Q1: KF630D; OldSowjetaera_Transistor_Type-II_BigPads
R1, R2, R3, R4: 10k; R_1206
R5: 3k9; R_1206
R6, R7, R13: 50R; R_1206
R8: 560R; R_1206
R9: 1k; R_1206
R10: 4R7; R_1206
R11: 12R; R_1206
R12: 3k3; R_1206
TR1: TRF11; Transformer_Toroid_horizontal_Diameter12-5mm_Amidon-T44
U1: LD1117S33CTR; SOT-223
XTAL1: CFPS; SMD7x5

Connections:
+3V3: C1.1, C4.1, U1.2 (VO), U1.4, XTAL1.1 (ENA), XTAL1.4 (VCC)
+5V: C2.1, C5.2, C6.2, C7.2, IC1.1 (DIR), IC1.20 (VCC), IC2.5 (VCC), IC3.3 (D1), IC3.4 (D0(LSB)), IC3.6 (DVDD), IC3.11 (AVDD), IC3.18 (AVDD), IC3.23 (DVDD), P2.5, P2.6, R1.1, R2.1, R3.1, R4.1, U1.3 (VI)
+12V: C3.1, C13.2, P2.1, P2.2, TR1.4
/DDS_DAC_OUT: C8.1, IC3.21 (IOUT), L1.1, R6.1
/DDS_FQ_UD: IC1.7 (A6), P1.7, R1.2
/DDS_LOAD: IC1.5 (A4), P1.3, R3.2
/DDS_RESET: IC1.4 (A3), P1.1, R4.2
/DDS_WRITE: IC1.6 (A5), P1.5, R2.2
GND: C1.2, C2.2, C3.2, C4.2, C5.1, C6.1, C7.1, C8.2, C9.2, C11.1, C13.1, IC1.2 (A1), IC1.3 (A2), IC1.8 (A7), IC1.9 (A8), IC1.10 (GND), IC1.19 (~OE), IC2.3 (GND), IC3.2 (D2), IC3.5 (DGND), IC3.10 (AGND), IC3.15 (VINN), IC3.16 (VINP), IC3.19 (AGND), IC3.24 (DGND), P1.2, P1.4, P1.6, P1.8, P1.9, P1.10, P2.3, P2.4, P3.2 (Ext), R5.2, R6.2, R7.2, R9.2, R11.2, R13.2, U1.1 (GND), XTAL1.2 (GND)
unnamed: C10.1, Q1.2 (B), R8.2, R9.1
unnamed: C11.2, R10.2, R11.1
unnamed: C12.1, C14.2, R12.1, TR1.2, TR1.3
unnamed: C12.2, R8.1, R12.2
unnamed: C14.1, P3.1 (In), R13.1
unnamed: IC1.13 (B6), IC3.8 (FQ_UD)
unnamed: IC1.14 (B5), IC3.7 (W_CLK)
unnamed: IC1.15 (B4), IC3.25 (D7(LOAD))
unnamed: IC1.16 (B3), IC3.22 (RESET)
unnamed: IC2.1 (INB), IC2.2 (INA), XTAL1.3 (OUT)
unnamed: IC2.4 (~OUT), IC3.9 (CLKIN)
unnamed: IC3.12 (R_SET), R5.1
unnamed: Q1.1 (C), TR1.1
unnamed: Q1.3 (E), R10.1

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
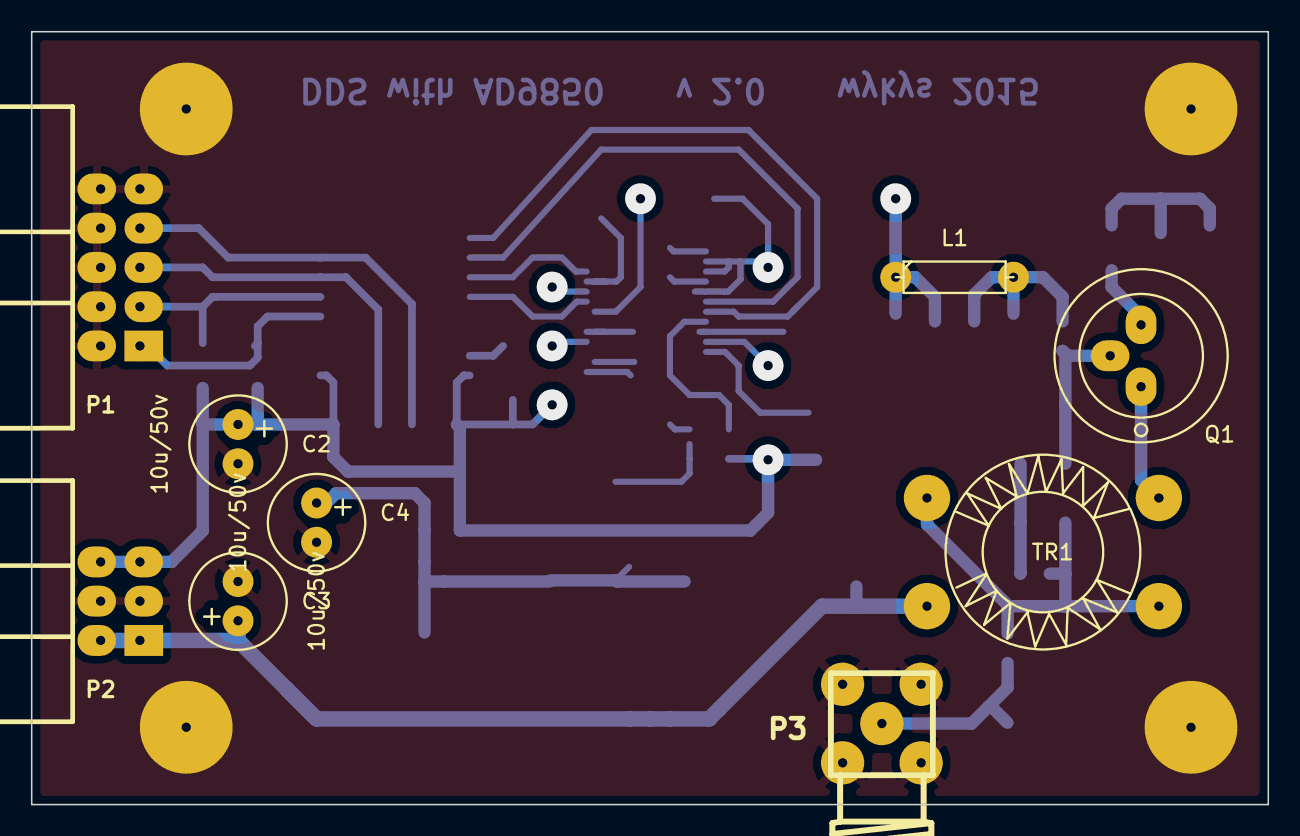
[picture p128: board DDS.kicad_pcb from above]

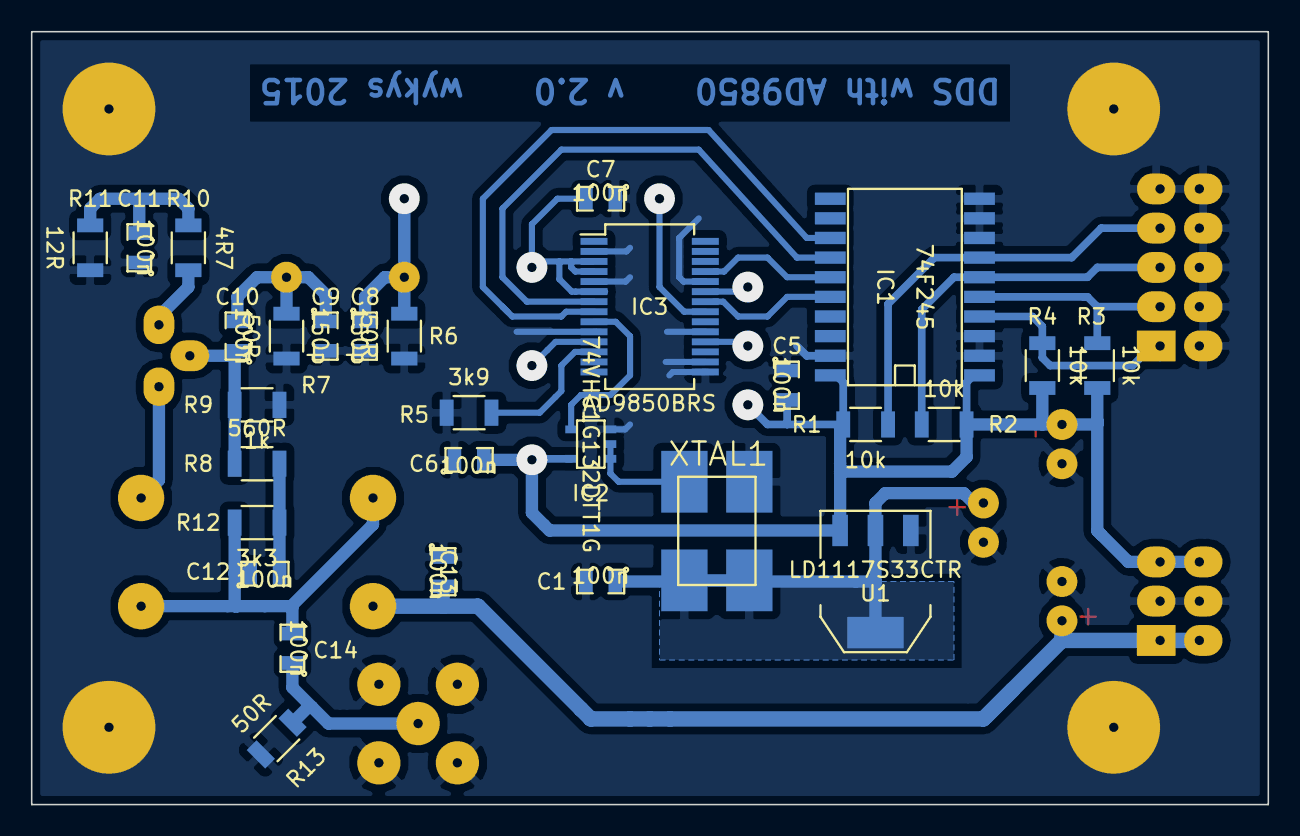
[picture p129: board DDS.kicad_pcb from below]

Board: 4 copper layers, 80.0 x 50.0 mm, 38 parts (29 on the bottom side), 24 nets.
