mfkiwl/SDR_SOC_doc/sdr/zdroj/zdroj_v1/zdroj.kicad_pcb

## KiCad design sdr/zdroj/zdroj_v1/zdroj.kicad_pcb (2016-03-18)

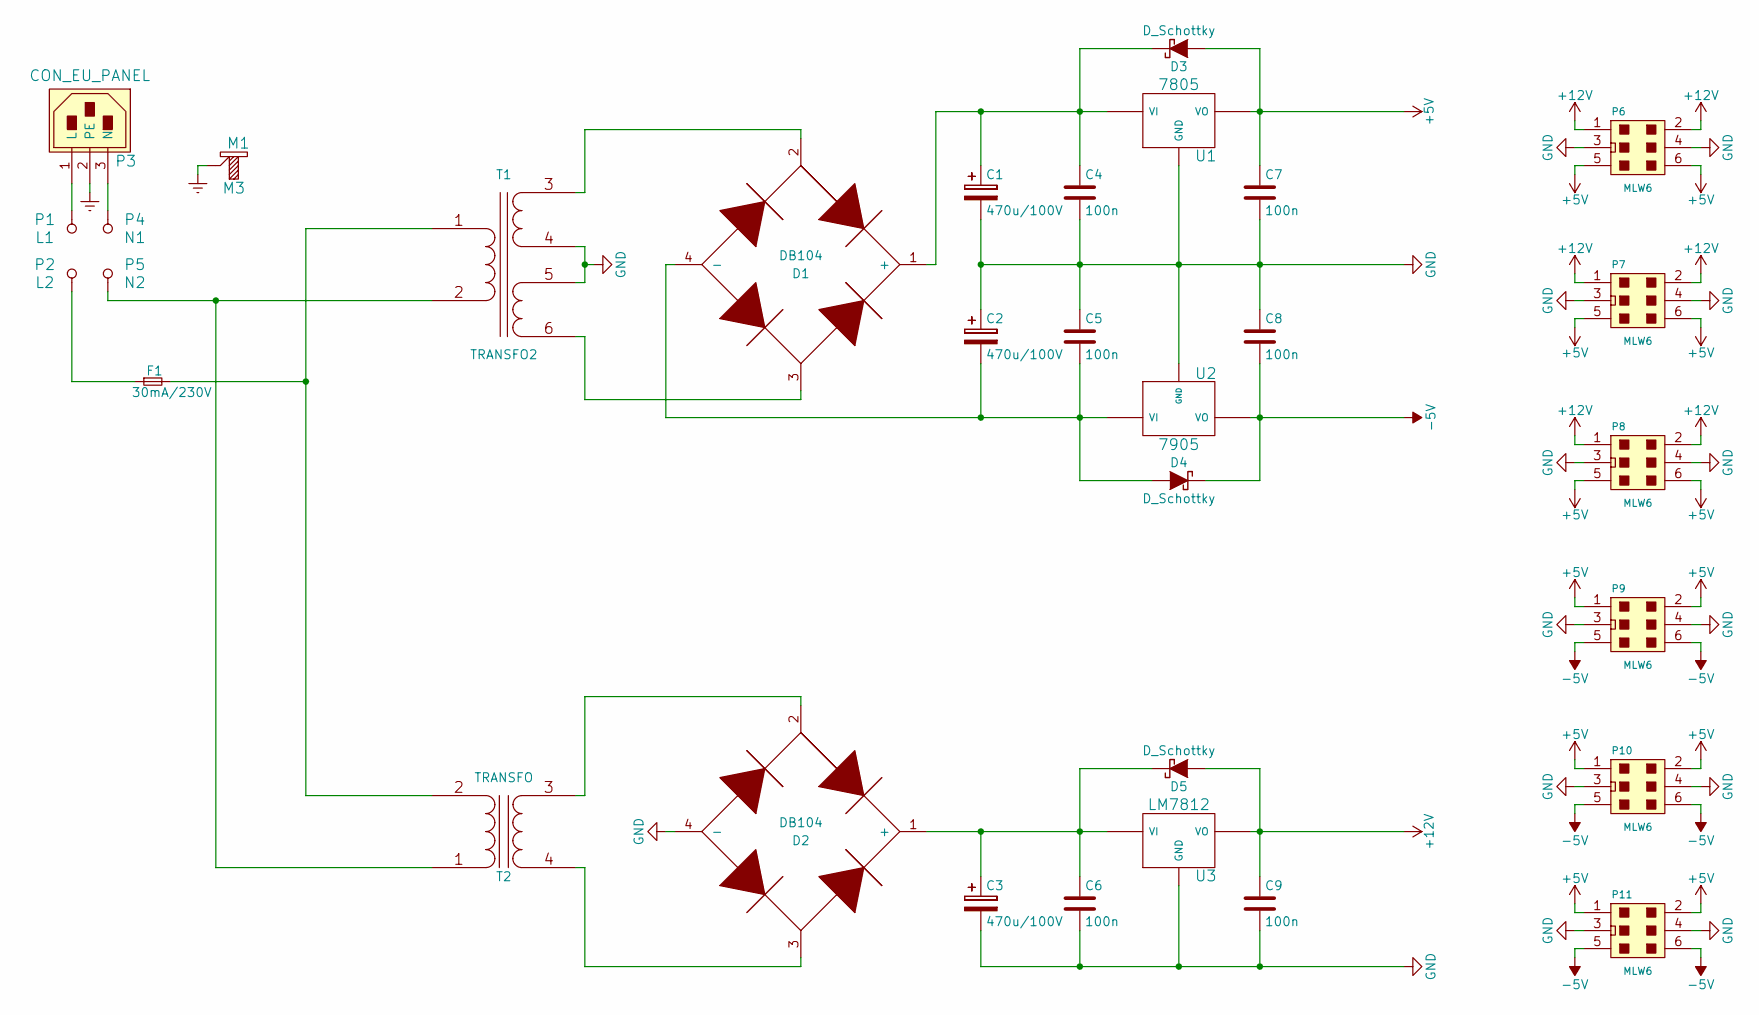
[picture p130: schematic zdroj.sch]

Parts:
C1, C2, C3: 470u/100V; Elko_vert_25x12.5mm_RM5_CopperClear
C4, C5, C6, C7, C8, C9: 100n; C_0805
D1, D2: DB104; bridge_DFM
D3, D4, D5: D_Schottky; diode_do41
F1: 30mA/230V; fuse_socket
M1: M3
P1: L1; SolderWirePad_single_2mmDrill
P2: L2; SolderWirePad_single_2mmDrill
P3: CON_EU_PANEL
P4: N1; SolderWirePad_single_2mmDrill
P5: N2; SolderWirePad_single_2mmDrill
P6, P7, P8, P9, P10, P11: MLW6; vasch_strip_3x2
T1: TRANSFO2; BV_EI_382
T2: TRANSFO; BV_EI_303
U1: 7805; LM78XXV
U2: 7905; LM79XXV
U3: LM7812; LM78XXV

Connections:
+5V: C7.1, D3.1 (A), P6.5, P6.6, P7.5, P7.6, P8.5, P8.6, P9.1, P9.2, P10.1, P10.2, P11.1, P11.2, U1.VO
+12V: C9.1, D5.1 (A), P6.1, P6.2, P7.1, P7.2, P8.1, P8.2, U3.VO
-5V: C8.2, D4.2 (K), P9.5, P9.6, P10.5, P10.6, P11.5, P11.6, U2.VO
Earth: M1.1, P3.2 (PE)
GND: C1.2, C2.1, C3.2, C4.2, C5.1, C6.2, C7.2, C8.1, C9.2, D2.4 (-), P6.3, P6.4, P7.3, P7.4, P8.3, P8.4, P9.3, P9.4, P10.3, P10.4, P11.3, P11.4, T1.4 (SB), T1.5 (SC), U1.GND, U2.GND, U3.GND
unnamed: C1.1, C4.1, D1.1 (+), D3.2 (K), U1.VI
unnamed: C2.2, C5.2, D1.4 (-), D4.1 (A), U2.VI
unnamed: C3.1, C6.1, D2.1 (+), D5.2 (K), U3.VI
unnamed: D1.2, T1.3 (SA)
unnamed: D1.3, T1.6 (SD)
unnamed: D2.2, T2.3 (SA)
unnamed: D2.3, T2.4 (SB)
unnamed: F1.1, P2.1
unnamed: F1.2, T1.1 (AA), T2.2 (AB)
unnamed: P1.1, P3.1 (L)
unnamed: P3.3 (N), P4.1
unnamed: P5.1, T1.2 (AB), T2.1 (AA)

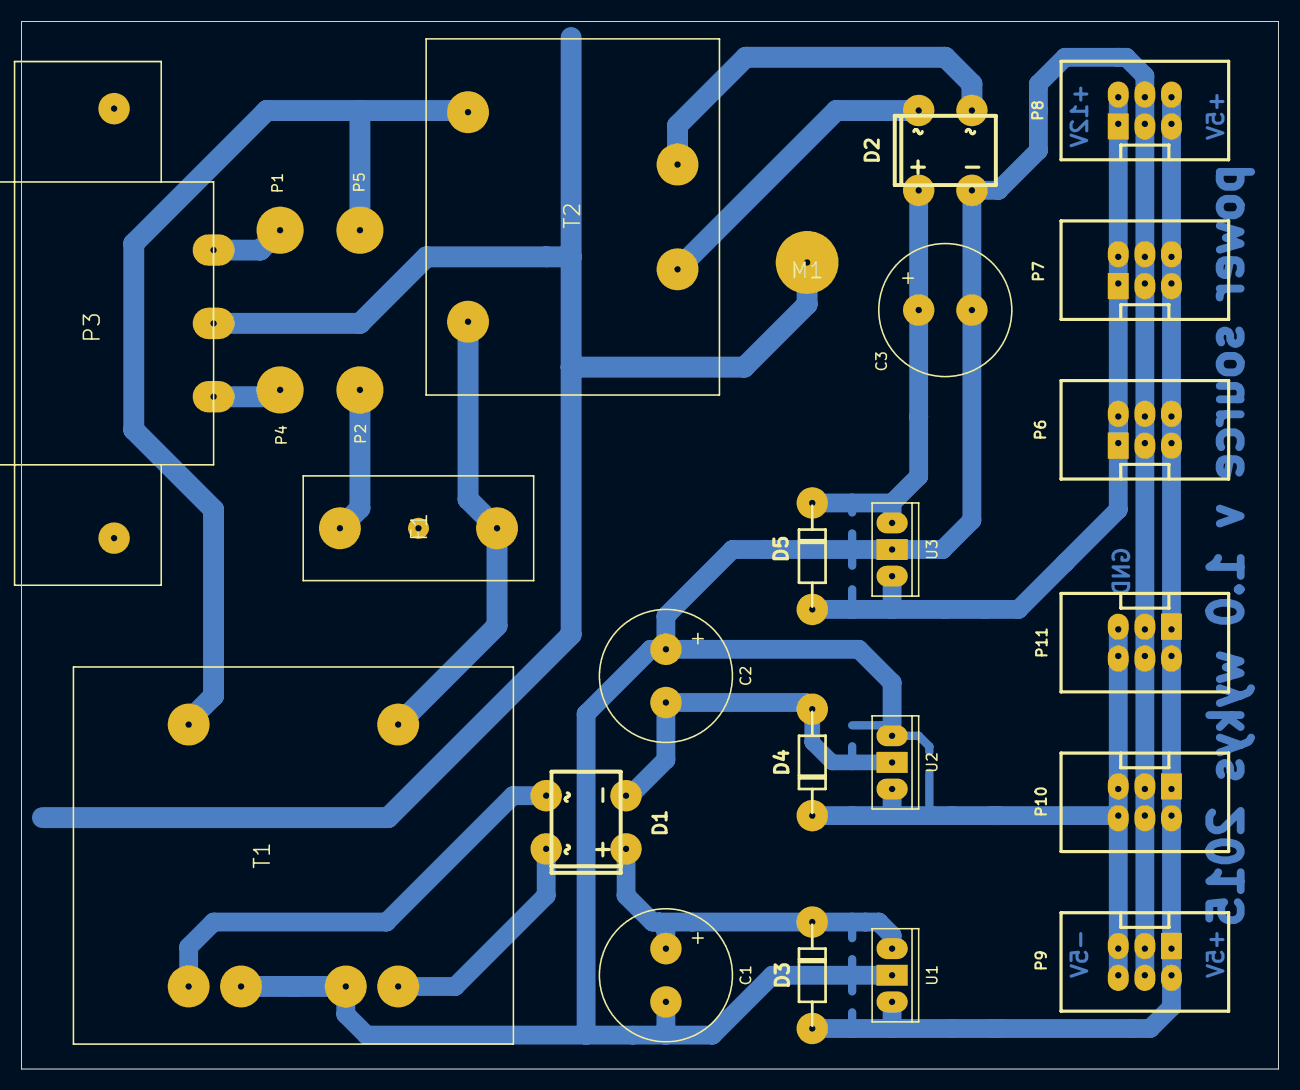
[picture p131: board zdroj.kicad_pcb from above]

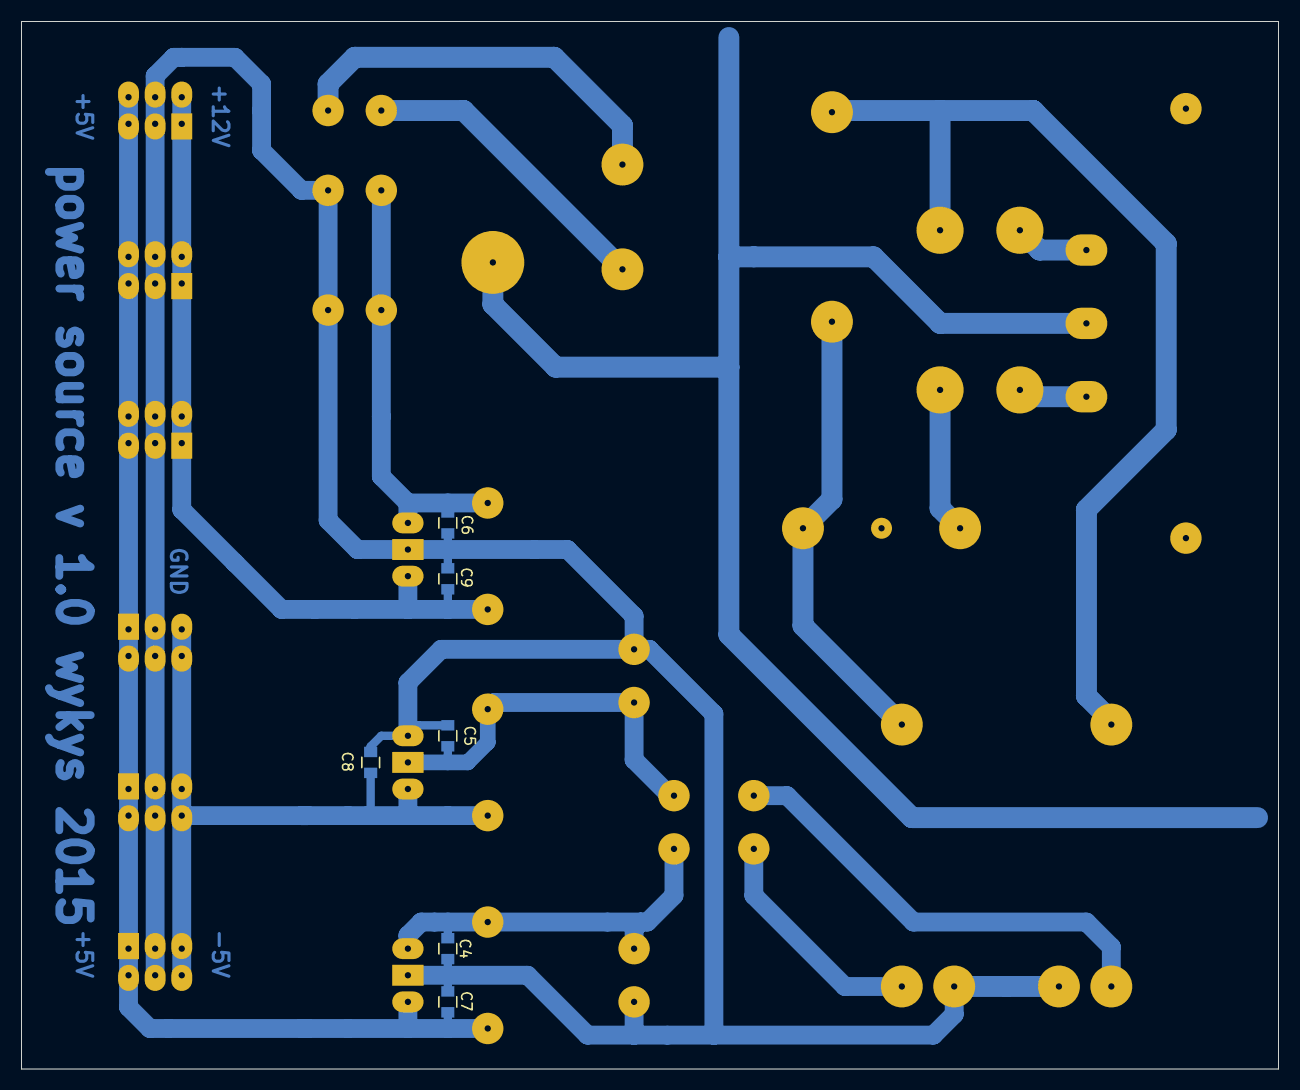
[picture p132: board zdroj.kicad_pcb from below]

Board: 2 copper layers, 120.0 x 100.0 mm, 32 parts (6 on the bottom side), 17 nets.
