mfkiwl/SDR_SOC_doc/sdr/control_board/control_board.kicad_pcb

## KiCad design sdr/control_board/control_board.kicad_pcb (2016-03-18)

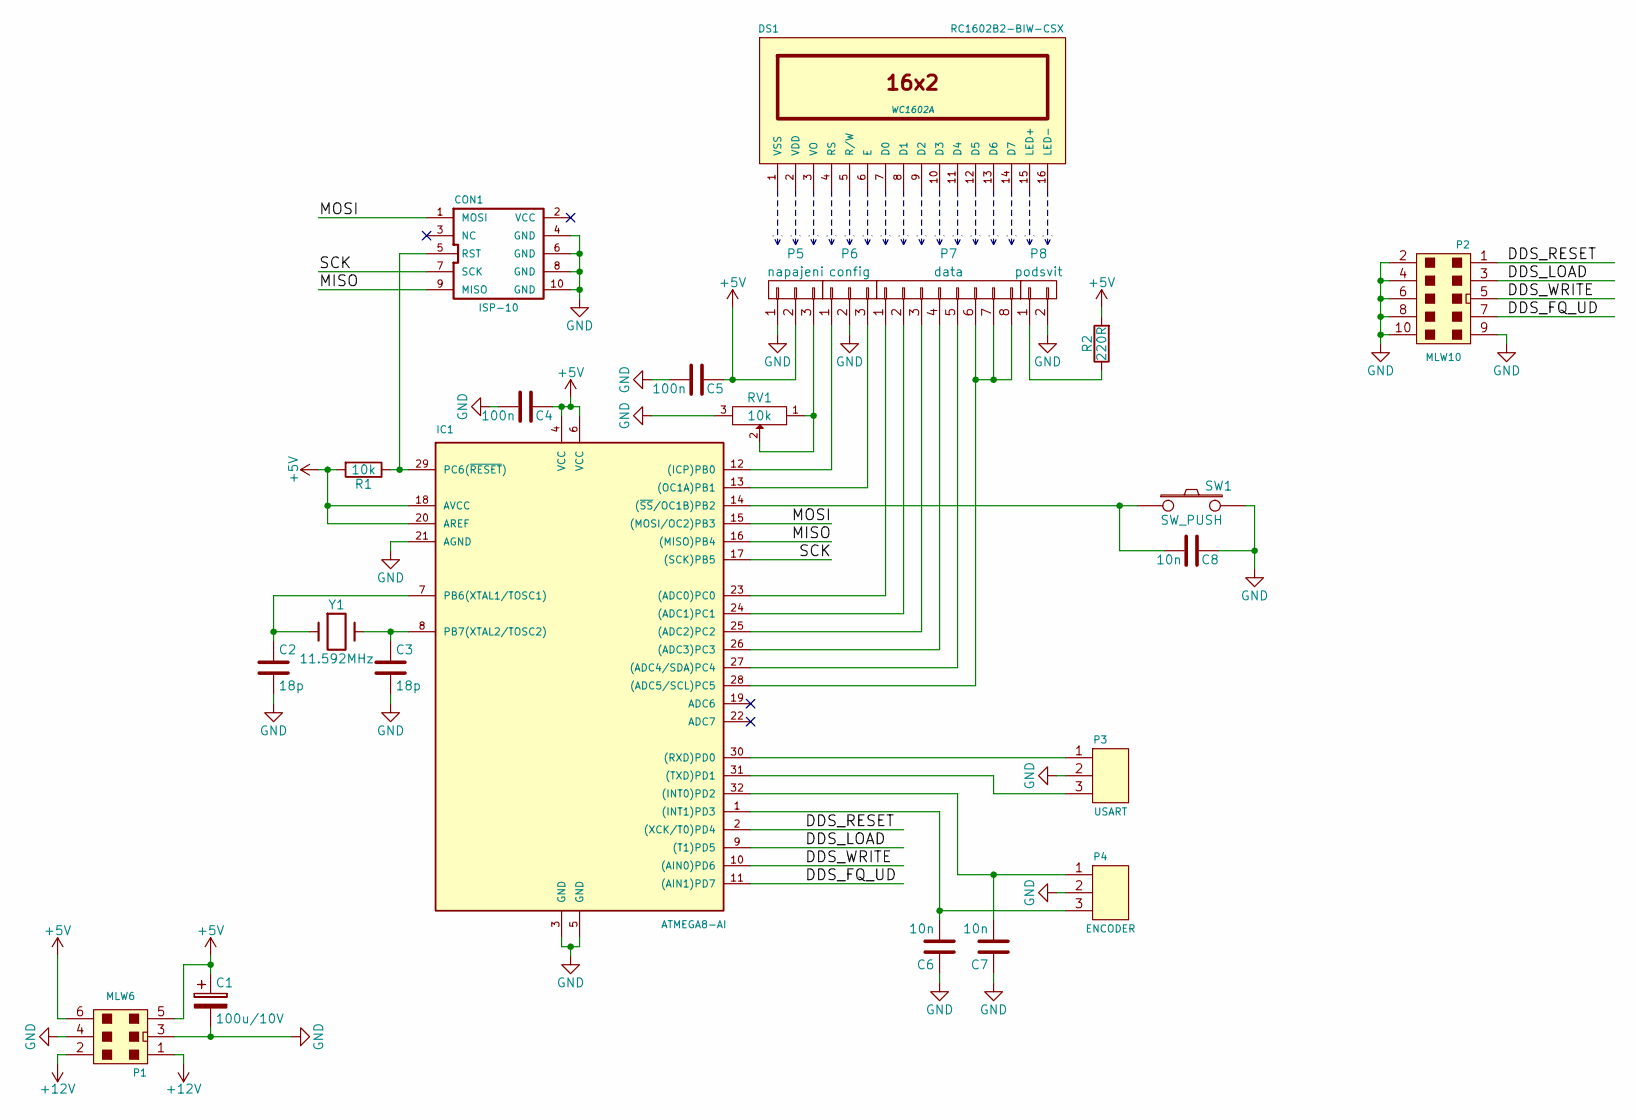
[picture p133: schematic control_board.sch]

Parts:
C1: 100u/10V; Elko_vert_11x5mm_RM2.5_CopperClear
C2, C3: 18p; C_0805
C4, C5: 100n; C_0805
C6, C7, C8: 10n; C_0805
CON1: ISP-10; vasch_strip_5x2
DS1: RC1602B2-BIW-CSX; WC1602A
IC1: ATMEGA8-AI; TQFP-32_7x7mm_Pitch0.8mm
P1: MLW6; vasch_strip_3x2_90
P2: MLW10; vasch_strip_5x2_90
P3: USART; MICROSWITCH_SPST
P4: ENCODER; MICROSWITCH_SPST
P5: napajeni; pin_socket_3
P6: config; pin_socket_3
P7: data; pin_socket_8
P8: podsvit; pin_socket_2
R1: 10k; R_1206
R2: 220R; Choke_Horizontal_RM15mm
RV1: 10k; Potentiometer_Trimmer-Suntan-TSR-3386P
SW1: SW_PUSH; Socket_MOLEX-KK-RM2-54mm_Lock_2pin_straight
Y1: 11.592MHz; Crystal_HC49-SD_SMD

Connections:
+5V: C1.1, C4.1, C5.1, IC1.4 (VCC), IC1.6 (VCC), IC1.18 (AVCC), IC1.20 (AREF), P1.5, P1.6, P5.2, R1.2, R2.2
+12V: P1.1, P1.2
/DDS_FQ_UD: IC1.11 ((AIN1)PD7), P2.7
/DDS_LOAD: IC1.9 ((T1)PD5), P2.3
/DDS_RESET: IC1.2 ((XCK/T0)PD4), P2.1
/DDS_WRITE: IC1.10 ((AIN0)PD6), P2.5
/MISO: CON1.9 (MISO), IC1.16 ((MISO)PB4)
/MOSI: CON1.1 (MOSI), IC1.15 ((MOSI/OC2)PB3)
/SCK: CON1.7 (SCK), IC1.17 ((SCK)PB5)
GND: C1.2, C2.2, C3.2, C4.2, C5.2, C6.1, C7.1, C8.1, CON1.4 (GND), CON1.6 (GND), CON1.8 (GND), CON1.10 (GND), IC1.3 (GND), IC1.5 (GND), IC1.21 (AGND), P1.3, P1.4, P2.2, P2.4, P2.6, P2.8, P2.9, P2.10, P3.2, P4.2, P5.1, P6.2, P8.2, RV1.3, SW1.2
unnamed: C2.1, IC1.7 (PB6(XTAL1/TOSC1)), Y1.1
unnamed: C3.1, IC1.8 (PB7(XTAL2/TOSC2)), Y1.2
unnamed: C6.2, IC1.1 ((INT1)PD3), P4.3
unnamed: C7.2, IC1.32 ((INT0)PD2), P4.1
unnamed: C8.2, IC1.14 ((~SS~/OC1B)PB2), SW1.1
unnamed: CON1.5 (RST), IC1.29 (PC6(~RESET~)), R1.1
unnamed: IC1.12 ((ICP)PB0), P6.1
unnamed: IC1.13 ((OC1A)PB1), P6.3
unnamed: IC1.23 ((ADC0)PC0), P7.1
unnamed: IC1.24 ((ADC1)PC1), P7.2
unnamed: IC1.25 ((ADC2)PC2), P7.3
unnamed: IC1.26 ((ADC3)PC3), P7.4
unnamed: IC1.27 ((ADC4/SDA)PC4), P7.5
unnamed: IC1.30 ((RXD)PD0), P3.1
unnamed: IC1.31 ((TXD)PD1), P3.3
unnamed: P5.3, RV1.1, RV1.2
unnamed: P8.1, R2.1

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
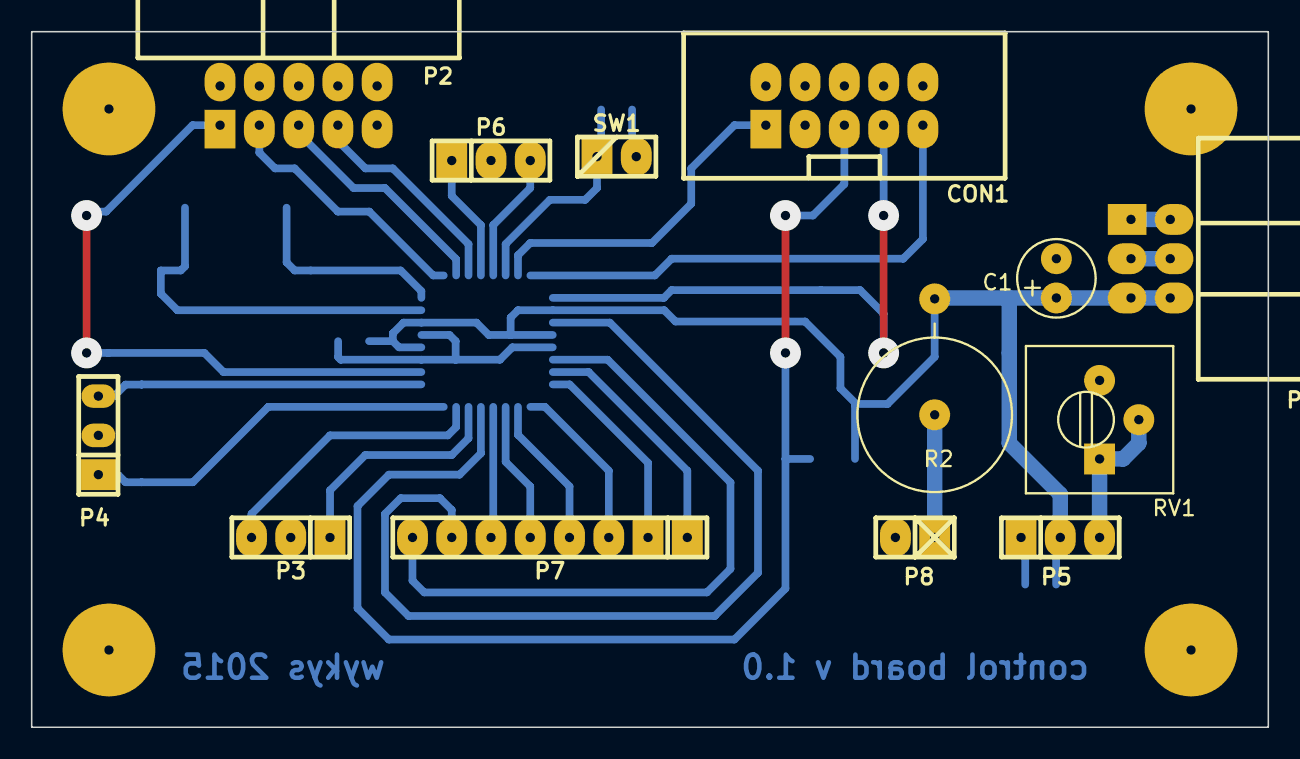
[picture p134: board control_board.kicad_pcb from above]

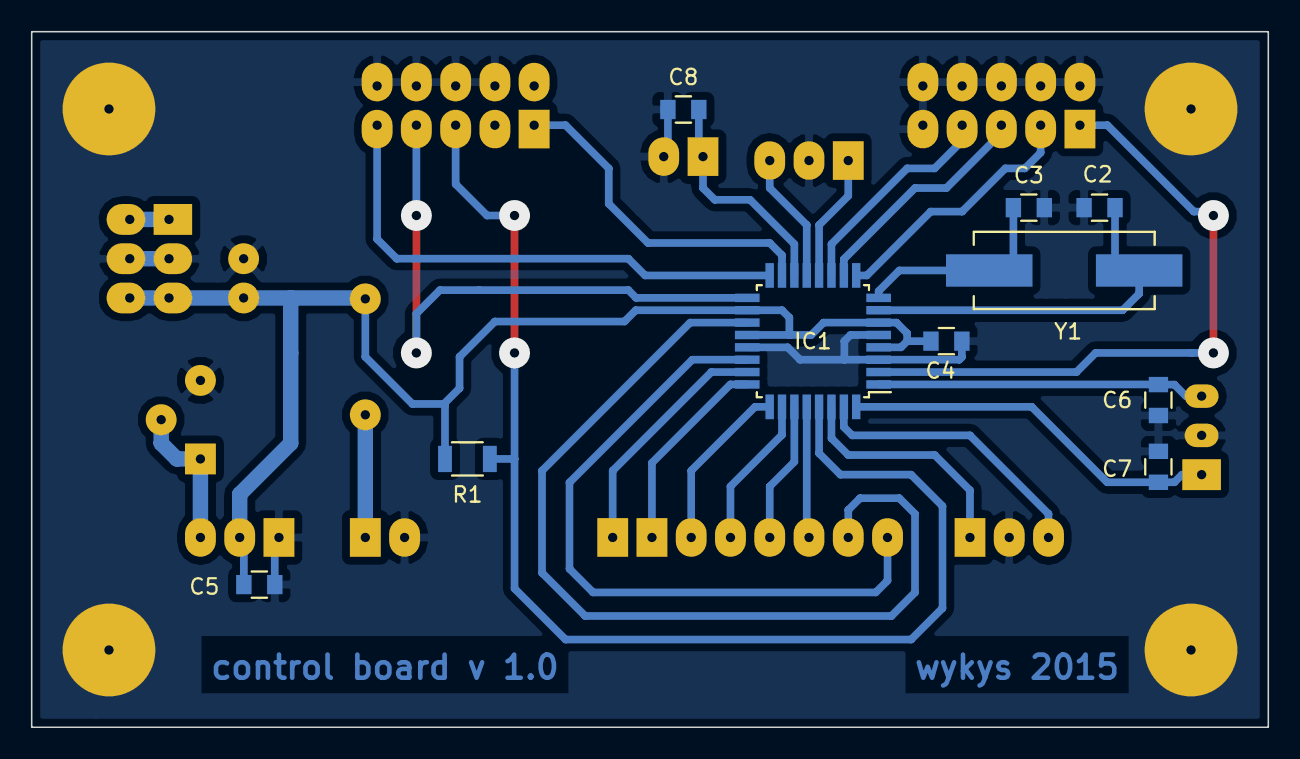
[picture p135: board control_board.kicad_pcb from below]

Board: 4 copper layers, 80.0 x 45.0 mm, 23 parts (10 on the bottom side), 30 nets.
