mfkiwl/SDR_SOC_doc/sdr/MIXER/mixer.kicad_pcb

## KiCad design sdr/MIXER/mixer.kicad_pcb (2016-03-18)

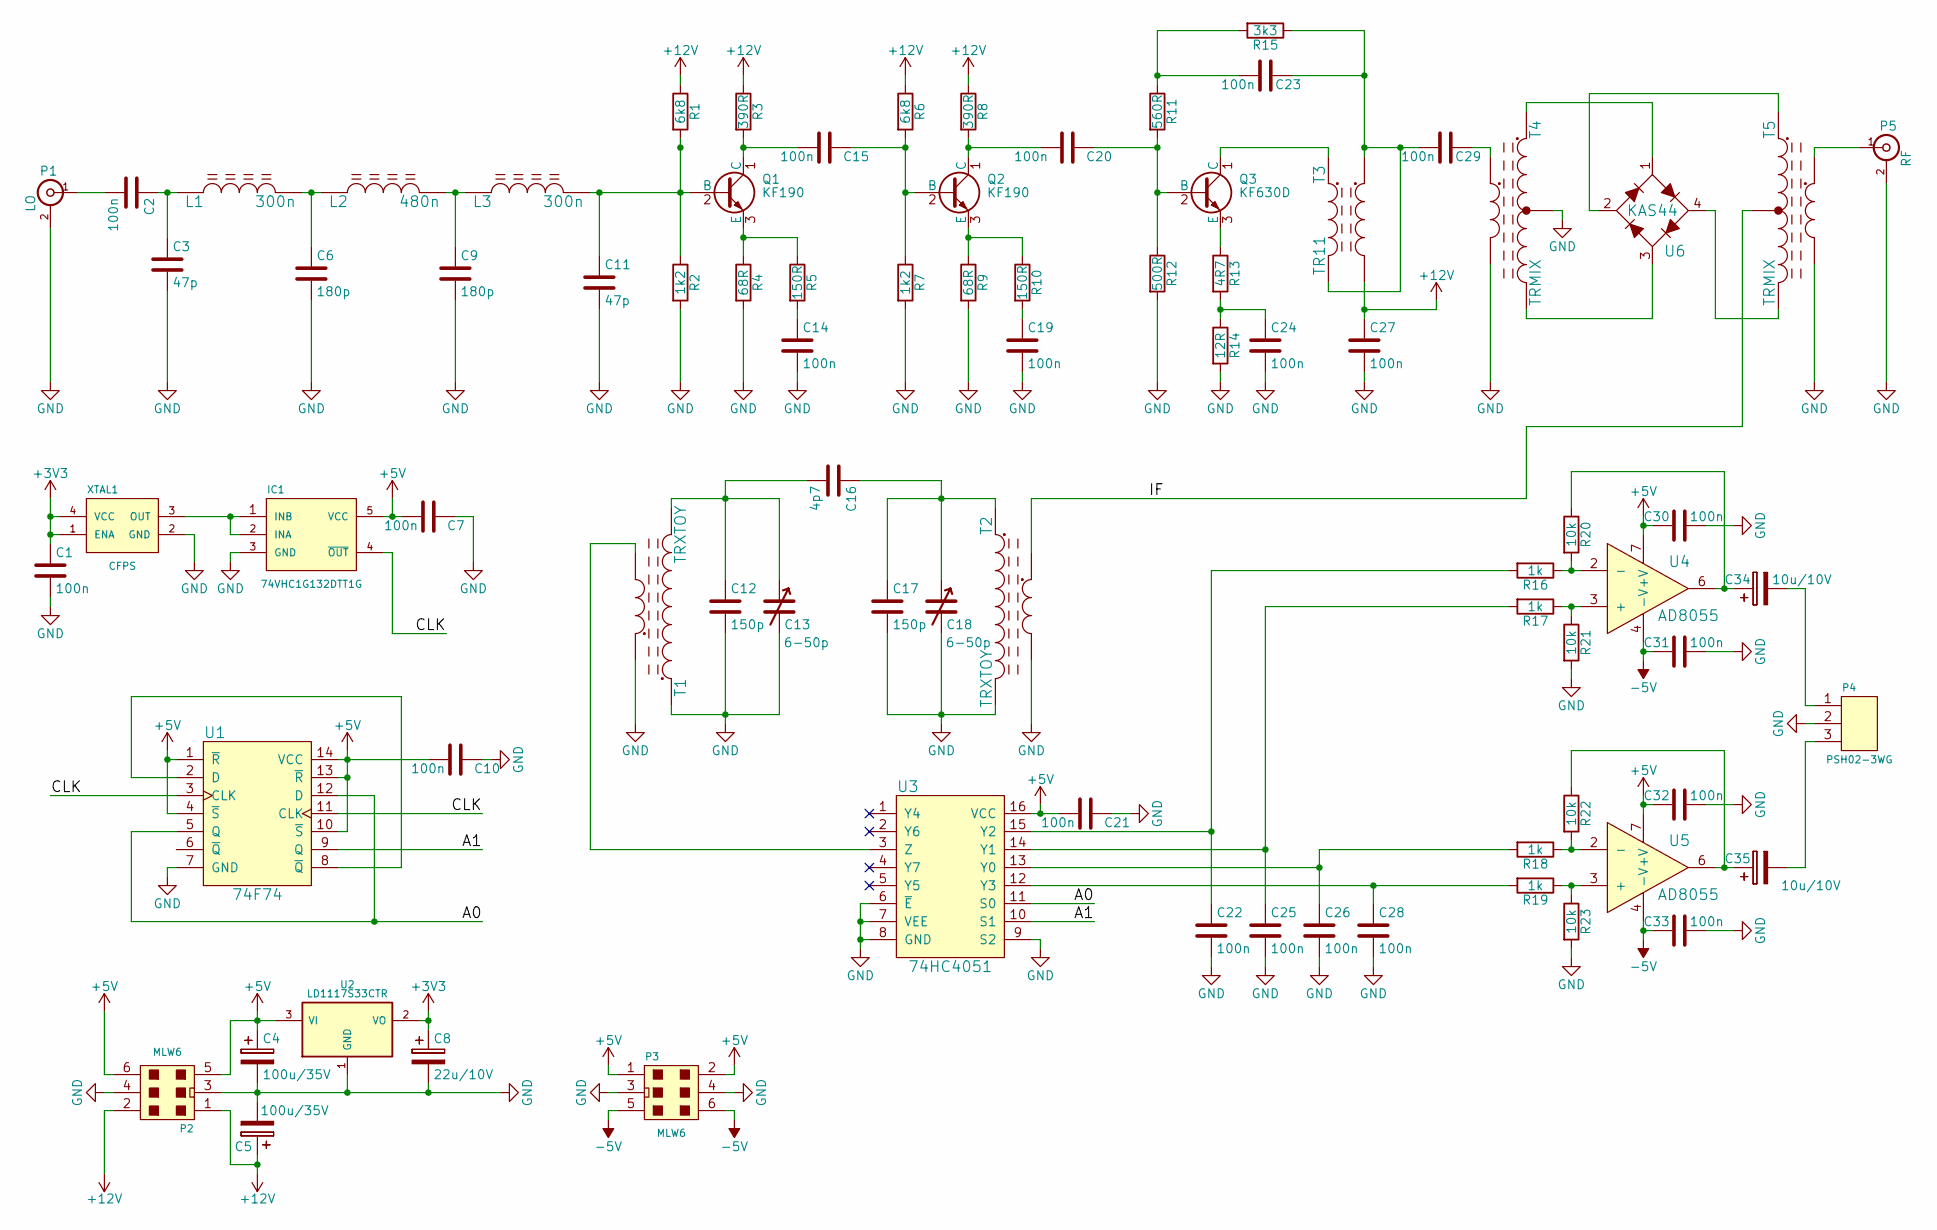
[picture p136: schematic mixer.sch]

Parts:
C1, C2, C7, C10, C14, C15, C19, C20, C21, C22, C23, C24, C25, C26, C27, C28, C29, C30, C31, C32, C33: 100n; C_0805
C3, C11: 47p; C_0805
C4, C5: 100u/35V; Elko_vert_11x5mm_RM2.5
C6, C9: 180p; C_0805
C8: 22u/10V; Elko_vert_11x5mm_RM2.5
C12, C17: 150p; C_0805
C13, C18: 6-50p; CT-6-50p
C16: 4p7; C_0805
C34, C35: 10u/10V; TantalC_SizeB_EIA-3528_Reflow
IC1: 74VHC1G132DTT1G; SOT-23-5
L1, L3: 300n; Choke_Toroid_8x16mm_Vertical
L2: 480n; Choke_Toroid_8x16mm_Vertical
P1: LO; sma_90_r300.124.403
P2, P3: MLW6; vasch_strip_3x2_90
P4: PSH02-3WG; Socket_Strip_Straight_1x03
P5: RF; sma_90_r300.124.403
Q1, Q2: KF190; TO-92_Inline_Narrow_Oval
Q3: KF630D; OldSowjetaera_Transistor_Type-II_BigPads
R1, R6: 6k8; R_1206
R2, R7: 1k2; R_1206
R3, R8: 390R; R_1206
R4, R9: 68R; R_1206
R5, R10: 150R; R_1206
R11: 560R; R_1206
R12: 500R; R_1206
R13: 4R7; R_1206
R14: 12R; R_1206
R15: 3k3; R_1206
R16, R17, R18, R19: 1k; R_1206
R20, R21, R22, R23: 10k; R_1206
T1, T2: TRXTOY; Transformer_Toroid_horizontal_Diameter12-5mm_Amidon-T44
T3: TR11; Transformer_Toroid_horizontal_Diameter12-5mm_Amidon-T44
T4, T5: TRMIX; Transformer_Toroid_Tapped_horizontal_Diameter12-5mm_Amidon-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
U1: 74F74; SOIC-14_3.9x8.7mm_Pitch1.27mm
U2: LD1117S33CTR; SOT-223
U3: 74HC4051; SO-16-N
U4, U5: AD8055; DIP-8__300_ELL
U6: KAS44; PowerMacro_PackageStyle-M234_NoHole_Housing
XTAL1: CFPS; SMD7x5

Connections:
+3V3: C1.1, C8.1, U2.2 (VO), U2.4, XTAL1.1 (ENA), XTAL1.4 (VCC)
+5V: C4.1, C7.2, C10.2, C21.2, C30.1, C32.1, IC1.5 (VCC), P2.5, P2.6, P3.1, P3.2, U1.1 (~R), U1.4 (~S), U1.10 (~S), U1.13 (~R), U1.14 (VCC), U2.3 (VI), U3.16 (VCC), U4.7 (+V), U5.7 (+V)
+12V: C5.1, C27.1, P2.1, P2.2, R1.1, R3.1, R6.1, R8.1, T3.4
-5V: C31.1, C33.1, P3.5, P3.6, U4.4 (-V), U5.4 (-V)
/A0: U1.5 (Q), U1.12 (D), U3.11 (S0)
/A1: U1.9 (Q), U3.10 (S1)
/CLK: IC1.4 (~OUT), U1.3 (CLK), U1.11 (CLK)
/IF: T2.3, T5.2
GND: C1.2, C3.2, C4.2, C5.2, C6.2, C7.1, C8.2, C9.2, C10.1, C11.2, C12.2, C13.2, C14.2, C17.2, C18.2, C19.2, C21.1, C22.2, C24.2, C25.2, C26.2, C27.2, C28.2, C30.2, C31.2, C32.2, C33.2, IC1.3 (GND), P1.2 (Ext), P2.3, P2.4, P3.3, P3.4, P4.2, P5.2 (Ext), R2.2, R4.2, R7.2, R9.2, R12.2, R14.2, R21.2, R23.2, T1.1, T1.3, T2.2, T2.4, T4.2, T4.5, T5.5, U1.7 (GND), U2.1 (GND), U3.6 (~E), U3.7 (VEE), U3.8 (GND), U3.9 (S2), XTAL1.2 (GND)
unnamed: C2.1, C3.1, L1.1
unnamed: C2.2, P1.1 (In)
unnamed: C6.1, L1.2, L2.1
unnamed: C9.1, L2.2, L3.1
unnamed: C11.1, L3.2, Q1.2 (B), R1.2, R2.1
unnamed: C12.1, C13.1, C16.2, T1.2
unnamed: C14.1, R5.2
unnamed: C15.1, Q2.2 (B), R6.2, R7.1
unnamed: C15.2, Q1.1 (C), R3.2
unnamed: C16.1, C17.1, C18.1, T2.1
unnamed: C19.1, R10.2
unnamed: C20.1, Q3.2 (B), R11.2, R12.1
unnamed: C20.2, Q2.1 (C), R8.2
unnamed: C22.1, R16.2, U3.15 (Y2)
unnamed: C23.1, C29.2, R15.1, T3.2, T3.3
unnamed: C23.2, R11.1, R15.2
unnamed: C24.1, R13.2, R14.1
unnamed: C25.1, R17.2, U3.14 (Y1)
unnamed: C26.1, R18.2, U3.13 (Y0)
unnamed: C28.1, R19.2, U3.12 (Y3)
unnamed: C29.1, T4.4
unnamed: C34.1, R20.1, U4.6
unnamed: C34.2, P4.1
unnamed: C35.1, R22.1, U5.6
unnamed: C35.2, P4.3
unnamed: IC1.1 (INB), IC1.2 (INA), XTAL1.3 (OUT)
unnamed: P5.1 (In), T5.4
unnamed: Q1.3 (E), R4.1, R5.1
unnamed: Q2.3 (E), R9.1, R10.1
unnamed: Q3.1 (C), T3.1
unnamed: Q3.3 (E), R13.1
unnamed: R16.1, R20.2, U4.2 (-)
unnamed: R17.1, R21.1, U4.3 (+)
unnamed: R18.1, R22.2, U5.2 (-)
unnamed: R19.1, R23.1, U5.3 (+)
unnamed: T1.4, U3.3 (Z)
unnamed: T4.1, U6.1
unnamed: T4.3, U6.3
unnamed: T5.1, U6.2
unnamed: T5.3, U6.4
unnamed: U1.2 (D), U1.8 (~Q)
