mfkiwl/SDR_SOC_doc/sdr/MIXER/mixer.kicad_pcb

## KiCad design sdr/MIXER/mixer.kicad_pcb (continued)

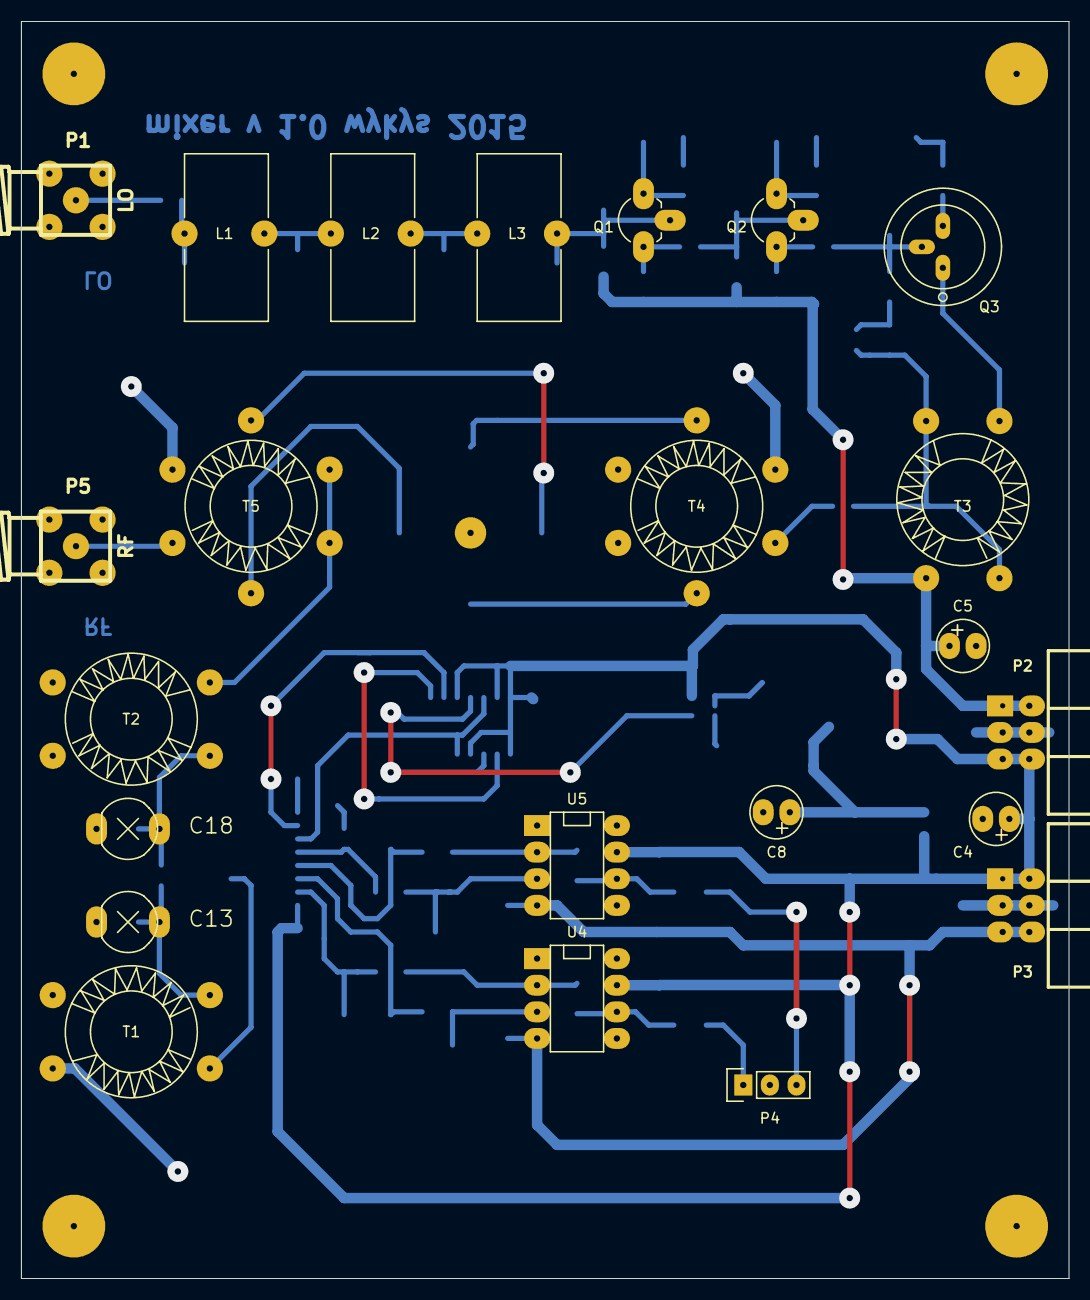
[picture p137: board mixer.kicad_pcb from above]

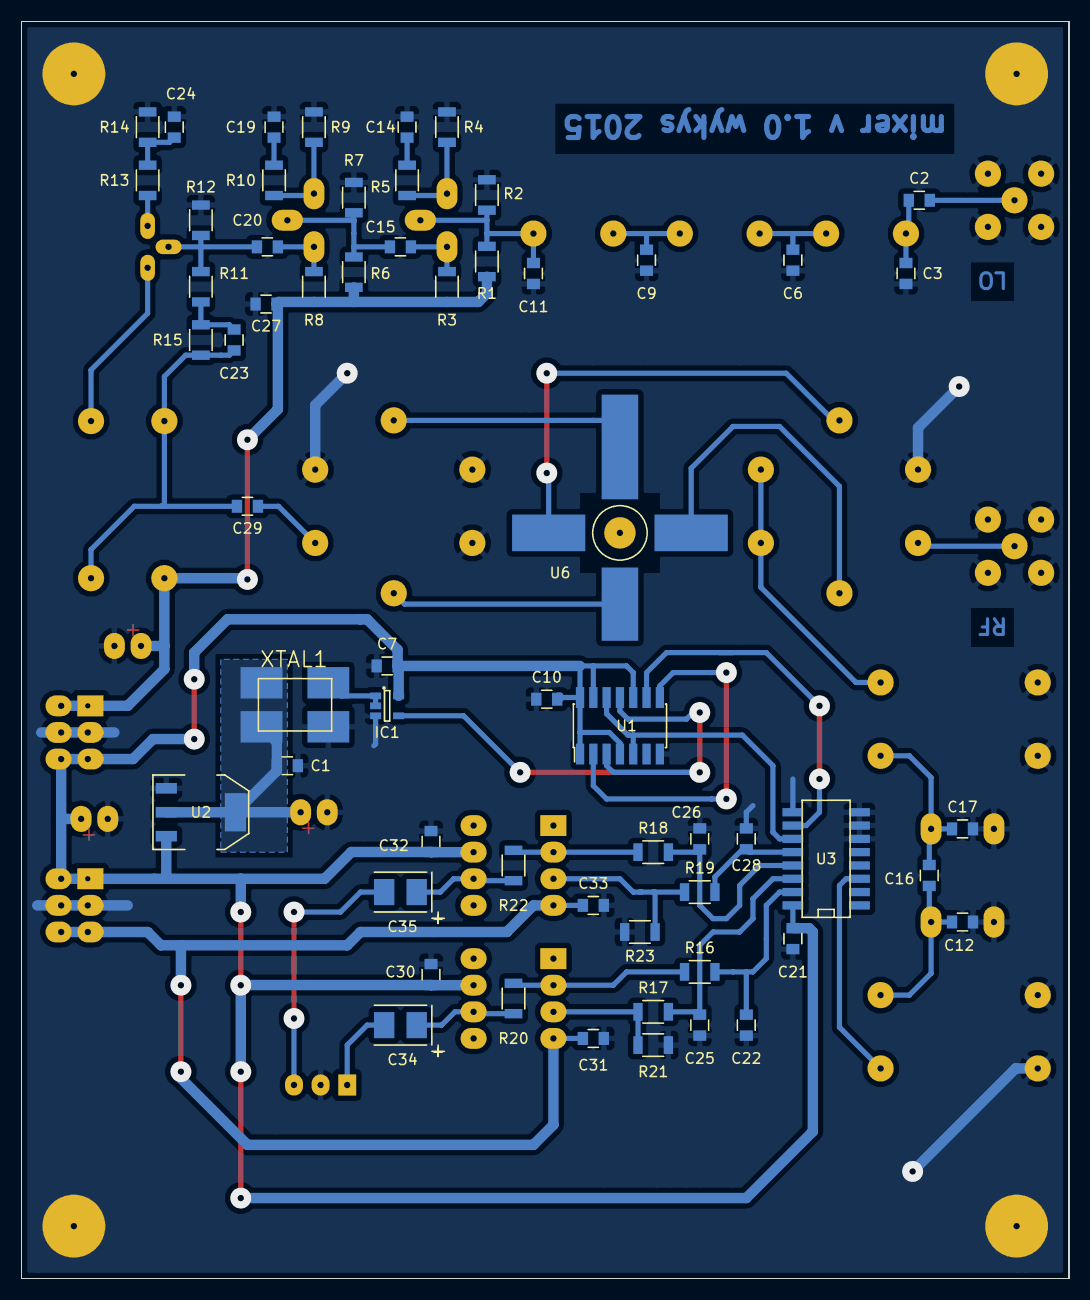
[picture p138: board mixer.kicad_pcb from below]

Board: 2 copper layers, 100.0 x 120.0 mm, 82 parts (59 on the bottom side), 50 nets.
