mfkiwl/SDR_SOC_doc/sdr/LNA/design_v1/LNA.kicad_pcb

## KiCad design sdr/LNA/design_v1/LNA.kicad_pcb (2016-03-18)

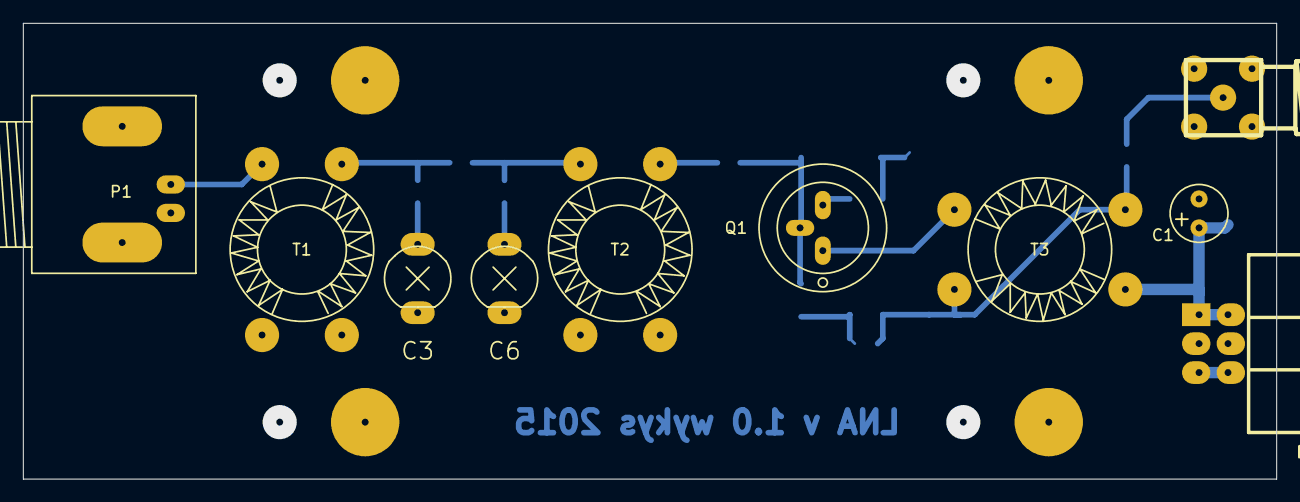
[picture p139: board LNA.kicad_pcb from above]

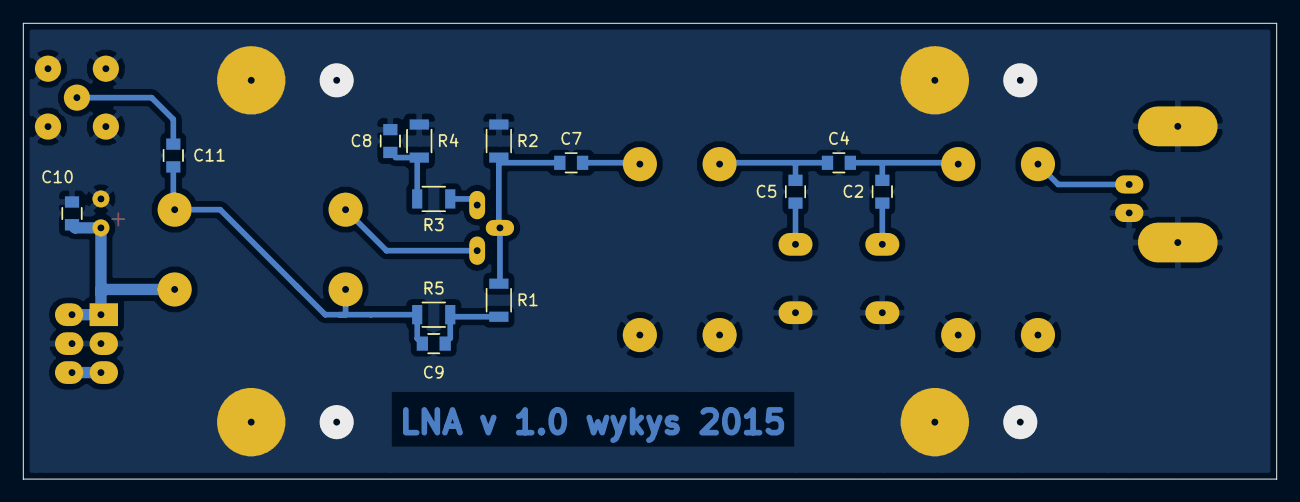
[picture p140: board LNA.kicad_pcb from below]

Board: 2 copper layers, 110.0 x 40.0 mm, 23 parts (13 on the bottom side), 16 nets.

Parts:
C1: 10u/50v; Elko_vert_11x5mm_RM2.5
C2, C5: 100p; C_0805
C3, C6: 6-50p; CT-6-50p
C4: 4p7; C_0805
C7, C8, C9, C10, C11: 100n; C_0805
P1: ANT; BNC_Socket_TYCO-AMP_LargePads
P2: MLW6; vasch_strip_3x2_90
P3: LNA_OUT; sma_90_r300.124.403
Q1: KF630D; OldSowjetaera_Transistor_Type-II_BigPads
R1: 560R; R_1206
R2: 500R; R_1206
R3: 4R7; R_1206
R4: 12R; R_1206
R5: 3k3; R_1206
T1, T2: TRXTOY; Transformer_Toroid_horizontal_Diameter12-5mm_Amidon-T44
T3: TR11; Transformer_Toroid_horizontal_Diameter12-5mm_Amidon-T44

Connections:
+5V: P2.5, P2.6
+12V: C1.1, C10.2, P2.1, P2.2, T3.4
GND: C1.2, C3.2, C6.2, C8.1, C10.1, P1.2, P2.3, P2.4, P3.2, R2.2, R4.2, T1.2, T1.4, T2.2, T2.4
unnamed: C2.1, C4.2, T1.1
unnamed: C2.2, C3.1
unnamed: C4.1, C5.1, T2.1
unnamed: C5.2, C6.1
unnamed: C7.1, Q1.2, R1.2, R2.1
unnamed: C7.2, T2.3
unnamed: C8.2, R3.2, R4.1
unnamed: C9.2, R1.1, R5.2
unnamed: C11.1, P3.1
unnamed: C9.1, C11.2, R5.1, T3.2, T3.3
unnamed: P1.1, T1.3
unnamed: Q1.1, T3.1
unnamed: Q1.3, R3.1
